MajorLee95/tinyelab/README.rst

++++++++++++++++++++++++++++++++++++++++++++++++++++++++++++++++++++++++++++++++++++++++++++++++++++
Tiny E-LAB
++++++++++++++++++++++++++++++++++++++++++++++++++++++++++++++++++++++++++++++++++++++++++++++++++++

:Auteur:               Le VoLab : MajorLee
:Site_Web:             http://www.vorobotics.com/
:Projet:               Tiny e-LAB my contrib.
:Version:              2022
:documentation:        https://majorlee95.github.io/tinyelab
:Licence:              CC0 4.0
:Liens:                https://creativecommons.org/licenses

Ce projet est ma contribution au `Projet Tiny e-lab de MarcLuer sur Thyngiverse`_

Pour plus d'informations suivre le liens documantation ci-dessus !!!!!

.. _`Projet Tiny e-lab de MarcLuer sur Thyngiverse`: https://www.thingiverse.com/thing:2999383
