MajorLee95/tinyelab/_01-docs/source/avancement.rst

++++++++++++++++++++++++++++++++++++++++++++++++++++++++++++++++++++++++++++++++++++++++++++++++++++
Avancement
++++++++++++++++++++++++++++++++++++++++++++++++++++++++++++++++++++++++++++++++++++++++++++++++++++

.. include:: volabid.rst

:Date de création: 03/2022
:Date dernière maj: voir github

====================================================================================================
Journal
====================================================================================================
09/03/24::

    Reprise module USB QC3.0 simple un USB un inter
    Déjà quelques chose dans ``mesCreations\moduleUSB5V2ASimple2voies``

.. _refAvancementGeneral:

====================================================================================================
A faire : de manière général
====================================================================================================
Ajouter des liens vers les sources
----------------------------------------------------------------------------------------------------
Dans la partie rendu Freecad mettre un lien vers les sources avec un peu d'explications comme les 
dépendances:

- modulePrimaireTensionCourant
- moduleAlimStabiliseeDPS3005
- moduleAlimentationParkSide
- moduleUSB3A2voies
- moduleOscilloDSO138
- moduleVentilo
- moduleTripleTinyVoltmetres
- moduleVoltAmperemetre

Mettre les modules sous Thinkiverse
----------------------------------------------------------------------------------------------------
- base 35mm
    - renseigner le lien dans la doc
- UI primaire
    - renseigner le lien dans la doc
- USB
    - renseigner le lien dans la doc
- DPS3005
    - renseigner le lien dans la doc
- Oscillo
    - renseigner le lien dans la doc
- VA
    - renseigner le lien dans la doc
- XT60 cover
    - renseigner le lien dans la doc

schéma de câblage des modules
----------------------------------------------------------------------------------------------------
    - Alim DPS3005

XT60 : boîtier ou capot de prise XT60
----------------------------------------------------------------------------------------------------
- dessin 3D avec vis pointeau **OK**
- rien de probant sur le net **OK**
- prévoir 2 guides fils **OK**
- imprimer femelle v006 paramétrée
    - tester

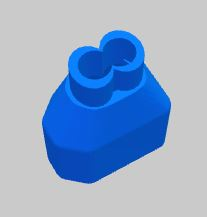
[picture p39: _01-docs/source/images/xt60caseGuides.jpg]


outillage switch
----------------------------------------------------------------------------------------------------
- documenter !

Concept du tiroir
----------------------------------------------------------------------------------------------------
- rangement sonde/fils
    -  principe du petit tiroir basculant ou pas **à conceptualiser**

====================================================================================================
A finir modules
====================================================================================================
- Ajout parkside et USB3A au chapitre modules terminés avec photos

Module oscilo
----------------------------------------------------------------------------------------------------
- photo **OK**
- schéma **OK**
- IR : images non retrouvées le 2/7/22, elles ne sont pas dans la caméra 16/7/22 **ABANDON**
- Design capo avec boutons **en cours 23/11/22**

Module voltmètre / ampèremètre 
----------------------------------------------------------------------------------------------------
- test électrique
     - à compléter en ampèremètre (peu précis dans les faibles courants)
- nomenclatures  **OK**
- photo **OK**

====================================================================================================
A faire modules
====================================================================================================
Support fer à souder
----------------------------------------------------------------------------------------------------
Tout est à faire

Des idées: `Tiny E-lab Ts100 alternate stand by erreib on Thingiverse`_

Trop volumineux, interrupteur inutile (le TS-100 à le sien)

Il faudrait une protetion complète de la panne !

.. _`Tiny E-lab Ts100 alternate stand by erreib on Thingiverse` : https://www.thingiverse.com/thing:5216290

Le module ventilation faire à souder
----------------------------------------------------------------------------------------------------
Simplifier le module (après retour d'expérience)

    - supprimer la charnière le ventilateur à la vertical suffit amplement.
    - supprimer les variateurs (éclairage à fond et ventilation à fond toujours...)
    - incliner l'éclairage vers l'avant (actuellmement, il éclaire les boutons)

USB double mais plus simple
----------------------------------------------------------------------------------------------------
- étude du concept sous Freecad **OK**
    - ``_03-cao_3D\mesCreations\moduleUSBsimpleDouble`` **OK**

- trouver un buck qui tienne la charge et les 24V ! **OK**

Peut-être trouvé chez aliExpres... oui et testé, y a plus qu'à !

Finalement, je pars sur un USB simple dans un premier temps pour mettre de chaque côté du module 
ventilo pour éclairer la soudure

Module USB-C fast charge
----------------------------------------------------------------------------------------------------
- tout est à faire

Module alim 24V/10A
----------------------------------------------------------------------------------------------------
- faire cable 220V
- faire cable XT60
- En profiter pour cable rallonge XT60 **OK**
    - avec gros fil dans le tiroir **OK**
- Ne vaut-il pas mieux un module complet à cause de l'arrivée 220V ? Si

.. WARNING:: Utilité de ce module ?
    :class: without-title

    Je me pose réellement la question de l'utilité de ce module à cause de son encombrement. 
    Le besoin d'une alimentation 24v n'est pas démontré.

module ampèremètre seul 0/3A
----------------------------------------------------------------------------------------------------
- trouver la bête **OK**
- commande AMAZON à aiguille **OK**
- Design 3D
    - trouver ou faire le modele
    - Tout

Module LCR mètre
----------------------------------------------------------------------------------------------------
- tout
- Est-ce que cel permet de tester les LED ? OUI
- LCR-T4 https://www.amazon.fr/gp/product/B0798JNLCJ/ref=sw_img_1?smid=A1NBUX8FDB1DWX&psc=1
- 

Module 3.3, 5 et +12-12, + alim variable low cost (regroupement)
----------------------------------------------------------------------------------------------------
Alim fixe avec les 3 alimentations principales
A faire avec fusible réarmables.
Discutabele pour le 5 et le 3.3v vu que les carte de breadboard l'on, ne reste plus que le +/-15V

- Module alim low cost : sur la base d'un DC/DC XL4605 avec poter multi-tours déporté

Quelle connectique ? Les connectique façon HP ne conviennent pas pour l'alim symétrique et risquent
de prendre pas mal de place.

Module Générateur de fonction
----------------------------------------------------------------------------------------------------
- appro
    - AD9833 breakout board AMAZON **OK**
    - Encodeur rotatif (au lab) cdé le 21/4 **OK**
    - NANO **OK**
    - Ecran I2C **OK**
    - Alimentation symétrique +10V/-10V cdé le 21/4 **OK**
    - Ampli op de sortie cdé le 21/4 **OK**
- Maquettage **OK**
- Design ARDUINO
    - original Instructables
        - DL code **OK**
        - Etude code **OK**
- refonte du code **DELAYED**
    - Trop de boulot peut-être pour une version ultérieure
- 3D retouche BNC emprunte v008 **OK**
- Design 3D
    - Tout

Voltmètre avec masse flottante
----------------------------------------------------------------------------------------------------
- tout
- Quoique en repartant de tiny voltmètre avec 3 DC/DC isolés

Module Horloge et musique
----------------------------------------------------------------------------------------------------
A faire.

Horloge ok mais musique ? quoi ?

Module batterie lidl ET prise PC multiples avec commute auto **UTILITE ?**
----------------------------------------------------------------------------------------------------
Tout est dans le titre

Étagère system
----------------------------------------------------------------------------------------------------
- tout

Dévidoir de fil
----------------------------------------------------------------------------------------------------
- tout
- Modéliser les bobines
    - diam 55mm, large 21mm, moyeu diam 25mm, Flan 1.5mm
    - 6 couleurs
    - AWG 24

6 couleurs

Module fer à souder
----------------------------------------------------------------------------------------------------
- tout : présente peu d'intérêt avec le fer TS100 un simple cable de bout de chaîne pourrait suffire !

Non à l'usage (cendrier) un vrai support serait mieux

Module renvoi d'angle
----------------------------------------------------------------------------------------------------
En accordéon réglable.

====================================================================================================
Fait (pour mémoire)
====================================================================================================

Mettre projet sous Volab/wiki et sous github
----------------------------------------------------------------------------------------------------
- créer git local **OK**
    - Arrêt du versionning par les noms de fichiers ou pas tout à fait **OK**
- créer projet github **OK**
- lier projet Github et git local (git ls-remote) **OK**
- pusher le projet **OK**

- créer github io **OK**
- pusher la doc sur githubio **OK**
- créer un readme.rst au niveau projet **OK**
- créer le projet dans le Wiki du lab **OK**
- Renseigner le projet dans le wiki du lab **OK**
- Créer une vignette projet dans le Wiki **OK**
- peut-être compléter la description **OK**

Appro 
----------------------------------------------------------------------------------------------------
- alim 24V/10A commandée AMAZON le 4/4/22 24€ **OK**
- approvisionner tige laiton 3mm voire 2.5mm **OK**

BASE reprise v007.3
----------------------------------------------------------------------------------------------------
- Reprendre le profile XT60 **OK**
    - vérifier les jeux -pas de jeu -ajout jeu vertical 0.5 **OK**
    - diminuer la largeur 8 vs 8.4 **OK**
    - augmenter la hauteur d'au moins 0.6 (affaissement des couches) xtJeu .6  **OK** 
- Etude solution câblage
    - longueur tige laiton à déterminer pour chaque largeur de module : Calculer **OK**
        - reprendre la longueur pour qu'elles aillent jusqu'au fond des broches des XT **OK**
        - Tester => retouche tige v007.3  **OK**
            - Tige 3mm ne rentre pas dans certaines XT60 !!!! **OK**
    - passer les fils : le pb ne se pose que pour le 35mm **ABANDONNE**
    - souder en extérieur **ABANDONNE**

BASE V008.1
----------------------------------------------------------------------------------------------------
Passage des vis FAV en M3x6 ald M3x10 v008.1 **OK**

BASE v012
----------------------------------------------------------------------------------------------------
- retirer un peu de matière de part et d'autre de la lèvre **OK**
    - A terminer v010 **OK**
- positionnement XT et insert de gauche auto en fonction de largeurmodule **OK** v12

module 2x USB 3A
----------------------------------------------------------------------------------------------------
- module 2x USB 3A **OK**
    - design FreeCAD rev 4 sur base 006.4  **OK**
    - export STL **OK**
    - préparation GCODE **OK**
        - Fav **OK**
        - Base **OK**
    - impression **OK**
        - Fav **OK**
        - Base **OK**
    - câblage Légèrement difficile **OK**
    - test attention à la polarité **OK**

module Ui
----------------------------------------------------------------------------------------------------
- module Ui
    - design FreeCAD v009 sur base 006.4 **OK**
    - export STL **OK**
    - préparation GCODE **OK**
        - Fav 4h40 **OK**
        - Base 8h12 **OK**
    - impression
        - Fav **OK**
        - Base **OK**
    - câblage très difficile  **OK**
    - test **OK**
    - reprendre alors avec la base 007.5 **OK**
    - reprendre la face avant pour le module écran élargir le trou **OK**
    - Tester ? **NON**

- ré-imprimer la nouvelle face avant v012 **ABORTED**
    - stl **OK**
    - g-code **OK**
    - imprimer **OK**
- tester mécaniquement **ECHEC et ABANDON**
- collage du module **OK**

Module alim DPS3005
----------------------------------------------------------------------------------------------------
- module Alimentation DPS3005 (30V 5A) **OK**
    - design FreeCAD **OK**
        - 3D du module DPS30005 **OK**
            - design **OK**
            - Vérifier dimensions **OK**
        - 3D embase banane **OK**
            - Récup GRABCAD **OK**
                - Vérifier dimensions **OK**
        - 3B connecteur audio **OK**
            - recup **OK**
            - vérifier dim **OK**
        - Reprendre avec la base v007.dernière **OK**
        - Finir la FAV **OK**
    - export STL **OK**
    - préparation GCODE **OK**
        - Fav **OK**
        - Base **OK**
    - impression
        - Fav **OK**
        - Base **OK**
    - câblage **OK**
    - test **OK**

- faire une jolie photo module seule en box photo **OK**
- l'intégrée dans la doc **OK**

Module oscilo
----------------------------------------------------------------------------------------------------
- module oscillo
    - design FreeCAD v003 sur base 006.4  **OK**
    - Reprendre la base v007.dernière  **OK**
    - ajouter BNC **OK**
        - code RS 680-7371 **OK**
    - ajouter module alimentation **OK**
        - modéliser module alimentation **OK**
        - Attention vis Nylon **OK**
    - test hors boîtier (caractériser l'alimentation) **OK**
    - export STL **OK**
    - préparation GCODE **OK**
        - Fav **OK**
        - Base 150mm **OK**
    - impression **OK**
        - Fav **OK**
        - Base **OK**
        - Test mécanique **KO**
            - reprendre l'emprunte de la BNC 3.85 vers 3.35 **OK**
            - aapliqué aussi à BNC_002 **OK**
    - câblage **OK**
    - régler le module DCDC **OK**
    - test électrique **OK**
    - module oscillo
        - ré-imprimer la FAV
            - re-stl **OK**
            - re-gcode **OK**
            - re-imprimer **OK**
        - tester montage mécanique BNC **OK**

Outillage pour la soudure des XT60
----------------------------------------------------------------------------------------------------
- design 3D **OK**
    - retoucher les dimension du reglet celui de 20CM large **OK**
- export STL **OK**
- préparation GCODE **OK**
- impression **OK**
- test **OK**
    - retoucher l'épaisseur du réglet dans la speadsheet v013 **OK**
    - Ajouter des pieds en haut pour basculer pendant la soudure v014 **OK**

- Ré-imprimer v2_014
    - sortir STL **OK**
    - préparer GCODE **OK**
- re-tester la nouvelle version **OK**

module triple tiny Voltmètre
----------------------------------------------------------------------------------------------------
- design 3D **OK**
    - model volmetre sur GRABCAD **KO**
        - mini-dc-voltmeter-1.snapshot.5.zip : entraxe incorecte **KO**
        - dc-0-30v-voltmeter-panel-mount-1.snapshot.3.zip **KO**
        - led-dc-digital-voltmeter-5v-display-green-1.snapshot.5 **OK**

- export STL **OK**
- préparation GCODE **OK**
   - Fav **OK**
   - Base 90mm **OK**
- impression **OK**
   - Fav **OK**
   - Base **OK**
   - teste mécanique **OK**
- câblage
    - couper barres laiton 73.62mm (vérifié le 24/4) **OK**

- test électrique+ réglage **OK**
- explications **OK**
- photo **OK**
- nomenclatures **OK**
- schéma **OK**

Module voltmère / ampéremètre 
----------------------------------------------------------------------------------------------------
- modélisation 3D **OK**
    - réutiliser connecteurs AUDIO **OK**
    - rechercher model 3D du module utilisé **OK**
        - vérifier les dimensions **OK**
            - en déduire taille trou **OK**
        - intégrer step dans un fichier Freecad avec spreadsheet **OK**
    - 4 fiches bananes **OK**
- Rechercher schéma de câblage version 3 gros fils, sérigraphié **OK**
    - rouge VI, verts I+,  Noir COM **OK**
    - finir svg de câblage **OK**

- export STL **OK**
- préparation GCODE **OK**
   - Fav **OK**
   - Base 95mm **OK**
- impression **OK**
   - Fav **OK**
   - Base **OK**
   - teste mécanique **OK**
- câblage **OK**
    - couper barres laiton 78.62mm **OK**

- test électrique
     - à compléter en ampèremètre (peu précis dans les faibles courants)
- nomenclatures 

- schéma **OK**
- photo **OK**
    - une incluse **OK**

outillage switch
----------------------------------------------------------------------------------------------------
- imprimer **OK**
    - gcode **OK**
- test méca **KO**
    - trop long, raccourcir de 1 mm, modif chanfrein 4x2 vers 5x1 v004
- ré-imprimer v0004
    - stl **OK**
    - gcode **OK**
    - imprimer **OK**
- re-tester **OK**

Module ventilation
----------------------------------------------------------------------------------------------------
- model ventilo **OK**
    - Vérifier les dimension **OK**

- design 3D **OK**
        - Essais avec les aimant en long **ABORTED**
            - nouvelle branche **aimantsEnLong**
            - dessiner **OK**		

    - Inclinateur à base de verrou élastique => version 029 **OK**
        - dessiner : nouvelle branche git : **ventiloSystemInclinaison**
            - sur le côté droit du module. **OK**
            - sur la partie fixe une languette en arc de cercle de 1 mm d'épaisseur **OK**
            - languette rapporté pour simplifier l'impression **OK**
            - sur la partie mobile : des crans (trous cylindriques) **OK**
            - impression languette, poignee **OK**
                - stl, gcode **OK**
                - impression **OK**
            - impression partie fixe tronquee **OK**
                - export step, tronquage, export stl, gcode **OK**
                - impression **OK**
            - impression partie fixe tronquee **OK**
                - export step, tronquage, export stl, gcode **OK**
                - impression **OK**
            - test **A REVOIR**
                - ménager un jeu d'épaisseur d'environ 1mm dans 
                  la partie plane de la partie fixe plutot mobile à cause de l'emprunte languette **OK**
                - finir design partie fixe potar avec inter, **OK**
                    - récupérer potar  avec inter (encombrement)  le switch n'est pas cliquable **ABANDON**
                        - sous Grabcad **OK**
                        - Vérifier dimensions **ABANDON**
                        - appro (amazon) **OK**
                - trous passage des fils ventilo et casquette **OK**
                    - fixe **OK**
                    - mobile **OK**
                - trous switch désépaissir **OK**
                - pb casquette paroi LED comment on vis ? des gros trous pour les tête de vis **OK**

    - fixation du Digispark un cube et de la colle **OK**
        - model sous Grabcad ? **OK**
        - conversion vers Freecad **OK**
        - intégration **OK**
            - design support **OK**
    - design support DCDC et testé **OK**

    - procéder alors à une impression complète **OK**
        - partie fixe **OK**
            - export stl, gcode **OK**
            - impression **OK**
        - partie mobile **OK**
            - export stl, gcode **OK**
            - impression **OK**
        - casquette **OK**
            - export stl, gcode **OK**
            - impression **OK**
    - réduire le jeu longitudinal de la charnière actuel mesuré 1.88mm **OK**
    - reprendre au propre **OK**
        - trou passage du fil LED (faire un trou carré au rectangle) **OK**
        - suppression 1mm base partie mobile. **OK**
        - reprendre le modèle potar avec inter **ABANDON**
        - faire trous pour potar et inter **OK**
            - vérifier la designation des petits inter **OK**
                - plus le sachet **OK**
                - sur le site amazon : il y a effectivement erreur sur le produit **OK** 
                - dessus : KCD1-11 (quand on cherche sur AMAZON on tombe sur les bonnes dimensions) **OK**
        - paroi casquette led : ep 1mm hauteur 18mm **OK**
        - ne pas oublier le trous des fils ventilo/led dans la partie fixe **OK**

- Électronique **OK**
    - Pilotage ventilo et LED : LM2596S limité à 12V cf :ref:`pilotage LEDs et ventilo<pilotageLedVentilo>`
        - Test réalisé **OK** 
        - implémenter les 2 voies LED et ventilo **OK**
        - vérifier le numéro du canal pwm pas de diff, analogRead **OK**
        - programmer le composant **OK**
        - Tester les 2 voies **OK**

- imprimer base **OK**
    - exports, prepa **OK**
    - impression **OK**
- imprimer fav **OK**
    - exports, prepa **OK**
    - impression **OK**

- casquette : ajouter trous cables LED **OK** v0.35

- câbler
    - faire plaque à LED **OK**
    - Programmer Digispark **OK**
    
- tester **OK**

- nomenclature **OK**
- saisir schéma de câblage **Ok**

Module primaire prises PC multiples **aborted**
----------------------------------------------------------------------------------------------------
- recherche des standard de prises **OK**
- appro des embase correspondantes **OK**
- test des embase en question avant design

- Design du module

Module batterie Lidl
----------------------------------------------------------------------------------------------------
- Modéliser le haut de la batterie pas vraiment utile **OK**
- modéliser le module **OK**
- stl, gcode FAV et base et adaptateur **OK**
- imprimer **OK**
    - adapt **OK**
    - fav **OK**
    - base **OK**
- câbler **OK**
- tester **OK**
- voir la version avec inter et porte fuse : est-elle utile ? **A voir beaucoup plus tard**
- documenter **OK**
    - photo **OK**
    - screenshot (rendu Freecad) **OK**
    - nomenclature **OK**

module USB 2x 3A Refait
----------------------------------------------------------------------------------------------------
- trouver un convertisseur qui tienne 24V **ET** 3A **OK**
    - le tester avant de l'intégrer **OK**
    - `TECNOIOT 5pcs 5A XL4015 DC-DC Step Down Adjustable Power Supply Module LED Lithium Charger`_
    - également : `TECNOIOT 5pcs 5A Max XL4015 DC to DC CC CV Step-Down`_ avec limiteur de courant
        - évaluer
        - rentre difficilement (par de trous de fixation)
  
Full doc: `DC to DC Converter with Constant Current (CC) and Constant Voltage (CV) Control - Schematics, PCB, Parts List, and Working`_
        
- attention le ventilo ne passe pas ! SI **OK**           

- alimentation ventilateur et ARDUINO **OK**
    - design et maquettage **OK**
    - saisir schéma KiCAD **OK**
    - récupérer un potentiomètre multi tours 10k ou un simple de pcb, j'en ai plein ! **OK**
- pcb support arduino, INA, OLED et alim
    - plaquette à trou découper **OK**
    - câbler **OK**
    - tester avant intégration
    - prévoir trous de fixation **OK**
    - Prévoir dissipateur 7805 **OK**

- ampèremètre **OK**
    - en trouver un petit **KO**
    - ou le faire
        - définir l'électronique INA219 **OK**
        - maquetter **OK**
        - tester **OK**
        - intégrer **OK**

- design3D
    - modèles 3D
        - Vérifier les dimensions et au passage préparer la spreadsheet **OK**
            - XL4015, modèle retouché **OK**
            - ventilo 40mm **OK**
            - connectique USB **OK**
            - INA219 **OK**
    - éprouver emprunte DC/DC **OK**
    - trous de fixation du pcb **OK**
    - faire une découpe broche oled dans la fav **OK**
    - prévoir 7805 dans le flux d'air du ventilateur **OK**
    - design cale OLED **OK**
    - Éprouver les perçages **OK**
        - Connecteurs USB **OK**
        - pcb **OK**
        - oled **OK**
    - Fav **OK**
        - trous switch **OK**
        - trous usb **OK**
        - trous écran **OK**
        - trous de ventilation dans la FAV **OK**
        - trous pcb **OK**
    - refaire les trous de ventilation dans la base dans Freecad

- préparer INA2 : changer adresse I2C **OK**
- coller et cabler les potar **OK**

- Préparer le convertiseur 2 **OK**
    - déssouder le potar **OK**
    - couper le dissipateur **OK**
    - coller les 2 moitiés de dissipateur **OK**

- imprimer **OK**
    - STL, GCODE **OK**
        - fav **OK**
        - base **OK**
    - tige laiton, couper **OK**
- câbler : cablage provisoire pour essais **OK**
- tester **OK**
- câblage définitif

- une petite face avant

.. _`TECNOIOT 5pcs 5A XL4015 DC-DC Step Down Adjustable Power Supply Module LED Lithium Charger` : https://www.amazon.fr/gp/product/B07XXFZFQJ/ref=ppx_yo_dt_b_asin_title_o04_s00?ie=UTF8&psc=1

.. _`TECNOIOT 5pcs 5A Max XL4015 DC to DC CC CV Step-Down` : https://www.amazon.fr/gp/product/B084BVKGDK/ref=ppx_yo_dt_b_asin_image_o00_s00?ie=UTF8&psc=1 

.. _`DC to DC Converter with Constant Current (CC) and Constant Voltage (CV) Control - Schematics, PCB, Parts List, and Working` : https://circuitdigest.com/electronic-circuits/diy-xl4015-dc-dc-buck-converter-module

- design3D **OK**
    - refaire les trous de ventilation dans la base dans Freecad

- une petite face avant **OK**

- nomenclature **OK**
- schéma **OK**
    - de la carte : à intégrer dans la doc **OK**
    - de câblage **OK**

- Le code ! **OK**

- la face avant **OK**

====================================================================================================
Weblinks
====================================================================================================

.. target-notes::
