MajorLee95/tinyelab/_01-docs/source/moduleAlimentationParkSide.rst

++++++++++++++++++++++++++++++++++++++++++++++++++++++++++++++++++++++++++++++++++++++++++++++++++++
Module alimentation primaire à base de batterie PARKSIDE de chez LIDL
++++++++++++++++++++++++++++++++++++++++++++++++++++++++++++++++++++++++++++++++++++++++++++++++++++

.. include:: volabid.rst

:Date de création: 10/2022
:Date dernière maj: 10/2022

.. |clearer|  raw:: html

.. index::
    pair: Modules; PARKSIDE

====================================================================================================
Les languettes
====================================================================================================
Toutes la difficulté dans cette exercice est de trouver des languettes métalliques compatibles.

Piste : Radiosspares : Feuille de métal 500mm x 300mm x 0.6mm 682-488 188€ les 10 feuilles !

====================================================================================================
Module Parkside X20
====================================================================================================
Recherche de model internet : pas grand chose d'exploitable, surtout des stl !

Mieux vaut tout re-modéliser ça n'a pas l'air très compliqué si on s'inspire du chargeur !

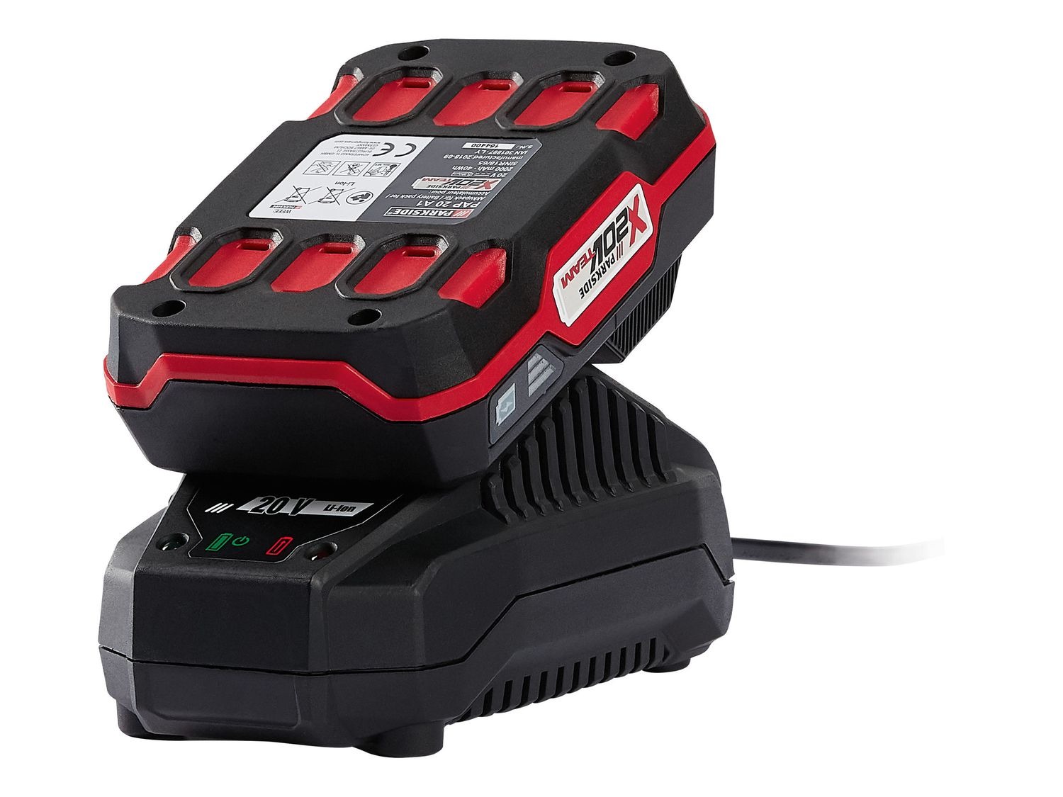
[picture p40: _01-docs/source/images/parkSideBatterieEtChargeur.jpg]


====================================================================================================
Un peu d'électronique
====================================================================================================
Le composant principal est un LGT8P30 : pas trouvé la datsheet. Et un LGT8P22 côté chargeur.

Le design a l'air très sain.







.. list-table::
   :widths: 27 27 27
   :header-rows: 1

   * - Pack vue d'ensemble
     - Un élément 2000mHA 3.6V
     - le contrôleur LGT8P30

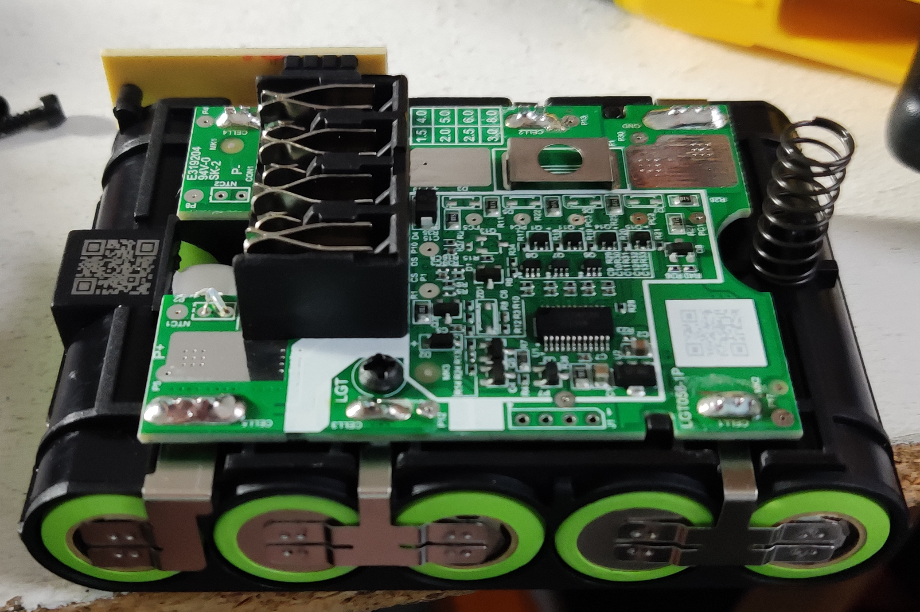
[picture p41: _01-docs/source/images/parkside/parksideInside001.jpg]
   * - 
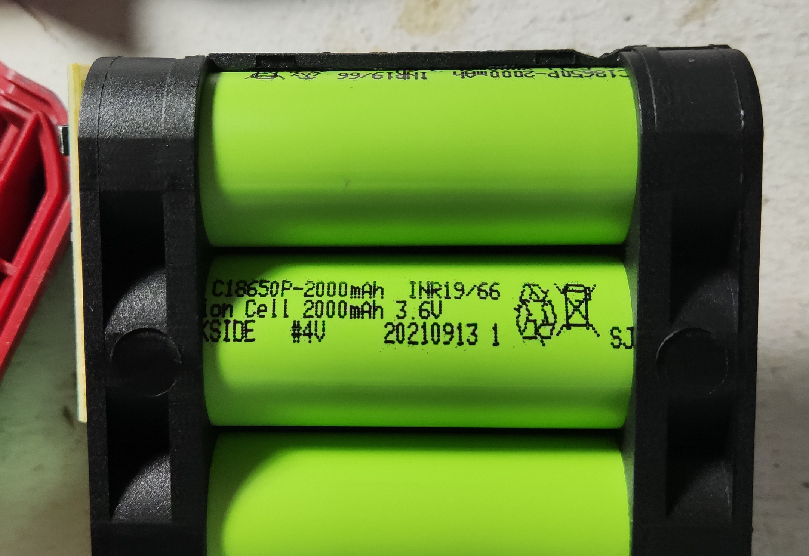
[picture p42: _01-docs/source/images/parkside/parksideInside002.jpg]
     - 
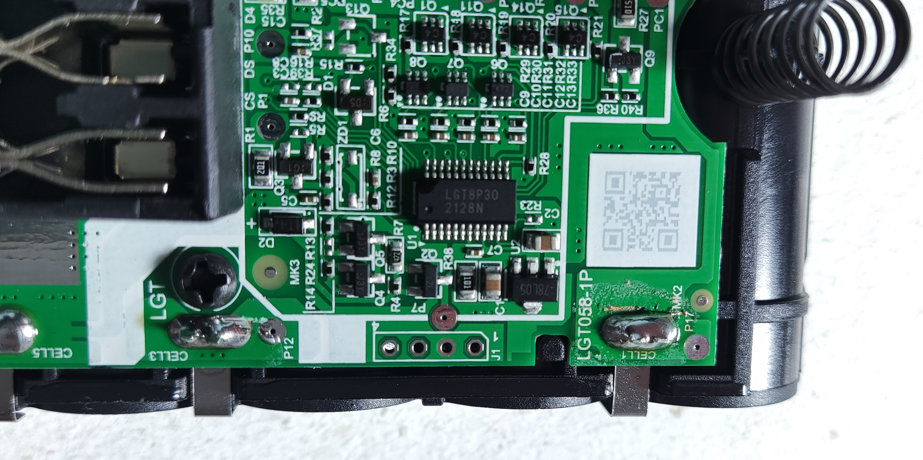
[picture p43: _01-docs/source/images/parkside/parksideInside003.jpg]
     - 

Les 5 éléments sont montés en série soir 5x3.6V = 18V de tension nominale... Pas 20V.

|clearer|





.. list-table::
   :widths: 27 27
   :header-rows: 1

   * - Chargeur côté "composant"
     - Chargeur côté "soudure" lol

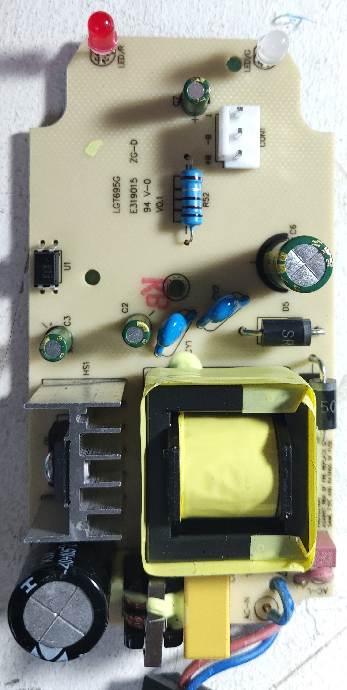
[picture p44: _01-docs/source/images/parkside/parksideInside004.jpg]
   * - 
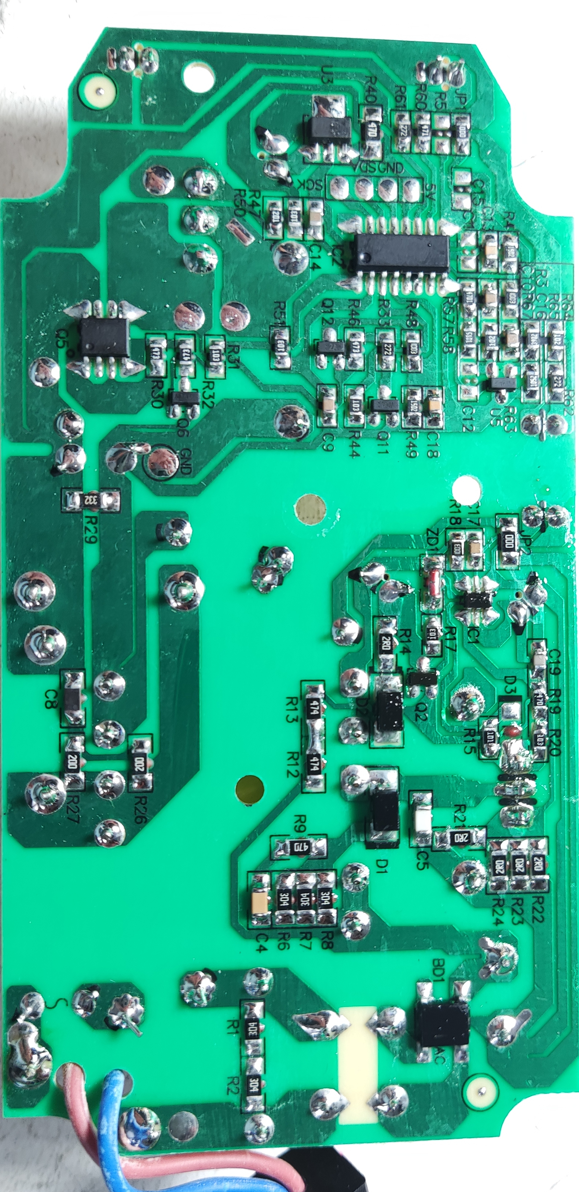
[picture p45: _01-docs/source/images/parkside/parksideInside005.jpg]
     - 

====================================================================================================
Rendu Frecad
====================================================================================================

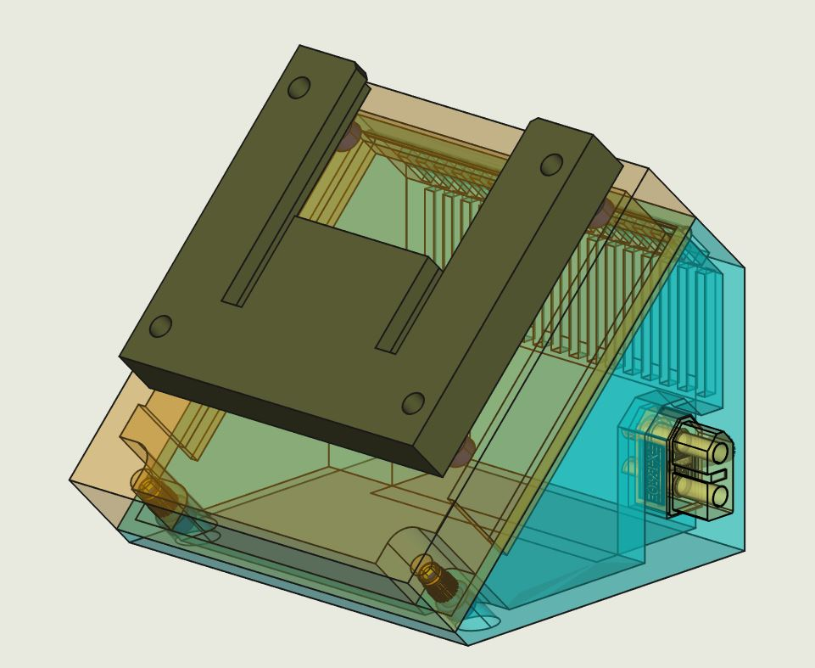
[picture p46: _01-docs/source/images/moduleParkSideFreecad.JPG]


====================================================================================================
Le câblage
====================================================================================================
Rien de très compliqué pour cette partie puisque 2 fils **souple** de forte section suffisent.

Les languettes de connecxion sont réalisées en mailleshort de 0.3mm d'épaisseur plié.









.. list-table::
   :widths: 27 27 27 27
   :header-rows: 1

   * - Essais du pack et de languettes
     - Câblage des languettes
     - Pistocolle pour solidifier le tout
     - Passage des cables

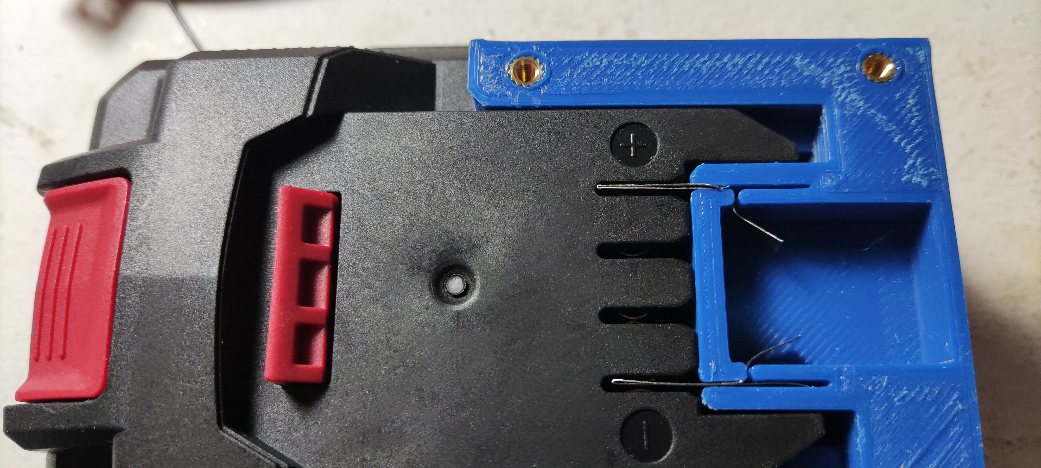
[picture p47: _01-docs/source/images/parkside/parksideInside006.jpg]
   * - 
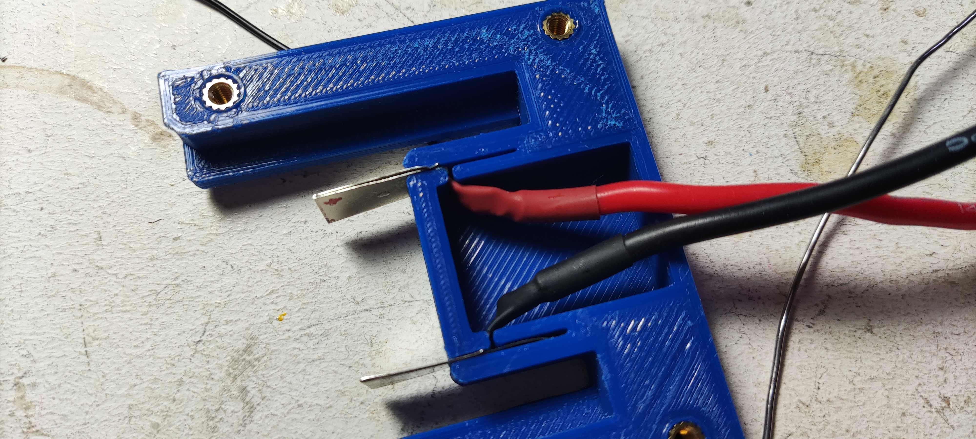
[picture p48: _01-docs/source/images/parkside/parksideInside007.jpg]
     - 
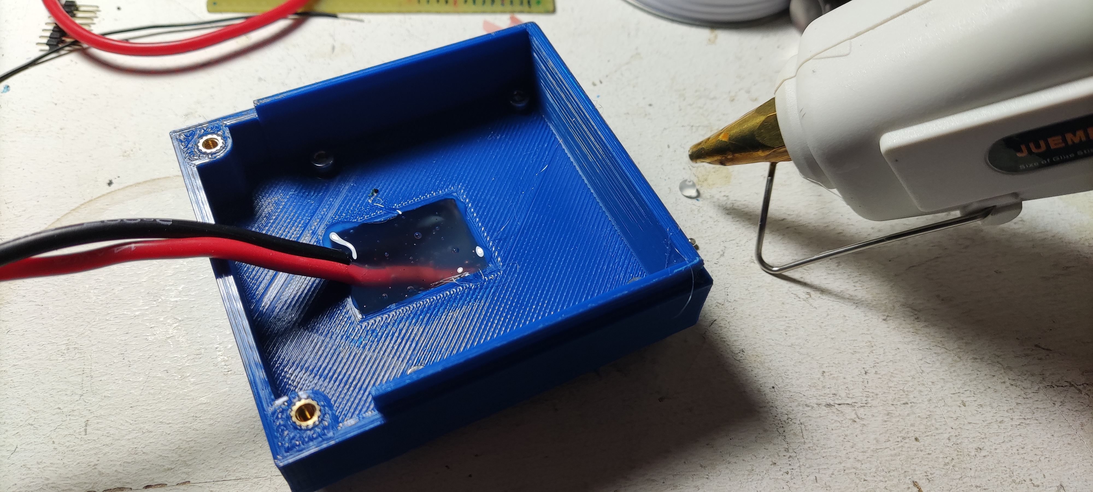
[picture p49: _01-docs/source/images/parkside/parksideInside008.jpg]
     - 
     - 

.. NOTE:: le côté gauche du boîtier n'est pas équipé du XT60 femelle.
   :class: without-title

Source mailleshort : `Plaque de maillechort format 280x200x0,40mm chez micromodel`_

56.000mm2 à 24€ soit 0.042cts le mm2 il en faut environ 8*25mm 200m2 8.4cts et biensûr x2 pour le 2 
languettes.

J'ai choisi ce matériaux pour son aspect, sa maléabilité et sa sodabilité.

Source fil de câblage : sur `AMAZON Fil de silicone de calibre 14, 5 mètres`_ pour environ 0.3€

.. _`AMAZON Fil de silicone de calibre 14, 5 mètres` : https://www.amazon.fr/gp/product/B074QR9DT9/ref=ppx_yo_dt_b_asin_title_o05_s01?ie=UTF8&psc=1

.. _`Plaque de maillechort format 280x200x0,40mm chez micromodel` : https://micro-modele.fr/fr/plaques-en-maillechort/5167-plaque-de-maillechort-format-200x100x050mm.html

====================================================================================================
En situation
====================================================================================================
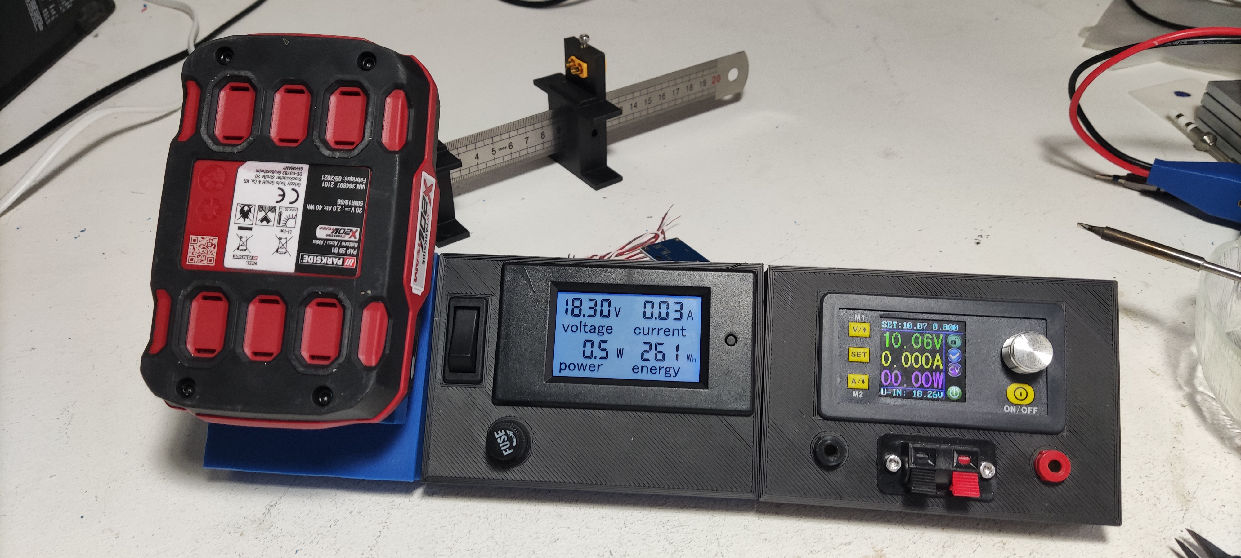
[picture p50: _01-docs/source/images/parkside/packParksideEnsituation.jpg]


====================================================================================================
Nomenclature
====================================================================================================
.. csv-table:: Nomenclature module Parkside
   :file: ../../_02-realisation/_03-cao_3D/mesCreations/lidlParckSideBat/nomParkside.csv
   :delim: ,
   :encoding: UTF-8
   :align: left

Mise à part la batterie et son chargeur 20 à 25€.

====================================================================================================
Weblinks
====================================================================================================

.. target-notes::
