MajorLee95/tinyelab/_01-docs/source/moduleOscilloDSO138.rst

++++++++++++++++++++++++++++++++++++++++++++++++++++++++++++++++++++++++++++++++++++++++++++++++++++
Module oscilloscope DSO138
++++++++++++++++++++++++++++++++++++++++++++++++++++++++++++++++++++++++++++++++++++++++++++++++++++

.. include:: volabid.rst

:Date de création: 10/2022
:Date dernière maj: 10/2022

.. _refOscilloRealisation:

.. index::
    pair: Modules; Oscilloscope

====================================================================================================
Présentation
====================================================================================================
.. WARNING:: REGLER LA TENSION DE SORTIE DU DCDC à 9V sinon ça chauffe
   :class: without-title

   ici 9V

.. _`NOUVEAU JYETech® 13805K DSO138 Mini Oscilloscope Numérique 200KHz` : https://www.banggood.com/fr/NEW-JYETech-13805K-DSO138-Mini-200KHz-Digital-Oscilloscope-SMD-Soldered-Version-DC3_5V-6V-With-Housing-p-1627586.html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

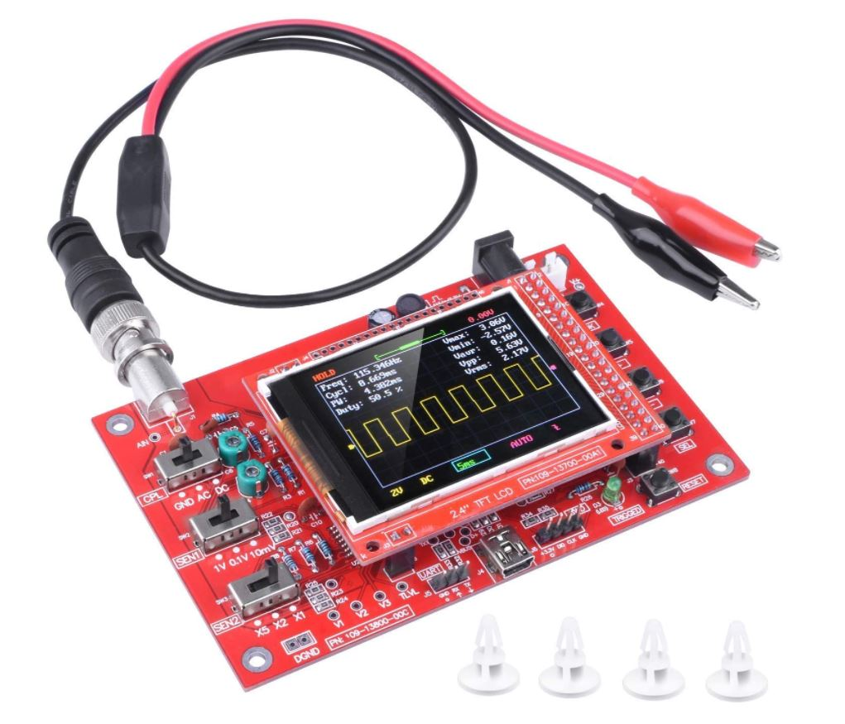
[picture p51: _01-docs/source/images/oscilloAmazon.jpg]


Sur AMAZON `ARCELI Oscilloscope numérique au Format de Poche, kit Open Source TFT 2,4 Pouces avec sonde, Version assemblée (soudé)`_ à 27€

.. _`ARCELI Oscilloscope numérique au Format de Poche, kit Open Source TFT 2,4 Pouces avec sonde, Version assemblée (soudé)` : https://www.amazon.fr/gp/product/B07V67LYXF/ref=ppx_yo_dt_b_asin_title_o01_s00?ie=UTF8&psc=1

Attention plusieurs versions différentes même sur le site JYE Tech

`NOUVEAU JYETech® 13805K DSO138 Mini Oscilloscope Numérique 200KHz`_ chez BANGGOOD (vue assemblée)

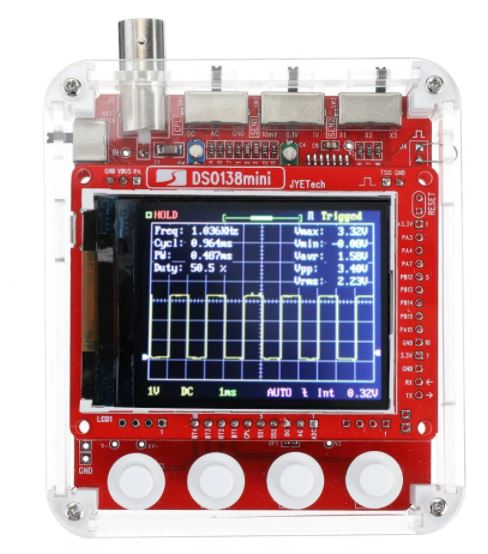
[picture p52: _01-docs/source/images/dso138mini.jpg]


Dimension: 85mm X 75mm X 15mm

La version la plus stable serait la `JYE Tech DSO138mini`_ plus compact et aussi plus cher. 
Pas trouvé assemblée sur AMAZON

.. _`JYE Tech DSO138mini` : https://jyetech.com/dso138mini-oscilloscope-diy-kit/

BNC : code RS :  680-7371, modèle directement récupérer et mis en fichier Freecad.

:download:`Drawing<fichiersJoints/bnc_drawing_0900766b80d9b202.pdf>`

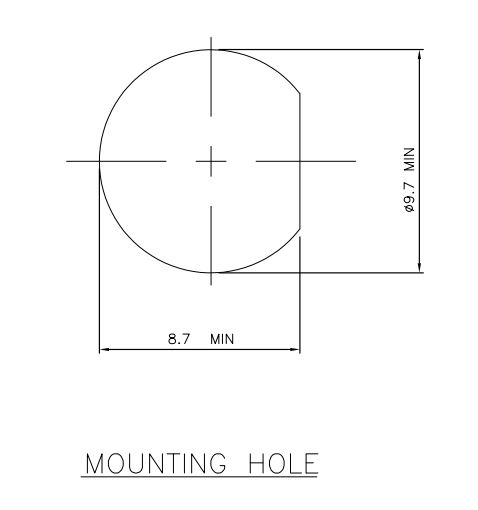
[picture p53: _01-docs/source/images/bncMountingHole.jpg]


.. WARNING:: REGLER LA TENSION DE SORTIE DU DCDC à 9V sinon ça chauffe
   :class: without-title

   Ici 9V cf. :ref:`Alimentation des modules en plus base tension<refConvertisseurDCDC>`

====================================================================================================
Oscillo schéma de câblage
====================================================================================================



====================================================================================================
Rendu FreeCad
====================================================================================================
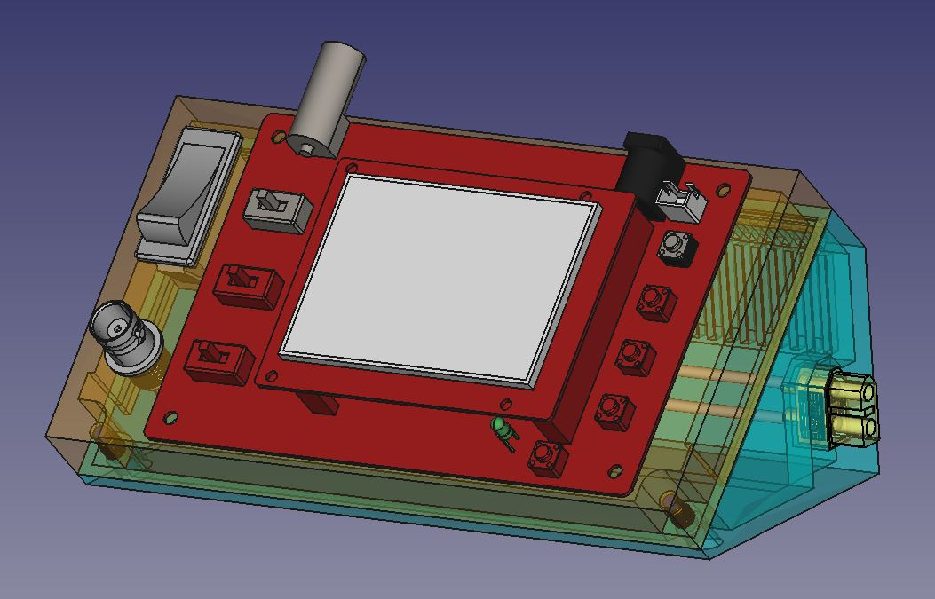
[picture p54: _01-docs/source/images/oscillo.jpg]


====================================================================================================
Oscilloscope en situation
====================================================================================================

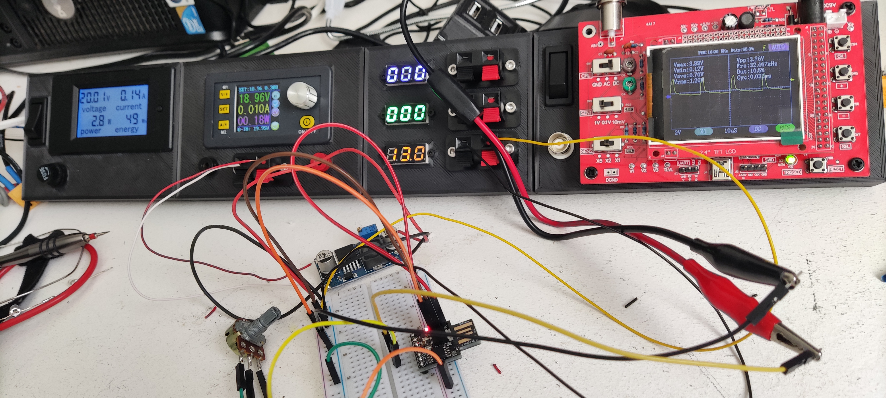
[picture p55: _01-docs/source/images/oscilloEnSituation.jpg]


Test du PWM pour le module Ventilo

====================================================================================================
Nomenclature oscillo DSO138
====================================================================================================
.. csv-table:: Nomenclature oscilloscope DSO138
   :file: ../../_02-realisation/_03-cao_3D/mesCreations/moduleOscillo/nomOscillo.csv
   :delim: ,
   :encoding: UTF-8
   :align: left
   :header-rows: 1

====================================================================================================
Weblinks
====================================================================================================

.. target-notes::
