MajorLee95/tinyelab/_01-docs/source/moduleUSB3A2voies.rst

++++++++++++++++++++++++++++++++++++++++++++++++++++++++++++++++++++++++++++++++++++++++++++++++++++
Module USB 2x 5A avec ampèremètre
++++++++++++++++++++++++++++++++++++++++++++++++++++++++++++++++++++++++++++++++++++++++++++++++++++
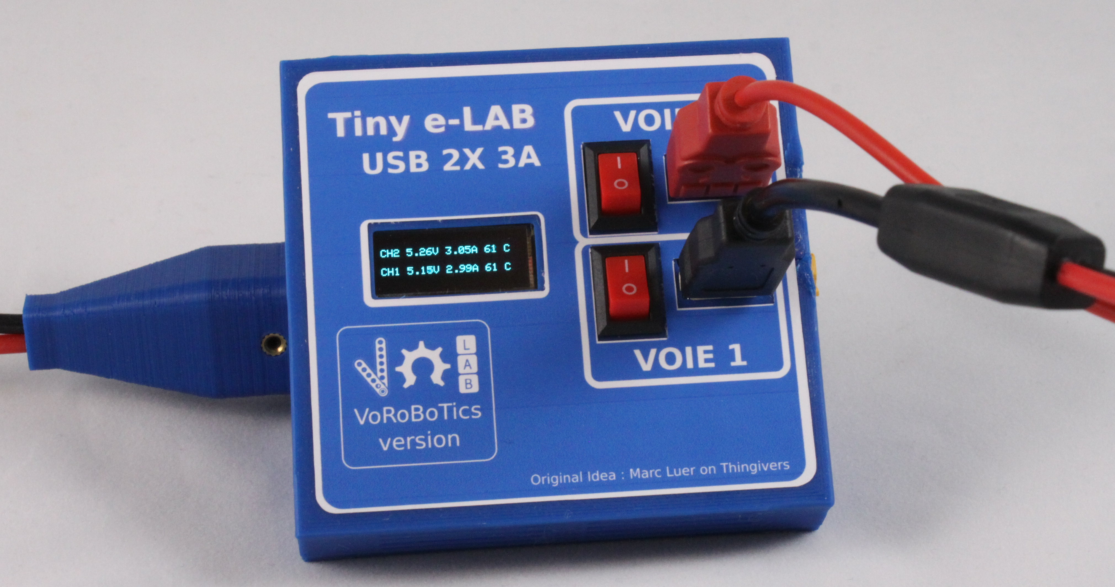
[picture p65: _01-docs/source/images/usb2x3a/moduleUSB2x3AComplet.jpg]


.. include:: volabid.rst

:Date de création: 10/2022
:Date dernière maj: 10/2022

.. |clearer|  raw:: html

====================================================================================================
Présentation/objectif
====================================================================================================
On souhaite ici un module avec 2 prise USB capable de délivrer chacune 3A pour éventuellement 
alimenter 2 Raspberry pi avec un écran qui affiche tension courant pour chaque voie.

====================================================================================================
Module XL4015 évaluation à 3A
====================================================================================================

La base est le convertisseur DCDC XL4015

`TECNOIOT 5pcs 5A XL4015 DC-DC Step Down Adjustable Power Supply Module LED Lithium Charger`_
    
.. _`TECNOIOT 5pcs 5A XL4015 DC-DC Step Down Adjustable Power Supply Module LED Lithium Charger` : https://www.amazon.fr/gp/product/B07XXFZFQJ/ref=ppx_yo_dt_b_asin_title_o04_s00?ie=UTF8&psc=1

En testant ce module en charge (avec une charge active) à 5V 3A, on s’aperçoit que ce n'est pas 
régulateur qui chauffe mais la diode et la self comme le montre les images infra-rouge.





.. list-table::
   :widths: 27 27 
   :header-rows: 1

   * - Image IR
     - Image réelle

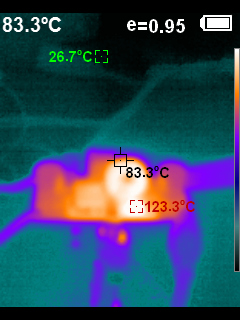
[picture p66: _01-docs/source/images/XL4015IR.jpg]
   * - 
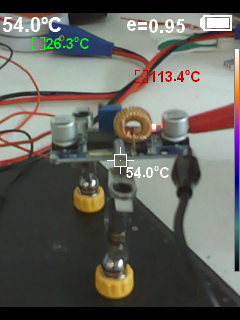
[picture p67: _01-docs/source/images/XL4015TestImageReelle.jpg]
     - 

Ces images ont été réalisées avec la `caméra infra-rouge Hti-Xintai HT18`_ sur l'image réelle la 
parallaxe des 2 objectifs fait que les température ne sont  pas aux bons endroits. C'est l'image IR
qui compte

.. _`caméra infra-rouge Hti-Xintai HT18` : https://www.amazon.fr/gp/product/B07BDJZ845/ref=ppx_yo_dt_b_asin_title_o06_s00?ie=UTF8&psc=1

Lorsque le module délivre 5V / 3A la température de la diode se situe aux environs de 120°C. C'est 
beaucoup

====================================================================================================
Design du module
====================================================================================================
Compte tenu de l'essai ci-dessus je décide d'incorporer un ventilateur de 40mm au module.

Je décide également de mettre 2 voies 5V/3A donc d'utiliser 2 convertisseurs.

De plus étant donné que cela doit pouvoir servir à alimenter un raspberry pi, il serait bien de 
disposer d'une lecture du courant. Je n'est rien trouvé de suffisamment petit.

J'envisage de réaliser le double ampèremètre grâce à:

- 2 modules INA219
- 1 ARDUINO NANO
- 1 écran `OLED I2C monocrome de 0.91" 128 x 32`_

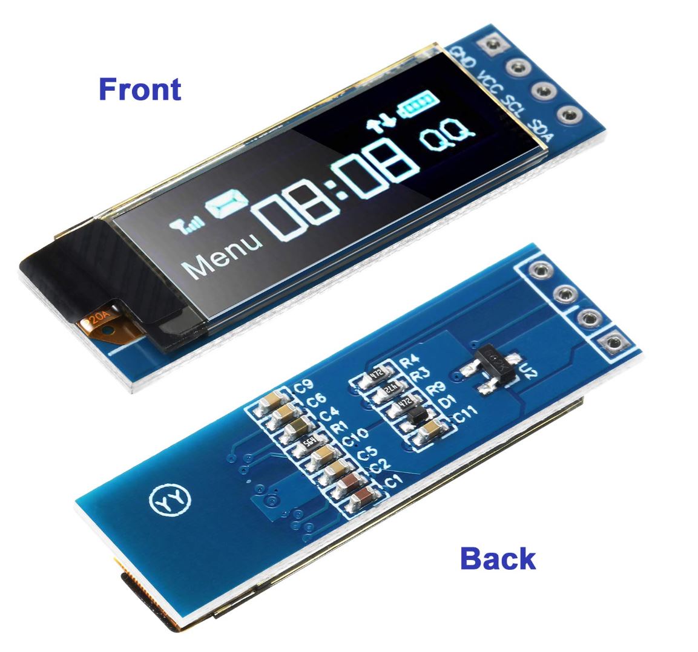
[picture p68: _01-docs/source/images/oled128x32.jpg]


.. _`OLED I2C monocrome de 0.91" 128 x 32` : https://www.amazon.fr/gp/product/B08CDN5PSJ/ref=ppx_yo_dt_b_asin_title_o01_s00?ie=UTF8&psc=1

Toutefois à 3A la chute de tension provoqué par le module INA219 et son shunt de 0.1 ohm risque 
d'être non négligeable : 0.3V. Il est possible de compenser cela en dessoudant le potar de feedback 
et en le plaçant après le shunt.

.. WARNING::

   Nouveau pb : 
   
   alimentation ventilo: en 24V, il fait énormément de bruit, je ne suis pas certain que 
   ce soit un ventilo 24V. 
   
   Il tourne bien en 5V mais le débit d'air semble un peu faible. 8, 9V
   semble un bon compromis. Sauf que je n'ai pas d'alim à cette valeur dans le module.

Conso ventilo : 24mA en 12V ventilo 1 (avec étiquette 24V), 49mA en 12V ventilo 2 origine ?

Solutions:

- un autre DC/DC XL4015 : pas la place et un peu riche pour un ventilo
- du PWM depuis l'ARDUINO : maîtrise de la vitesse et possibilité de régul en fonction de T°c
      - Echec: le ventilateur siffle (même à 32kHz en PWM) et la plage de réglage et très courte
- Mettre un simple régulateur : Lm1084 ou 7805

7805 pour alimenter l'arduino.

Conso : environ 50mA (mesuré à 25) soit à dissiper 24-5 = 19V P=UxI = 19x0.05 = 0.95W

En parcourant la datasheet du 7805, je suis tombé sur cette figure:

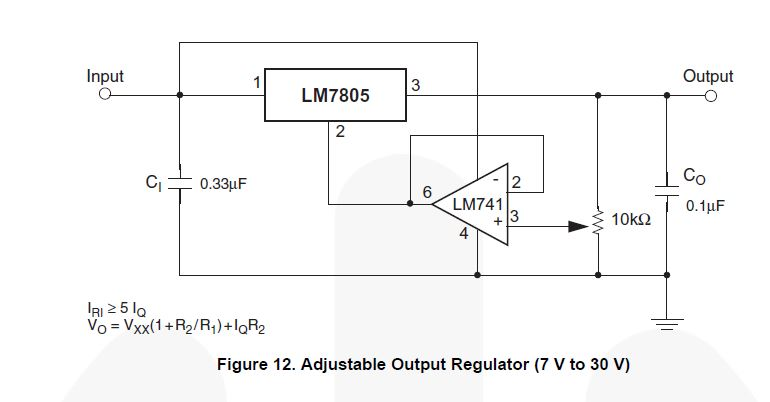
[picture p69: _01-docs/source/images/7805_high_output.JPG]


Il est donc possible à partir du 7805 de faire du 9V qui pourrait servir à alimenter le ventilo ET 
l'ARDUINO sur son  Vin.

Prise USB utilisées
----------------------------------------------------------------------------------------------------
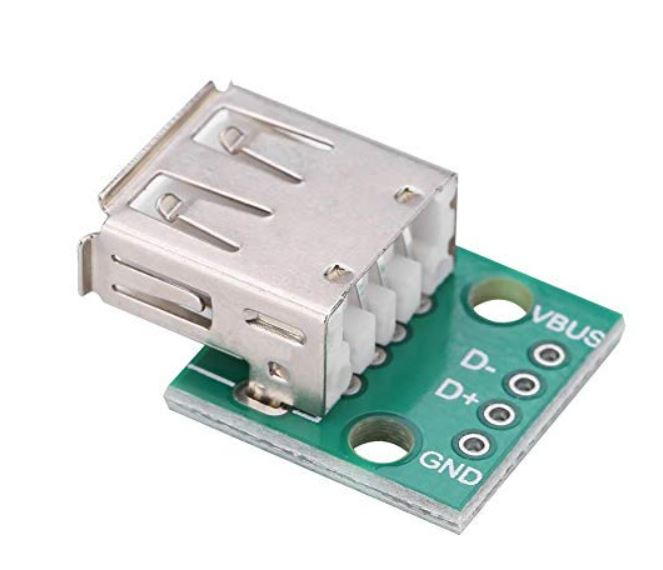
[picture p70: _01-docs/source/images/usbBreakOutBoard.jpg]


Les adresses sur le bus I2C
----------------------------------------------------------------------------------------------------
I2C scan : 0x3C, 0x40 et 0x41 (écran, INA1, INA2)

====================================================================================================
Schémas électroniques
====================================================================================================
De la carte (sans les LM35)
----------------------------------------------------------------------------------------------------

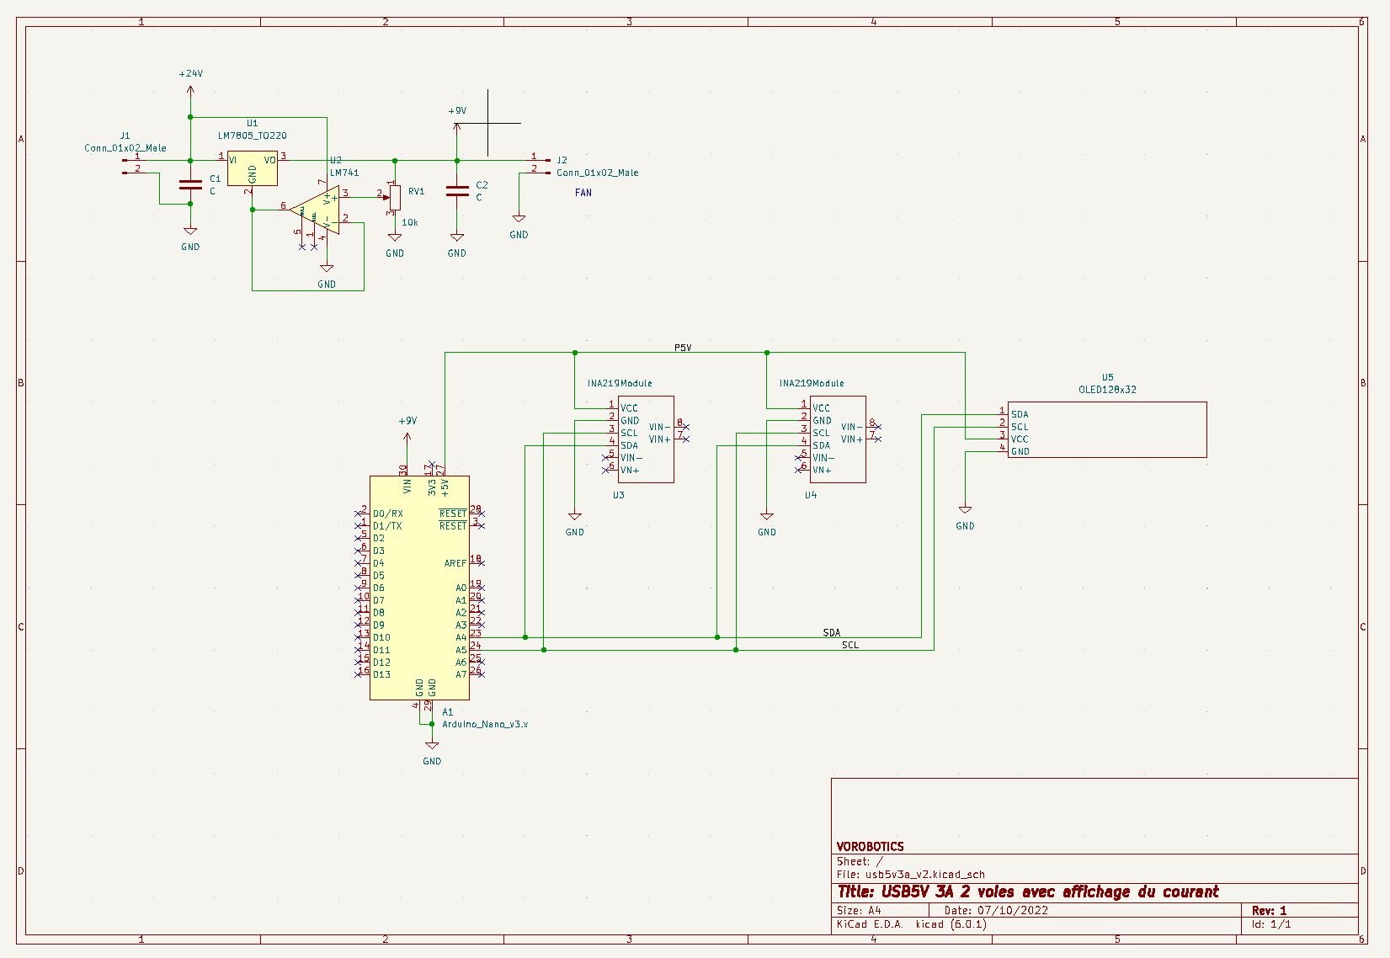
[picture p71: _01-docs/source/images/usb5V3AOledSch.jpg]


Les LM35 ont été ajoutés après coup en fil volant.

**Pseudo PCB KiCAD**

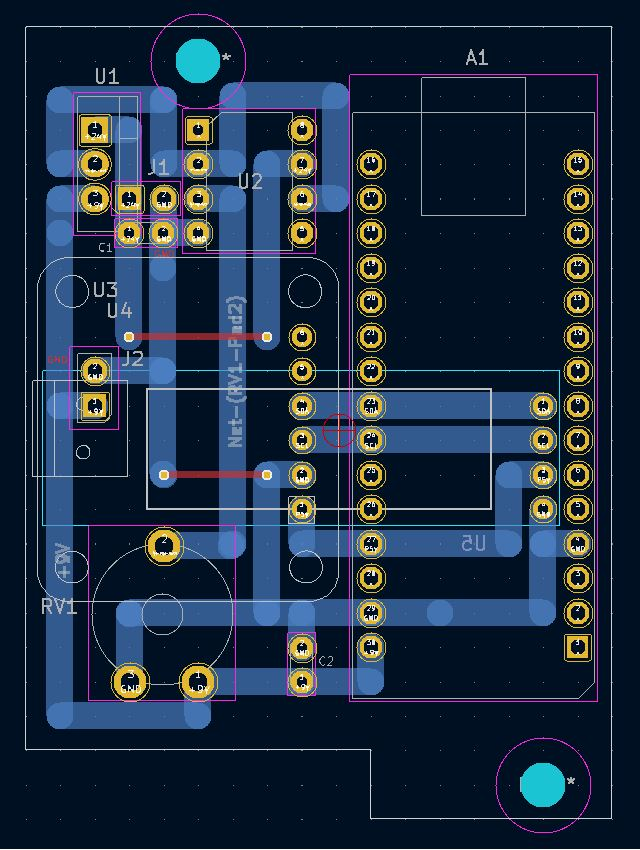
[picture p72: _01-docs/source/images/usb2x3a_pseudoPCB.jpg]


Pseudo pcb car réalisé sur de la plaque à trous à pastille carrées Veroboard.

Schéma de câblage
----------------------------------------------------------------------------------------------------


|clearer|



====================================================================================================
Mesure de température (LM35)
====================================================================================================
Ajout de dernière minute.

Comment : l'arduino à des entrée analogique dispo.

Qu'est ce que j'ai ?

- LM35 :download:`datasheet<fichiersJoints/lm35dts.pdf>`

J'ai câblé 2 de ces capteur sur les entrées analogique A0 et A1





.. list-table::
   :widths: 27 27 
   :header-rows: 1

   * - Câblage LM35 sous l'ARDUINO
     - Câblage LM35 collés au dissipateurs

   * - 
     - 

Les 2 capteurs sont collés aux dissipateurs grâce à de la colle thermique 
(pas de la pate mais bien de la colle ! ).

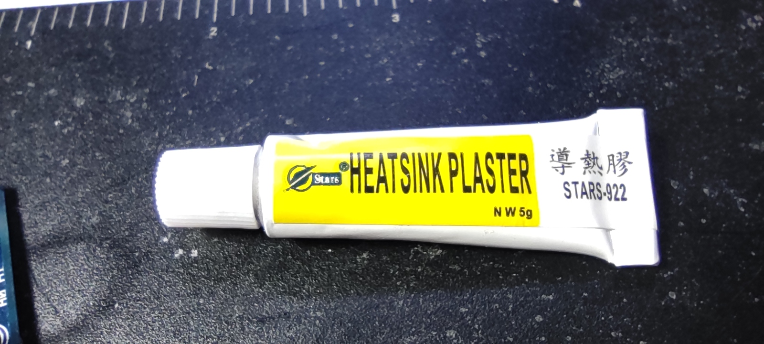
[picture p73: _01-docs/source/images/colleThermique.jpg]


====================================================================================================
Quelques photos de la réalisation
====================================================================================================











.. list-table::
   :widths: 20 20 20 20 20
   :header-rows: 1

   * - Maquette
     - XL4015 en charge
     - INA219 + trimer
     - Carte en cours
     - Carte verso

   * - 
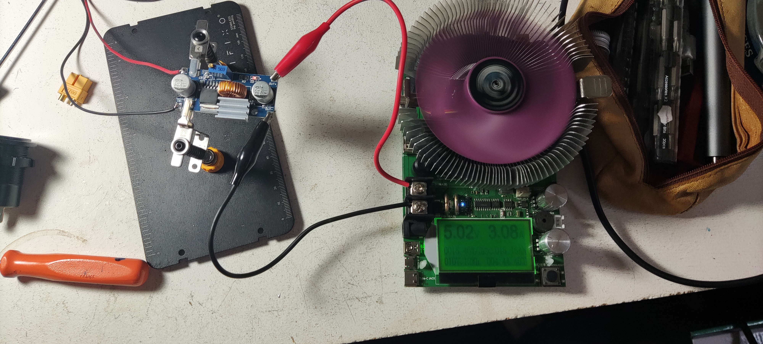
[picture p74: _01-docs/source/images/usb2x3a/xl4015EnCharge.jpg]
     - 
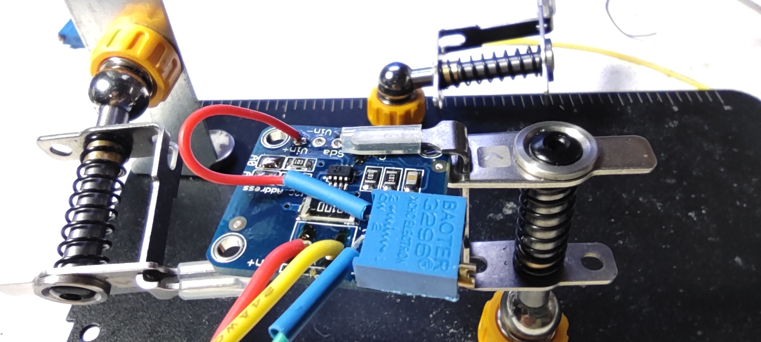
[picture p75: _01-docs/source/images/usb2x3a/ina219EtTrimerDeporte.jpg]
     - 
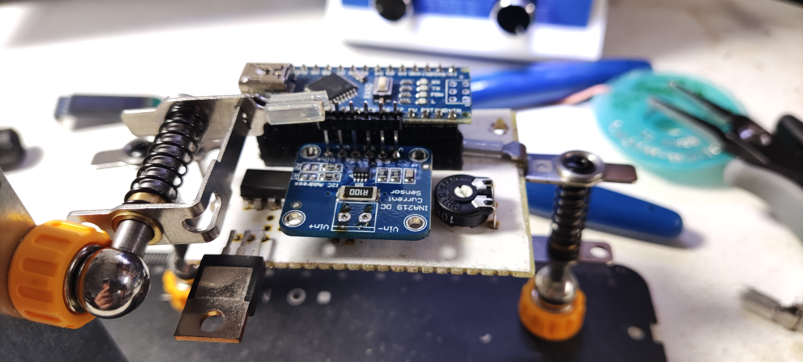
[picture p76: _01-docs/source/images/usb2x3a/carteEnCoursDeSoudure.jpg]
     - 
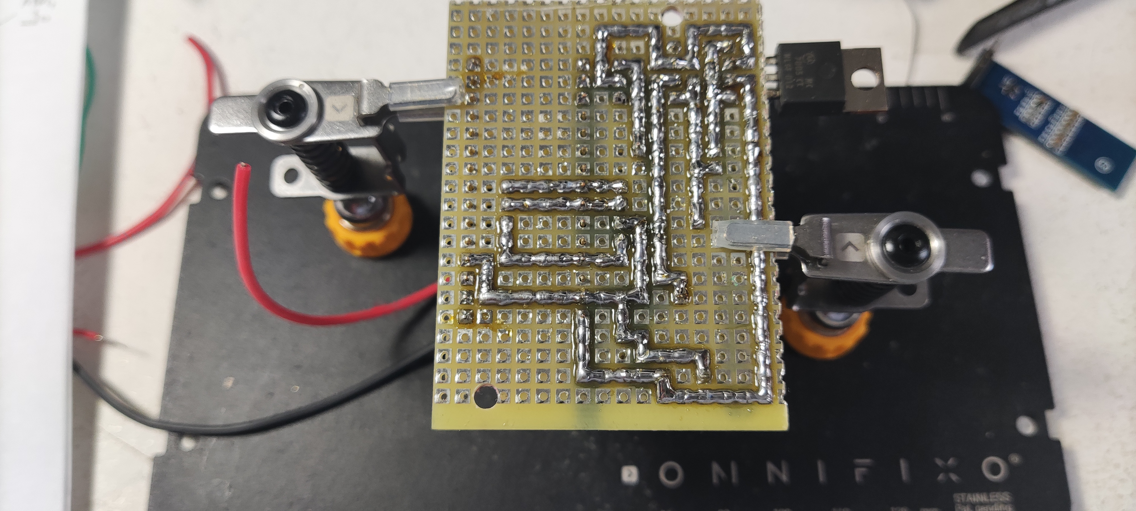
[picture p77: _01-docs/source/images/usb2x3a/carteEnCoursDeSoudureRecto.jpg]
     - 











.. list-table::
   :widths: 20 20 20 20 20
   :header-rows: 1

   * - Maquette
     - XL4015 en charge
     - INA219 + trimer
     - Carte en cours
     - Carte verso

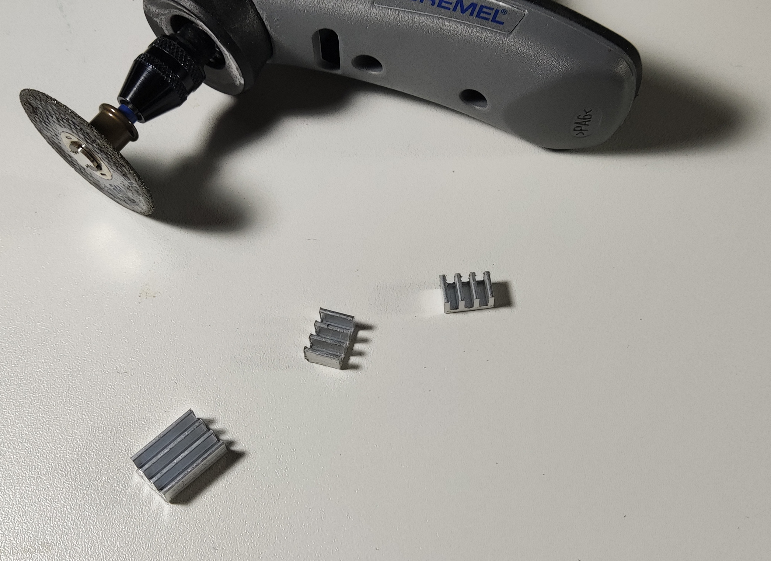
[picture p78: _01-docs/source/images/usb2x3a/decoupeDissipateurALaDremel.jpg]
   * - 
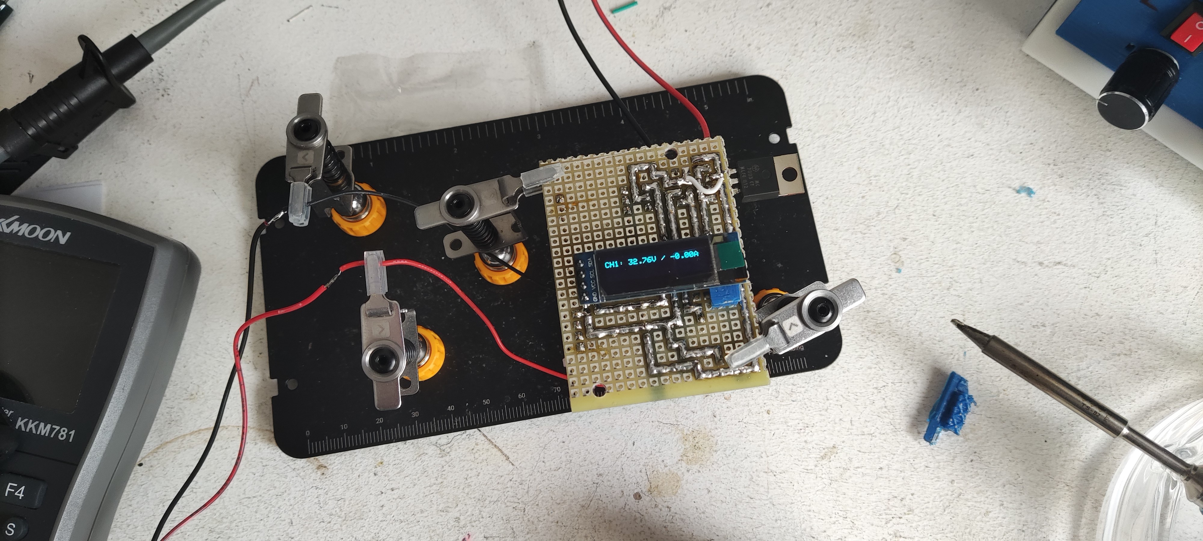
[picture p79: _01-docs/source/images/usb2x3a/carteEssaiStatique.jpg]
     - 
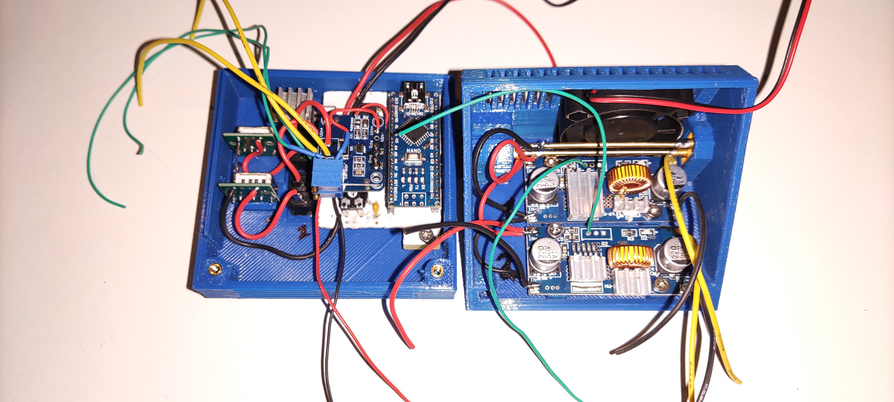
[picture p80: _01-docs/source/images/usb2x3a/cablageFaceAvantEtBase.jpg]
     - 
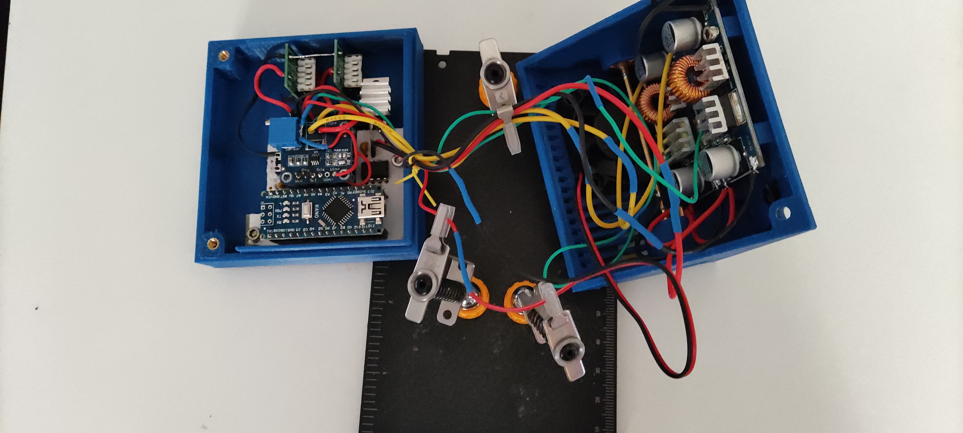
[picture p81: _01-docs/source/images/usb2x3a/connexionFavBase.jpg]
     - 
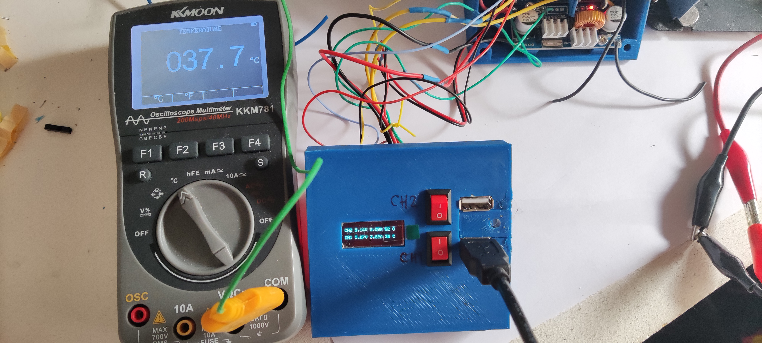
[picture p82: _01-docs/source/images/usb2x3a/essaisTemp.jpg]
     - 

====================================================================================================
Une jolie face avant (pour combler le vide)
====================================================================================================



Découpé avec notre antique craftrobot...

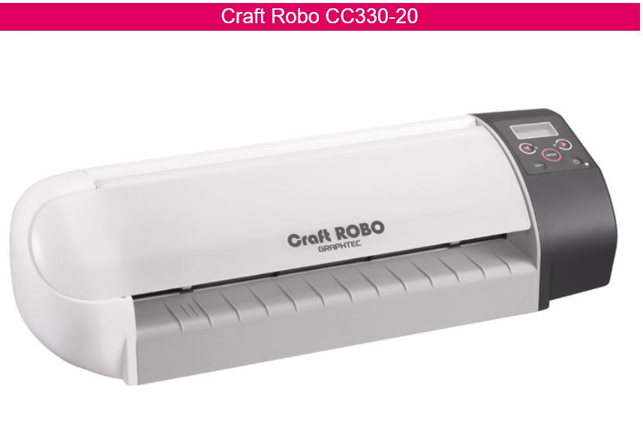
[picture p83: _01-docs/source/images/craftrobot.jpg]


Compatible du logiciel Silhouette Studio (je conseille la v3.6.057, pour les repère de coupe old
style)

====================================================================================================
Rendus FreeCad
====================================================================================================
L'intérieur du module très chargé et encore, il n'y a pas les fils de cablage...

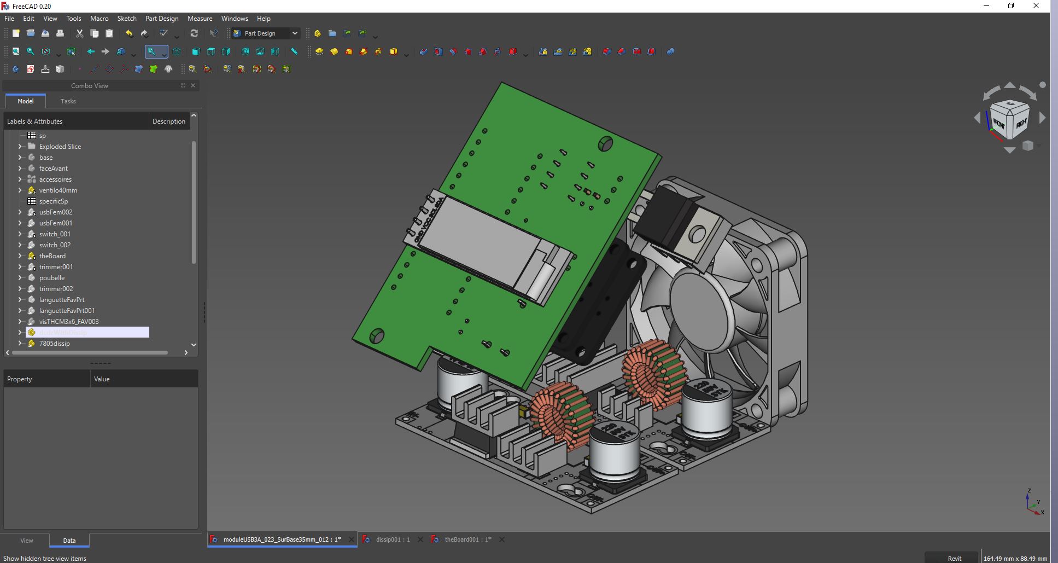
[picture p84: _01-docs/source/images/usb2x3Av2_interne.jpg]


La même avec en plus la base, les switch et les prise USB:

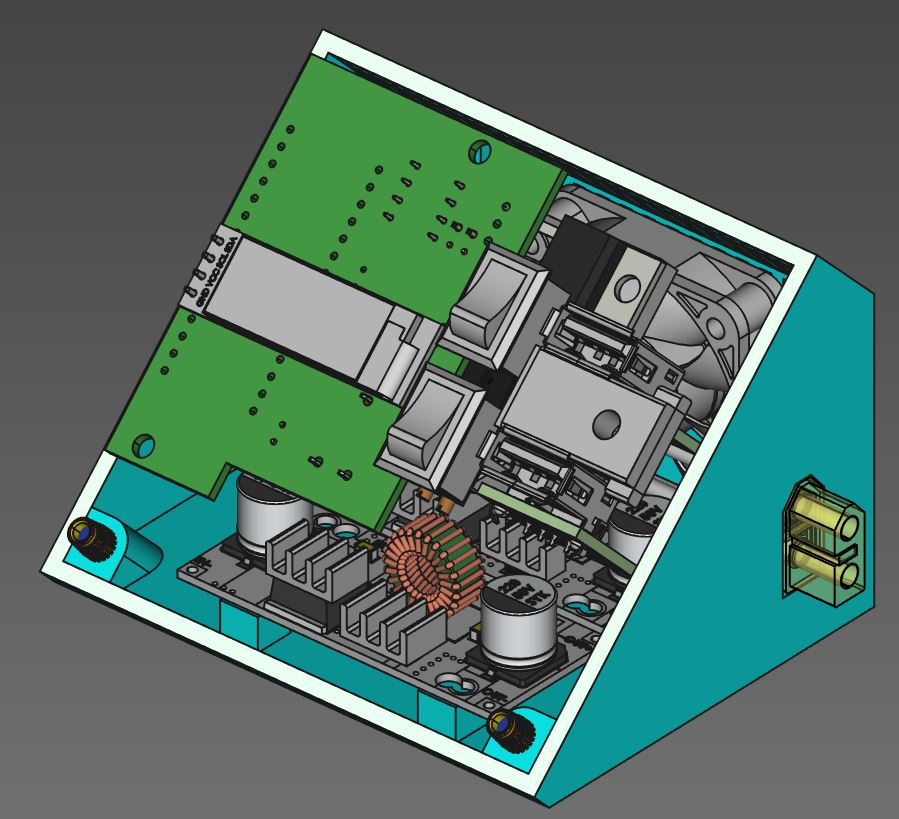
[picture p85: _01-docs/source/images/usb2x3Av2_sansFAV.jpg]


Et avec

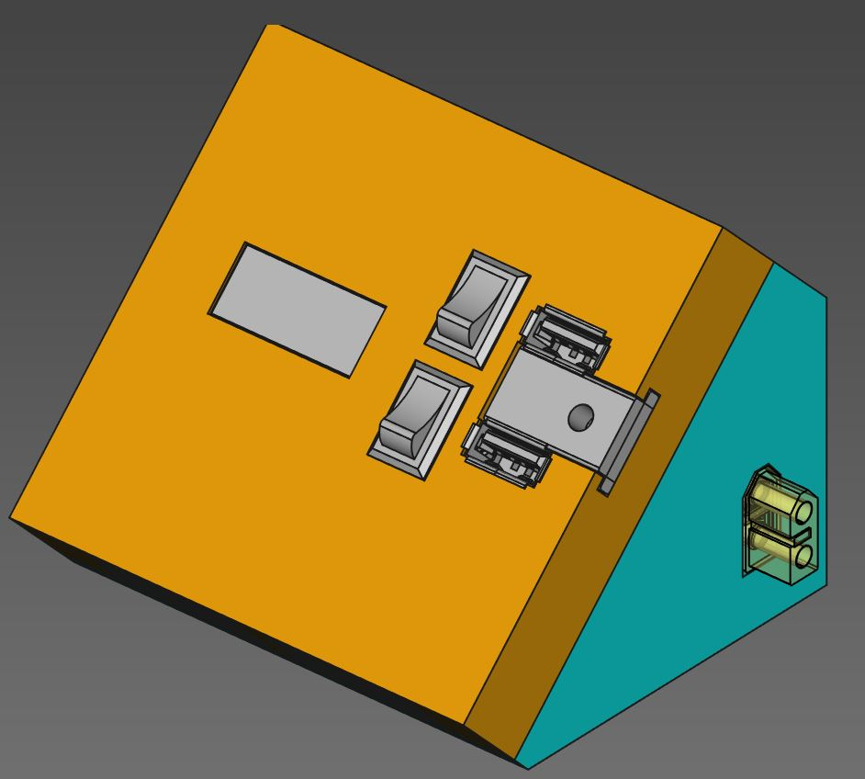
[picture p86: _01-docs/source/images/usb2x3Av2_avecFAV.jpg]


====================================================================================================
Arduino code
====================================================================================================




Vous le trouverez sur le `github du projet module usb2x3a`_

.. _`github du projet module usb2x3a` : https://github.com/MajorLee95/tinyelab/blob/main/_02-realisation/_01-software/usb3a/usb3a.ino

====================================================================================================
Nomenclature
====================================================================================================

.. csv-table:: Nomenclature USB5V 3A
   :file: ../../_02-realisation/_03-cao_3D/mesCreations/moduleUSB3A/nomUSB3A.csv
   :delim: ,
   :encoding: UTF-8
   :align: left
   :header-rows: 1

Prendre les ARDUINO NANO sur Aliexpress, il sont nettement moins cher !

.. index::
    single: Veroboard

.. _refVeroboard:

Carte de prototypage à souder à **pastilles carrées** simple face au pas de 2.54 chez
Radiospares code `457-0761`_ 200x100 : 18.84€ 20.000mm2 soit 0.000942€/mm2

.. _`457-0761` : https://fr.rs-online.com/web/p/cartes-matrices/4570761

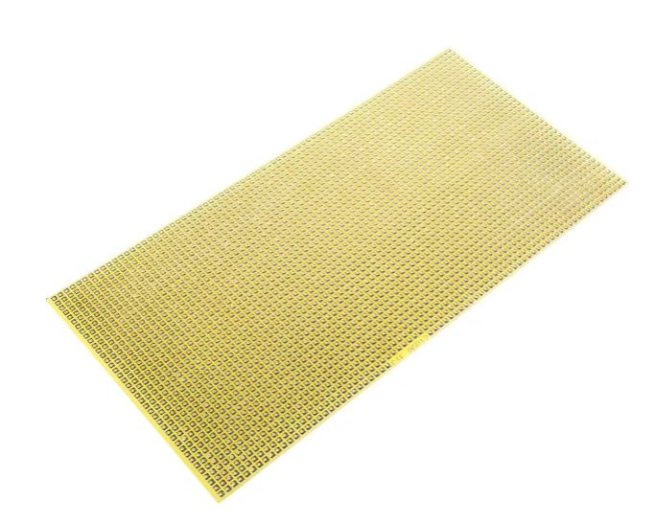
[picture p87: _01-docs/source/images/veroboardPastilleCaree.jpg]


Le pastillage carré permet de tracer des pistes en reliant par des ponts de soudure les pastilles
2 à 2 puis 4 à 4 puis 8 à 8...

====================================================================================================
Weblinks
====================================================================================================

.. target-notes::
