MajorLee95/tinyelab/_01-docs/source/moduleVoltAmperemetre.rst

++++++++++++++++++++++++++++++++++++++++++++++++++++++++++++++++++++++++++++++++++++++++++++++++++++
Module Volt/amperemetre couplés
++++++++++++++++++++++++++++++++++++++++++++++++++++++++++++++++++++++++++++++++++++++++++++++++++++

.. include:: volabid.rst

:Auteur: J.Soranzo
:Date de création: 11/2022
:Date dernière maj: 11/2022

.. |clearer|  raw:: html

.. index::
    pair: Modules; Volt/ampèremètre

====================================================================================================
Présentation
====================================================================================================
Il s'agit d'un simple Voltmètre ampèremètre digital comme on en trouve de multiple sur internet
J'en ai choisi un qui traînait dans mes affaire depuis bien longtemps...

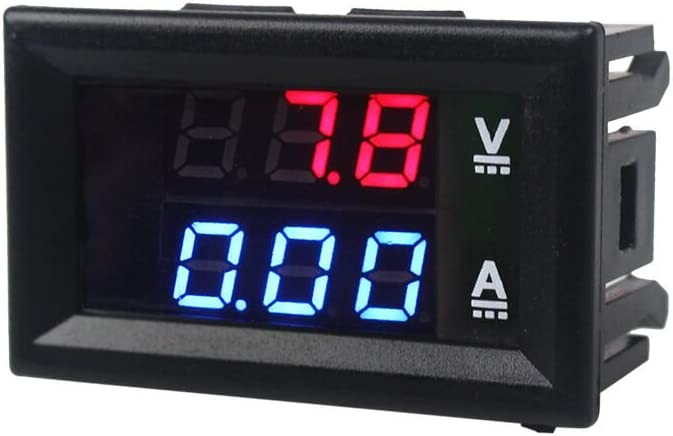
[picture p101: _01-docs/source/images/moduleVA_AC_SL1000_.jpg]


Source possible mais non garantie au niveau des dimensions notamment:

`BE-TOOL Voltmètre multimètre, voltmètre numérique et ampèremètre avec double affichage LED rouge et bleu CC 0–100 V 10 A`_

.. _`BE-TOOL Voltmètre multimètre, voltmètre numérique et ampèremètre avec double affichage LED rouge et bleu CC 0–100 V 10 A` : https://www.amazon.fr/BE-TOOL-Multim%C3%A8tre-Voltm%C3%A8tre-amp%C3%A8rem%C3%A8tre-domestique/dp/B07Q1P8BQB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

J'ai facilement trouvé le modèle 3D sur Grabcad.

J'ai réutilisé la connectique du module :ref:`alimentation stabilisée DPS3005<refAlimStabDPS3005>`

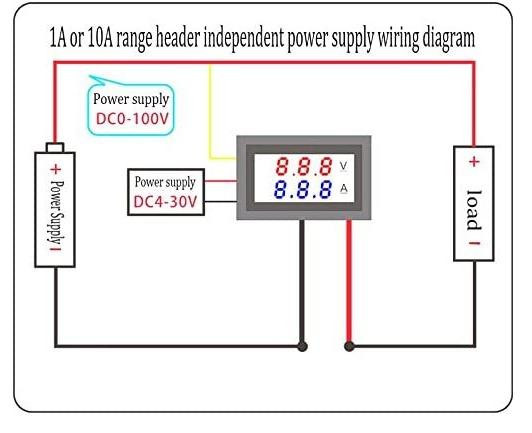
[picture p102: _01-docs/source/images/voltAmpereWiring_51KumhqfJfL.jpg]


    Volt ampère schéma de câblage initial 

|clearer|

`How to Make a Digital Voltmeter and Ampere Meter at Home - Homemade Myltimeter`_ On Youtube

.. _`How to Make a Digital Voltmeter and Ampere Meter at Home - Homemade Myltimeter` : https://www.youtube.com/watch?v=vPSaLIBBoh4



   Câblage interne et utilisation

|clearer|

.. WARNING:: ATTENTION
   :class: without-title

   Avec ce genre de module le point chaud est commun entre l'apèremètre et le voltmètre.
   De plus n'oubliez pas que le GND est commun avec les autres modules.

|clearer|

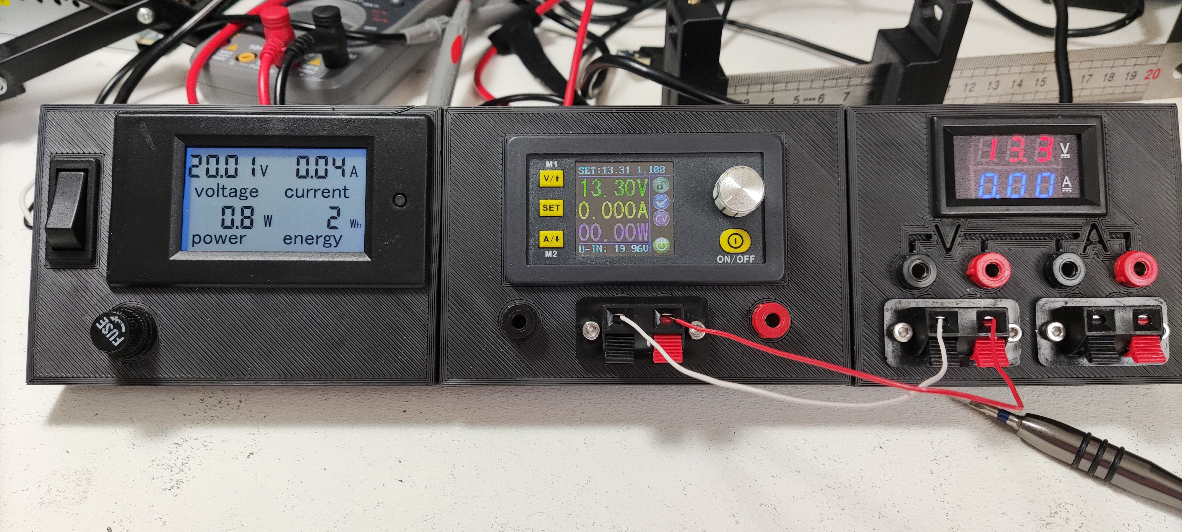
[picture p103: _01-docs/source/images/VAInWork.jpg]


    Module Volt ampère première utilisation 

====================================================================================================
Rendu Freecad
====================================================================================================

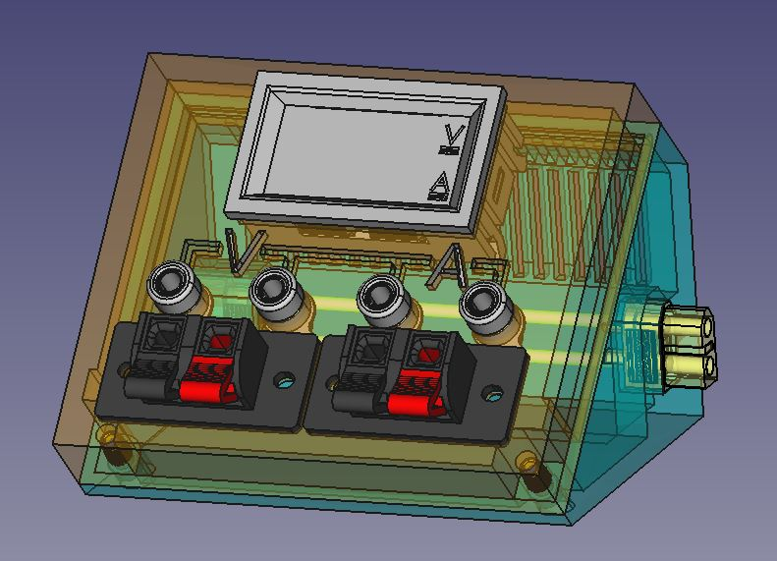
[picture p104: _01-docs/source/images/moduleVA.jpg]


====================================================================================================
Photo
====================================================================================================
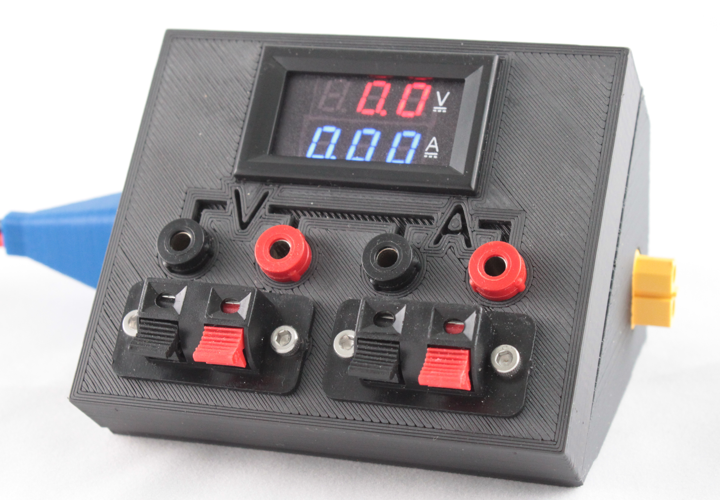
[picture p105: _01-docs/source/images/moduleVAPhoto.jpg]


====================================================================================================
Nomenclature
====================================================================================================
.. csv-table:: Nomenclature module Volt/ampère
   :file: ../../_02-realisation/_03-cao_3D/mesCreations/moduleVoltAmperemetre/nomModulVA.csv
   :delim: ,
   :encoding: UTF-8
   :align: left

====================================================================================================
Weblinks
====================================================================================================

.. target-notes::
