MajorLee95/tinyelab/_03-wiki/specVignette.md

# Conseils pour les images #
dans les vignettes projets  
Proportion 1.5  
300x200  
600x400...
1200x800
750x500
825x550

Syntaxe pour les images:
300px
600px|right|thumb|
ou
vignette

Tiny electronic Lab or Tiny e-lab ou mon petit lab
