MajorLee95/tinyelab/_01-docs/source/index.rst

++++++++++++++++++++++++++++++++++++++++++++++++++++++++++++++++++++++++++++++++++++++++++++++++++++
Tiny e-lab extension
++++++++++++++++++++++++++++++++++++++++++++++++++++++++++++++++++++++++++++++++++++++++++++++++++++

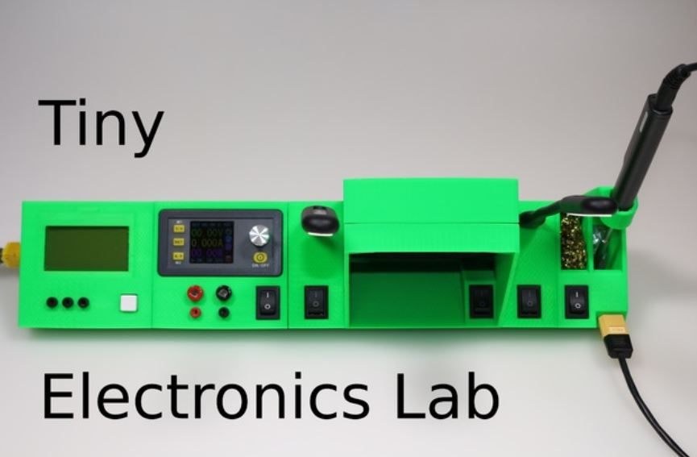
[picture p109: _01-docs/source/images/tinyelab.jpg]


.. include:: volabid.rst

:Date de création: 02/2022
:Date dernière maj: 06/07/2022

.. toctree::
   :maxdepth: 2
   :caption: Table des matières:

   presentation
   mesRealisation
   avancement
   githubPages

====================================================================================================
Indices and tables
====================================================================================================

* :ref:`genindex`
* :ref:`search`
