MajorLee95/tinyelab/_01-docs/source/moduleAlimStabiliseeDPS3005.rst

++++++++++++++++++++++++++++++++++++++++++++++++++++++++++++++++++++++++++++++++++++++++++++++++++++
Module alimentation stabilisée DPS3005
++++++++++++++++++++++++++++++++++++++++++++++++++++++++++++++++++++++++++++++++++++++++++++++++++++

.. include:: volabid.rst

:Date de création: 10/2022
:Date dernière maj: 07/10/2022

.. |clearer|  raw:: html

.. _refAlimStabDPS3005:

.. index::
    pair: Modules; Alim

====================================================================================================
Présentation
====================================================================================================
DPS3005
----------------------------------------------------------------------------------------------------
Éléments mécaniques
****************************************************************************************************

`Sur AMAZON DollaTek DPS3005`_ mais aussi sur ebay `DP20V2A 30V5A 50V5A DC32V/3A DPS3003 Programmable Step-down Power Supply Module`_

.. _`DP20V2A 30V5A 50V5A DC32V/3A DPS3003 Programmable Step-down Power Supply Module` : https://www.ebay.fr/itm/173505693618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

 et aliexpress

.. _`Sur AMAZON DollaTek DPS3005` : https://www.amazon.fr/gp/product/B07PLFZ3H2/ref=ppx_yo_dt_b_asin_title_o09_s01?ie=UTF8&psc=1

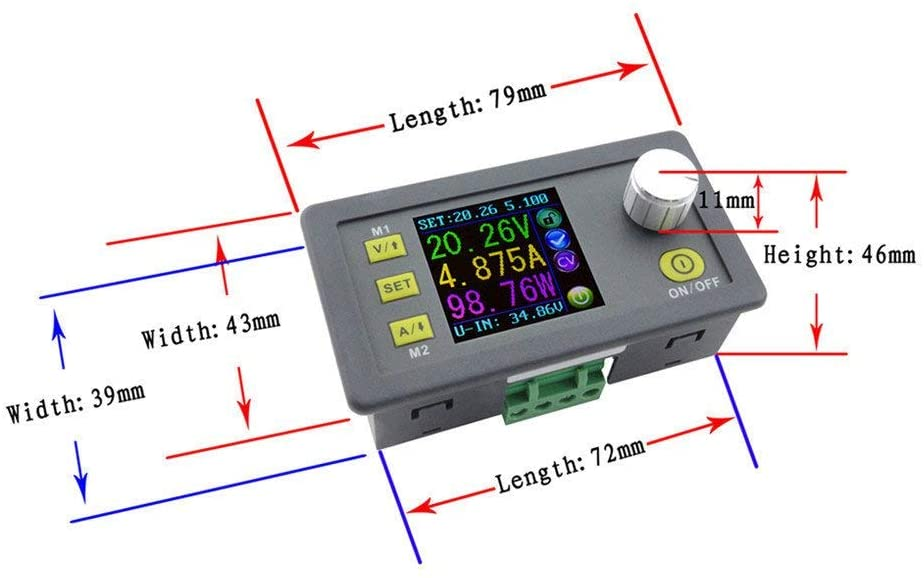
[picture p110: _01-docs/source/images/DPS3005_51c1779dvnL._AC_SL1000_.jpg]


|clearer|

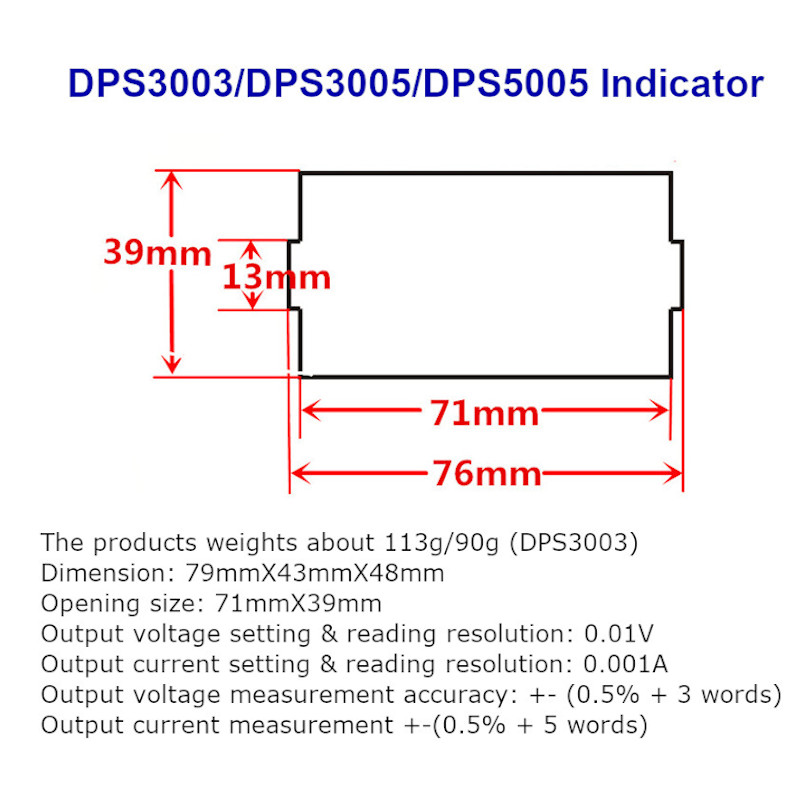
[picture p111: _01-docs/source/images/DPS3005_domensions.jpg]


Software
****************************************************************************************************
Ce module peut être piloter en USB, il est fourni avec un carte d'interface.

`TheHWcave Controlling a DPS5005 power supply module`_

.. _`TheHWcave Controlling a DPS5005 power supply module` : https://www.youtube.com/watch?v=7sy249Ikzvc

Avec exemple de code en Python sous `github DPS5005-control`_

.. _`github DPS5005-control` : https://github.com/TheHWcave/DPS5005-control

Fiches bananes
----------------------------------------------------------------------------------------------------

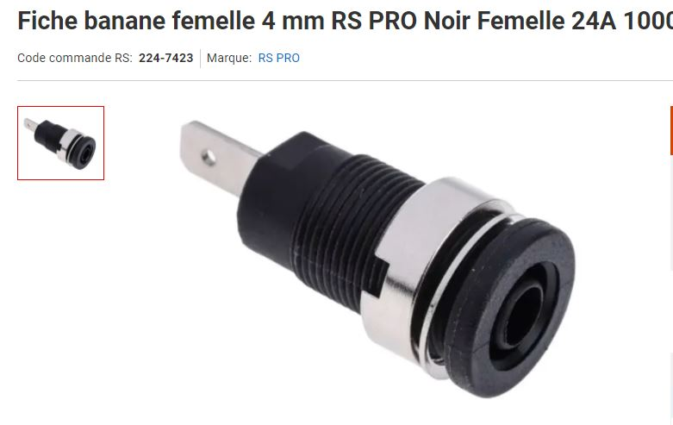
[picture p112: _01-docs/source/images/ficheBananeRSNoire.jpg]


|clearer|

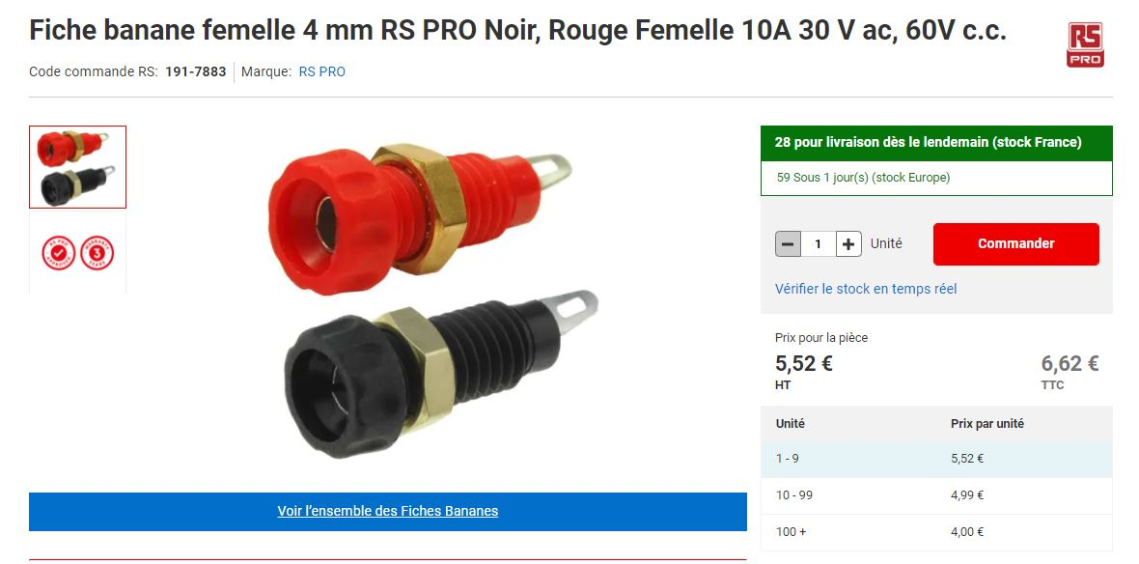
[picture p113: _01-docs/source/images/ficheBananeRSRougeNoirLowCost.jpg]


Avec :download:`la datasheet<fichiersJoints/dtsFichesBananes_A700000006792413.pdf>`

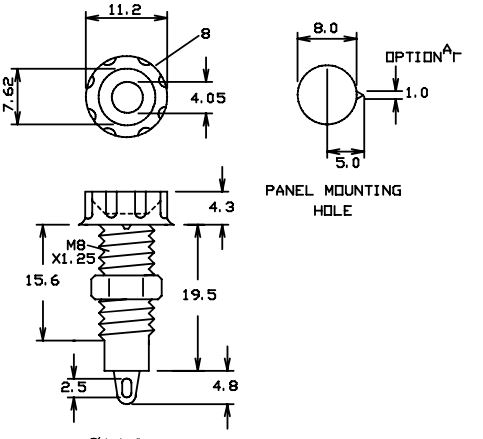
[picture p114: _01-docs/source/images/ficheBananeRSRougeNoirLowCost_mountingHole.jpg]


Connecteurs Audio
----------------------------------------------------------------------------------------------------
Utilisation de connecteurs audio pour avoir des connections rapides.

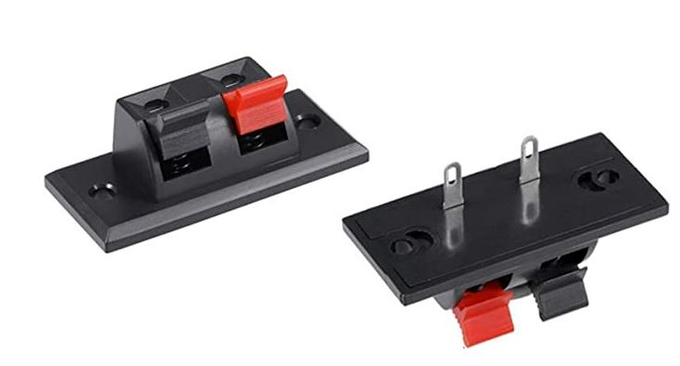
[picture p115: _01-docs/source/images/connecteursAudio.jpg]


    Connecteurs audio  

Disponibles un peu partout sur internet mais ceux que j'ai utilisés pour la modélisation proviennent 
d'`Amazon Bornier 2 Voies pour Enceinte Haut Parleur`_

.. _`Amazon Bornier 2 Voies pour Enceinte Haut Parleur` : https://www.amazon.fr/gp/product/B082TM9QXK/ref=ppx_yo_dt_b_asin_title_o04_s00?ie=UTF8&psc=1 

====================================================================================================
Rendu final sous Freecad
====================================================================================================

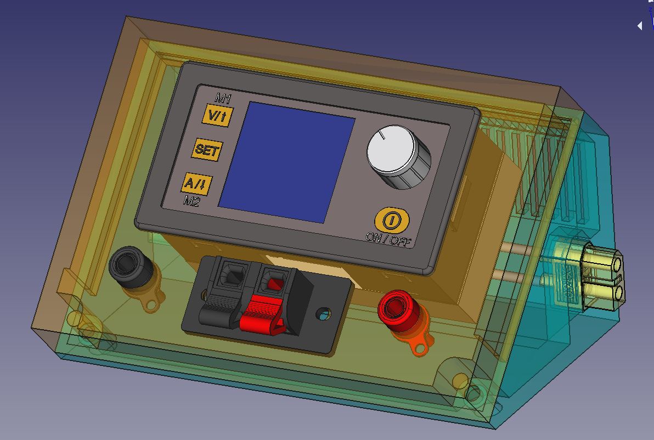
[picture p116: _01-docs/source/images/moduleDPS3005.JPG]


====================================================================================================
Photos
====================================================================================================
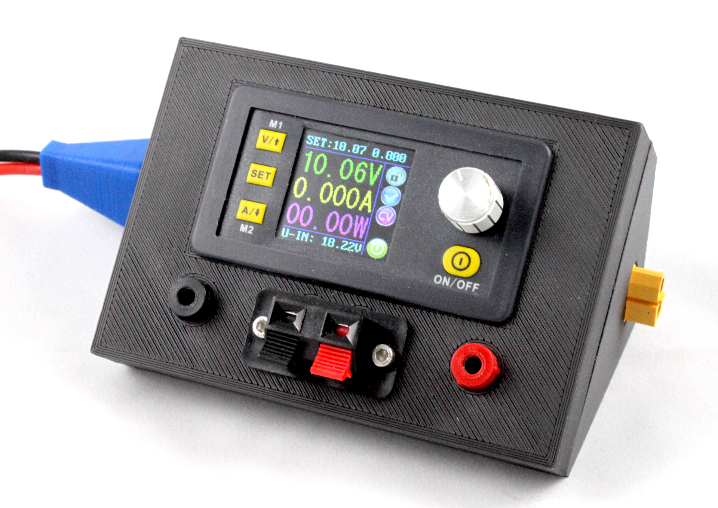
[picture p117: _01-docs/source/images/moduleDPS3005_photo.JPG]


====================================================================================================
Nomenclature module DPS3005
====================================================================================================
.. csv-table:: Nomenclature DPS3005
   :file: ../../_02-realisation/_03-cao_3D/mesCreations/moduleAlimStabDPS3005/nomDPS3005.csv
   :delim: ,
   :encoding: UTF-8
   :align: left
   :header-rows: 1

====================================================================================================
Weblinks
====================================================================================================

.. target-notes::
