MajorLee95/tinyelab/_02-realisation/_03-cao_3D/mesCreations/ressourcesExterieure/C8330-04AFHFXBR(I0252).pdf

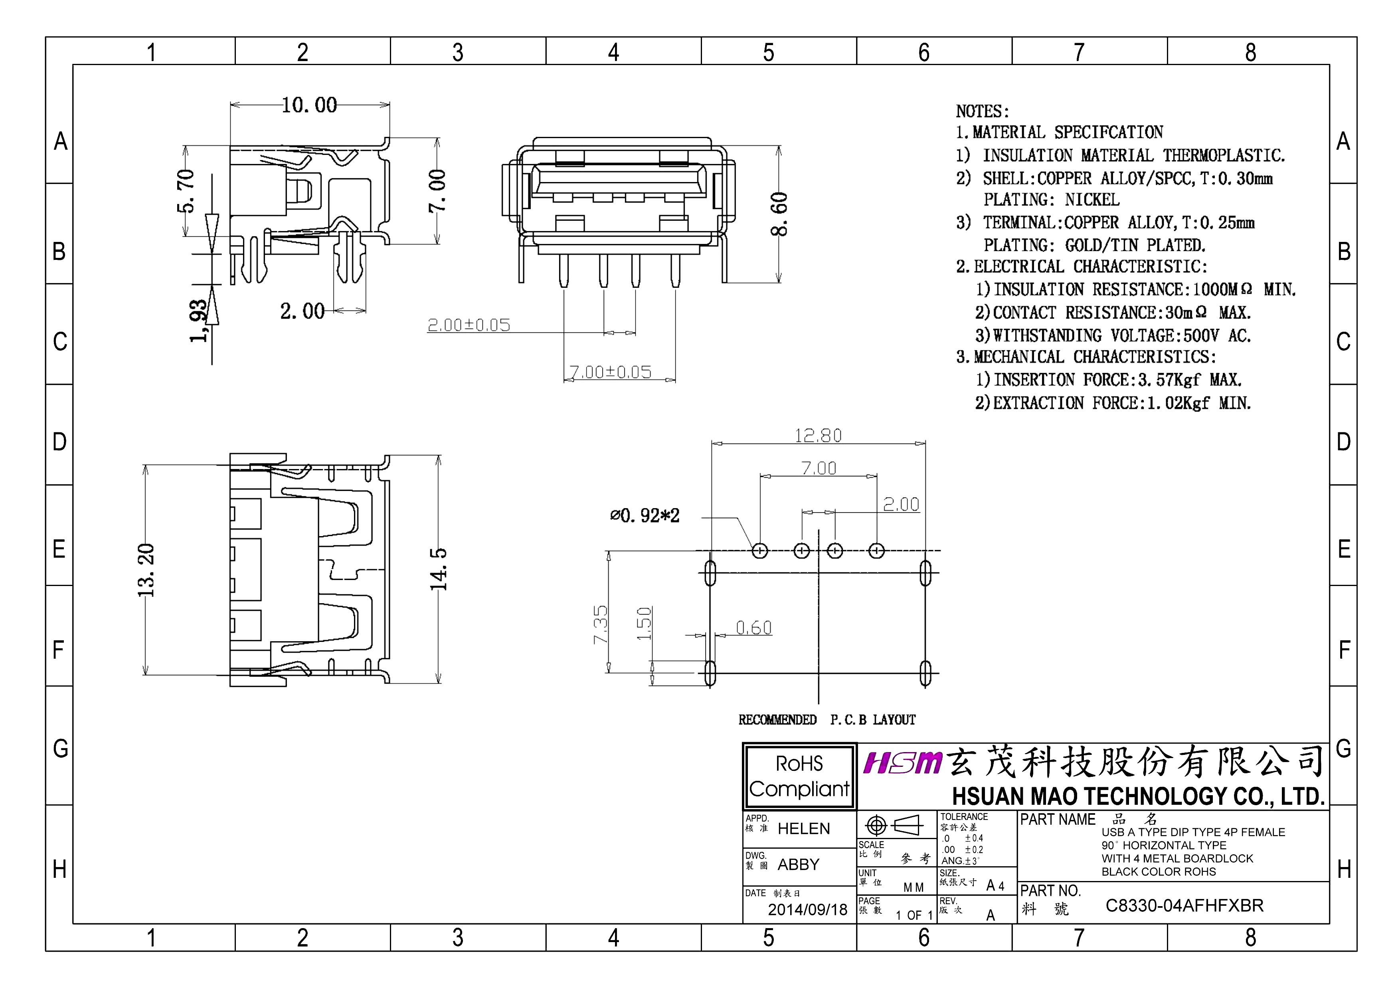
[picture p118: page 1]
