MajorLee95/tinyelab/_02-realisation/_03-cao_3D/mesCreations/ressourcesExterieure/K1161066332.pdf

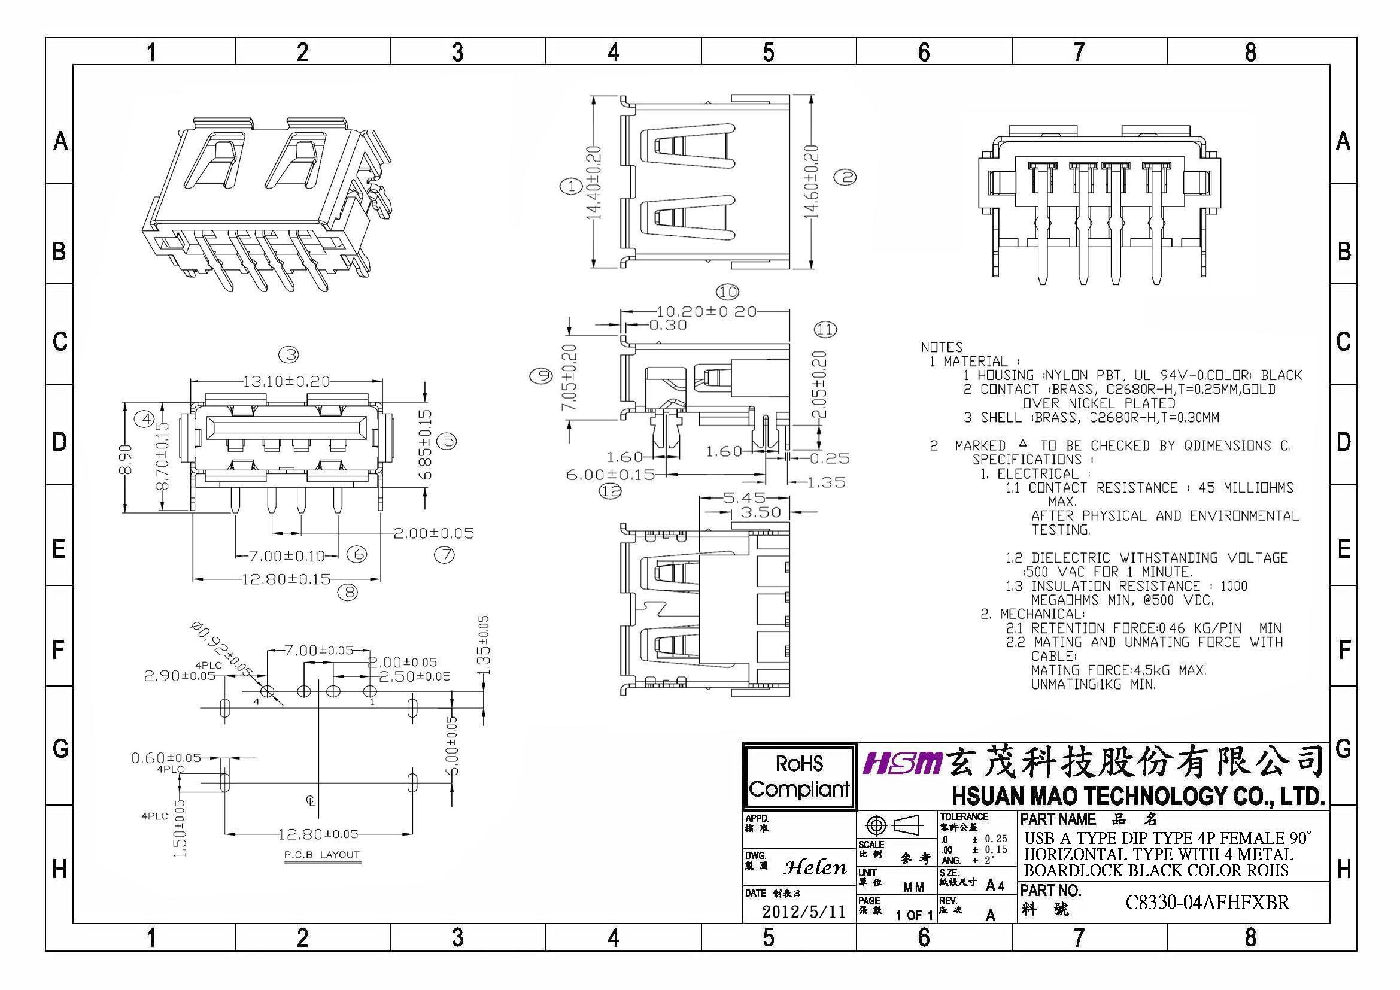
[picture p119: page 1]
