MajorLee95/tinyelab/_01-docs/source/images/parkside/IMG_20220727_175708.jpg

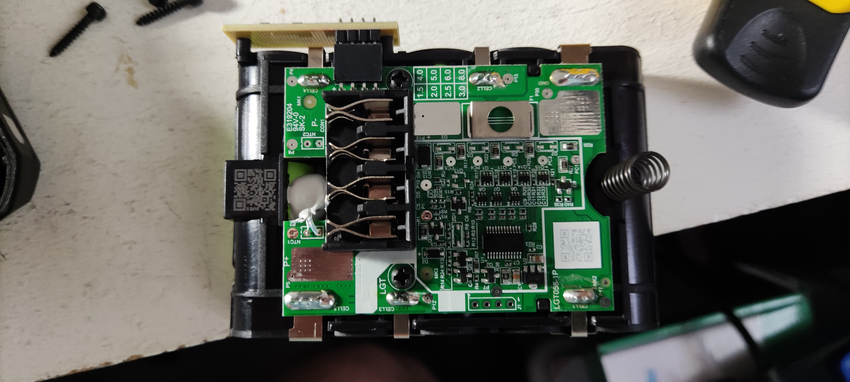
_01-docs/source/images/parkside/IMG_20220727_175708.jpg
