MajorLee95/tinyelab/_01-docs/source/images/parkside/IMG_20220727_180115.jpg

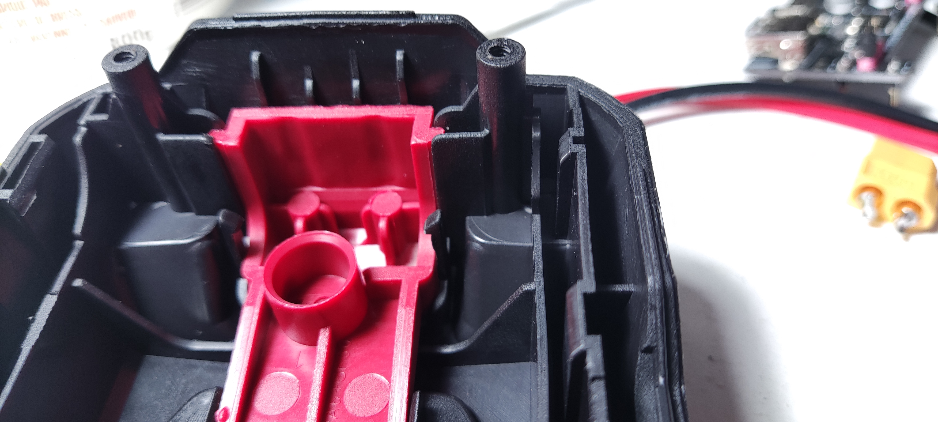
_01-docs/source/images/parkside/IMG_20220727_180115.jpg
