MajorLee95/tinyelab/_01-docs/source/images/parkside/IMG_20220727_181529.jpg

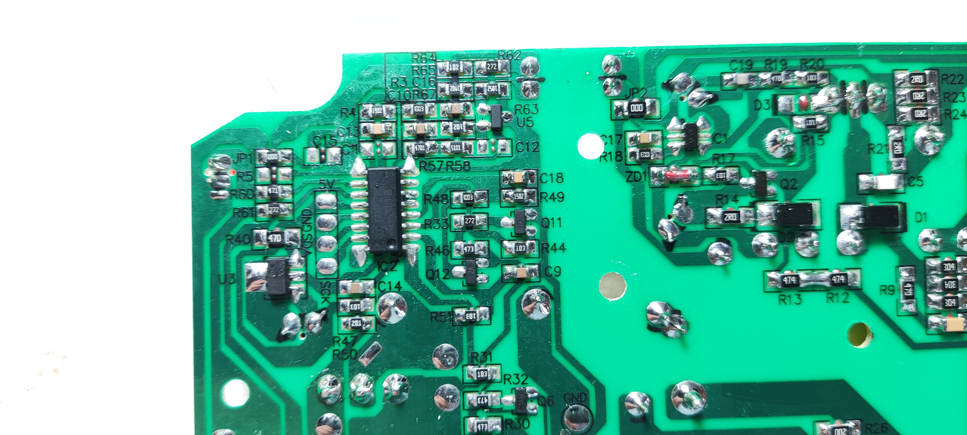
_01-docs/source/images/parkside/IMG_20220727_181529.jpg
