MajorLee95/tinyelab/_01-docs/source/images/USB2X3A_LM35Cablage02.jpg

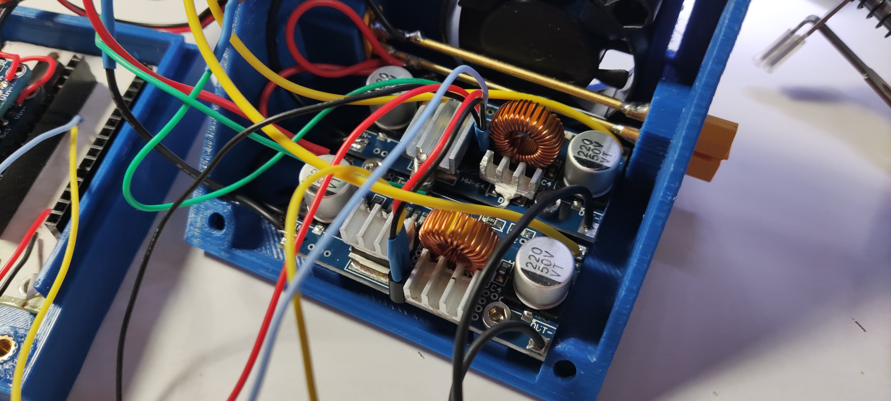
_01-docs/source/images/USB2X3A_LM35Cablage02.jpg
