MajorLee95/tinyelab/_02-realisation/_02-hardware/UILign/xt60Droite.jpg

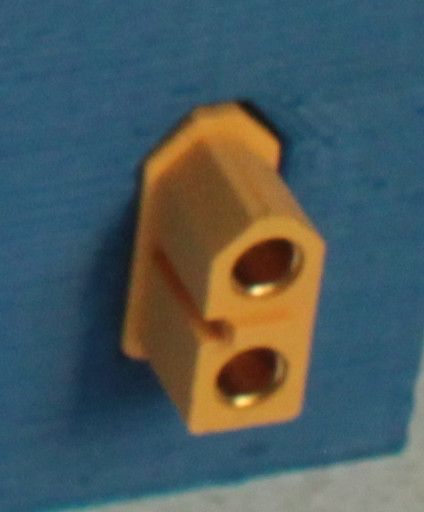
_02-realisation/_02-hardware/UILign/xt60Droite.jpg
