MajorLee95/tinyelab/_02-realisation/_02-hardware/UILign/xt60entree.jpg

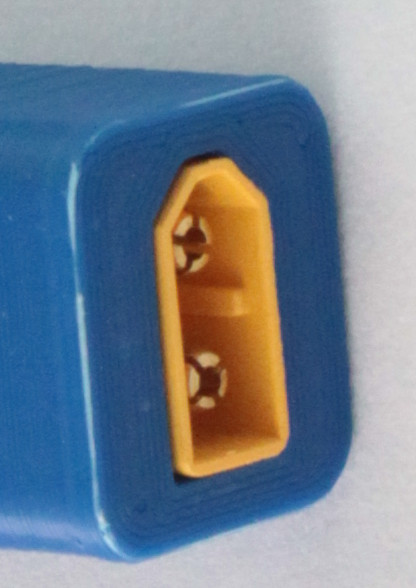
_02-realisation/_02-hardware/UILign/xt60entree.jpg
