MajorLee95/tinyelab/_02-realisation/_02-hardware/usb5v3a_v2_fav/fav221015_1206.png

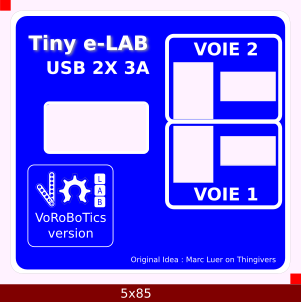
_02-realisation/_02-hardware/usb5v3a_v2_fav/fav221015_1206.png
