MajorLee95/tinyelab/_02-realisation/_02-hardware/usb5v3a_v2_pcb/adafruit_products_fab.png

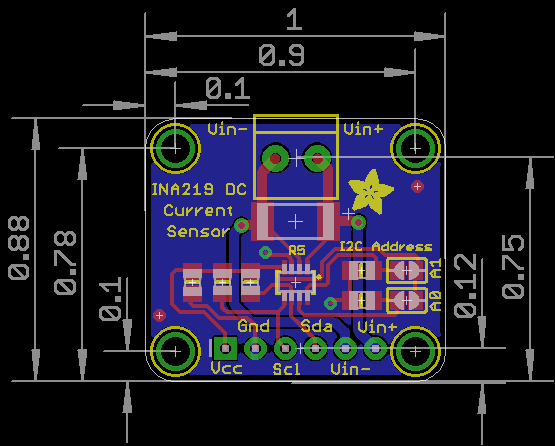
_02-realisation/_02-hardware/usb5v3a_v2_pcb/adafruit_products_fab.png
