MajorLee95/tinyelab/_02-realisation/_02-hardware/usb5v3a_v2_pcb/Blue-0.91-OLED-Module-Dimensions.jpg

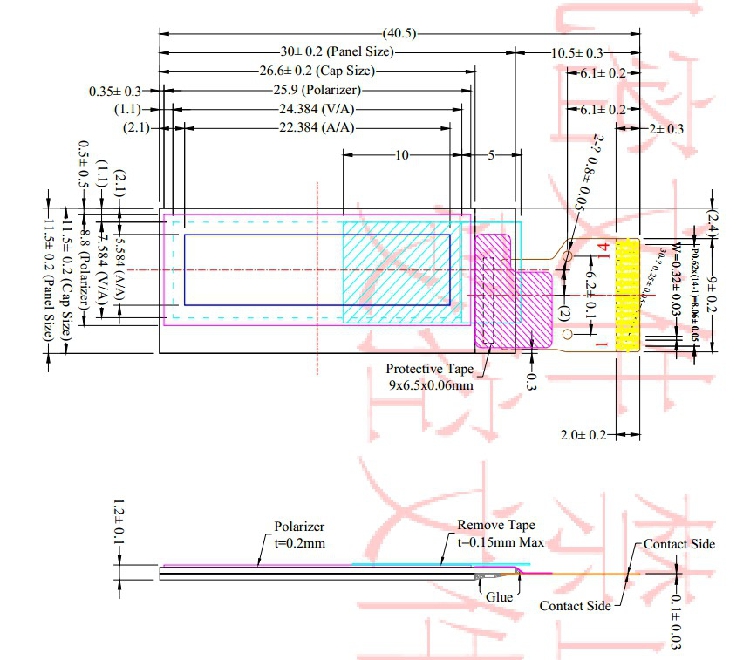
_02-realisation/_02-hardware/usb5v3a_v2_pcb/Blue-0.91-OLED-Module-Dimensions.jpg
