MajorLee95/tinyelab/_02-realisation/_03-cao_3D/mesCreations/elementsCommun/dcjack5521/panel mount 5.5 x 2.1mm barrel plug.png

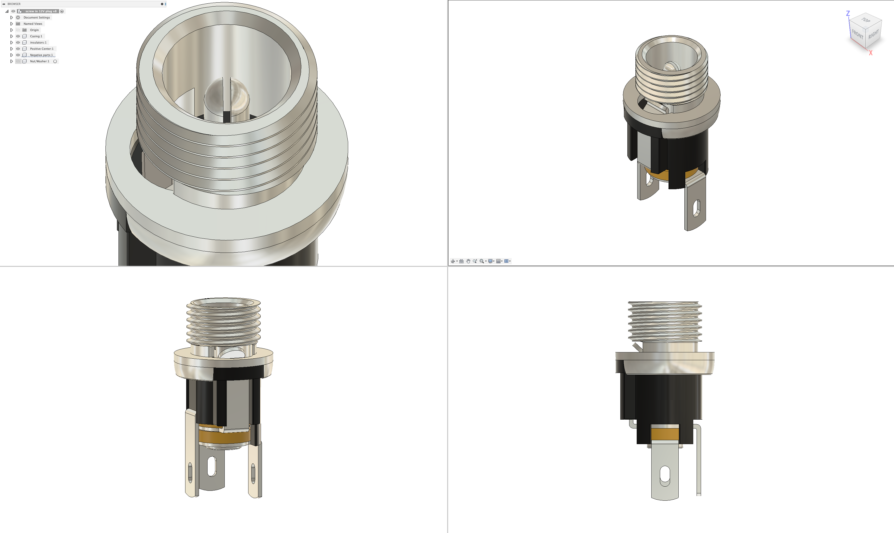
_02-realisation/_03-cao_3D/mesCreations/elementsCommun/dcjack5521/panel mount 5.5 x 2.1mm barrel plug.png
