MajorLee95/tinyelab/_02-realisation/_03-cao_3D/mesCreations/moduleAlimStabDPS3005/modelExternes/borne-de-haut-parleur-2-voies-1.snapshot.3/borne de haut parleur femelle 2 voies.png

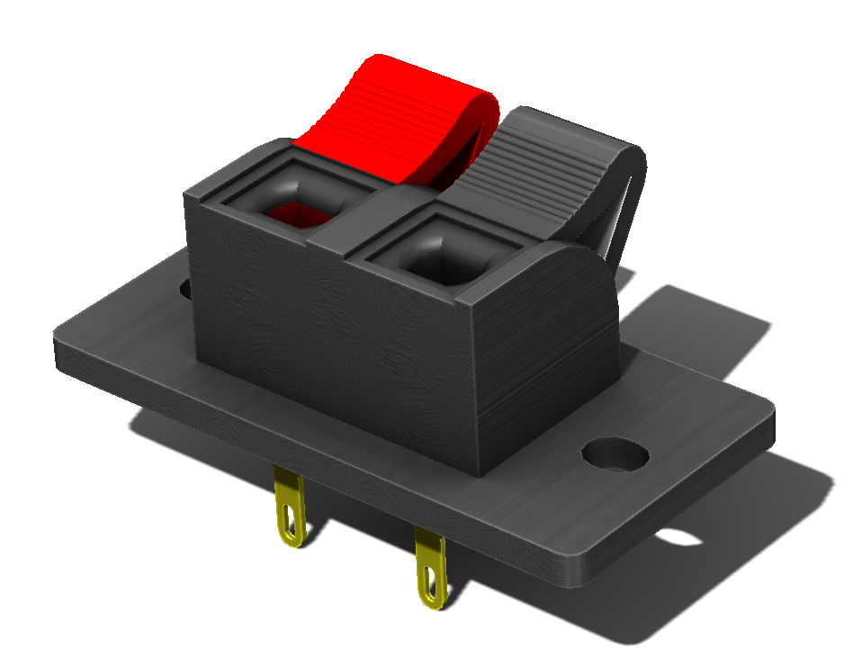
_02-realisation/_03-cao_3D/mesCreations/moduleAlimStabDPS3005/modelExternes/borne-de-haut-parleur-2-voies-1.snapshot.3/borne de haut parleur femelle 2 voies.png
