MajorLee95/tinyelab/_02-realisation/_03-cao_3D/mesCreations/moduleAlimStabDPS3005/modelExternes/dps-5015-display-1.snapshot.11/Dps5015 board.jpg

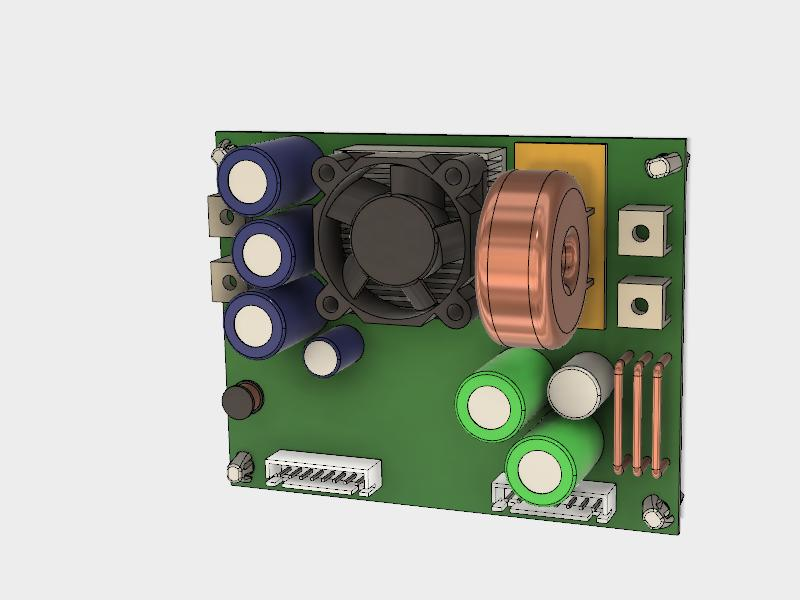
_02-realisation/_03-cao_3D/mesCreations/moduleAlimStabDPS3005/modelExternes/dps-5015-display-1.snapshot.11/Dps5015 board.jpg
