MajorLee95/tinyelab/_02-realisation/_03-cao_3D/mesCreations/moduleGenFonction/modelsExterieur/16-x-2-lcd-display-module-with-iic-i2c-module-1.snapshot.2/I2c board detail.jpg

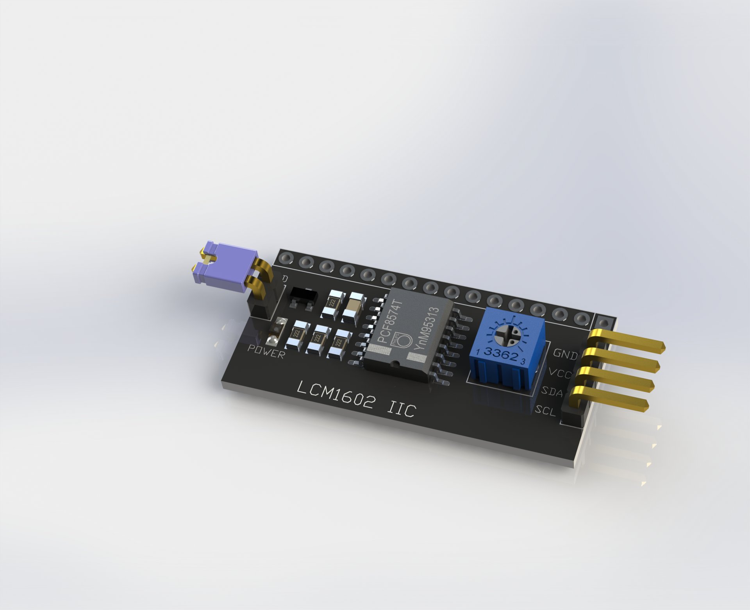
_02-realisation/_03-cao_3D/mesCreations/moduleGenFonction/modelsExterieur/16-x-2-lcd-display-module-with-iic-i2c-module-1.snapshot.2/I2c board detail.jpg
