MajorLee95/tinyelab/_02-realisation/_03-cao_3D/mesCreations/moduleGenFonction/modelsExterieur/Arduino Nano/Arduino Nano .png

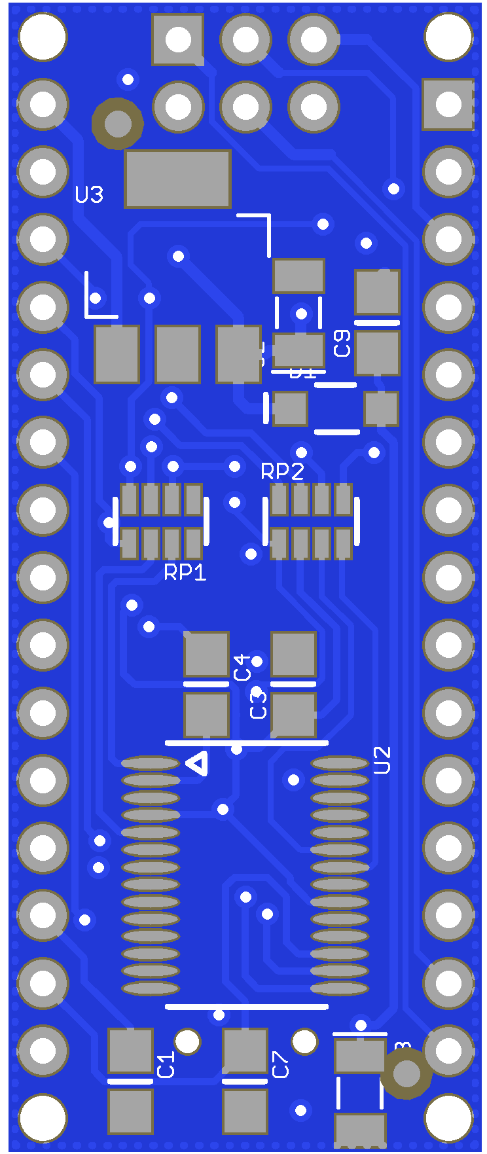
_02-realisation/_03-cao_3D/mesCreations/moduleGenFonction/modelsExterieur/Arduino Nano/Arduino Nano .png
