MajorLee95/tinyelab/_02-realisation/_03-cao_3D/mesCreations/moduleGenFonction/modelsExterieur/LCD with I2C/Untitled1.png

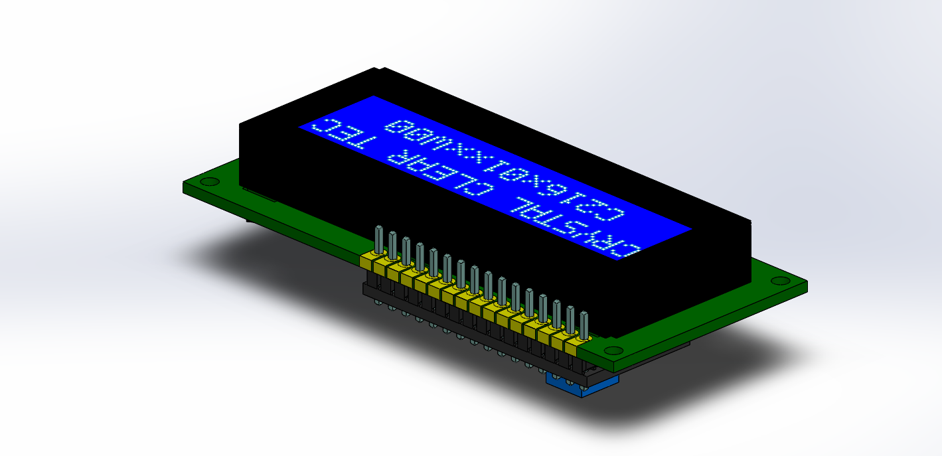
_02-realisation/_03-cao_3D/mesCreations/moduleGenFonction/modelsExterieur/LCD with I2C/Untitled1.png
