MajorLee95/tinyelab/_02-realisation/_03-cao_3D/mesCreations/moduleGenFonction/modelsExterieur/LCD with I2C/Untitled.png

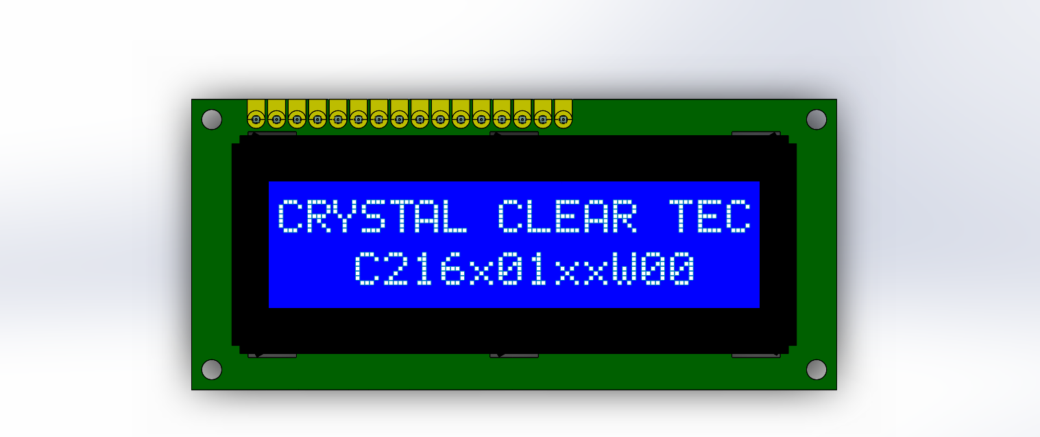
_02-realisation/_03-cao_3D/mesCreations/moduleGenFonction/modelsExterieur/LCD with I2C/Untitled.png
