MajorLee95/tinyelab/_02-realisation/_03-cao_3D/mesCreations/moduleOscillo/DSO138 Oscilloscope 2.JPG

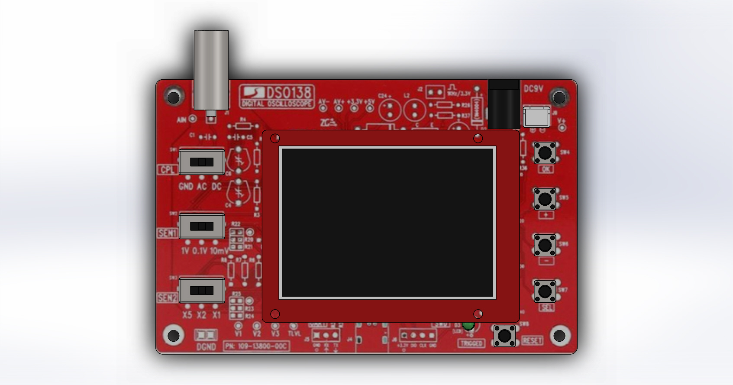
_02-realisation/_03-cao_3D/mesCreations/moduleOscillo/DSO138 Oscilloscope 2.JPG
