MajorLee95/tinyelab/_02-realisation/_03-cao_3D/mesCreations/moduleUSB3A/modelsExterns/lesZip/usb-2-0-a-female-to-dip-2-54mm-pcb-adapter-board-1.snapshot.4/USB2A_Female_DIP2,54_PCB_adapter board_00.png

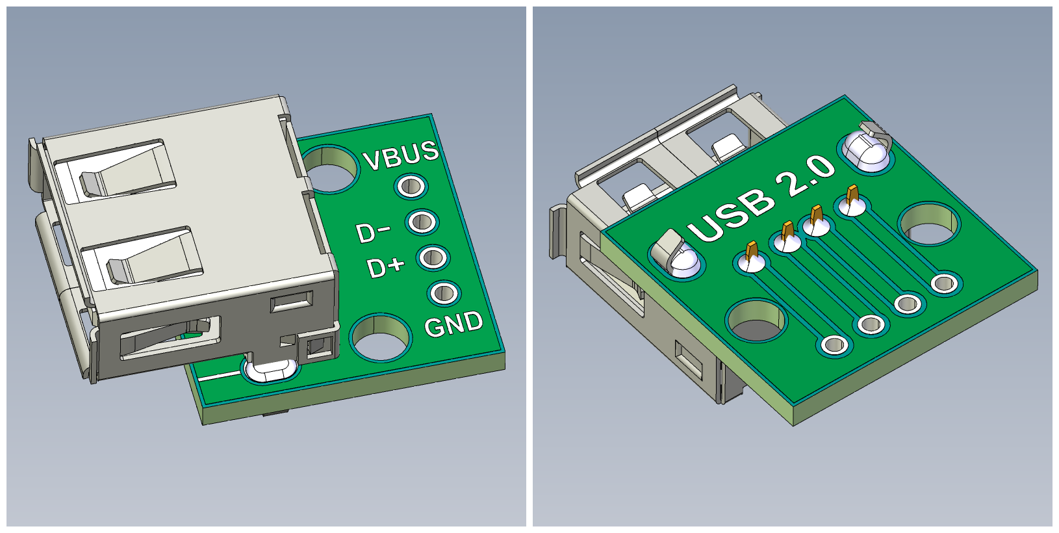
_02-realisation/_03-cao_3D/mesCreations/moduleUSB3A/modelsExterns/lesZip/usb-2-0-a-female-to-dip-2-54mm-pcb-adapter-board-1.snapshot.4/USB2A_Female_DIP2,54_PCB_adapter board_00.png
