MajorLee95/tinyelab/_02-realisation/_03-cao_3D/mesCreations/moduleUSB5V2ASimple2voies/modelsExternes/2301-h-rc-1.snapshot.2/PIC.PNG

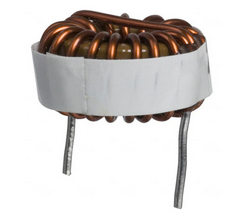
_02-realisation/_03-cao_3D/mesCreations/moduleUSB5V2ASimple2voies/modelsExternes/2301-h-rc-1.snapshot.2/PIC.PNG
