MajorLee95/tinyelab/_02-realisation/_03-cao_3D/mesCreations/moduleUSB5V2ASimple2voies/modelsExternes/soic-package-narrow-8-10-14-and-16-pins-1.snapshot.3/SOIC narrow1.jpg

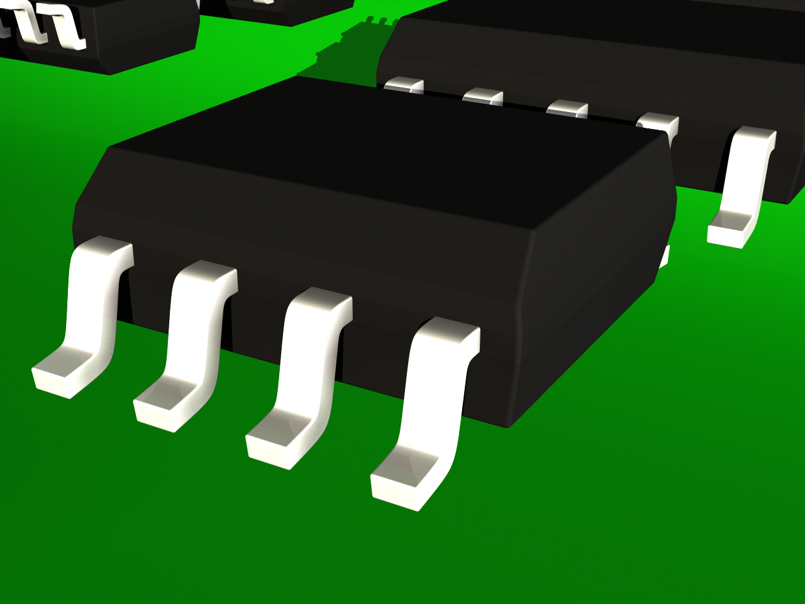
_02-realisation/_03-cao_3D/mesCreations/moduleUSB5V2ASimple2voies/modelsExternes/soic-package-narrow-8-10-14-and-16-pins-1.snapshot.3/SOIC narrow1.jpg
