MajorLee95/tinyelab/_02-realisation/_03-cao_3D/mesCreations/moduleUSB5V2ASimple2voies/refImageBride.JPG

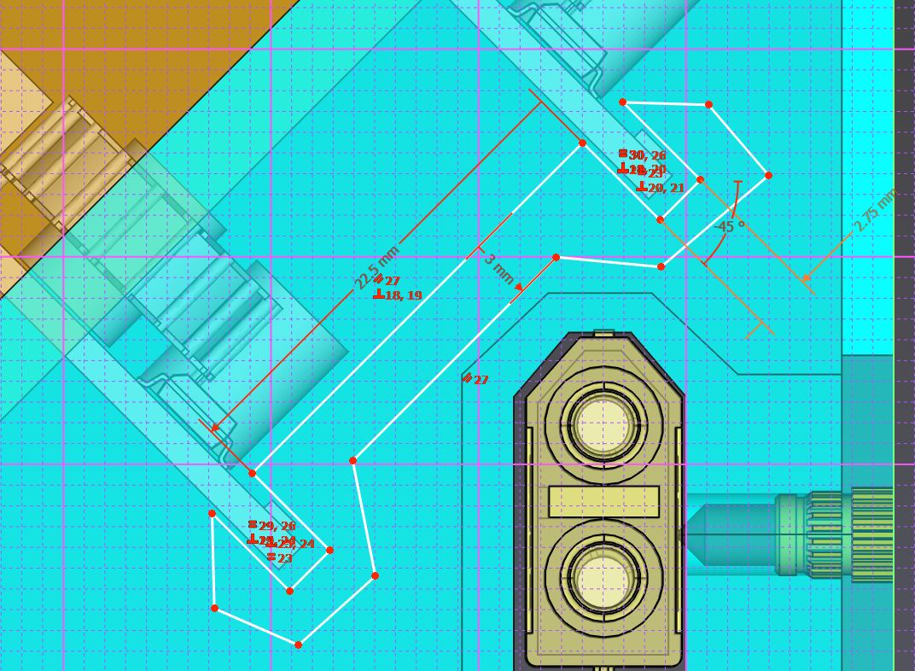
_02-realisation/_03-cao_3D/mesCreations/moduleUSB5V2ASimple2voies/refImageBride.JPG
