MajorLee95/tinyelab/_02-realisation/_03-cao_3D/mesCreations/moduleUSBsimpleDouble/modelsExterns/lesZip/usb20aFemale2dip2-54mmPcbAdapt/USB2AFemaleDIP2,54PCBAdapterBoard01.png

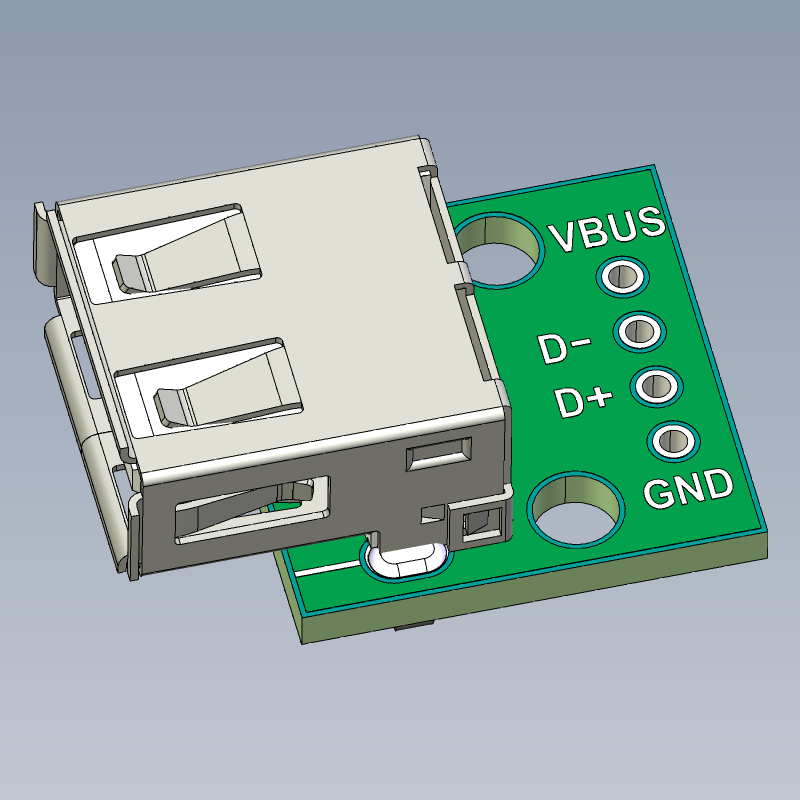
_02-realisation/_03-cao_3D/mesCreations/moduleUSBsimpleDouble/modelsExterns/lesZip/usb20aFemale2dip2-54mmPcbAdapt/USB2AFemaleDIP2,54PCBAdapterBoard01.png
