MajorLee95/tinyelab/_02-realisation/_03-cao_3D/mesCreations/moduleVentilo/modelExternes/80mm-brushless-fan-sunon-kde1208ptb2-1.snapshot.8/80mm brushless fan (SUNON KDE1208PTB2)top.JPG

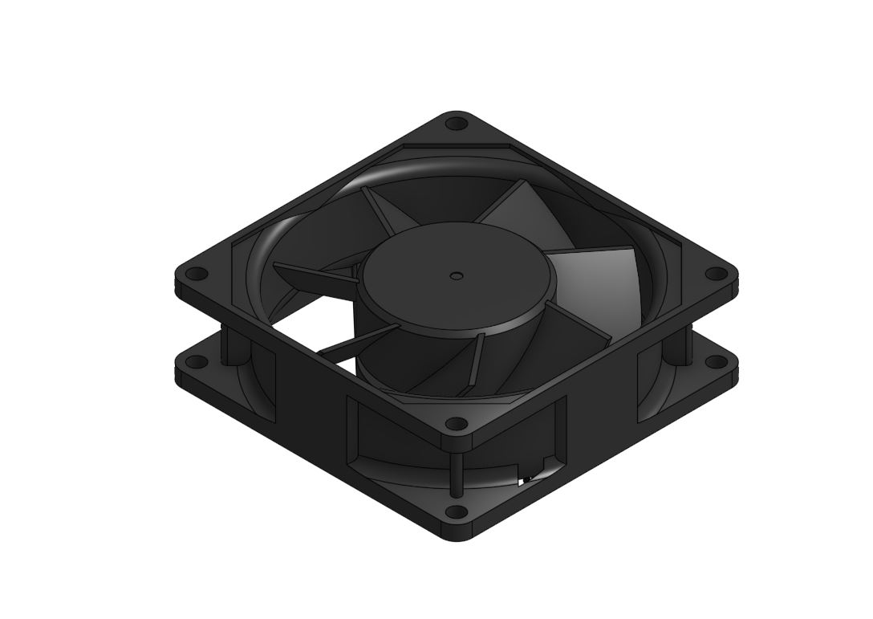
_02-realisation/_03-cao_3D/mesCreations/moduleVentilo/modelExternes/80mm-brushless-fan-sunon-kde1208ptb2-1.snapshot.8/80mm brushless fan (SUNON KDE1208PTB2)top.JPG
