MajorLee95/tinyelab/_02-realisation/_03-cao_3D/mesCreations/moduleVentilo/modelExternes/digispark-attiny85-1.snapshot.8/DigiSpark ATtiny85 - bottom.JPG

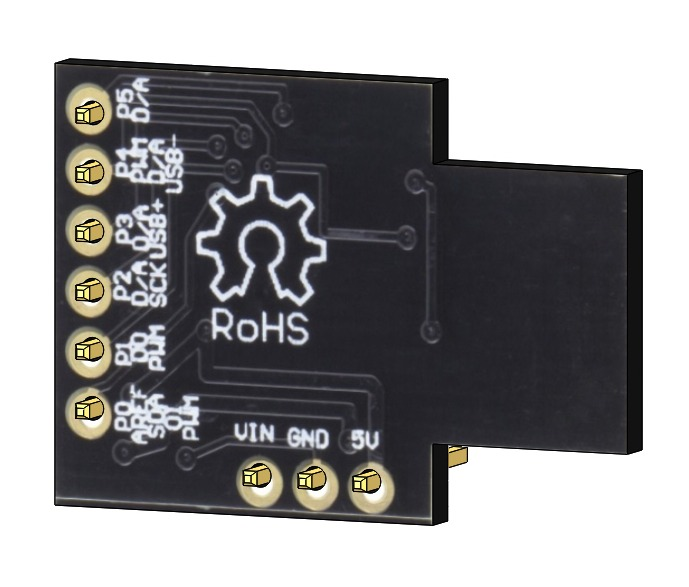
_02-realisation/_03-cao_3D/mesCreations/moduleVentilo/modelExternes/digispark-attiny85-1.snapshot.8/DigiSpark ATtiny85 - bottom.JPG
