MajorLee95/tinyelab/_02-realisation/_03-cao_3D/mesCreations/moduleVentilo/modelExternes/potar/519o8pL9ujS._AC_SX679_.jpg

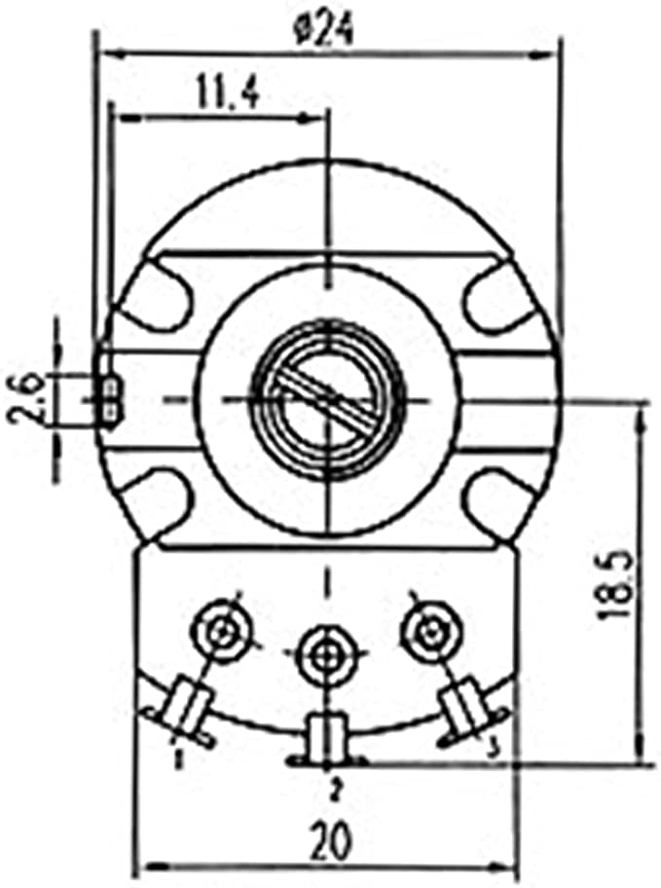
_02-realisation/_03-cao_3D/mesCreations/moduleVentilo/modelExternes/potar/519o8pL9ujS._AC_SX679_.jpg
