MajorLee95/tinyelab/_02-realisation/_03-cao_3D/mesCreations/ressourcesExterieure/4mm-banana-socket-1.snapshot.1/untitled.31.jpg

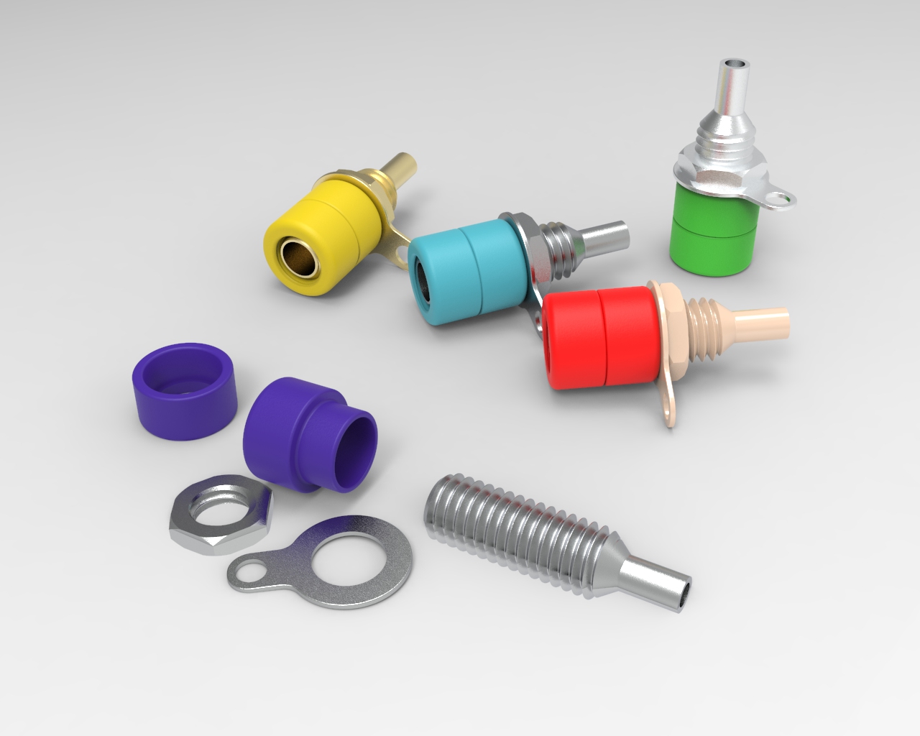
_02-realisation/_03-cao_3D/mesCreations/ressourcesExterieure/4mm-banana-socket-1.snapshot.1/untitled.31.jpg
