MajorLee95/tinyelab/_02-realisation/_03-cao_3D/mesCreations/ressourcesExterieure/lm2596-dcdc-converter-1.snapshot.1/LM2596DCDC_2022-Jan-15_03-52-45AM-000_CustomizedView16761749139.png

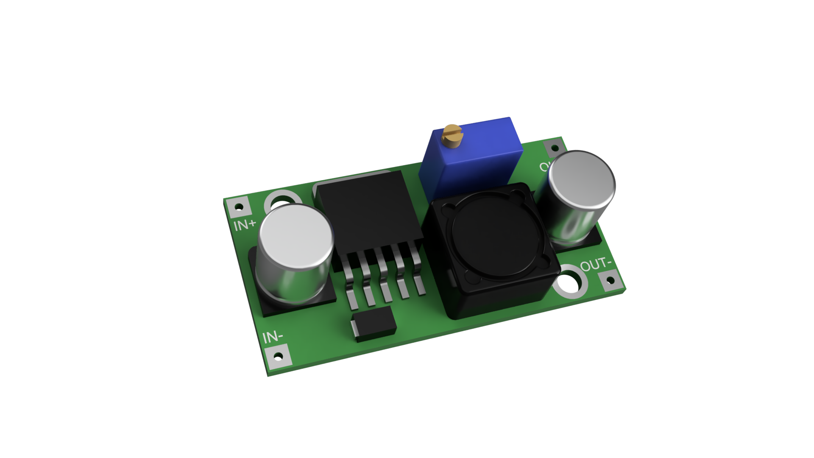
_02-realisation/_03-cao_3D/mesCreations/ressourcesExterieure/lm2596-dcdc-converter-1.snapshot.1/LM2596DCDC_2022-Jan-15_03-52-45AM-000_CustomizedView16761749139.png
