MajorLee95/tinyelab/_02-realisation/_03-cao_3D/mesCreations/ressourcesExterieure/ruthex-threaded-inserts-1.snapshot.7/Einschmelzhilfe2.jpg

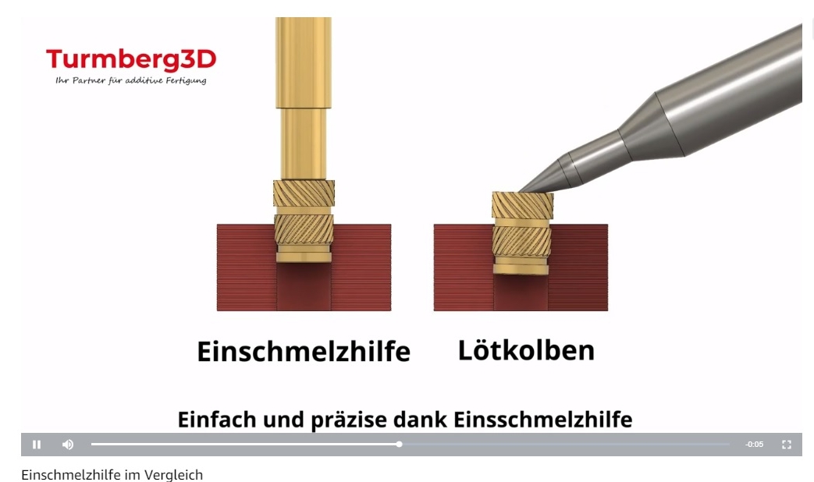
_02-realisation/_03-cao_3D/mesCreations/ressourcesExterieure/ruthex-threaded-inserts-1.snapshot.7/Einschmelzhilfe2.jpg
