MajorLee95/tinyelab/_02-realisation/_03-cao_3D/mesCreations/ressourcesExterieure/USB A Buchse THT.png

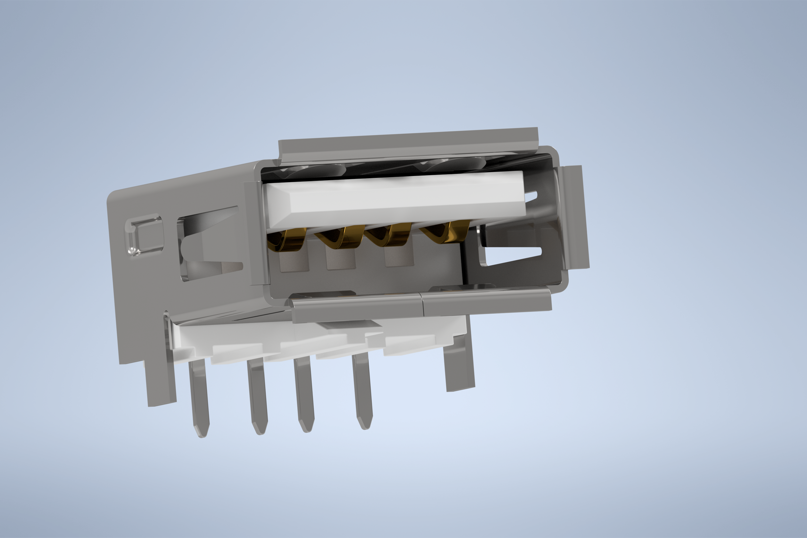
_02-realisation/_03-cao_3D/mesCreations/ressourcesExterieure/USB A Buchse THT.png
