MajorLee95/tinyelab/_02-realisation/_03-cao_3D/mesCreations/xt60Cover/dimensions01.JPG

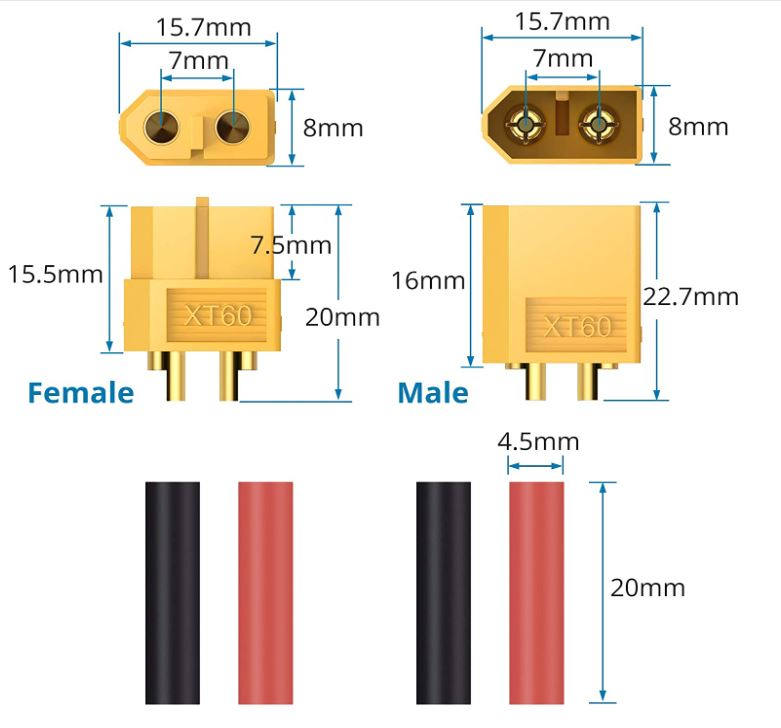
_02-realisation/_03-cao_3D/mesCreations/xt60Cover/dimensions01.JPG
