MajorLee95/tinyelab/_02-realisation/_03-cao_3D/Tiny E-lab Ts100 alternate stand - 5216290/images/0ae468b1-8282-4eaa-bc22-b20de4bd16aa.png

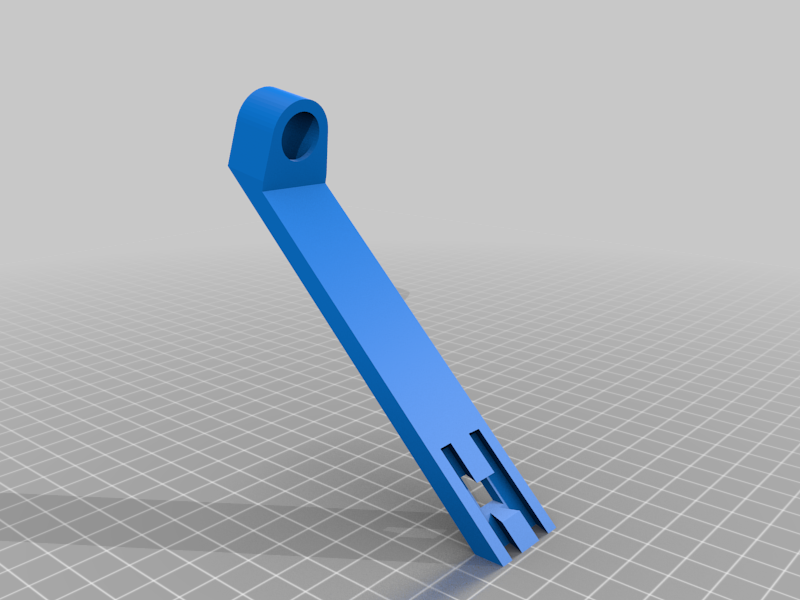
_02-realisation/_03-cao_3D/Tiny E-lab Ts100 alternate stand - 5216290/images/0ae468b1-8282-4eaa-bc22-b20de4bd16aa.png
