MajorLee95/tinyelab/_02-realisation/_03-cao_3D/Tiny E-lab Ts100 alternate stand - 5216290/images/69bdfa03-5bba-464f-b5e7-76bc203fd46e.png

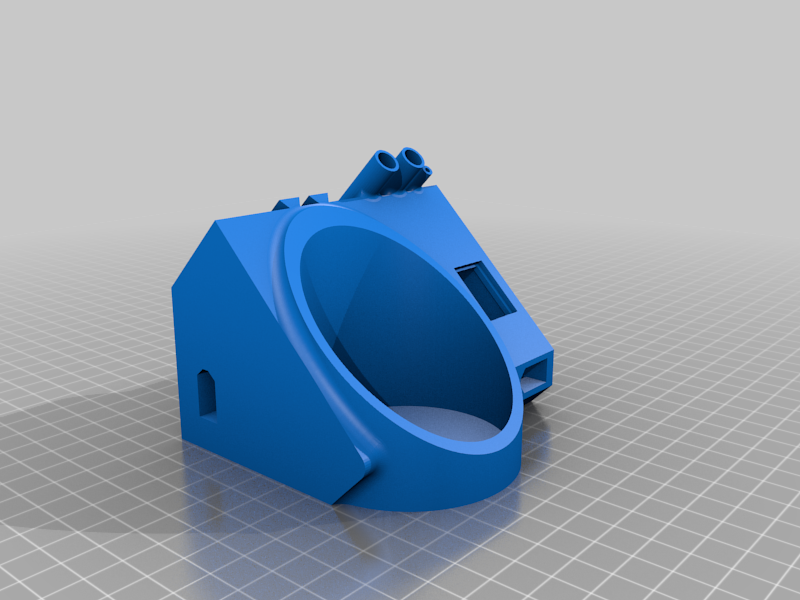
_02-realisation/_03-cao_3D/Tiny E-lab Ts100 alternate stand - 5216290/images/69bdfa03-5bba-464f-b5e7-76bc203fd46e.png
