MajorLee95/tinyelab/_03-wiki/photoDeFamille7ModPlus2.JPG

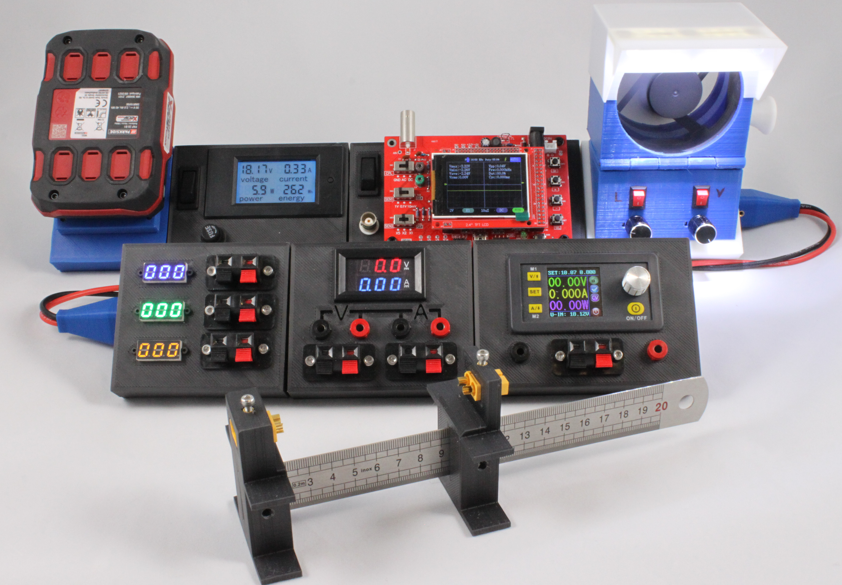
_03-wiki/photoDeFamille7ModPlus2.JPG
