MajorLee95/tinyelab/_03-wiki/TinyElab_photoDeFamille7ModPlus2_vignette.jpg

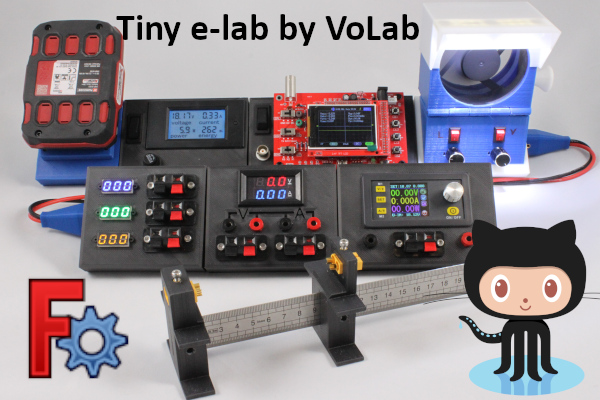
_03-wiki/TinyElab_photoDeFamille7ModPlus2_vignette.jpg
