MajorLee95/tinyelab/_03-wiki/vor_tinyelab_vignetteWiki2.jpg

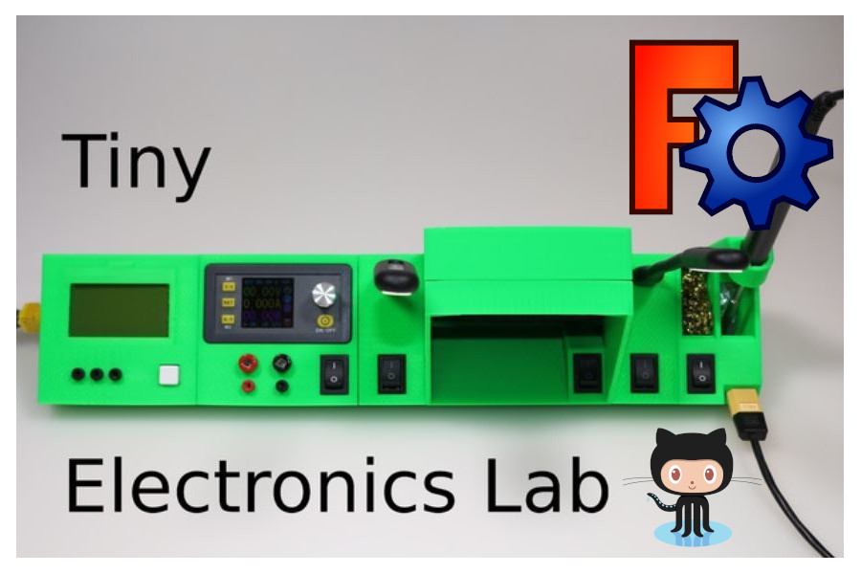
_03-wiki/vor_tinyelab_vignetteWiki2.jpg
