MajorLee95/tinyelab/_02-realisation/_03-cao_3D/mesCreations/moduleOscillo/nomOscillo.ods

Désignation | Fab | Ref fab | Qté | Pu | Pt
Insert Fileteté M3 | RUTHEX | sans | 6 | 0,10 € | 0,60 €
Switch | ARCOLECTRIC | C1500AT | 1 | 2,70 € | 2,7
VIS THC M3x6 | BRICOVIS | TC HC M3x6ANEF | 2 | 0,06 € | 0,12 €
VIS STHC M3x10 | BRICOVIS | STHC Pointeau M3X10ANEF | 2 | 0,08 € | 0,17 €
XT60 MALE | AMAZON |  | 1 | 0,60 € | 0,60 €
XT60 FEM | AMAZON |  | 1 | 0,60 € | 0,60 €
OSCILO | AMAZON | DSO138 | 1 | 27,00 € | 27,00 €
Tige Laiton diam 2mm | AMAZON | 2*133,62 | 2 | 0,70 € | 1,40 €
Entretoise NYLON M3x8 |  |  | 4
Vis Nylon M3x6 |  |  | 8
VIS THC M3x6 Nylon | AMAZON | TC HC M3x6ANYL | 2 | 0,21 € | 0,42 €
 |  |  |  | TOTAL | 33,61 €
