MajorLee95/tinyelab/_02-realisation/_03-cao_3D/mesCreations/ressourcesExterieure/ruthex-threaded-inserts-1.snapshot.7/ASM_RUTHEX.FCStd

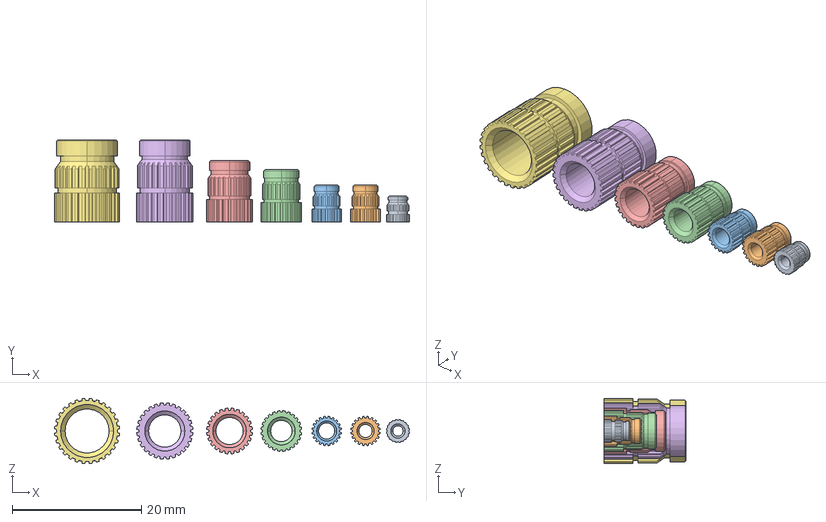
[picture p176: CAD file, 2022-04-17]
_02-realisation/_03-cao_3D/mesCreations/ressourcesExterieure/ruthex-threaded-inserts-1.snapshot.7/ASM_RUTHEX.FCStd
54.8 x 12.7 x 10.1 mm
RUTHEX_M2x4
RUTHEX_M2_5X5_7
RUTHEX_M3x5_7
RUTHEX_M4X8_1
RUTHEX_M5X9_5
RUTHEX_M6X12_7
RUTHEX_M8X12_7
