MajorLee95/tinyelab/_02-realisation/_03-cao_3D/mesCreations/moduleGenFonction/modelsExterieur/i2c-lcd-16-2-1.snapshot.6/Assembly V1.SLDASM

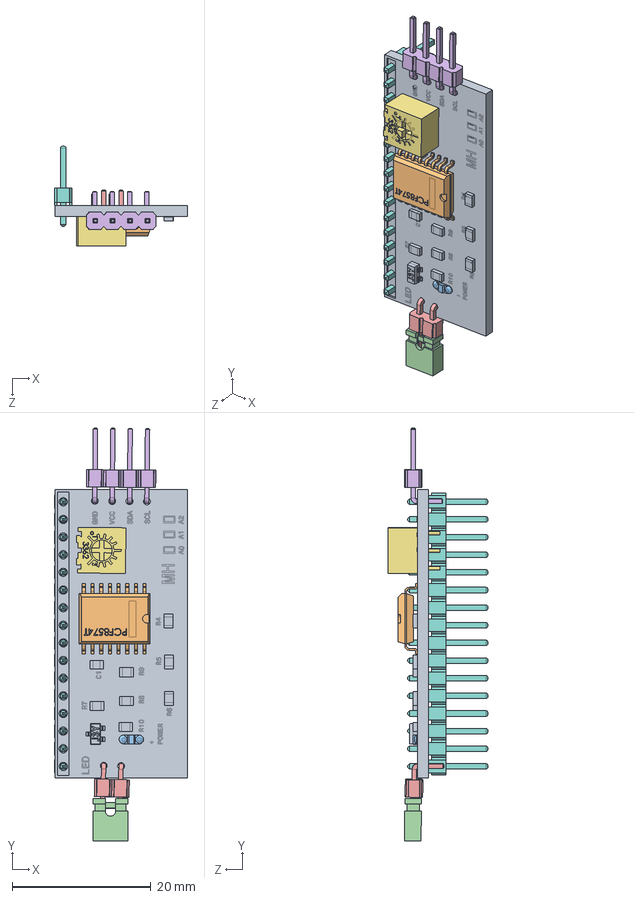
[picture p177: CAD file, 2022-04-20]
_02-realisation/_03-cao_3D/mesCreations/moduleGenFonction/modelsExterieur/i2c-lcd-16-2-1.snapshot.6/Assembly V1.SLDASM
19.2 x 59.5 x 14.3 mm
PAPAN
IC I2C
LED
ojumper 2 pin
Pin Header 2 Bengkok
Pin Header 4 Bengkok
POTENSIO
16 pin header
