MajorLee95/tinyelab/_02-realisation/_02-hardware/usb5v3a_v2_pcb/3dmodels/arduino nano.STEP

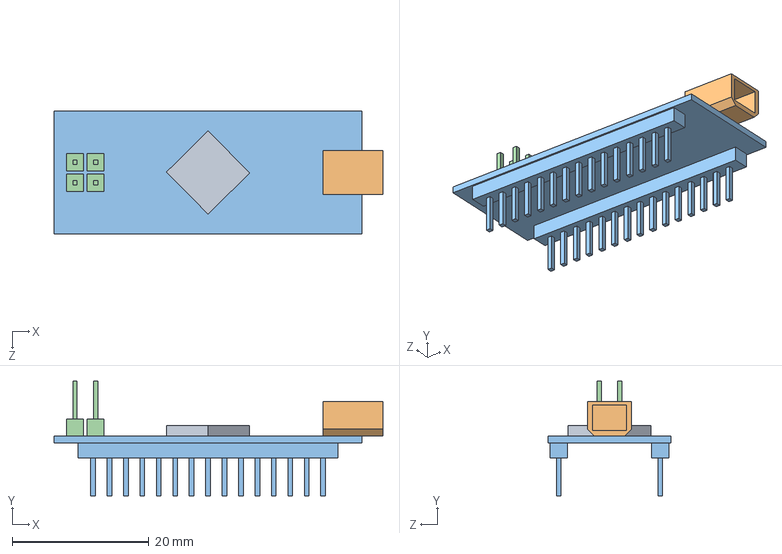
[picture p178: CAD file, 2022-09-10]
_02-realisation/_02-hardware/usb5v3a_v2_pcb/3dmodels/arduino nano.STEP
48.0 x 16.8 x 18.0 mm
