MajorLee95/tinyelab/_02-realisation/_02-hardware/ventilo/ventilo/ventilo.step

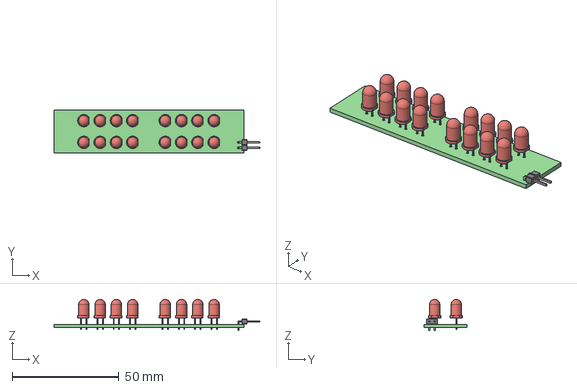
[picture p179: CAD file, 2022-06-22]
_02-realisation/_02-hardware/ventilo/ventilo/ventilo.step
96.4 x 20.3 x 14.6 mm
_autosave-ventilo PCB
