MajorLee95/tinyelab/_02-realisation/_03-cao_3D/mesCreations/amperemetreAnalog/ampAnalog_003_surBase35mm_008.1.FCStd

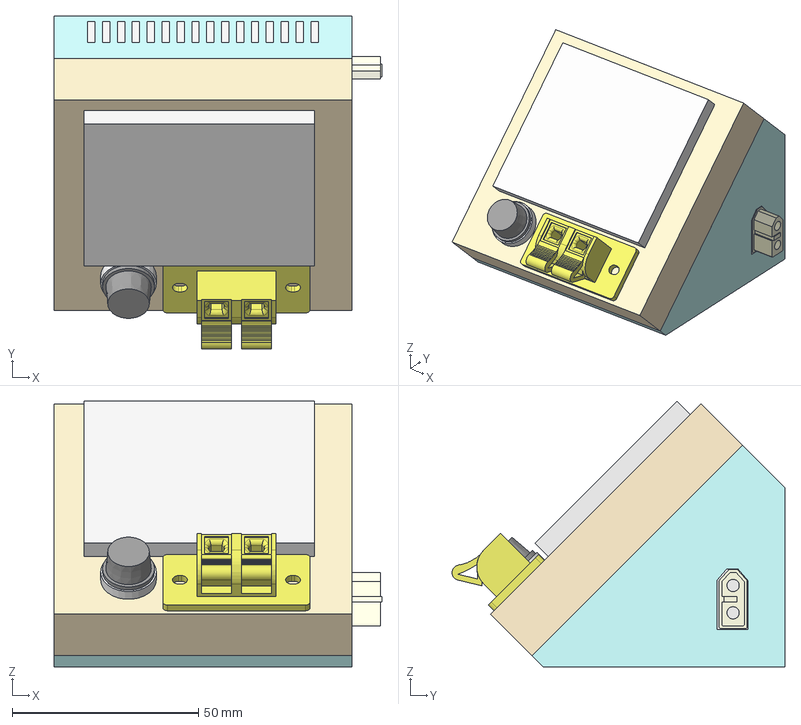
[picture p180: CAD file, 2022-04-24]
_02-realisation/_03-cao_3D/mesCreations/amperemetreAnalog/ampAnalog_003_surBase35mm_008.1.FCStd
88.1 x 89.5 x 71.4 mm
Base
base
faceAvant
XT60FemaleConnector
XT60MaleConnector
RUTHEX_M3x5_7
RUTHEX_M3x5_008
RUTHEX_M3x5_009
RUTHEX_M3x5_010
bodyVisPointeauM3x10_001
bodyVisPointeauM3x10_002
tigeLaiton
tige2
visTHCM3x6_FAV001
visTHCM3x6_FAV002
Scale
corps002
bouchon
cosse1
cosse002
