MajorLee95/tinyelab/_02-realisation/_03-cao_3D/mesCreations/elementsCommun/dcjack5521/dc5521_002.FCStd

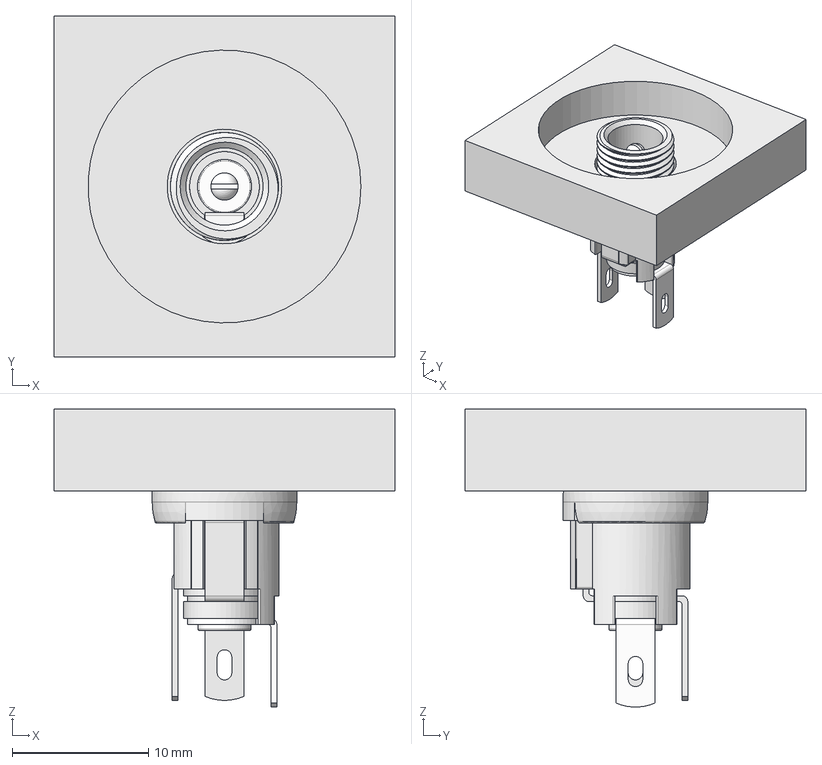
[picture p181: CAD file, 2022-08-03]
_02-realisation/_03-cao_3D/mesCreations/elementsCommun/dcjack5521/dc5521_002.FCStd
25.0 x 25.0 x 21.8 mm
Casing
insulators
Positive Center
Negative parts
epreuveBdy
