MajorLee95/tinyelab/_02-realisation/_03-cao_3D/mesCreations/elementsCommun/entretoiseM3x8.FCStd

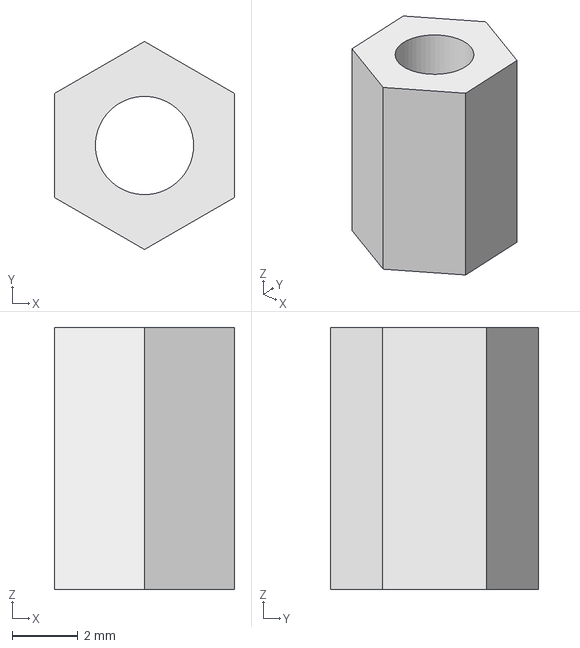
[picture p183: CAD file, 2022-11-23]
_02-realisation/_03-cao_3D/mesCreations/elementsCommun/entretoiseM3x8.FCStd
5.50 x 6.35 x 8.00 mm
