MajorLee95/tinyelab/_02-realisation/_03-cao_3D/mesCreations/lidlParckSideBat/moduleLidl_002_surBase35mm_009.1.FCStd

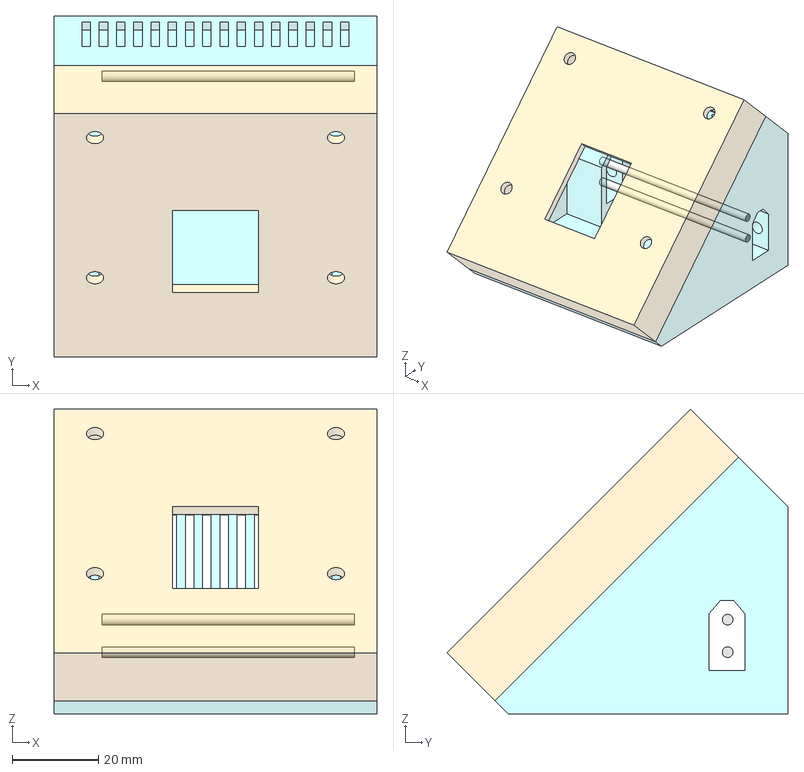
[picture p184: CAD file, 2022-08-15]
_02-realisation/_03-cao_3D/mesCreations/lidlParckSideBat/moduleLidl_002_surBase35mm_009.1.FCStd
75.0 x 79.1 x 70.7 mm
base
faceAvant
tigeLaiton
tige2
