MajorLee95/tinyelab/_02-realisation/_03-cao_3D/mesCreations/moduleAlimMultiples/alimMultiple_001_SurBase35mm_009.1.FCStd

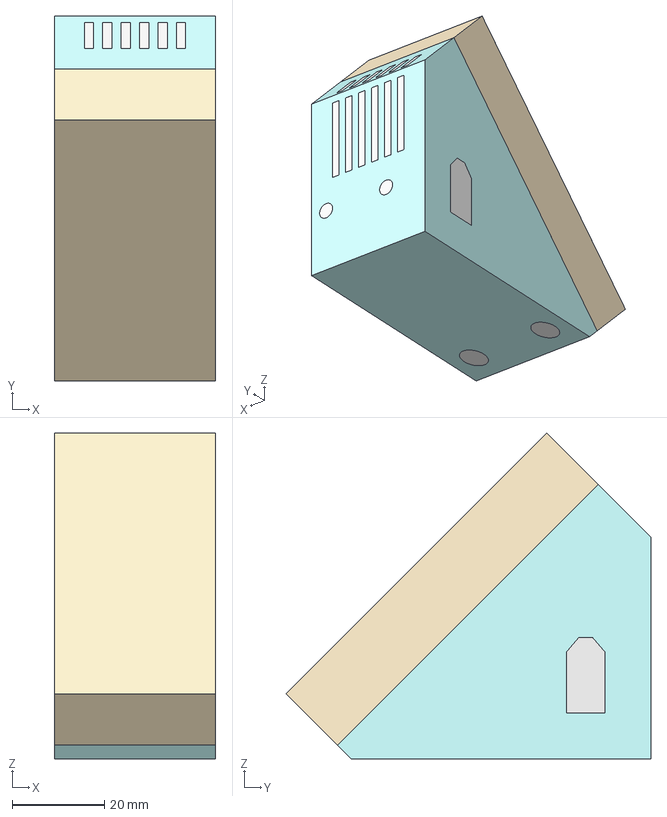
[picture p185: CAD file, 2022-08-10]
_02-realisation/_03-cao_3D/mesCreations/moduleAlimMultiples/alimMultiple_001_SurBase35mm_009.1.FCStd
35.0 x 79.1 x 70.7 mm
Base
base
faceAvant
tigeLaiton
tige2
