MajorLee95/tinyelab/_02-realisation/_03-cao_3D/mesCreations/moduleAlimStabDPS3005/alimStab_014_surBase35mm_007.3.FCStd

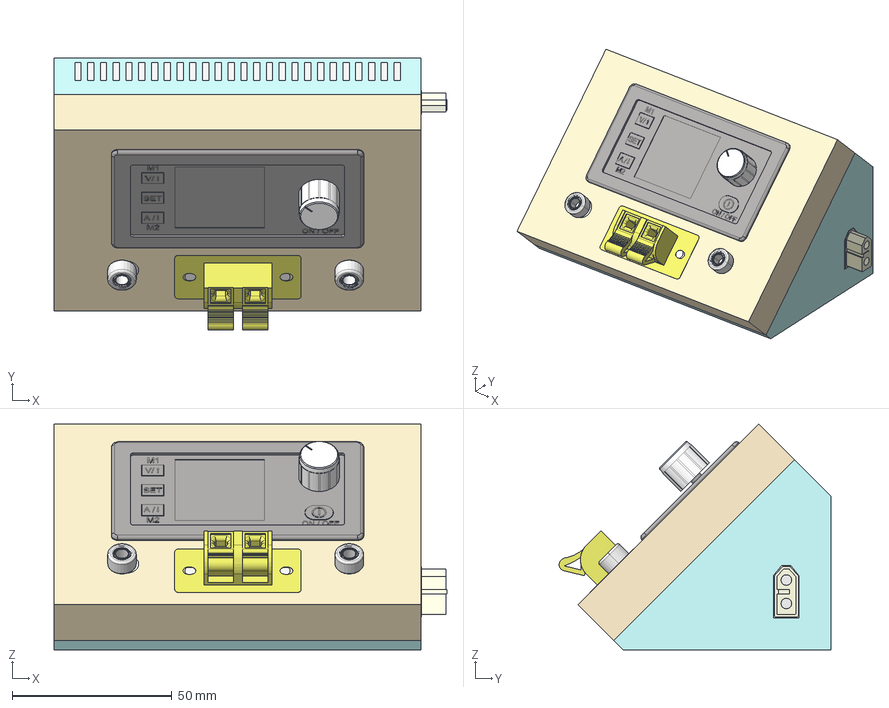
[picture p186: CAD file, 2022-04-17]
_02-realisation/_03-cao_3D/mesCreations/moduleAlimStabDPS3005/alimStab_014_surBase35mm_007.3.FCStd
123.1 x 85.1 x 70.7 mm
Base
base
faceAvant
XT60FemaleConnector
XT60MaleConnector
RUTHEX_M3x5_7
RUTHEX_M3x5_008
RUTHEX_M3x5_009
RUTHEX_M3x5_010
visTHCM3x10_001
visTHCM3x10_002
bodyVisPointeauM3x10_001
bodyVisPointeauM3x10_002
tigeLaiton
tige2
zoneInterdite
Scale
4mm Banana Socket
4mm Banana Socket001
