MajorLee95/tinyelab/_02-realisation/_03-cao_3D/mesCreations/moduleAlimStabDPS3005/export/favDPS3005.stl

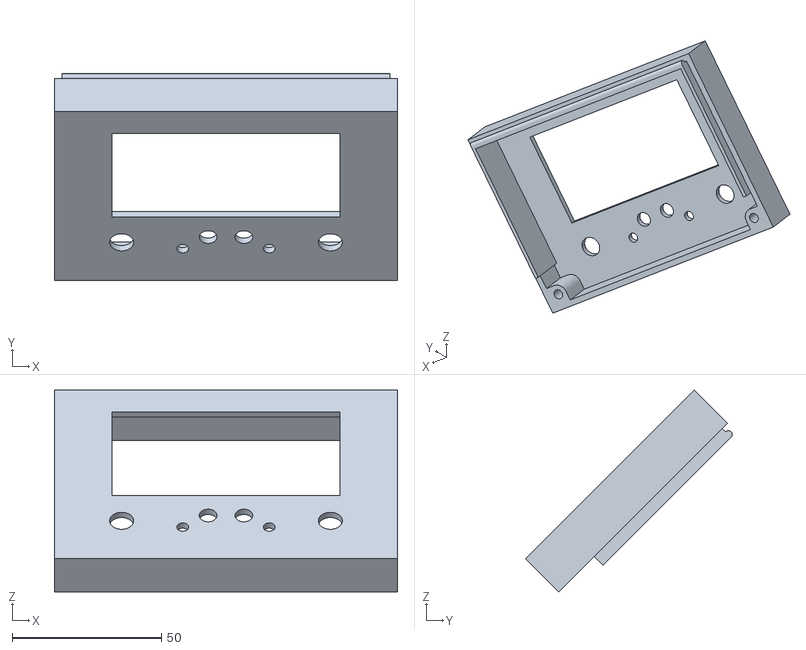
[picture p187: CAD file, 2022-04-17]
_02-realisation/_03-cao_3D/mesCreations/moduleAlimStabDPS3005/export/favDPS3005.stl
115.0 x 69.3 x 67.7
