MajorLee95/tinyelab/_02-realisation/_03-cao_3D/mesCreations/moduleAlimStabDPS3005/modelExternes/borne-de-haut-parleur-2-voies-1.snapshot.3/Borne de haut parleur femelle 2 voies.STEP

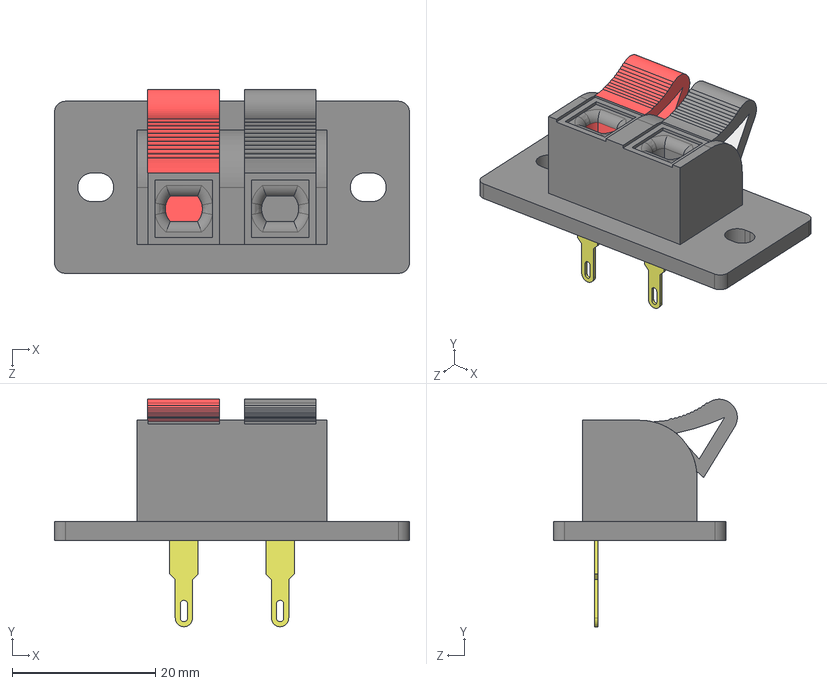
[picture p188: CAD file, 2022-04-17]
_02-realisation/_03-cao_3D/mesCreations/moduleAlimStabDPS3005/modelExternes/borne-de-haut-parleur-2-voies-1.snapshot.3/Borne de haut parleur femelle 2 voies.STEP
49.5 x 31.7 x 25.6 mm
