MajorLee95/tinyelab/_02-realisation/_03-cao_3D/mesCreations/moduleAlimStabDPS3005/modelExternes/dps-5015-display-1.snapshot.11/Dps5015 board v2.step

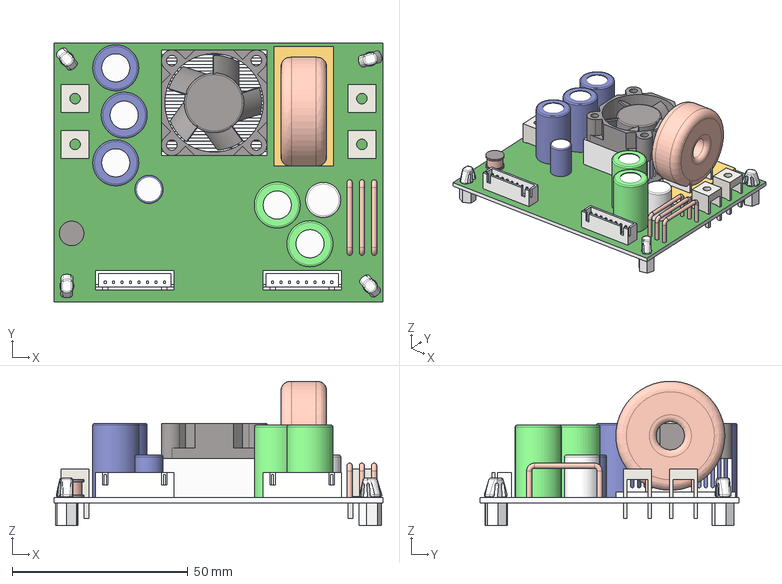
[picture p189: CAD file, 2022-04-17]
_02-realisation/_03-cao_3D/mesCreations/moduleAlimStabDPS3005/modelExternes/dps-5015-display-1.snapshot.11/Dps5015 board v2.step
93.5 x 73.6 x 41.0 mm
stik 8 ben
stik 8 ben v2(Mirror)
