MajorLee95/tinyelab/_02-realisation/_03-cao_3D/mesCreations/moduleAlimStabDPS3005/modelExternes/dps-5015_001.FCStd

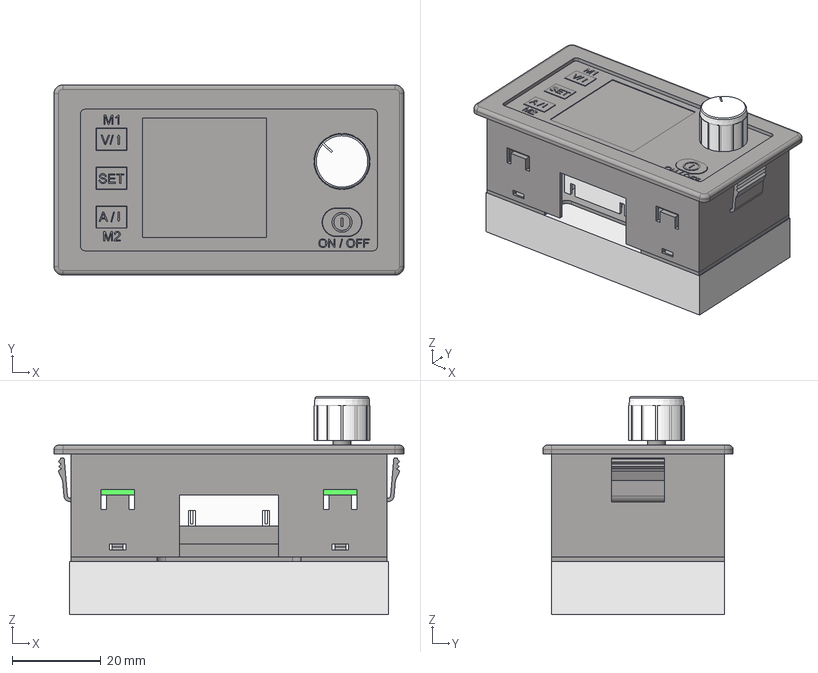
[picture p190: CAD file, 2022-04-17]
_02-realisation/_03-cao_3D/mesCreations/moduleAlimStabDPS3005/modelExternes/dps-5015_001.FCStd
79.1 x 43.0 x 49.3 mm
zoneInterdite
