MajorLee95/tinyelab/_02-realisation/_03-cao_3D/mesCreations/moduleGenFonction/ecranLCD20x4I2C.FCStd

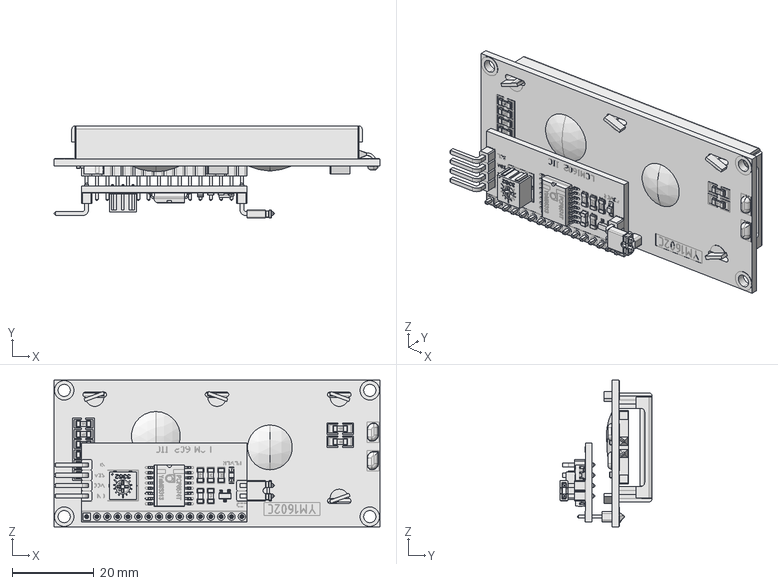
[picture p191: CAD file, 2022-04-20]
_02-realisation/_03-cao_3D/mesCreations/moduleGenFonction/ecranLCD20x4I2C.FCStd
80.0 x 22.6 x 36.0 mm
