MajorLee95/tinyelab/_02-realisation/_03-cao_3D/mesCreations/moduleGenFonction/modelsExterieur/Arduino Nano/nano board.SLDPRT

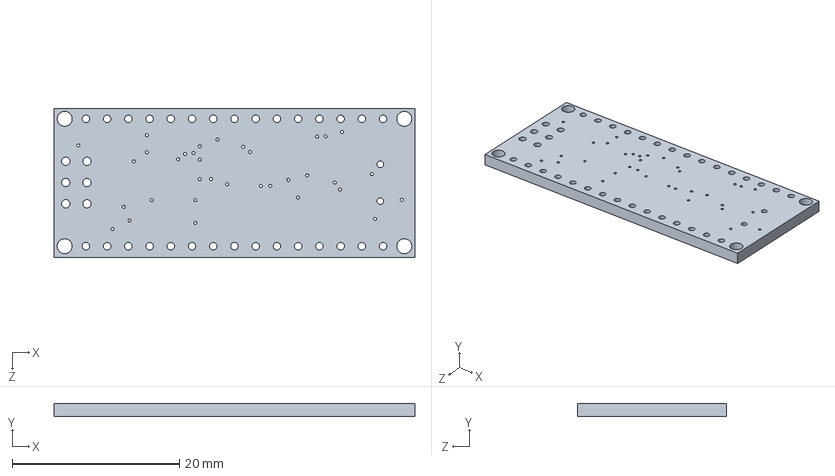
[picture p192: CAD file, 2022-04-20]
_02-realisation/_03-cao_3D/mesCreations/moduleGenFonction/modelsExterieur/Arduino Nano/nano board.SLDPRT
43.2 x 1.60 x 17.8 mm
