MajorLee95/tinyelab/_02-realisation/_03-cao_3D/mesCreations/moduleGenFonction/modelsExterieur/i2c-lcd-1.snapshot.1/ecranLCD.FCStd

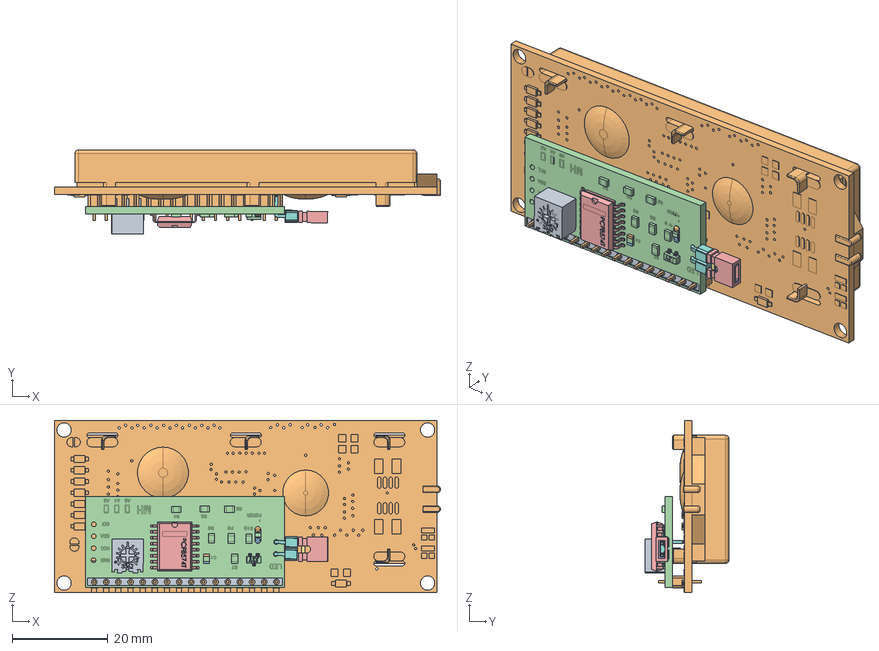
[picture p193: CAD file, 2022-04-20]
_02-realisation/_03-cao_3D/mesCreations/moduleGenFonction/modelsExterieur/i2c-lcd-1.snapshot.1/ecranLCD.FCStd
80.7 x 17.6 x 36.0 mm
