MajorLee95/tinyelab/_02-realisation/_03-cao_3D/mesCreations/moduleGenFonction/modelsExterieur/LCD with I2C/ecranLDC_001.FCStd

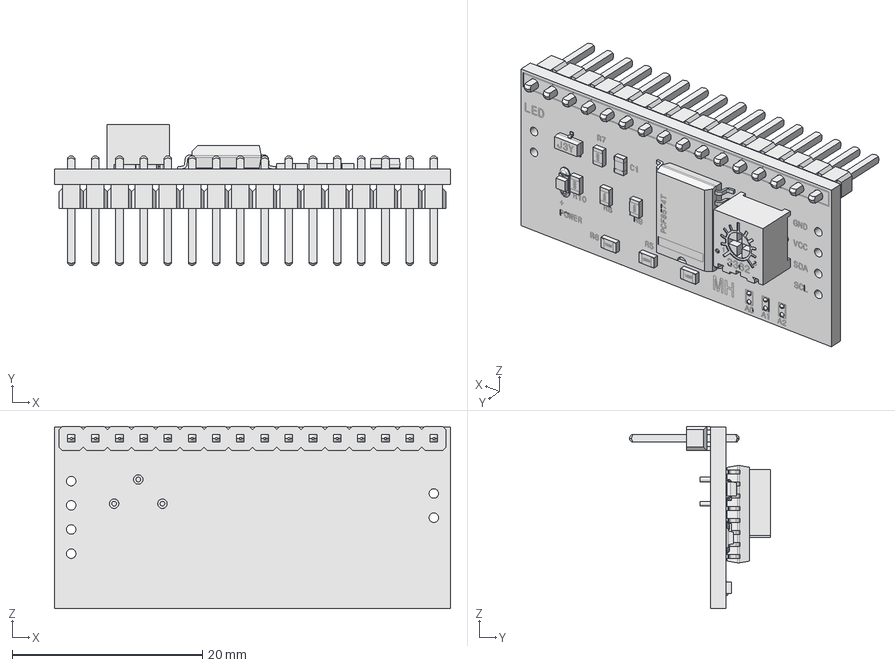
[picture p195: CAD file, 2022-04-20]
_02-realisation/_03-cao_3D/mesCreations/moduleGenFonction/modelsExterieur/LCD with I2C/ecranLDC_001.FCStd
41.6 x 14.8 x 19.2 mm
