MajorLee95/tinyelab/_02-realisation/_03-cao_3D/mesCreations/moduleOscillo/export/favOscillo_009_2.stl

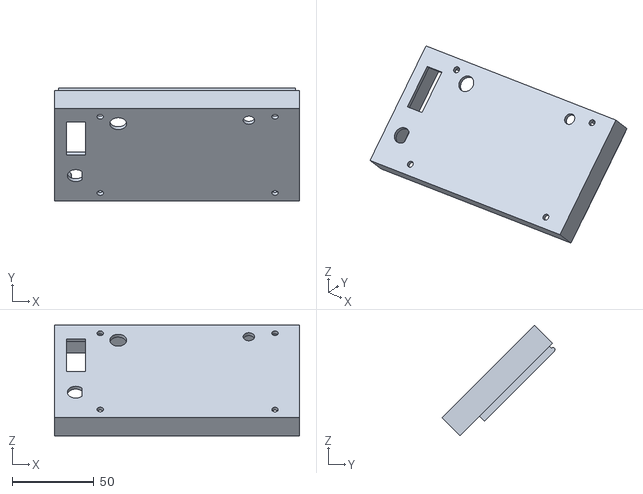
[picture p196: CAD file, 2022-04-29]
_02-realisation/_03-cao_3D/mesCreations/moduleOscillo/export/favOscillo_009_2.stl
150.0 x 69.3 x 67.7
