MajorLee95/tinyelab/_02-realisation/_03-cao_3D/mesCreations/moduleOscillo/oscillo_010_surBase35mm_007.5.FCStd

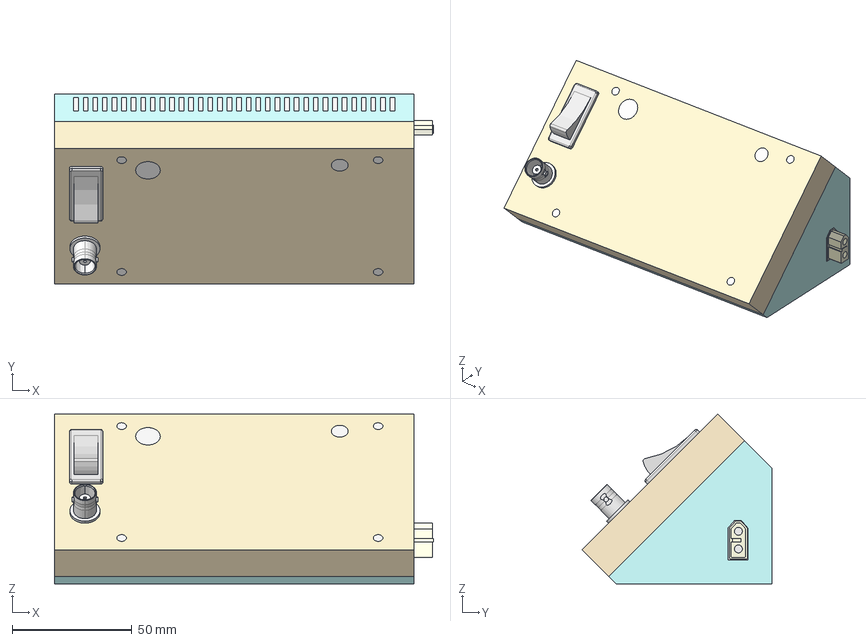
[picture p197: CAD file, 2022-11-23]
_02-realisation/_03-cao_3D/mesCreations/moduleOscillo/oscillo_010_surBase35mm_007.5.FCStd
158.1 x 79.1 x 70.7 mm
Base
base
faceAvant
XT60FemaleConnector
XT60MaleConnector
RUTHEX_M3x5_7
RUTHEX_M3x5_008
RUTHEX_M3x5_009
RUTHEX_M3x5_010
visTHCM3x10_001
visTHCM3x10_002
bodyVisPointeauM3x10_001
bodyVisPointeauM3x10_002
tigeLaiton
tige2
BNCEmbaseStep
visTHCM3x6_FAV001
visTHCM3x6_FAV002
LM2596DCDC v005
RUTHEX_M3x5_011
RUTHEX_M3x5_012
visTHCM3x6_DCDC001
visTHCM3x6_DCDC002
switch v1
