MajorLee95/tinyelab/_02-realisation/_03-cao_3D/mesCreations/moduleUI/exports/moduleUI_017base.3mf

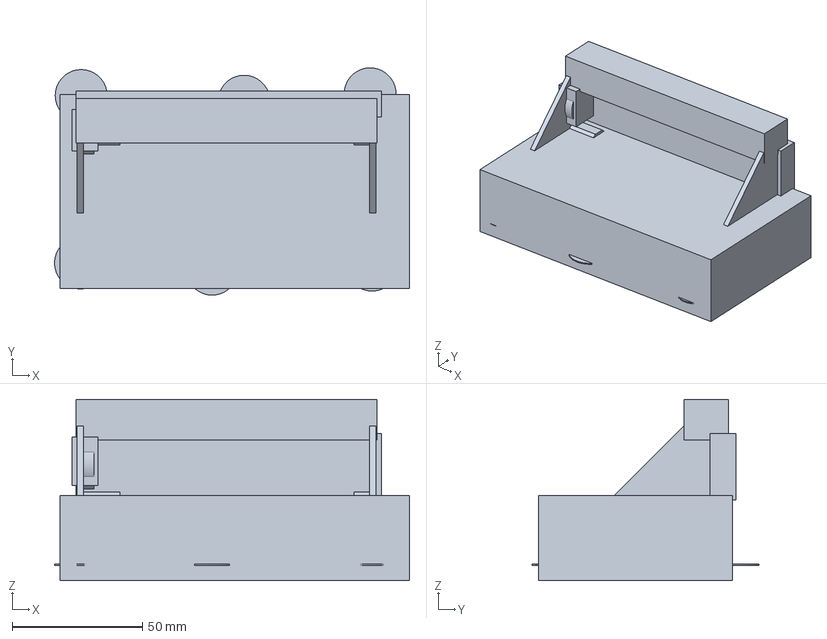
[picture p198: CAD file, 2022-08-03]
_02-realisation/_03-cao_3D/mesCreations/moduleUI/exports/moduleUI_017base.3mf
136.5 x 87.4 x 69.7 mm
