MajorLee95/tinyelab/_02-realisation/_03-cao_3D/mesCreations/moduleUI/moduleUI_017_Sur_base35mm_007.5.FCStd

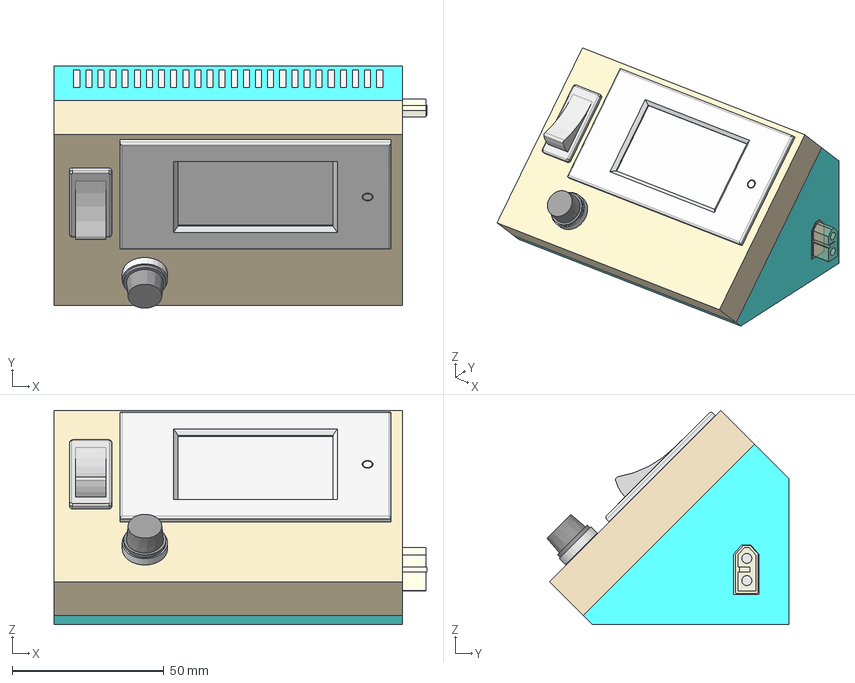
[picture p199: CAD file, 2022-08-03]
_02-realisation/_03-cao_3D/mesCreations/moduleUI/moduleUI_017_Sur_base35mm_007.5.FCStd
123.1 x 79.9 x 70.7 mm
Base
base
faceAvant
XT60FemaleConnector
XT60MaleConnector
RUTHEX_M3x5_7
RUTHEX_M3x5_008
RUTHEX_M3x5_009
RUTHEX_M3x5_010
visTHCM3x10_001
visTHCM3x10_002
bodyVisPointeauM3x10_001
bodyVisPointeauM3x10_002
tigeLaiton
tige2
switch v1
corps002
bouchon
cosse1
cosse002
