MajorLee95/tinyelab/_02-realisation/_03-cao_3D/mesCreations/moduleUSB3A/exports/v2_022/ASX1_moduleUSB3A_022_fav.3mf

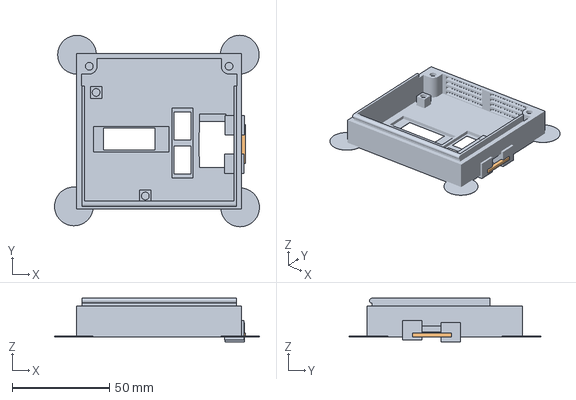
[picture p200: CAD file, 2022-09-10]
_02-realisation/_03-cao_3D/mesCreations/moduleUSB3A/exports/v2_022/ASX1_moduleUSB3A_022_fav.3mf
105.6 x 98.7 x 22.5 mm
moduleUSB3A_022_fav.stl
