MajorLee95/tinyelab/_02-realisation/_03-cao_3D/mesCreations/moduleUSB3A/modelsExterns/trimPot/trimPot001.FCStd

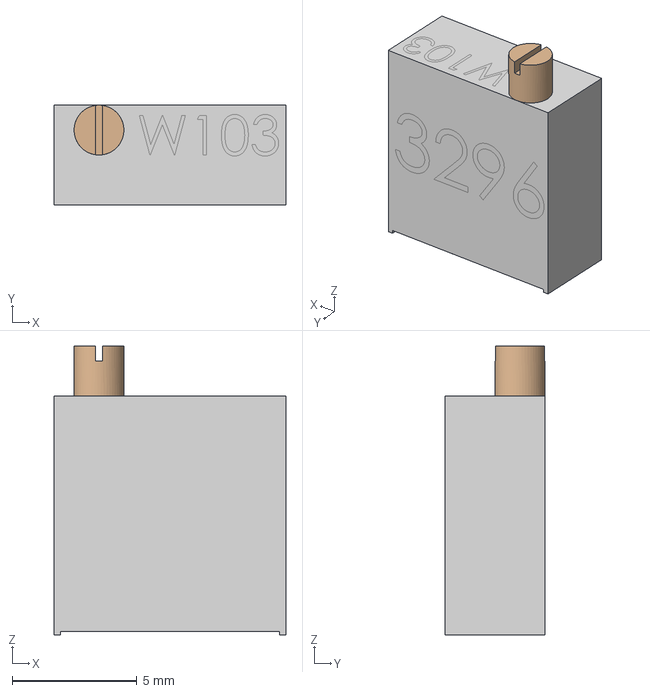
[picture p201: CAD file, 2022-09-10]
_02-realisation/_03-cao_3D/mesCreations/moduleUSB3A/modelsExterns/trimPot/trimPot001.FCStd
9.30 x 4.00 x 11.6 mm
trimPotBody
trimPot_vis
