MajorLee95/tinyelab/_02-realisation/_03-cao_3D/mesCreations/moduleUSB3A/modelsExterns/XL4015DCDC_002.FCStd

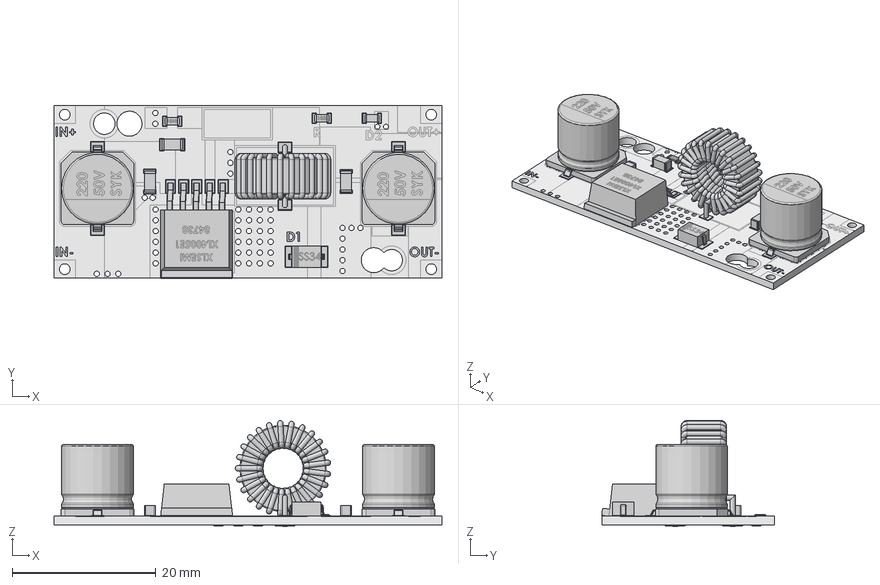
[picture p202: CAD file, 2022-10-22]
_02-realisation/_03-cao_3D/mesCreations/moduleUSB3A/modelsExterns/XL4015DCDC_002.FCStd
54.0 x 24.0 x 14.8 mm
bob
220uF_001
220uF_002
