MajorLee95/tinyelab/_02-realisation/_03-cao_3D/mesCreations/moduleUSB3A/moduleUSB3A_024_SurBase35mm_012.FCStd

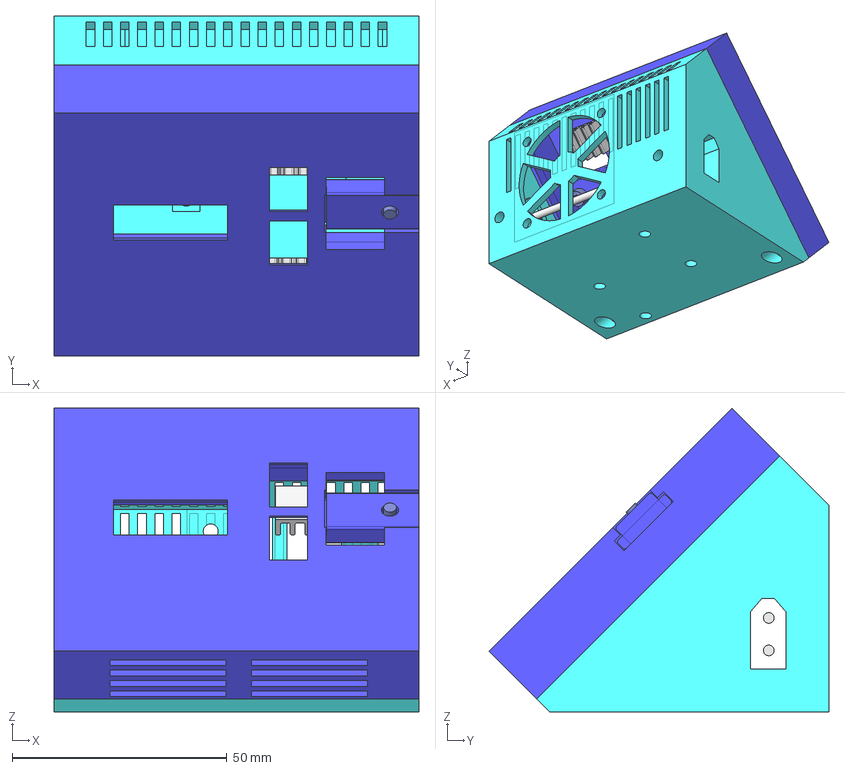
[picture p203: CAD file, 2022-10-22]
_02-realisation/_03-cao_3D/mesCreations/moduleUSB3A/moduleUSB3A_024_SurBase35mm_012.FCStd
85.0 x 79.1 x 70.7 mm
base
faceAvant
tigeLaiton
tige2
languetteFavBdy
visTHCM3x6_FAV001
dissipBdy
dissipBdy001
dissipBdy002
dissipBdy004
dissipBdy005
