MajorLee95/tinyelab/_02-realisation/_03-cao_3D/mesCreations/moduleUSB5V2ASimple2voies/99_corbeille/moduleUSB_IP6505_QC3.FCStd

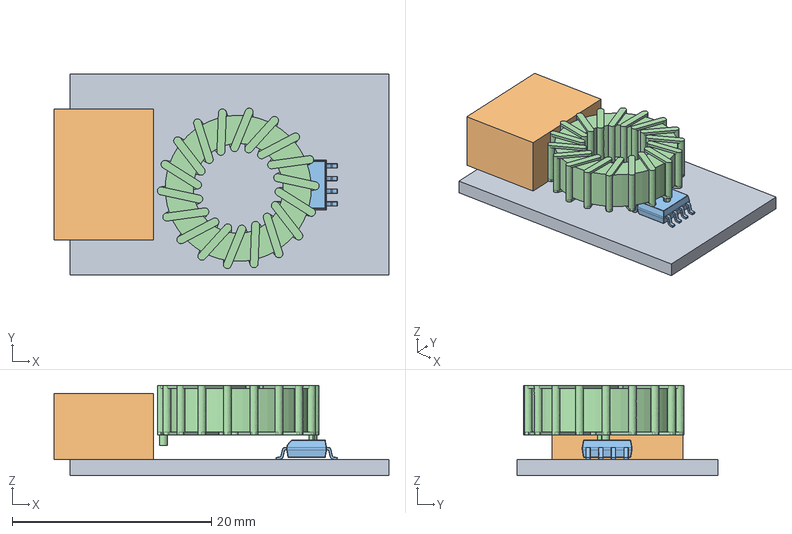
[picture p204: CAD file, 2022-10-08]
_02-realisation/_03-cao_3D/mesCreations/moduleUSB5V2ASimple2voies/99_corbeille/moduleUSB_IP6505_QC3.FCStd
33.6 x 20.2 x 9.03 mm
boardBdy
Document
2301-H-RC v002
