MajorLee95/tinyelab/_02-realisation/_03-cao_3D/mesCreations/moduleUSB5V2ASimple2voies/exports/bride-brideBody.stl

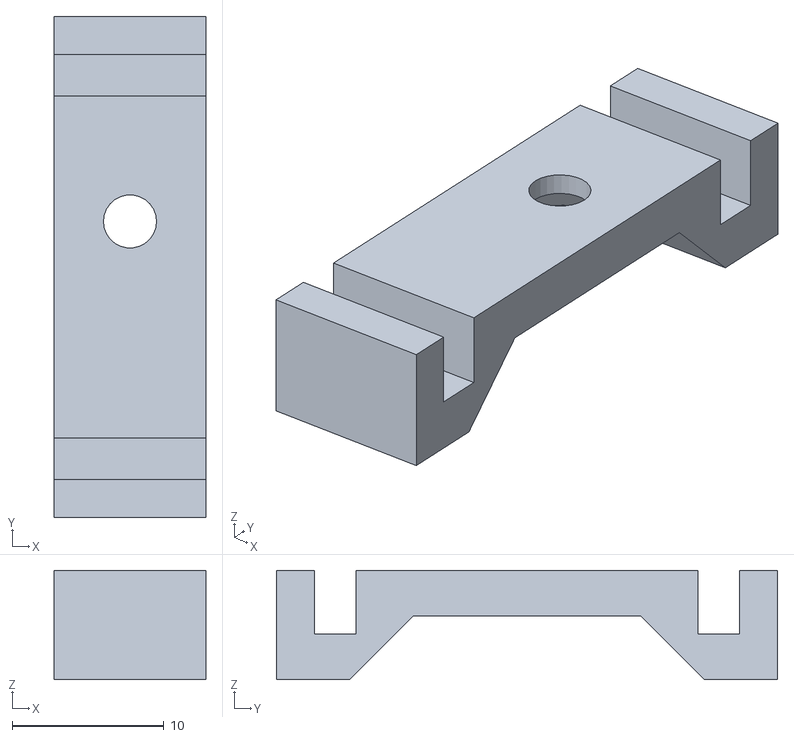
[picture p205: CAD file, 2024-03-21]
_02-realisation/_03-cao_3D/mesCreations/moduleUSB5V2ASimple2voies/exports/bride-brideBody.stl
10.0 x 33.0 x 7.20
