MajorLee95/tinyelab/_02-realisation/_03-cao_3D/mesCreations/moduleUSB5V2ASimple2voies/modelsExternes/2301-h-rc-1.snapshot.2/BOU_2301_RC.step

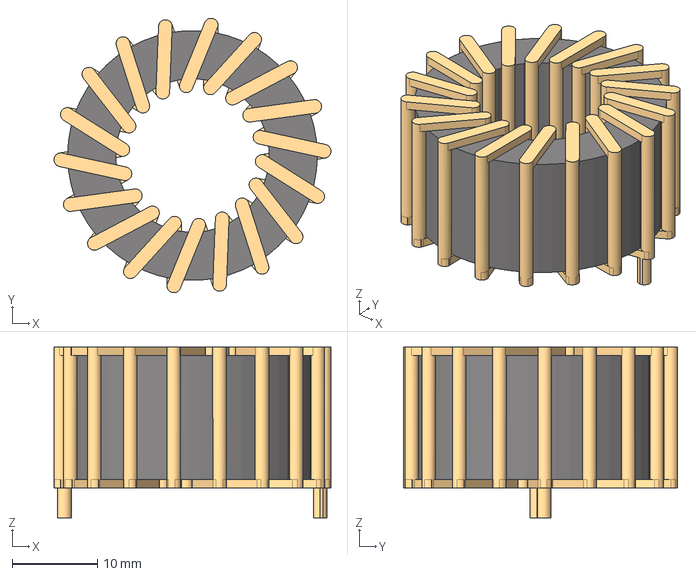
[picture p206: CAD file, 2022-10-08]
_02-realisation/_03-cao_3D/mesCreations/moduleUSB5V2ASimple2voies/modelsExternes/2301-h-rc-1.snapshot.2/BOU_2301_RC.step
32.5 x 32.2 x 20.0 mm
