MajorLee95/tinyelab/_02-realisation/_03-cao_3D/mesCreations/moduleUSB5V2ASimple2voies/switch15x10_003_0.FCStd

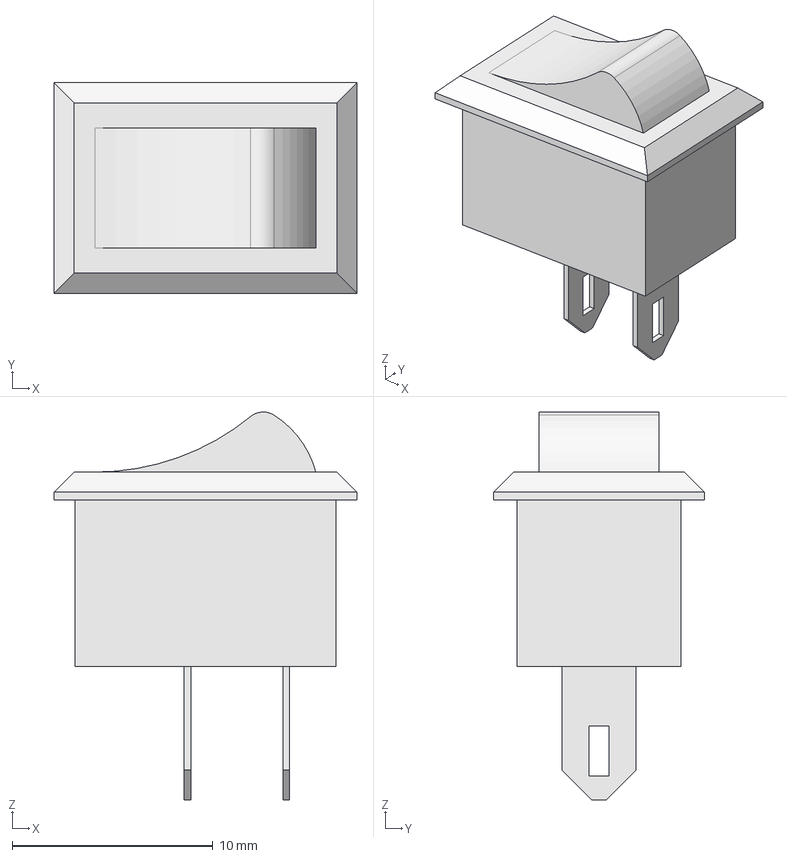
[picture p208: CAD file, 2024-03-21]
_02-realisation/_03-cao_3D/mesCreations/moduleUSB5V2ASimple2voies/switch15x10_003_0.FCStd
15.1 x 10.5 x 19.3 mm
