MajorLee95/tinyelab/_02-realisation/_03-cao_3D/mesCreations/moduleUSBC_QC3/moduleUSBCharge.FCStd

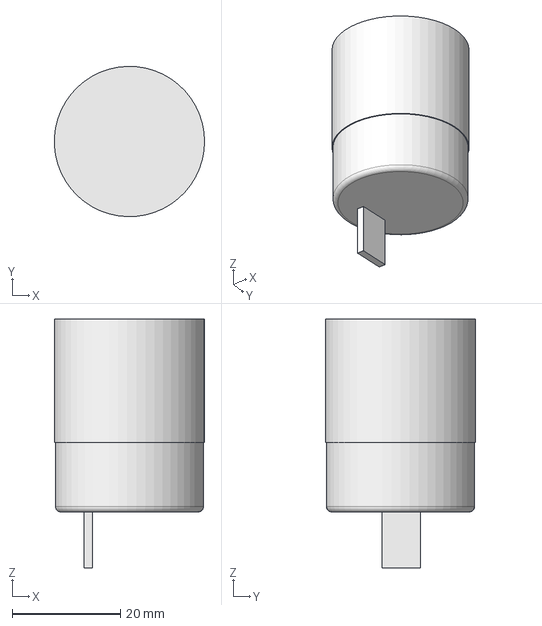
[picture p209: CAD file, 2022-07-13]
_02-realisation/_03-cao_3D/mesCreations/moduleUSBC_QC3/moduleUSBCharge.FCStd
27.8 x 27.8 x 46.1 mm
