MajorLee95/tinyelab/_02-realisation/_03-cao_3D/mesCreations/moduleUSBsimpleDouble/exports/fav006.4.004.3mf

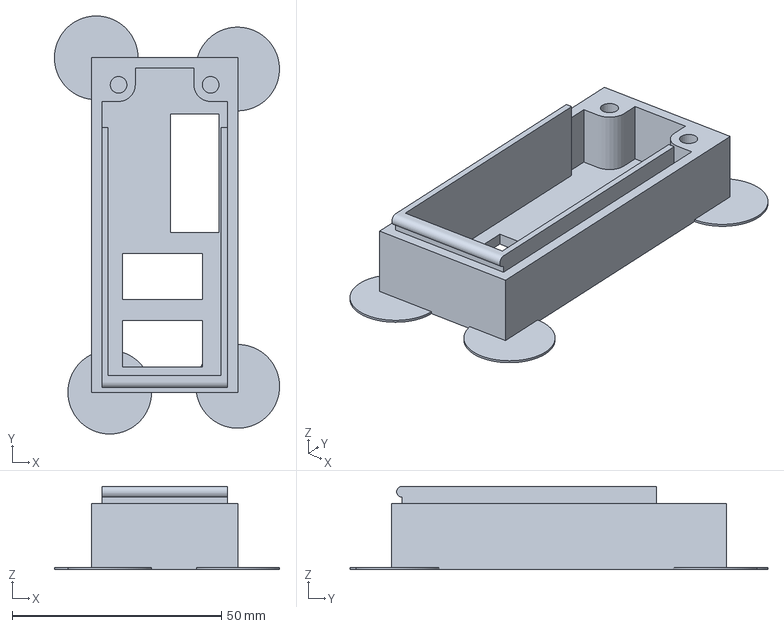
[picture p210: CAD file, 2022-04-17]
_02-realisation/_03-cao_3D/mesCreations/moduleUSBsimpleDouble/exports/fav006.4.004.3mf
53.8 x 99.9 x 19.9 mm
