MajorLee95/tinyelab/_02-realisation/_03-cao_3D/mesCreations/moduleUSBsimpleDouble/exports/v2_009/ASX1_epreuvedcdc_009.3mf

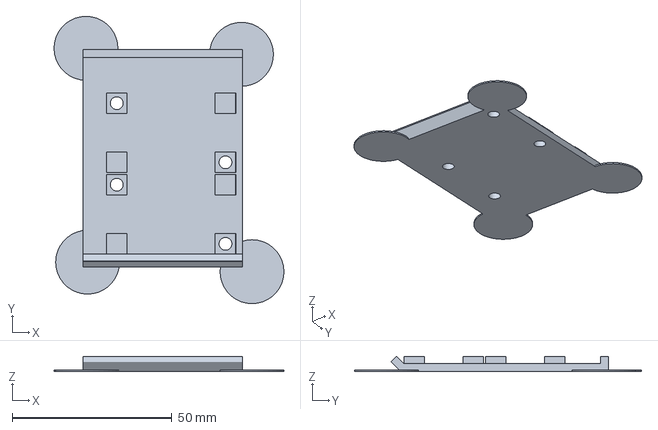
[picture p211: CAD file, 2022-09-10]
_02-realisation/_03-cao_3D/mesCreations/moduleUSBsimpleDouble/exports/v2_009/ASX1_epreuvedcdc_009.3mf
72.0 x 89.9 x 4.70 mm
