MajorLee95/tinyelab/_02-realisation/_03-cao_3D/mesCreations/moduleUSBsimpleDouble/modelsExterns/arduinoNano_001.FCStd

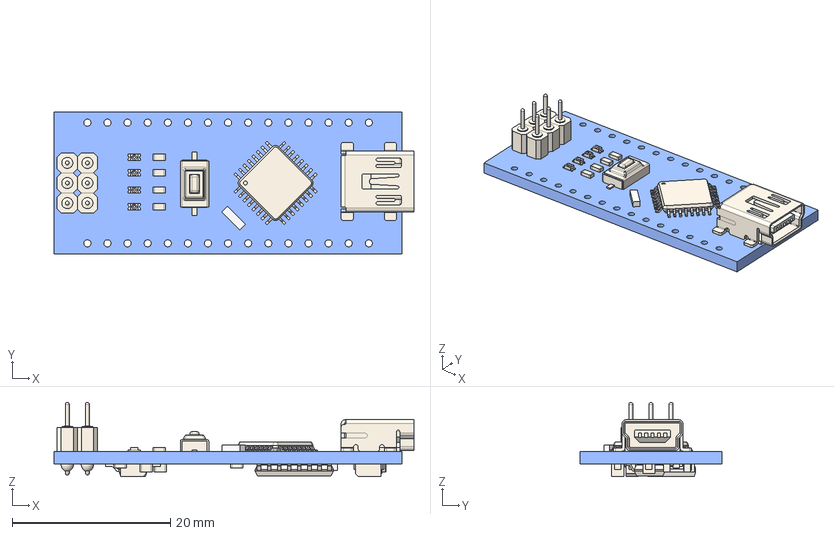
[picture p212: CAD file, 2022-09-10]
_02-realisation/_03-cao_3D/mesCreations/moduleUSBsimpleDouble/modelsExterns/arduinoNano_001.FCStd
45.5 x 18.0 x 9.40 mm
USB Mini Connector_001
TQFP 32 Lead_001
0603 Resistor_001
0603 Resistor_002
0603 Resistor_003
0603 Resistor_004
SM LED_001
SM LED_002
SM LED_003
SM LED_004
Crystal_001
SM Tac Switch_001
0603 Capacitor_001
0603 Resistor_005
Crystal_002
SOP-16L_001
0603 Capacitor_002
0603 Capacitor_003
0603 Capacitor_004
0603 Capacitor_005
0603 Resistor_006
0603 Resistor_007
Diode 2_001
1206 Tantalum Capacitor_001
1206 Tantalum Capacitor_002
ASM1117_001
1x3 Male Header_001
1x3 Male Header_002
