MajorLee95/tinyelab/_02-realisation/_03-cao_3D/mesCreations/moduleVentilo/modelExternes/80mm-brushless-fan-sunon-kde1208ptb2-1.snapshot.8/80mm brushless fan (SUNON KDE1208PTB2).step

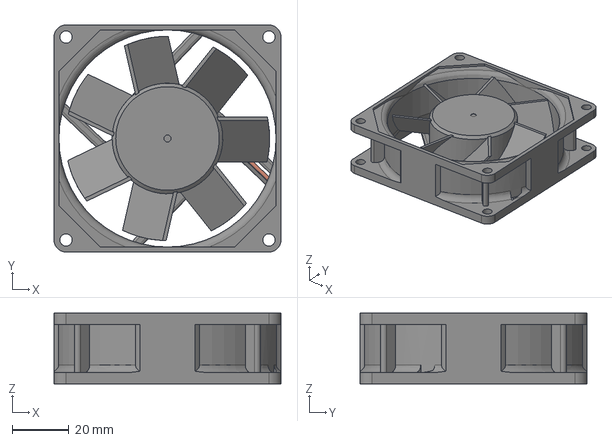
[picture p213: CAD file, 2022-04-29]
_02-realisation/_03-cao_3D/mesCreations/moduleVentilo/modelExternes/80mm-brushless-fan-sunon-kde1208ptb2-1.snapshot.8/80mm brushless fan (SUNON KDE1208PTB2).step
80.0 x 80.0 x 25.0 mm
