MajorLee95/tinyelab/_02-realisation/_03-cao_3D/mesCreations/moduleVentilo/modelExternes/digispark-attiny85-1.snapshot.8/digispark.FCStd

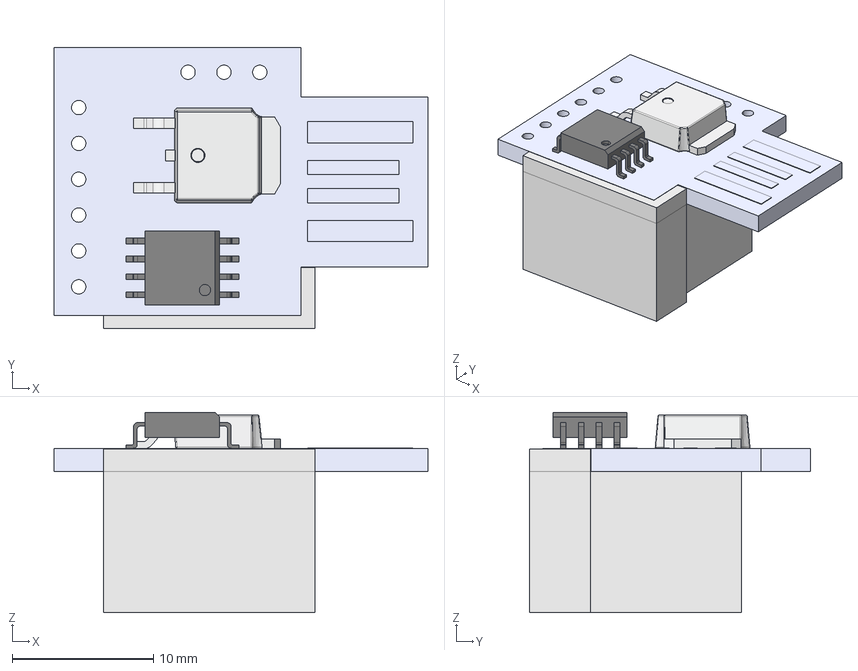
[picture p214: CAD file, 2022-06-22]
_02-realisation/_03-cao_3D/mesCreations/moduleVentilo/modelExternes/digispark-attiny85-1.snapshot.8/digispark.FCStd
26.5 x 19.9 x 14.2 mm
Digispark - Board simple
TO-252AA-IRF
8S2 EIAJ SOIC - ATtiny85 20SU_Valor predeterminado
digisparkSupportBdy
