MajorLee95/tinyelab/_02-realisation/_03-cao_3D/mesCreations/moduleVentilo/modelExternes/digispark-attiny85-1.snapshot.8/STEP/DigiSpark ATtiny85.STEP

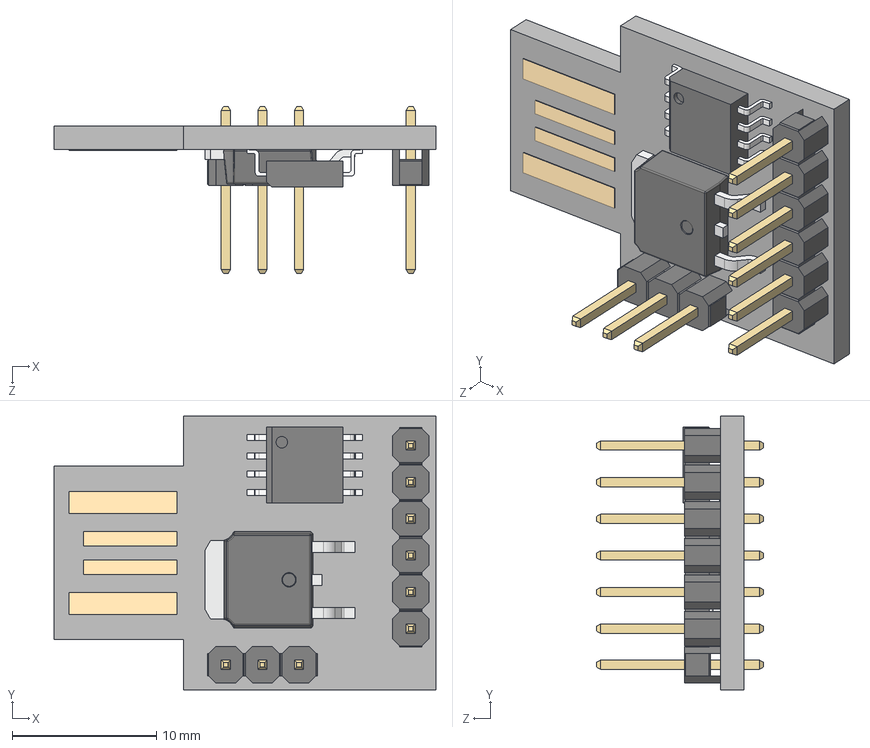
[picture p215: CAD file, 2022-06-22]
_02-realisation/_03-cao_3D/mesCreations/moduleVentilo/modelExternes/digispark-attiny85-1.snapshot.8/STEP/DigiSpark ATtiny85.STEP
26.5 x 19.0 x 11.6 mm
Digispark - Board simple
TO-252AA-IRF
8S2 EIAJ SOIC - ATtiny85 20SU_Valor predeterminado
DS1021-1x3SF11
DS1021-1x6SF11
