MajorLee95/tinyelab/_02-realisation/_03-cao_3D/mesCreations/moduleVentilo/modelExternes/potar/potarAvecInter_001.FCStd

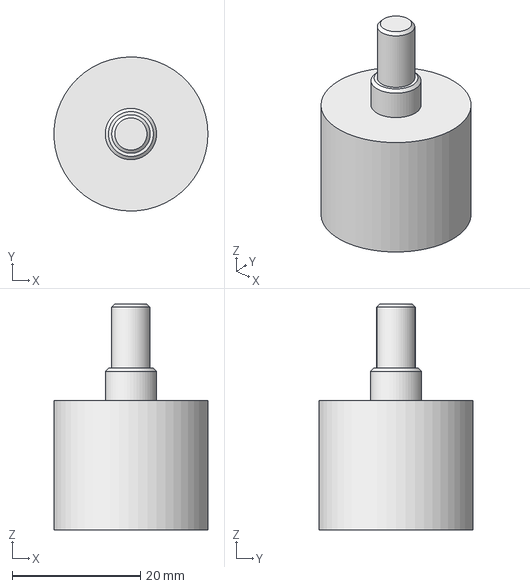
[picture p216: CAD file, 2022-06-22]
_02-realisation/_03-cao_3D/mesCreations/moduleVentilo/modelExternes/potar/potarAvecInter_001.FCStd
24.0 x 24.0 x 35.2 mm
