MajorLee95/tinyelab/_02-realisation/_03-cao_3D/mesCreations/moduleVentilo/ventilo_014surBase35mm_008.1.FCStd

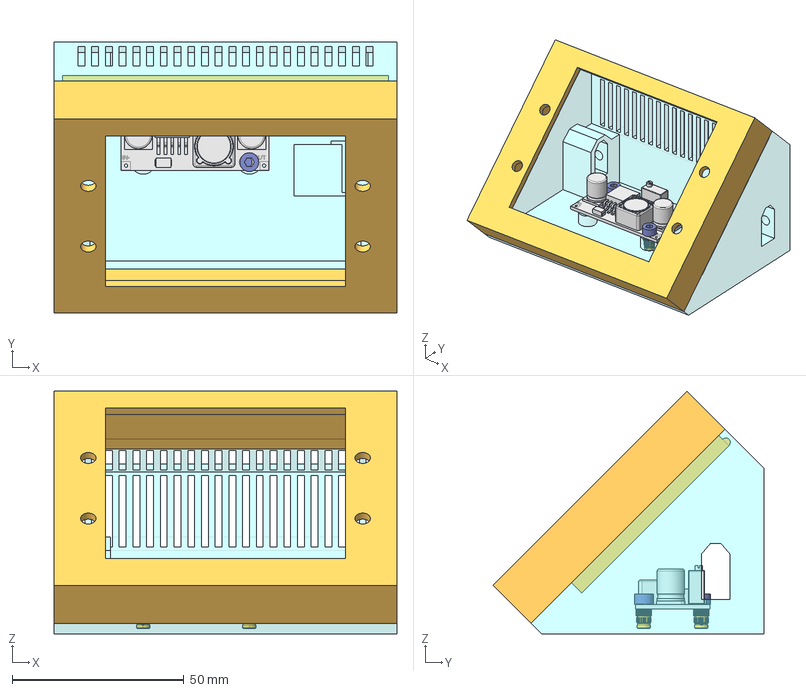
[picture p217: CAD file, 2022-07-13]
_02-realisation/_03-cao_3D/mesCreations/moduleVentilo/ventilo_014surBase35mm_008.1.FCStd
100.0 x 79.1 x 70.7 mm
base
faceAvant
LM2596DCDC v005
visTHCM3x6_001
visTHCM3x6_002
RUTHEX_M3x5_011
RUTHEX_M3x5_012
