MajorLee95/tinyelab/_02-realisation/_03-cao_3D/mesCreations/moduleVoltAmperemetre/export/voltAmperemetre_006_surBase35mm_008.1-fav.stl

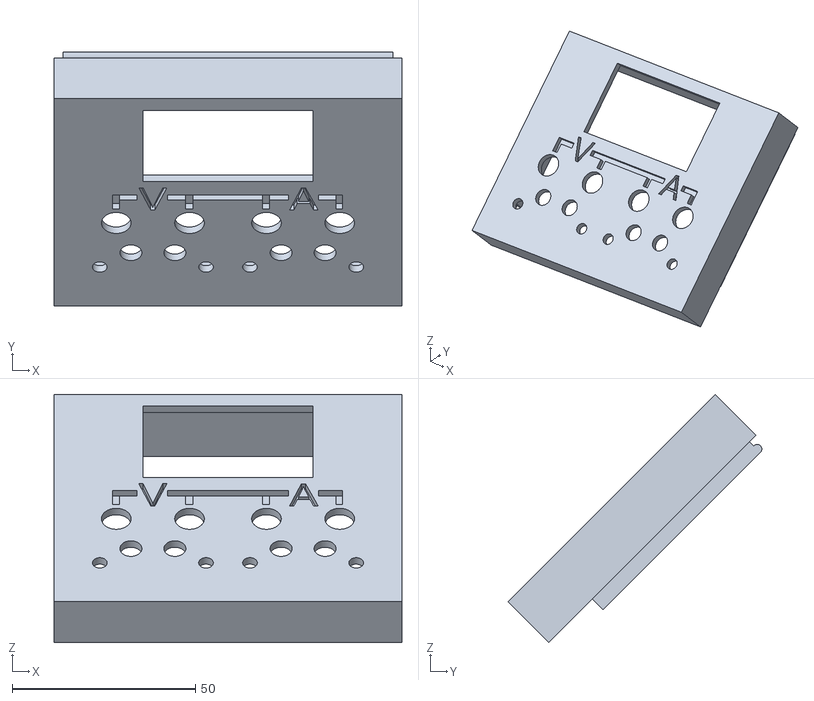
[picture p218: CAD file, 2022-04-20]
_02-realisation/_03-cao_3D/mesCreations/moduleVoltAmperemetre/export/voltAmperemetre_006_surBase35mm_008.1-fav.stl
95.0 x 69.3 x 67.7
