MajorLee95/tinyelab/_02-realisation/_03-cao_3D/mesCreations/moduleVoltAmperemetre/moduleVA_000.4.FCStd

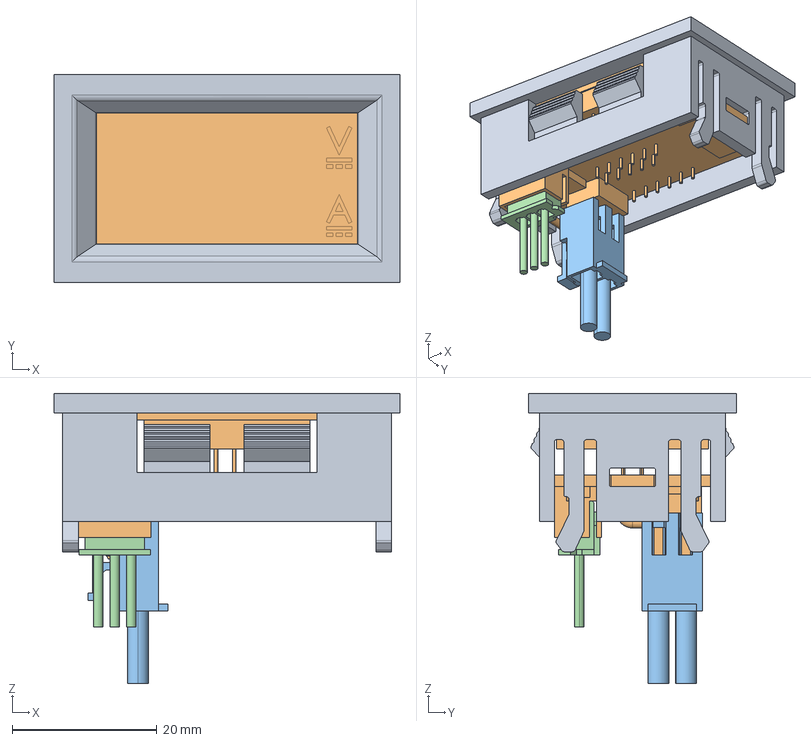
[picture p219: CAD file, 2022-04-17]
_02-realisation/_03-cao_3D/mesCreations/moduleVoltAmperemetre/moduleVA_000.4.FCStd
47.8 x 28.8 x 40.1 mm
volt-amp_boitier
volt-amp_pcb
volt-amp_f2p
volt-amp_f3p
