MajorLee95/tinyelab/_02-realisation/_03-cao_3D/mesCreations/moduleVoltmètres/export/ASX1_triplesVoltm_005_surBase35mm_008.1-fav.3mf

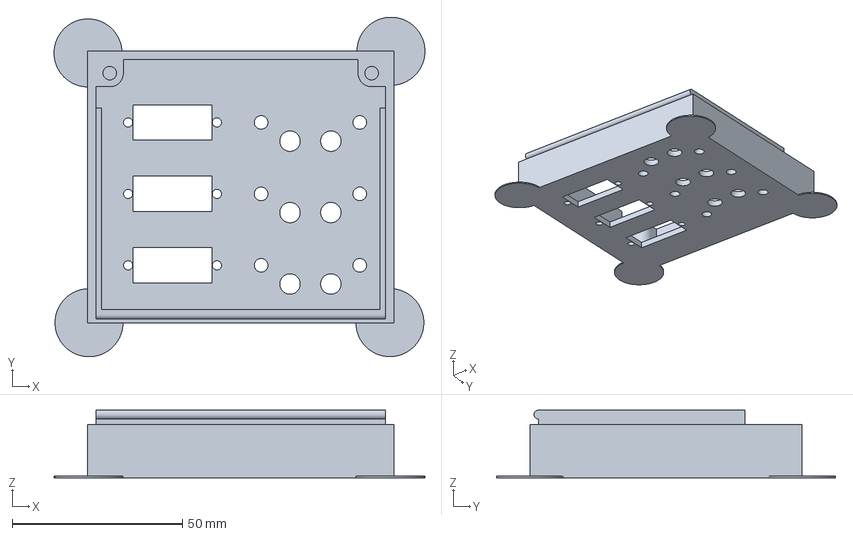
[picture p220: CAD file, 2022-04-24]
_02-realisation/_03-cao_3D/mesCreations/moduleVoltmètres/export/ASX1_triplesVoltm_005_surBase35mm_008.1-fav.3mf
109.1 x 99.8 x 19.9 mm
