MajorLee95/tinyelab/_02-realisation/_03-cao_3D/mesCreations/moduleVoltmètres/triplesVoltm_005_surBase35mm_008.1.FCStd

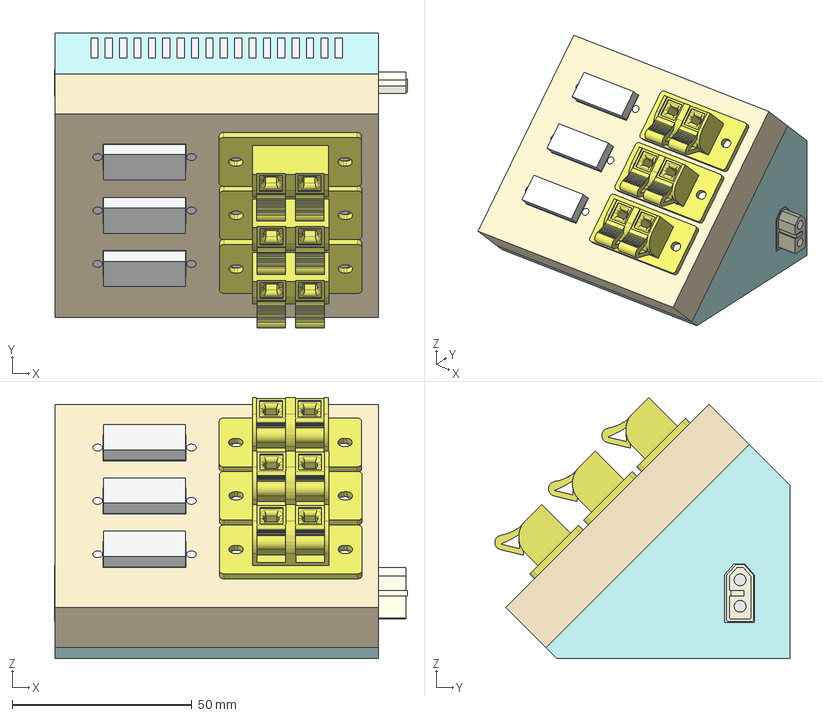
[picture p221: CAD file, 2022-04-23]
_02-realisation/_03-cao_3D/mesCreations/moduleVoltmètres/triplesVoltm_005_surBase35mm_008.1.FCStd
98.2 x 82.2 x 72.6 mm
Base
base
faceAvant
XT60FemaleConnector
XT60MaleConnector
RUTHEX_M3x5_7
RUTHEX_M3x5_008
RUTHEX_M3x5_009
RUTHEX_M3x5_010
bodyVisPointeauM3x10_001
bodyVisPointeauM3x10_002
tigeLaiton
tige2
visTHCM3x6_FAV001
visTHCM3x6_FAV002
Scale
Scale001
Scale002
LED DC Digital Voltmeter 5V Display grün
LED DC Digital Voltmeter 5V Display grün001
LED DC Digital Voltmeter 5V Display grün002
