MajorLee95/tinyelab/_02-realisation/_03-cao_3D/mesCreations/outillageSwitch/export/outSW_v004.stl

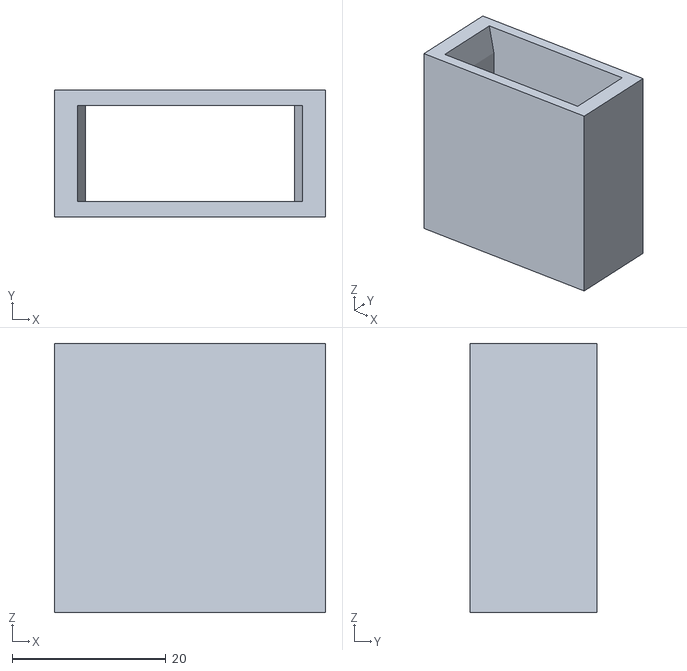
[picture p222: CAD file, 2022-05-04]
_02-realisation/_03-cao_3D/mesCreations/outillageSwitch/export/outSW_v004.stl
35.2 x 16.5 x 35.0
