MajorLee95/tinyelab/_02-realisation/_03-cao_3D/mesCreations/outillageXT60/export/outillageXT_v2_014_les2.3mf

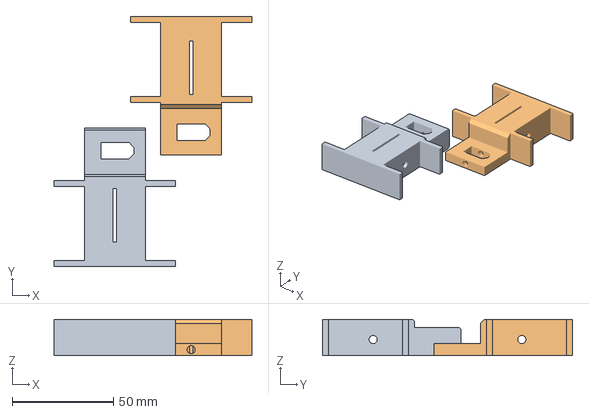
[picture p223: CAD file, 2022-05-04]
_02-realisation/_03-cao_3D/mesCreations/outillageXT60/export/outillageXT_v2_014_les2.3mf
97.6 x 123.4 x 18.0 mm
outillageXT_v2_014-outillageFem.stl
outillageXT_v2_014-outillageMale.stl
