MajorLee95/tinyelab/_02-realisation/_03-cao_3D/mesCreations/ressourcesExterieure/4mm-banana-socket-1.snapshot.1/4mm Banana Socket.STEP

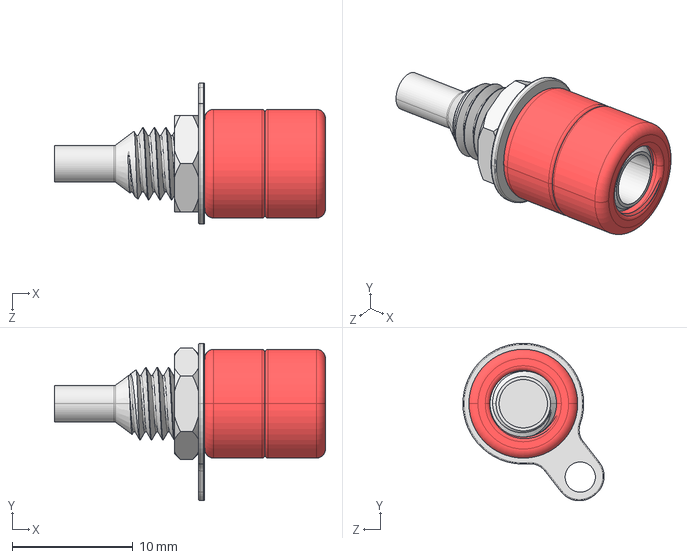
[picture p224: CAD file, 2022-04-17]
_02-realisation/_03-cao_3D/mesCreations/ressourcesExterieure/4mm-banana-socket-1.snapshot.1/4mm Banana Socket.STEP
22.4 x 13.0 x 11.7 mm
