MajorLee95/tinyelab/_02-realisation/_03-cao_3D/mesCreations/ressourcesExterieure/boitierOscillo/DSO138-PushButton.stl

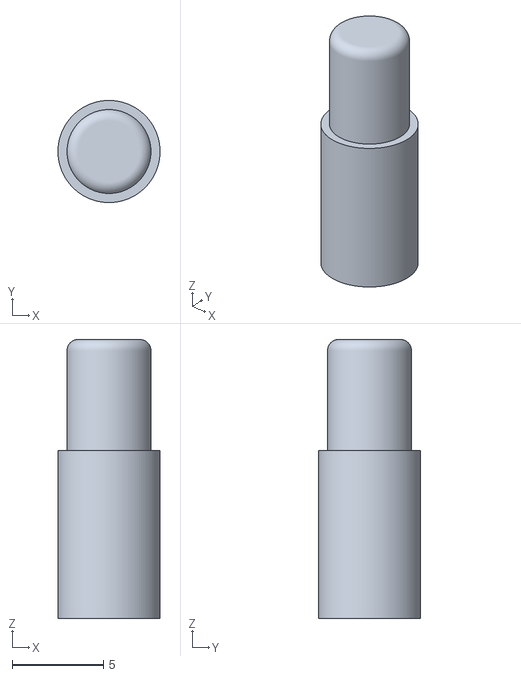
[picture p225: CAD file, 2022-04-17]
_02-realisation/_03-cao_3D/mesCreations/ressourcesExterieure/boitierOscillo/DSO138-PushButton.stl
5.60 x 5.60 x 15.3
