MajorLee95/tinyelab/_02-realisation/_03-cao_3D/mesCreations/ressourcesExterieure/lm2596-dcdc-converter-1.snapshot.1/LM2596DCDC v4.step

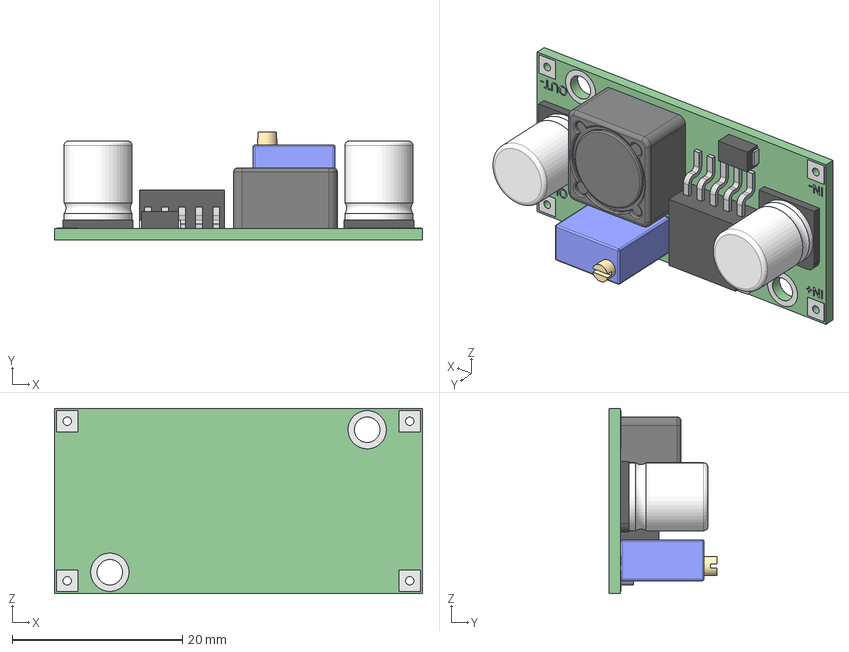
[picture p226: CAD file, 2022-04-17]
_02-realisation/_03-cao_3D/mesCreations/ressourcesExterieure/lm2596-dcdc-converter-1.snapshot.1/LM2596DCDC v4.step
43.2 x 12.7 x 21.8 mm
RawPCB
PADZ
PADZ(Mirror)
ScreenPrint
Base x 2
Can x 2
Inductor
Screw
ThermTab
Pin x 5
Diode
