MajorLee95/tinyelab/_02-realisation/_03-cao_3D/mesCreations/ressourcesExterieure/Voltmeter Ammeter DC.STEP

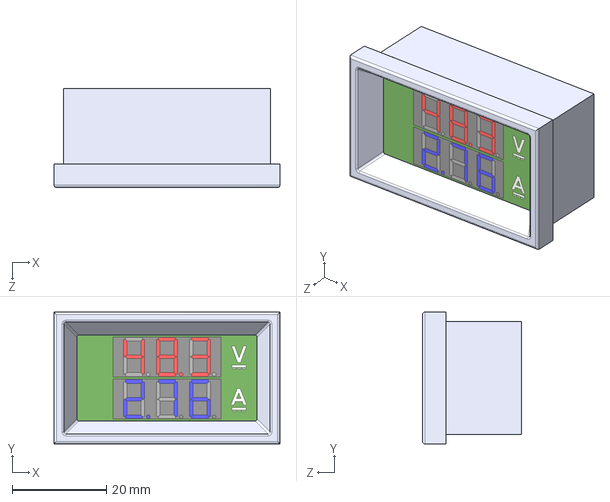
[picture p227: CAD file, 2022-04-17]
_02-realisation/_03-cao_3D/mesCreations/ressourcesExterieure/Voltmeter Ammeter DC.STEP
48.0 x 28.0 x 21.0 mm
