MajorLee95/tinyelab/_02-realisation/_03-cao_3D/mesCreations/tiroirConcept/tiroirSurBase35mm_008.1.FCStd

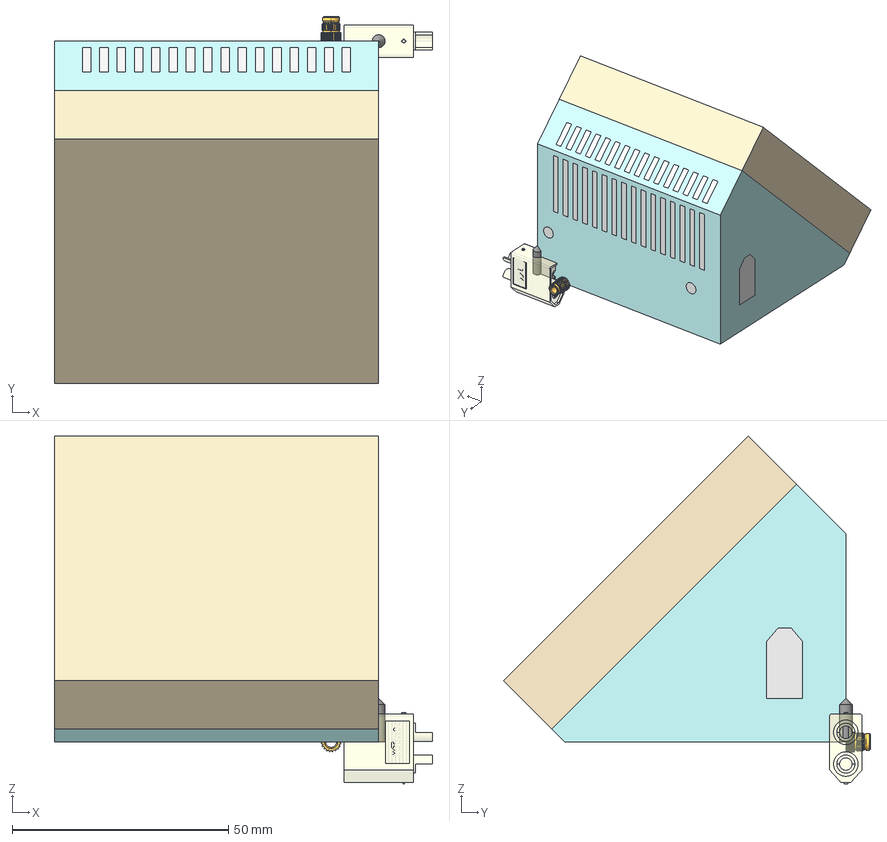
[picture p228: CAD file, 2022-04-17]
_02-realisation/_03-cao_3D/mesCreations/tiroirConcept/tiroirSurBase35mm_008.1.FCStd
87.5 x 84.8 x 80.4 mm
Base
base
faceAvant
bodyVisPointeauM3x10_001
bodyVisPointeauM3x10_002
tigeLaiton
tige2
visTHCM3x6_FAV001
visTHCM3x6_FAV002
XT60FemaleConnector
XT60MaleConnector
RUTHEX_M3x5_7
RUTHEX_M3x5_008
RUTHEX_M3x5_009
RUTHEX_M3x5_010
