MajorLee95/tinyelab/_02-realisation/_03-cao_3D/mesCreations/xt60Cover/xt60covert008.FCStd

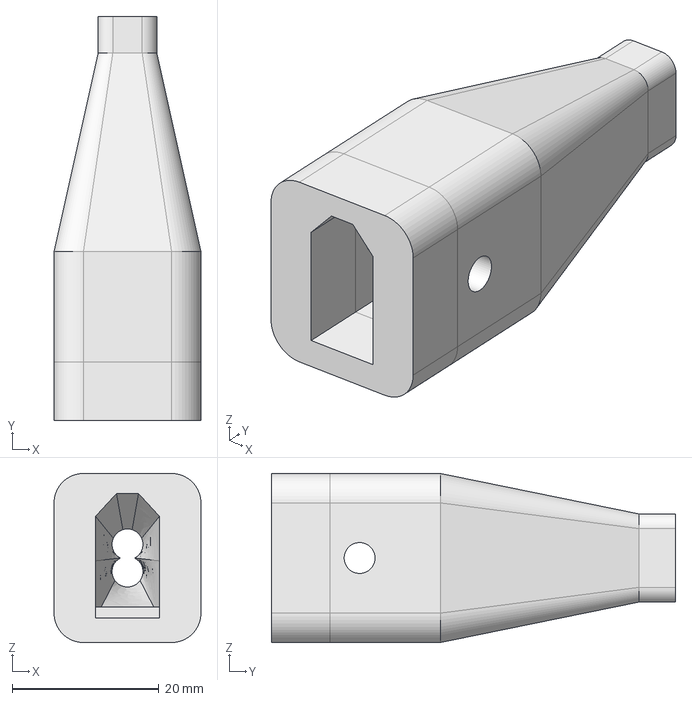
[picture p229: CAD file, 2022-07-16]
_02-realisation/_03-cao_3D/mesCreations/xt60Cover/xt60covert008.FCStd
20.0 x 55.0 x 23.0 mm
