MajorLee95/tinyelab/_02-realisation/_03-cao_3D/modelAFAVSeparee/stepSources/Template_separeFAVv1.step

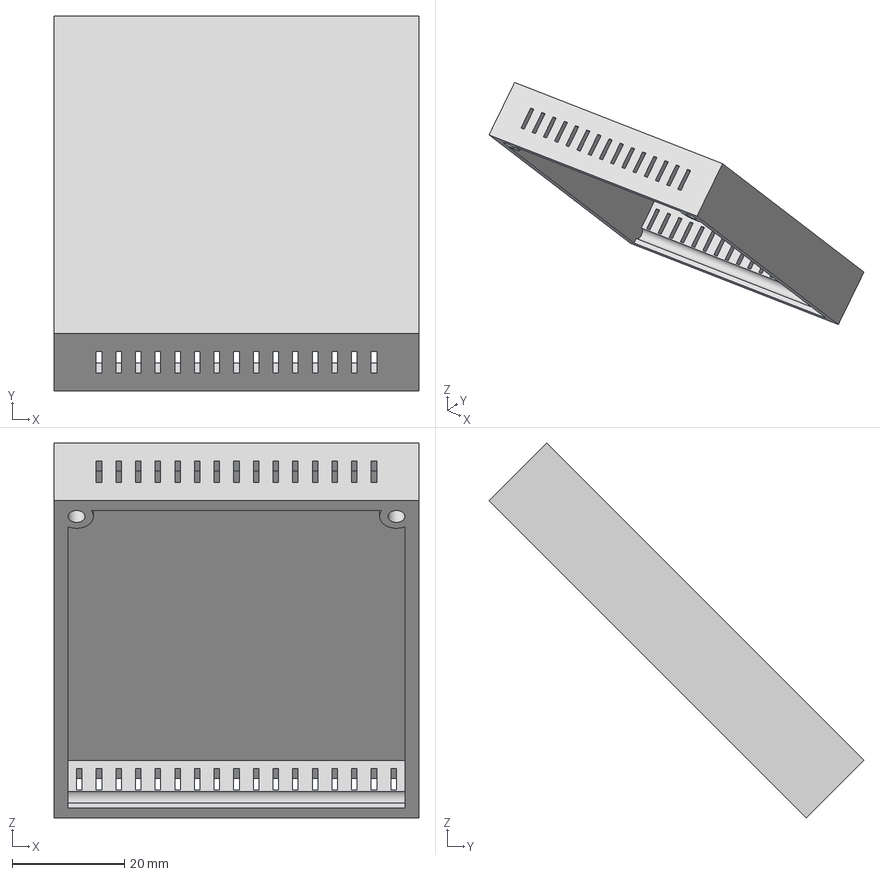
[picture p230: CAD file, 2022-04-17]
_02-realisation/_03-cao_3D/modelAFAVSeparee/stepSources/Template_separeFAVv1.step
65.0 x 66.8 x 66.8 mm
