MajorLee95/tinyelab/_02-realisation/_03-cao_3D/modelAFAVSeparee/templateFavSeparee.FCStd

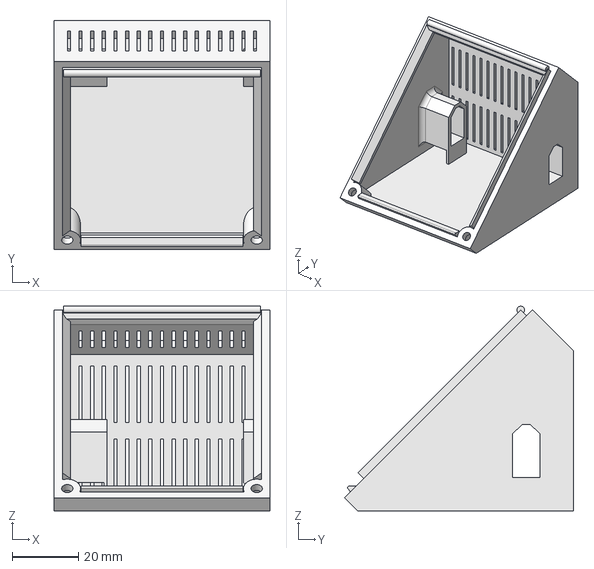
[picture p231: CAD file, 2022-04-17]
_02-realisation/_03-cao_3D/modelAFAVSeparee/templateFavSeparee.FCStd
65.0 x 68.9 x 61.6 mm
