MajorLee95/tinyelab/_02-realisation/_03-cao_3D/retouces/06_USB-single_v1.1.FCStd

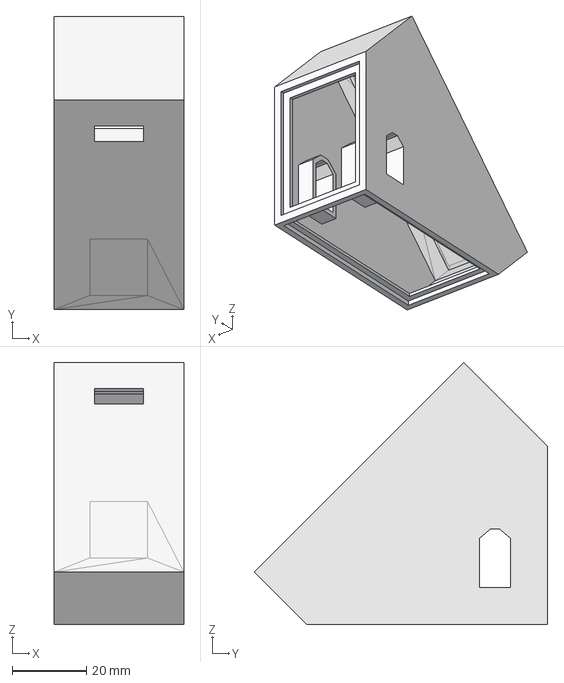
[picture p232: CAD file, 2022-04-17]
_02-realisation/_03-cao_3D/retouces/06_USB-single_v1.1.FCStd
35.0 x 79.1 x 70.7 mm
