MajorLee95/tinyelab/_02-realisation/_03-cao_3D/sourceOriginaux/05_Fume_Extractor_90mm_v2.stl

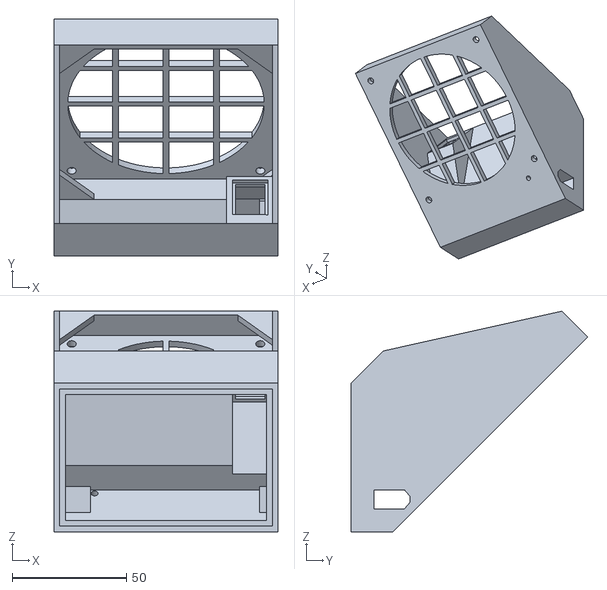
[picture p233: CAD file, 2022-04-17]
_02-realisation/_03-cao_3D/sourceOriginaux/05_Fume_Extractor_90mm_v2.stl
98.0 x 103.5 x 96.5
