MajorLee95/tinyelab/_02-realisation/_03-cao_3D/Tiny E-lab Ts100 alternate stand - 5216290/files/importTS100.FCStd

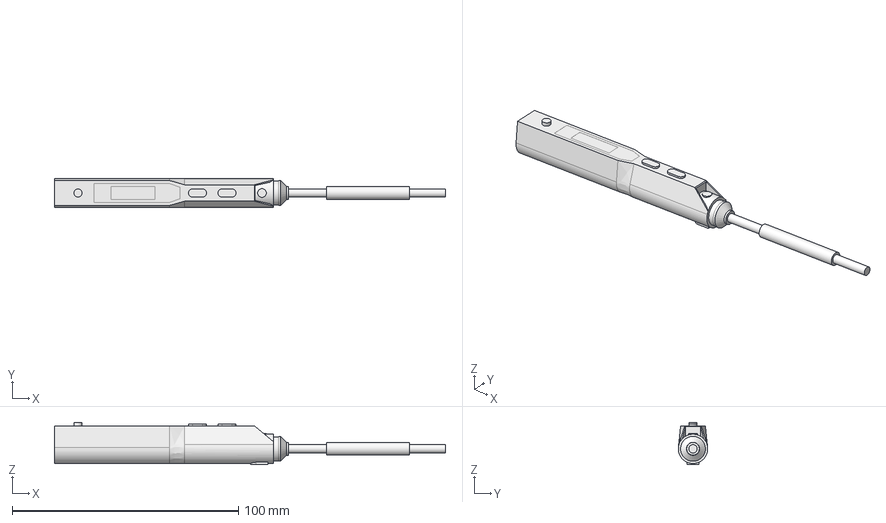
[picture p234: CAD file, 2024-03-21]
_02-realisation/_03-cao_3D/Tiny E-lab Ts100 alternate stand - 5216290/files/importTS100.FCStd
173.0 x 13.0 x 18.7 mm
