MajorLee95/tinyelab/_02-realisation/_03-cao_3D/xt60-connector-male-and-female-1/XT60FemaleConnector.STEP

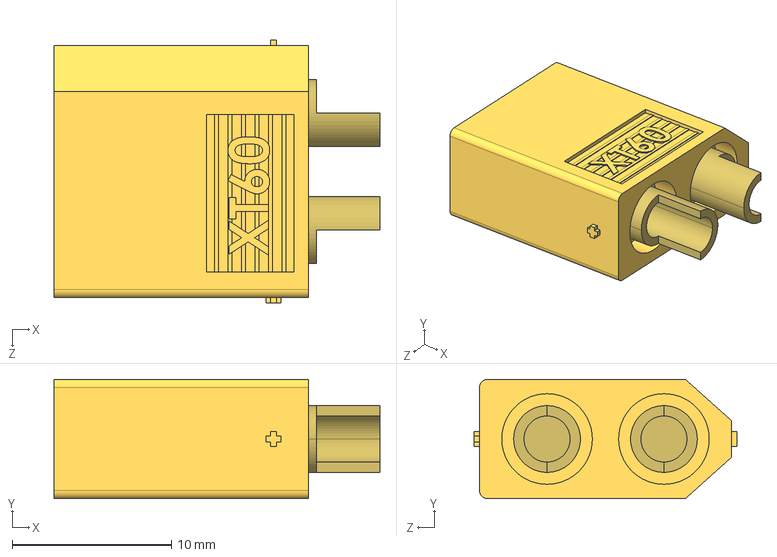
[picture p235: CAD file, 2022-04-17]
_02-realisation/_03-cao_3D/xt60-connector-male-and-female-1/XT60FemaleConnector.STEP
20.5 x 7.50 x 16.5 mm
