MajorLee95/tinyelab/_02-realisation/_02-hardware/usb5v3a_v2_pcb/3dmodels/PT-10.stp

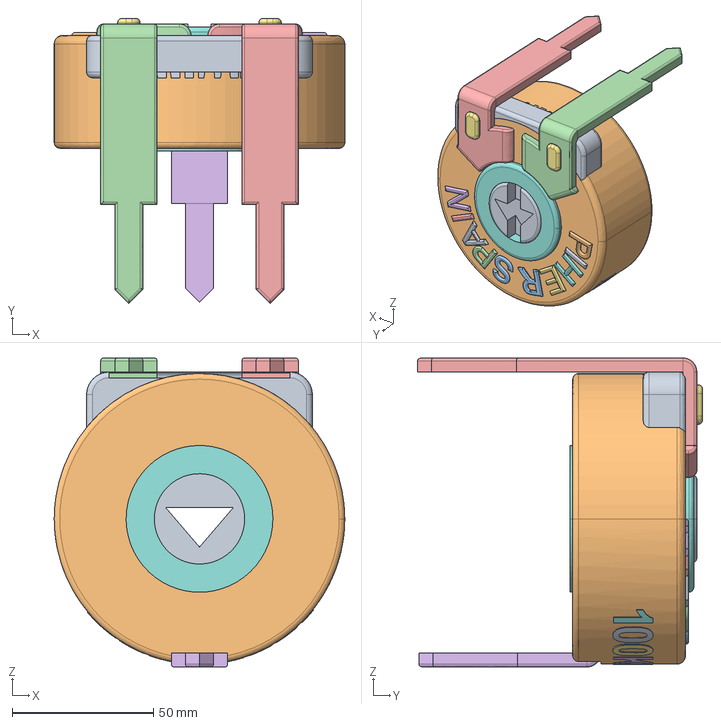
[picture p236: CAD file, 2022-09-10]
_02-realisation/_02-hardware/usb5v3a_v2_pcb/3dmodels/PT-10.stp
103.0 x 101.0 x 109.5 mm
