MajorLee95/tinyelab/_02-realisation/_03-cao_3D/mesCreations/elementsCommun/dcjack5521/panel mount 5.5 x 2.1mm barrel plug.step

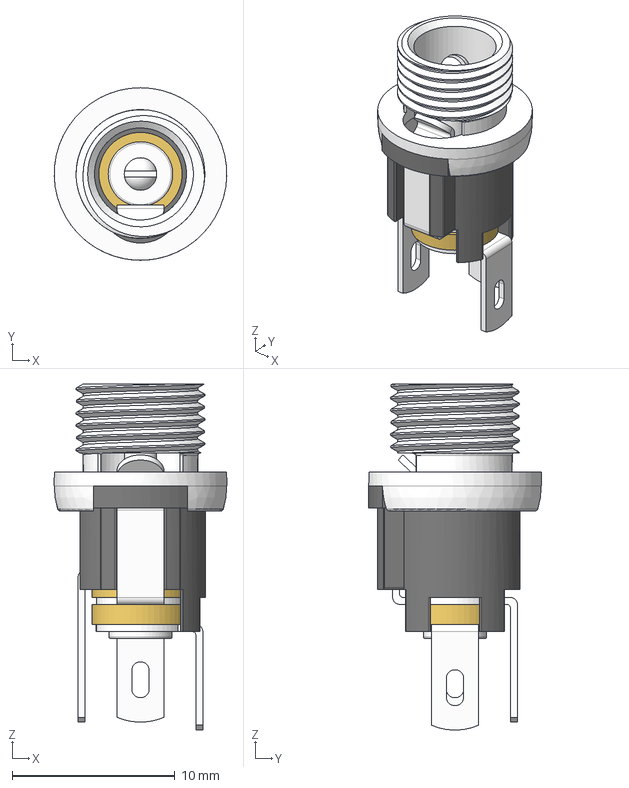
[picture p238: CAD file, 2022-08-03]
_02-realisation/_03-cao_3D/mesCreations/elementsCommun/dcjack5521/panel mount 5.5 x 2.1mm barrel plug.step
10.6 x 10.6 x 21.3 mm
Casing
insulators
Positive Center
Negative parts
