MajorLee95/tinyelab/_02-realisation/_03-cao_3D/mesCreations/elementsCommun/dcjack5525/DC5525.FCStd

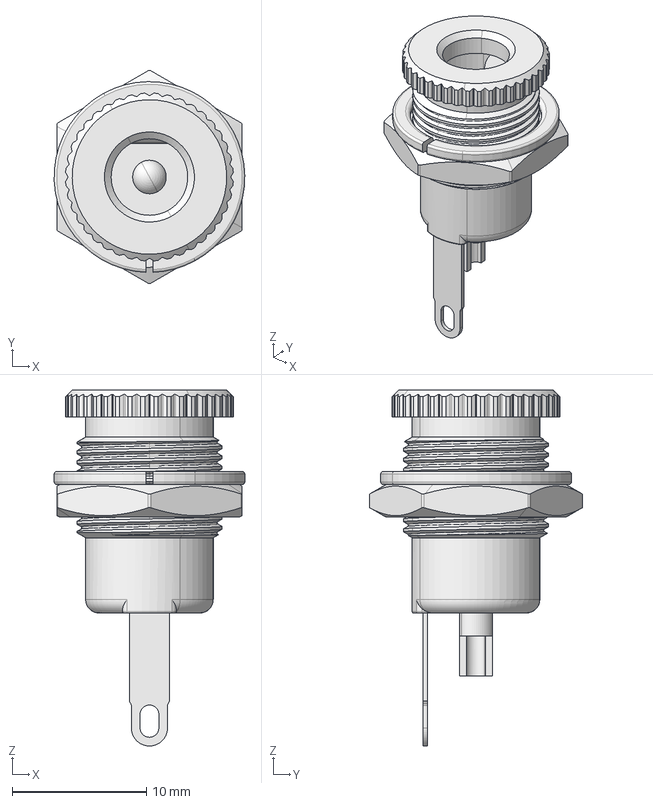
[picture p239: CAD file, 2022-08-03]
_02-realisation/_03-cao_3D/mesCreations/elementsCommun/dcjack5525/DC5525.FCStd
14.2 x 15.9 x 26.5 mm
