MajorLee95/tinyelab/_02-realisation/_03-cao_3D/mesCreations/elementsCommun/ecrouM3.FCStd

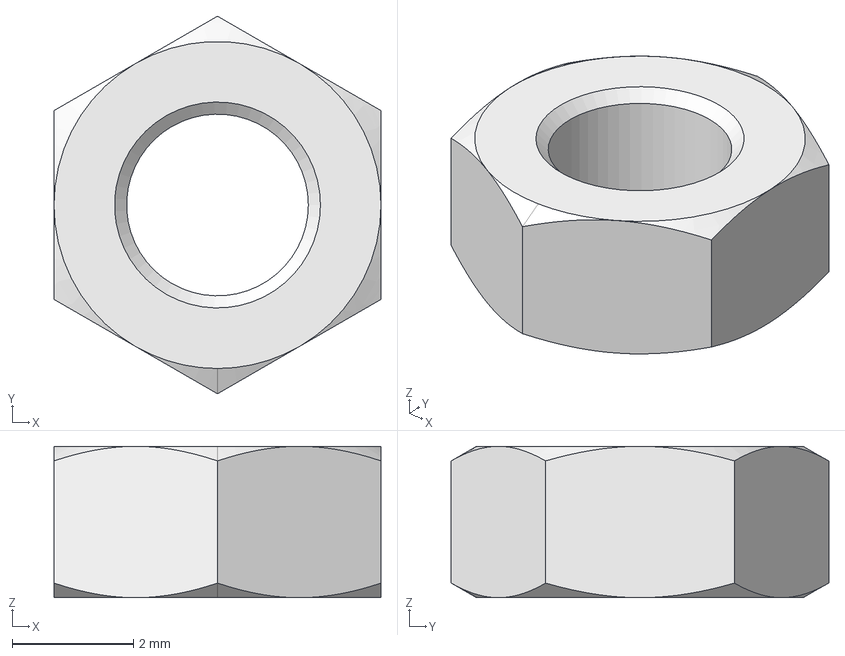
[picture p240: CAD file, 2022-11-23]
_02-realisation/_03-cao_3D/mesCreations/elementsCommun/ecrouM3.FCStd
5.40 x 6.24 x 2.50 mm
