MajorLee95/tinyelab/_02-realisation/_03-cao_3D/mesCreations/lidlParckSideBat/porteFuse_008.1.FCStd

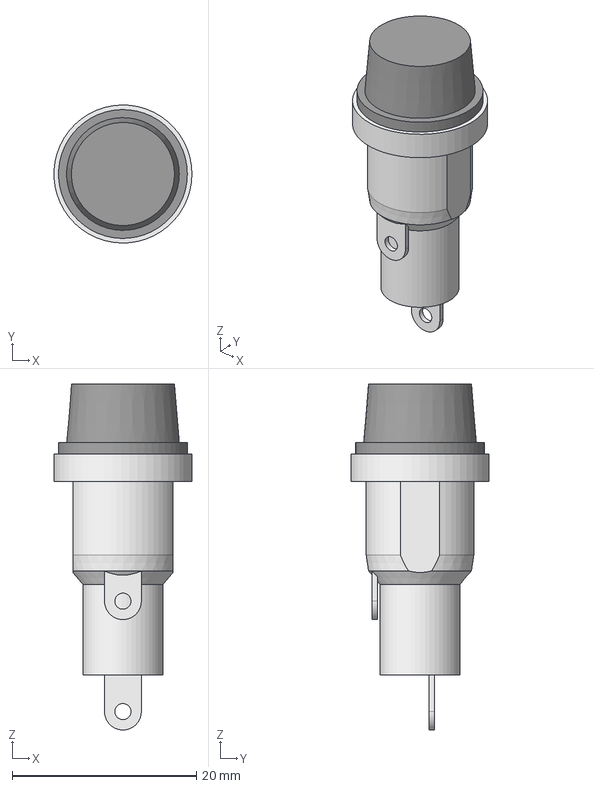
[picture p241: CAD file, 2022-08-15]
_02-realisation/_03-cao_3D/mesCreations/lidlParckSideBat/porteFuse_008.1.FCStd
15.0 x 15.0 x 37.6 mm
corps002
bouchon
cosse1
cosse002
