MajorLee95/tinyelab/_02-realisation/_03-cao_3D/mesCreations/moduleAlimMultiples/potar.FCStd

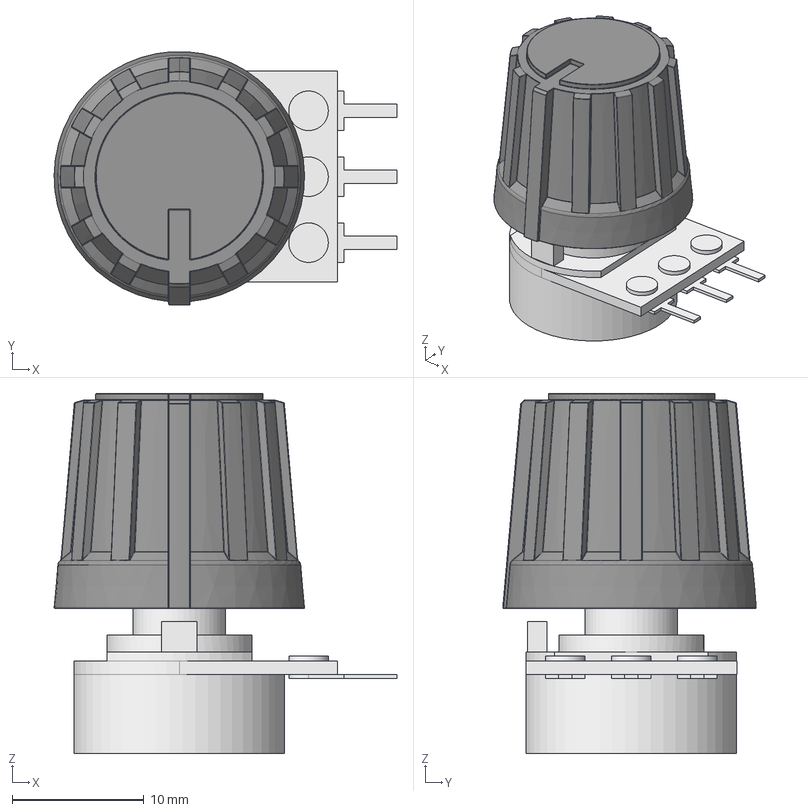
[picture p242: CAD file, 2022-06-22]
_02-realisation/_03-cao_3D/mesCreations/moduleAlimMultiples/potar.FCStd
26.0 x 19.2 x 27.3 mm
Rotary top
Nut and washer
Turn knob
