MajorLee95/tinyelab/_02-realisation/_03-cao_3D/mesCreations/moduleAlimStabDPS3005/export/ASX1_fav_DPS3005.3mf

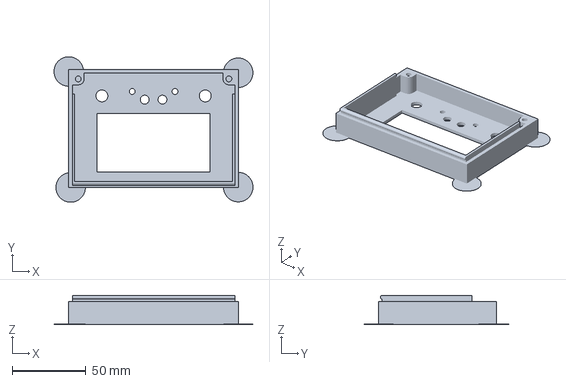
[picture p243: CAD file, 2022-04-17]
_02-realisation/_03-cao_3D/mesCreations/moduleAlimStabDPS3005/export/ASX1_fav_DPS3005.3mf
134.8 x 98.5 x 19.9 mm
