MajorLee95/tinyelab/_02-realisation/_03-cao_3D/mesCreations/moduleGenFonction/modelsExterieur/Arduino Nano/FTDI FT232RL.SLDPRT

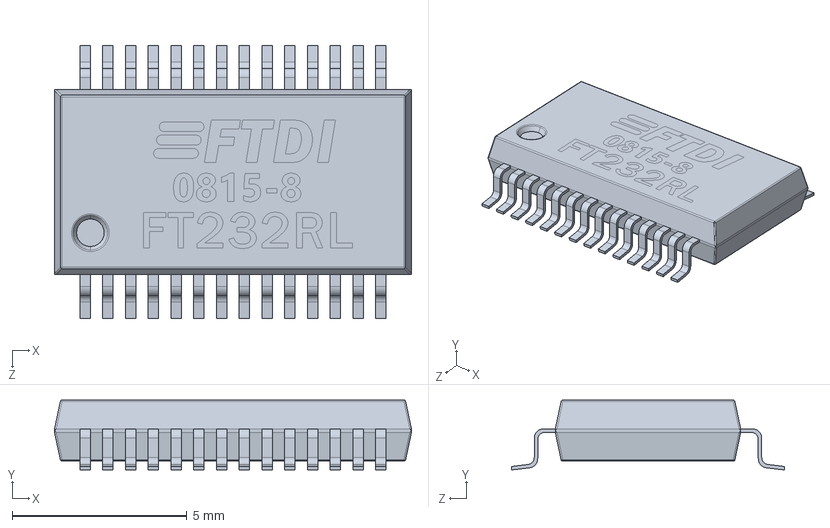
[picture p245: CAD file, 2022-04-20]
_02-realisation/_03-cao_3D/mesCreations/moduleGenFonction/modelsExterieur/Arduino Nano/FTDI FT232RL.SLDPRT
10.2 x 2.00 x 7.81 mm
