MajorLee95/tinyelab/_02-realisation/_03-cao_3D/mesCreations/moduleGenFonction/modelsExterieur/i2c-lcd-16-2-1.snapshot.6/16 pin header.SLDPRT

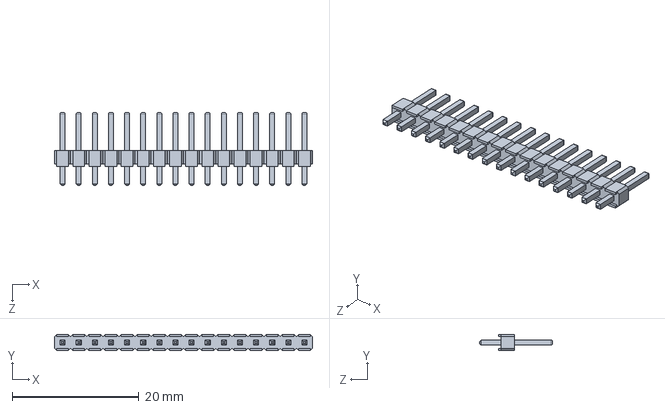
[picture p246: CAD file, 2022-04-20]
_02-realisation/_03-cao_3D/mesCreations/moduleGenFonction/modelsExterieur/i2c-lcd-16-2-1.snapshot.6/16 pin header.SLDPRT
40.6 x 2.54 x 11.5 mm
