MajorLee95/tinyelab/_02-realisation/_03-cao_3D/mesCreations/moduleGenFonction/modelsExterieur/LCD with I2C/Display_C216x01.STEP

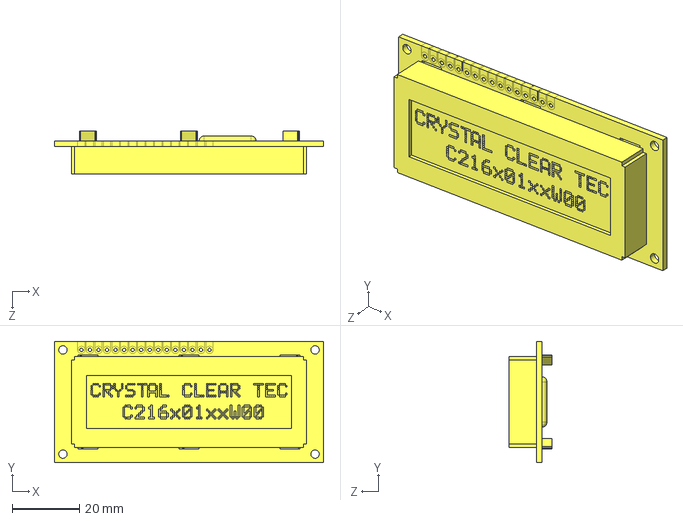
[picture p247: CAD file, 2022-04-20]
_02-realisation/_03-cao_3D/mesCreations/moduleGenFonction/modelsExterieur/LCD with I2C/Display_C216x01.STEP
80.0 x 36.0 x 12.8 mm
