MajorLee95/tinyelab/_02-realisation/_03-cao_3D/mesCreations/moduleOscillo/capotDSO138.FCStd

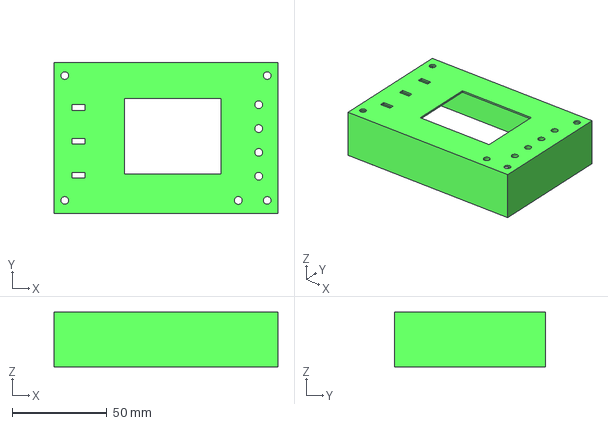
[picture p248: CAD file, 2022-11-23]
_02-realisation/_03-cao_3D/mesCreations/moduleOscillo/capotDSO138.FCStd
118.4 x 80.0 x 29.0 mm
