MajorLee95/tinyelab/_02-realisation/_03-cao_3D/mesCreations/moduleOscillo/export/ASX1_favOscillo_009.3mf

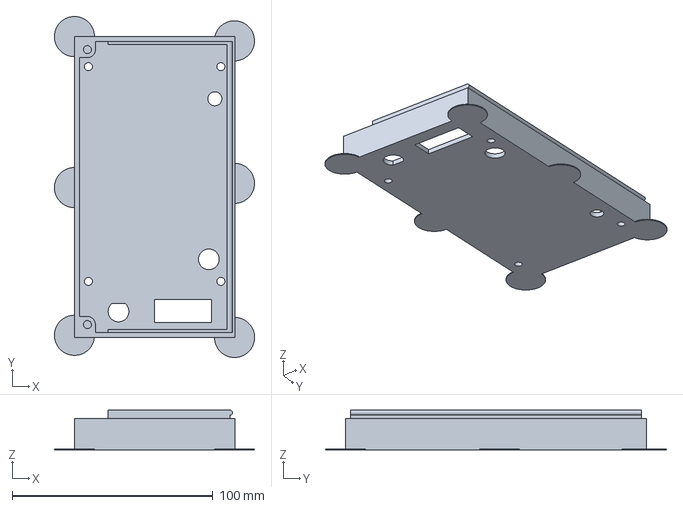
[picture p249: CAD file, 2022-04-29]
_02-realisation/_03-cao_3D/mesCreations/moduleOscillo/export/ASX1_favOscillo_009.3mf
99.8 x 169.9 x 19.9 mm
