MajorLee95/tinyelab/_02-realisation/_03-cao_3D/mesCreations/moduleUI/exports/fav_moduleUI_012_Sur_base35mm_007.5.3mf

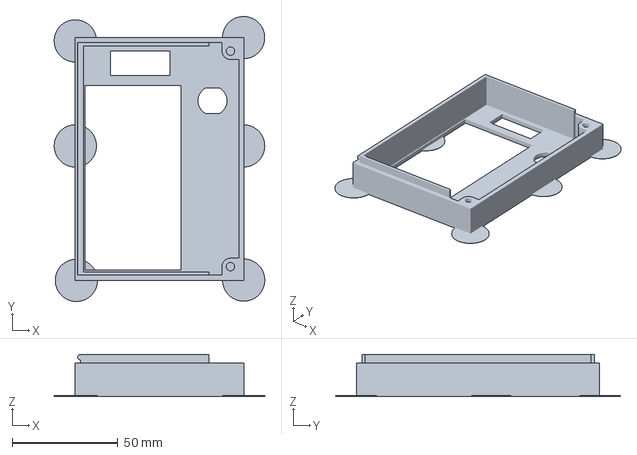
[picture p250: CAD file, 2022-05-04]
_02-realisation/_03-cao_3D/mesCreations/moduleUI/exports/fav_moduleUI_012_Sur_base35mm_007.5.3mf
99.7 x 134.9 x 19.9 mm
