MajorLee95/tinyelab/_02-realisation/_03-cao_3D/mesCreations/moduleUI/KTD132_003.FCStd

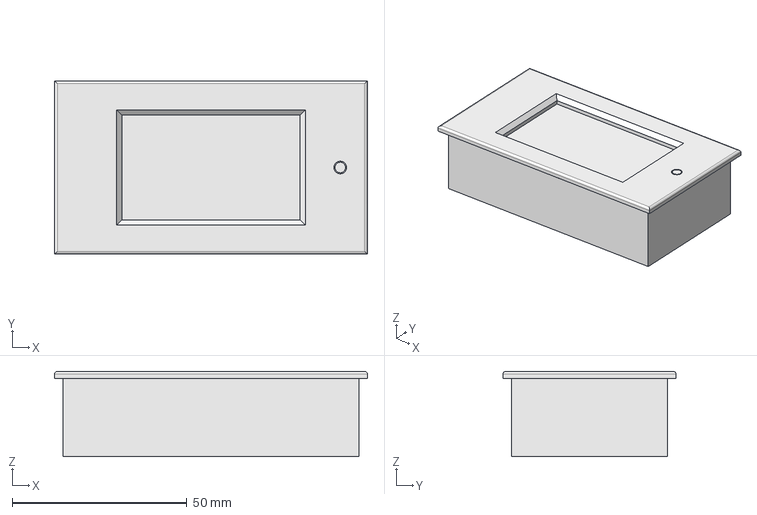
[picture p251: CAD file, 2022-04-17]
_02-realisation/_03-cao_3D/mesCreations/moduleUI/KTD132_003.FCStd
89.6 x 49.6 x 24.4 mm
