MajorLee95/tinyelab/_02-realisation/_03-cao_3D/mesCreations/moduleUSB3A/dissip001.FCStd

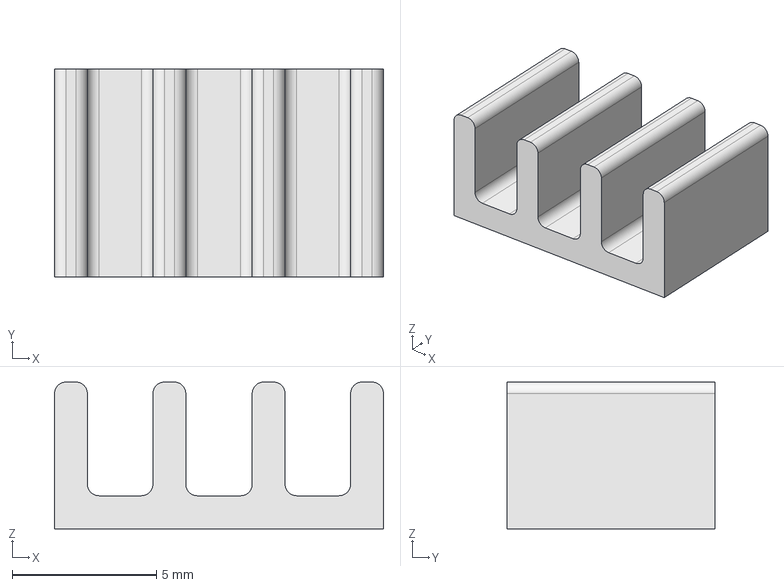
[picture p252: CAD file, 2022-10-22]
_02-realisation/_03-cao_3D/mesCreations/moduleUSB3A/dissip001.FCStd
11.4 x 7.20 x 5.09 mm
