MajorLee95/tinyelab/_02-realisation/_03-cao_3D/mesCreations/moduleUSB3A/exports/v2_022/cale001.stl

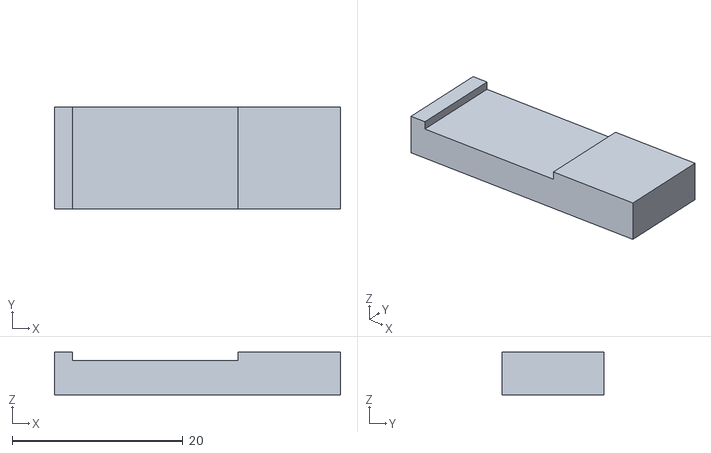
[picture p253: CAD file, 2022-09-10]
_02-realisation/_03-cao_3D/mesCreations/moduleUSB3A/exports/v2_022/cale001.stl
33.5 x 12.0 x 5.00
