MajorLee95/tinyelab/_02-realisation/_03-cao_3D/mesCreations/moduleUSB3A/modelsExterns/switch15x10_003_0.FCStd

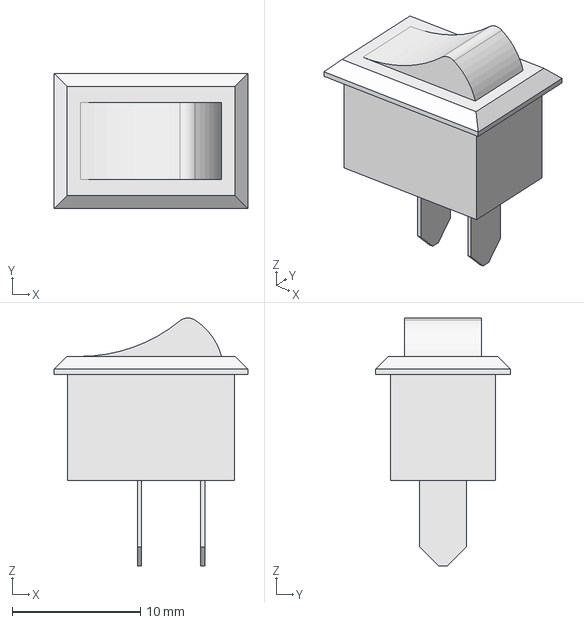
[picture p254: CAD file, 2022-10-22]
_02-realisation/_03-cao_3D/mesCreations/moduleUSB3A/modelsExterns/switch15x10_003_0.FCStd
15.1 x 10.5 x 19.3 mm
