MajorLee95/tinyelab/_02-realisation/_03-cao_3D/mesCreations/moduleUSB3A/modelsExterns/trimPot/trimPotBdy.step

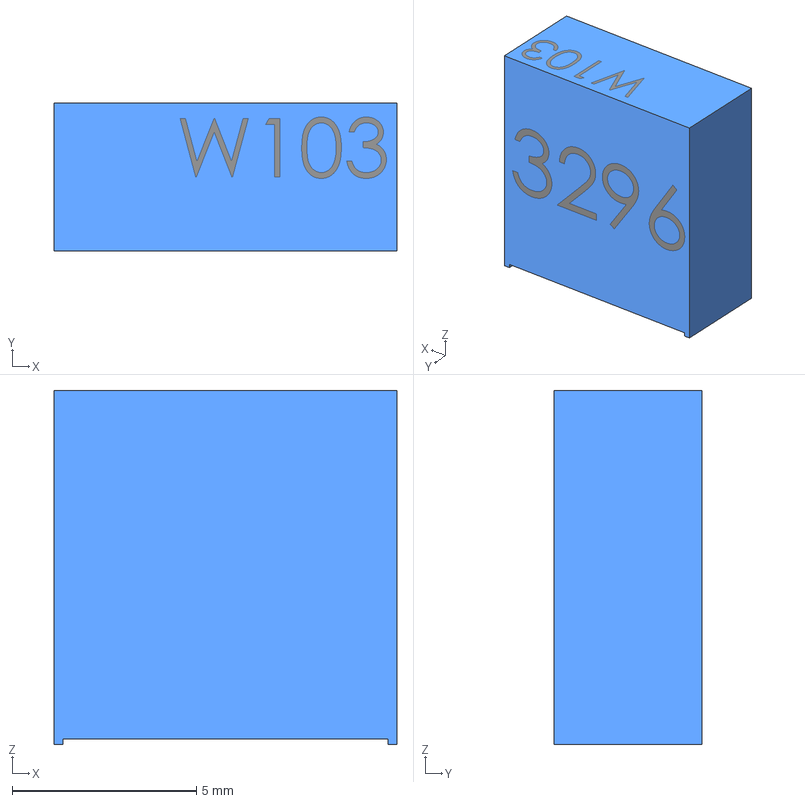
[picture p255: CAD file, 2022-09-10]
_02-realisation/_03-cao_3D/mesCreations/moduleUSB3A/modelsExterns/trimPot/trimPotBdy.step
9.30 x 4.00 x 9.60 mm
