MajorLee95/tinyelab/_02-realisation/_03-cao_3D/mesCreations/moduleUSB5V2ASimple2voies/exports/ASX1_moduleUSB_IP6505_QC2Sur_base35mm_012-faceAvant.3mf

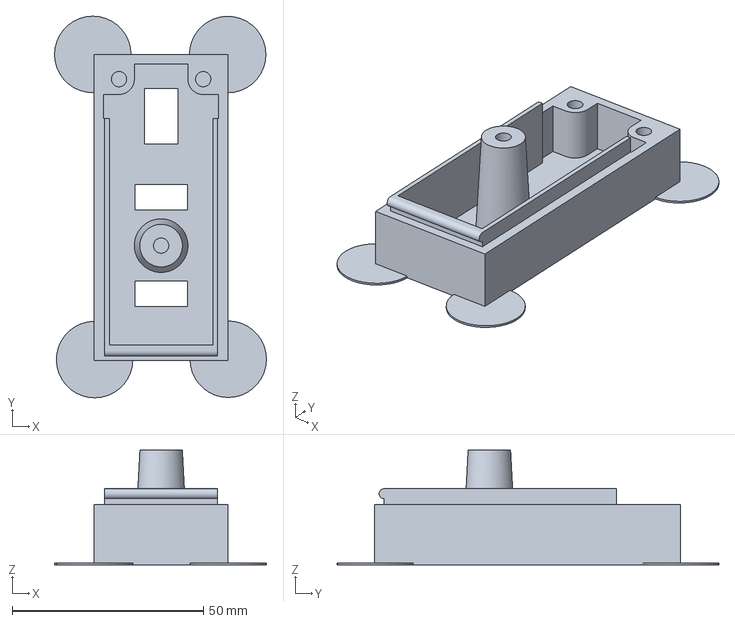
[picture p256: CAD file, 2024-03-21]
_02-realisation/_03-cao_3D/mesCreations/moduleUSB5V2ASimple2voies/exports/ASX1_moduleUSB_IP6505_QC2Sur_base35mm_012-faceAvant.3mf
55.4 x 99.7 x 30.0 mm
