MajorLee95/tinyelab/_02-realisation/_03-cao_3D/mesCreations/moduleUSB5V2ASimple2voies/IP6505_QC2.FCStd

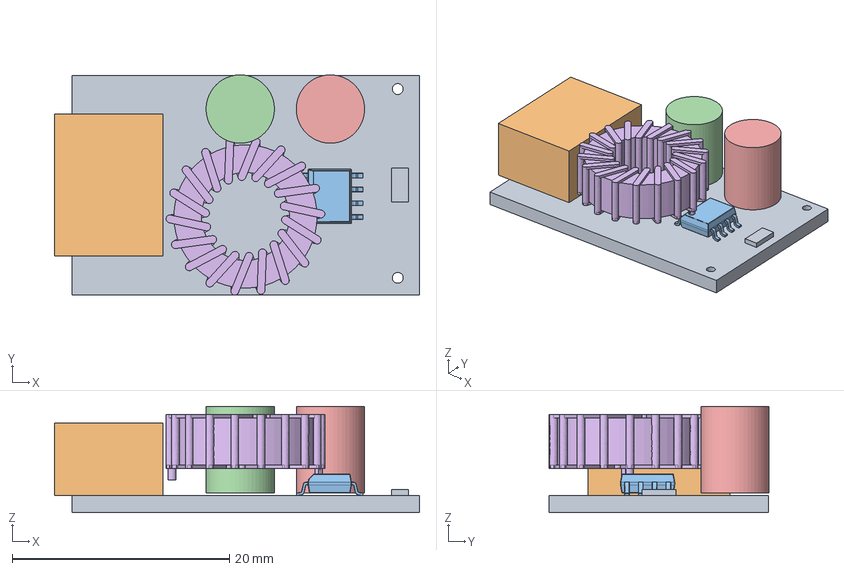
[picture p257: CAD file, 2024-03-21]
_02-realisation/_03-cao_3D/mesCreations/moduleUSB5V2ASimple2voies/IP6505_QC2.FCStd
33.6 x 20.3 x 9.80 mm
boardBdy
Document
capaBdy
capa001
2301-H-RC v002
