MajorLee95/tinyelab/_02-realisation/_03-cao_3D/mesCreations/moduleUSBC_QC3/base35mm_009.1.FCStd

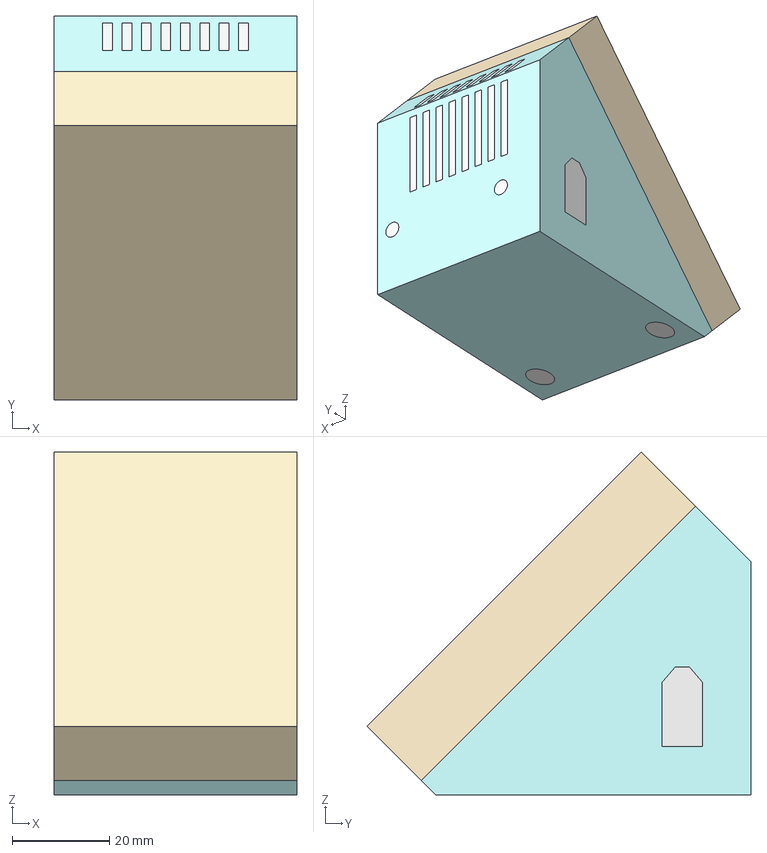
[picture p259: CAD file, 2022-07-13]
_02-realisation/_03-cao_3D/mesCreations/moduleUSBC_QC3/base35mm_009.1.FCStd
50.0 x 79.1 x 70.7 mm
Base
base
faceAvant
tigeLaiton
tige2
