MajorLee95/tinyelab/_02-realisation/_03-cao_3D/mesCreations/moduleUSBsimpleDouble/exports/base006.4.3mf

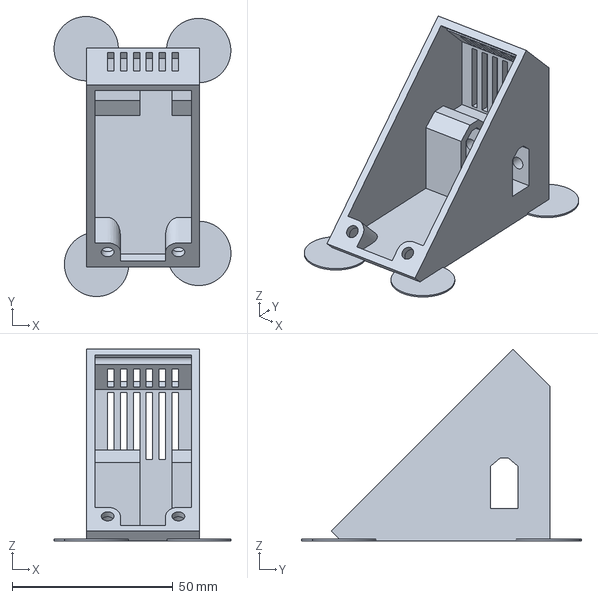
[picture p260: CAD file, 2022-04-17]
_02-realisation/_03-cao_3D/mesCreations/moduleUSBsimpleDouble/exports/base006.4.3mf
55.0 x 87.0 x 59.6 mm
