MajorLee95/tinyelab/_02-realisation/_03-cao_3D/mesCreations/moduleUSBsimpleDouble/exports/v2_009/009_base.step

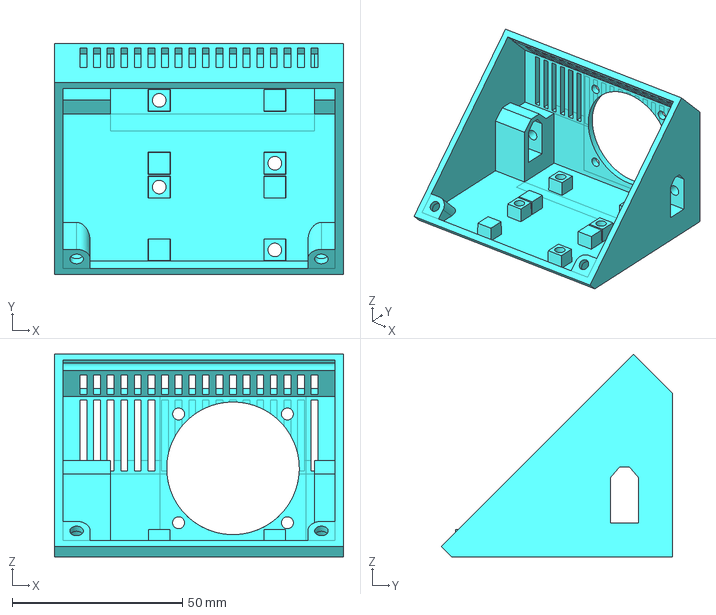
[picture p261: CAD file, 2022-09-10]
_02-realisation/_03-cao_3D/mesCreations/moduleUSBsimpleDouble/exports/v2_009/009_base.step
85.0 x 68.0 x 59.6 mm
