MajorLee95/tinyelab/_02-realisation/_03-cao_3D/mesCreations/moduleUSBsimpleDouble/moduleUSB_SimpleDual_001_SurBase35mm_012.FCStd

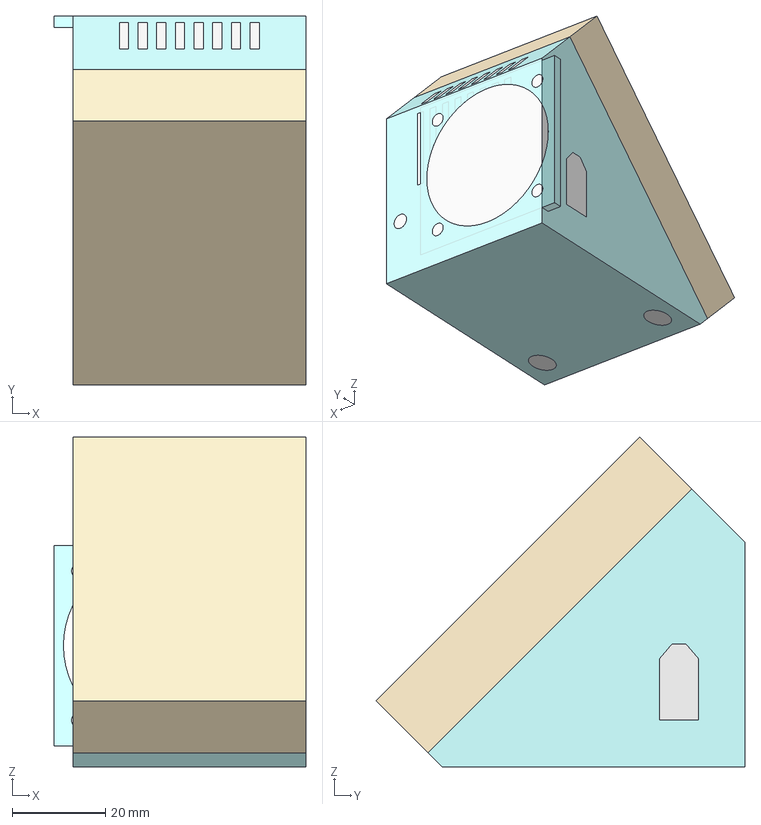
[picture p262: CAD file, 2022-09-10]
_02-realisation/_03-cao_3D/mesCreations/moduleUSBsimpleDouble/moduleUSB_SimpleDual_001_SurBase35mm_012.FCStd
54.0 x 79.1 x 70.7 mm
Base
base
faceAvant
tigeLaiton
tige2
