MajorLee95/tinyelab/_02-realisation/_03-cao_3D/mesCreations/moduleVentilo/fanSupport035.FCStd

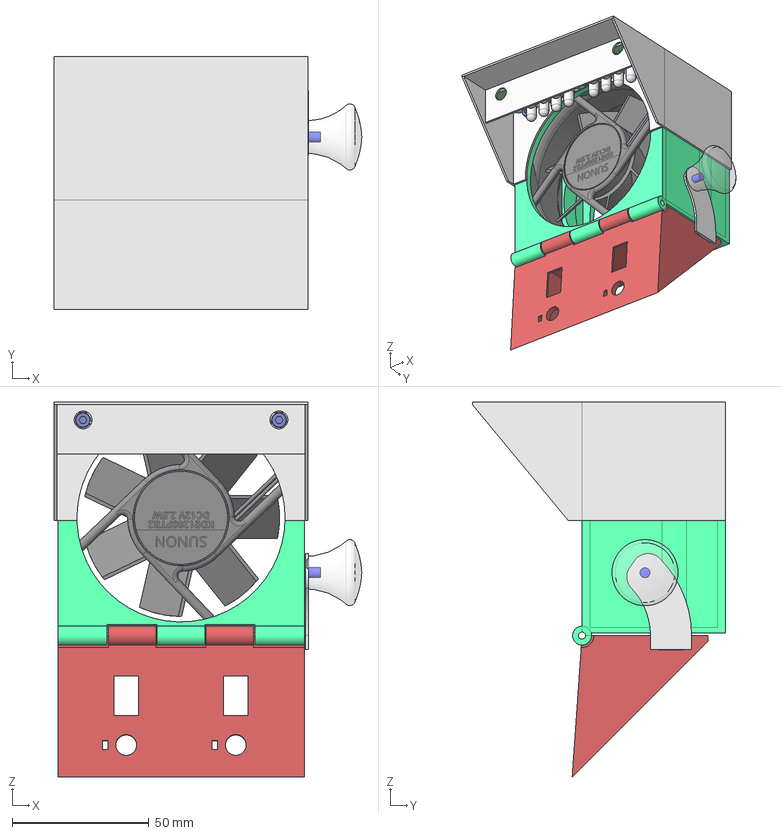
[picture p263: CAD file, 2022-07-13]
_02-realisation/_03-cao_3D/mesCreations/moduleVentilo/fanSupport035.FCStd
112.3 x 92.4 x 136.9 mm
fanSupMobileBdy
ecrouM3bdy
visTHCM3x40_001
visTHCM3x40_002
ecrouM3bdy001
80mm brushless fan (SUNON KDE1208PTB2)
_autosave-ventilo PCB
casquetteBdy
fanSupFixBdy
languetteBdy
