MajorLee95/tinyelab/_02-realisation/_03-cao_3D/mesCreations/moduleVentilo/modelExternes/potar/RV24AF-22-15R.step

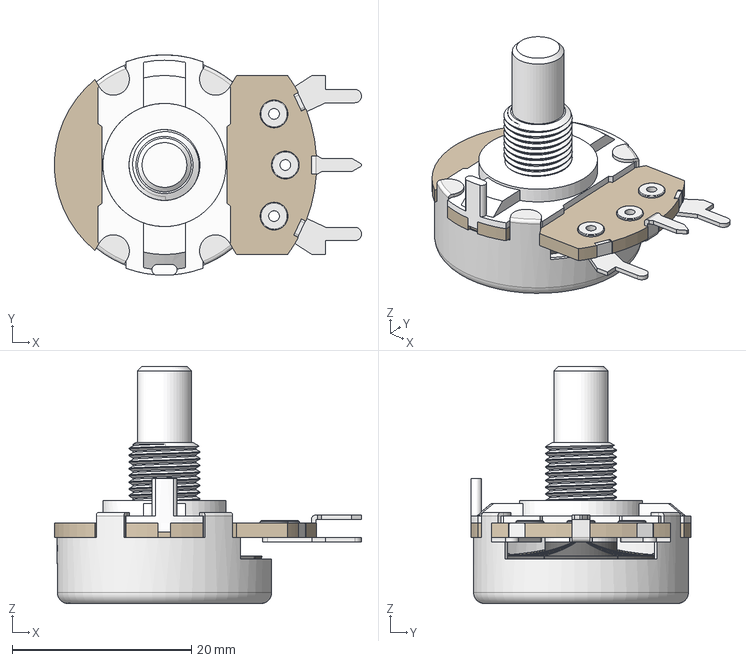
[picture p264: CAD file, 2022-06-22]
_02-realisation/_03-cao_3D/mesCreations/moduleVentilo/modelExternes/potar/RV24AF-22-15R.step
34.3 x 24.6 x 26.5 mm
