MajorLee95/tinyelab/_02-realisation/_03-cao_3D/mesCreations/moduleVoltAmperemetre/export/ASX1_voltAmperemetre_006_surBase35mm_008.1-fav.3mf

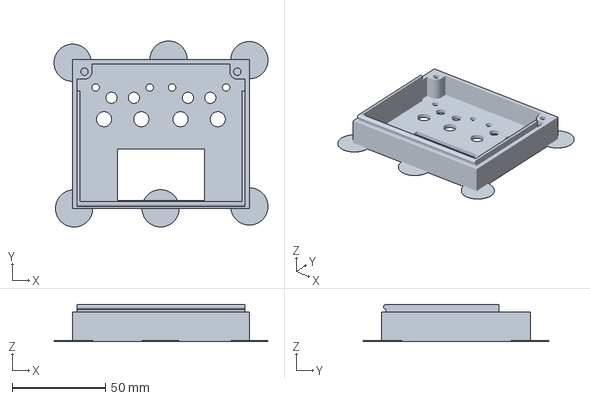
[picture p265: CAD file, 2022-04-20]
_02-realisation/_03-cao_3D/mesCreations/moduleVoltAmperemetre/export/ASX1_voltAmperemetre_006_surBase35mm_008.1-fav.3mf
114.8 x 99.8 x 19.9 mm
