MajorLee95/tinyelab/_02-realisation/_03-cao_3D/mesCreations/moduleVoltmètres/export/ASX1_triplesVoltm_005_surBase35mm_008.1-base.3mf

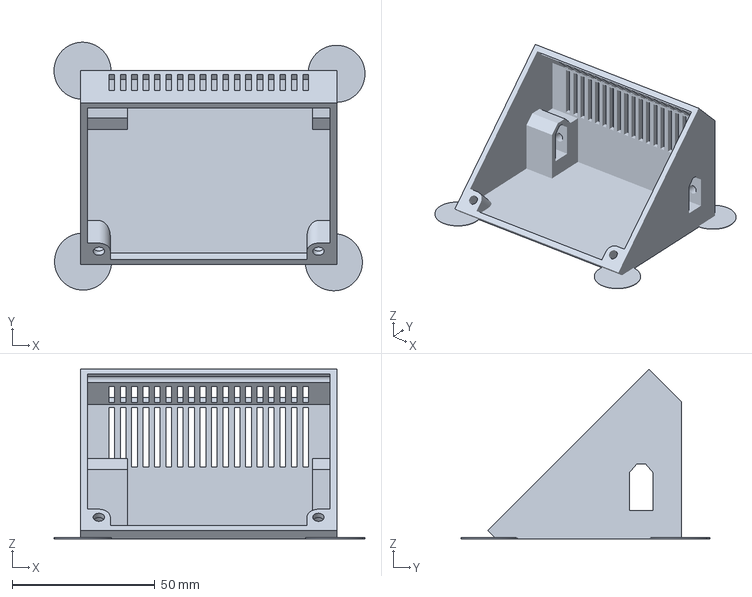
[picture p266: CAD file, 2022-04-24]
_02-realisation/_03-cao_3D/mesCreations/moduleVoltmètres/export/ASX1_triplesVoltm_005_surBase35mm_008.1-base.3mf
109.1 x 87.2 x 59.6 mm
