MajorLee95/tinyelab/_02-realisation/_03-cao_3D/mesCreations/outillageXT60/export/outillageXT_v2_014-outillageMale.stl

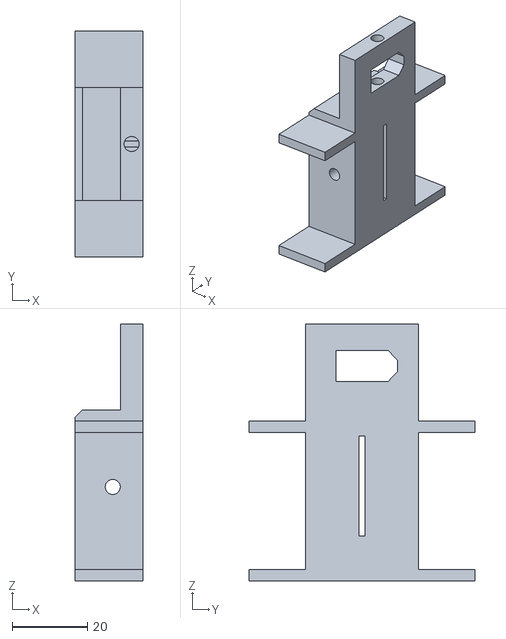
[picture p267: CAD file, 2022-04-23]
_02-realisation/_03-cao_3D/mesCreations/outillageXT60/export/outillageXT_v2_014-outillageMale.stl
18.0 x 60.0 x 68.3
