MajorLee95/tinyelab/_02-realisation/_03-cao_3D/mesCreations/outillageXT60/outillageXT_v2_014.FCStd

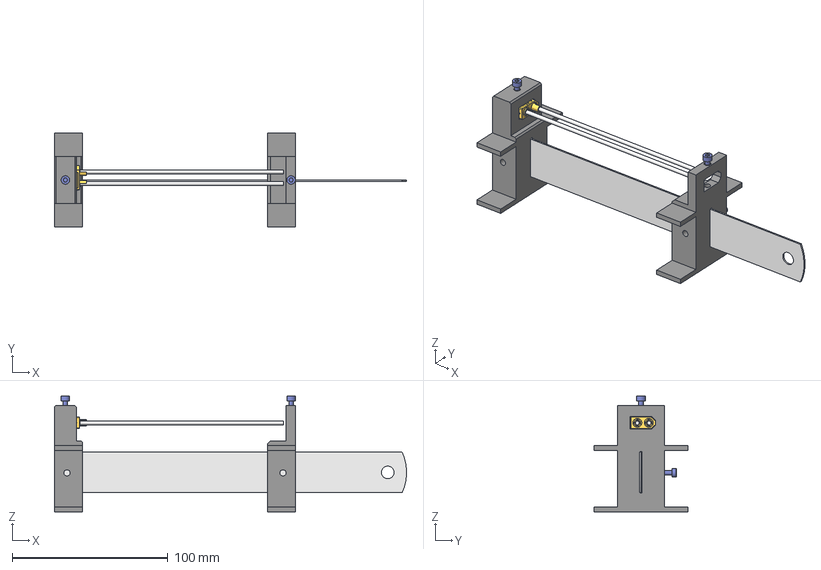
[picture p268: CAD file, 2022-04-23]
_02-realisation/_03-cao_3D/mesCreations/outillageXT60/outillageXT_v2_014.FCStd
225.8 x 60.0 x 74.2 mm
regletBdy
outillageFem
outillageMale
XT60FemaleConnector
RUTHEX_M3x5_008 x 2
visTHCM3x10 x 2
visTHCM3x20_001 x 2
RUTHEX_M3x5_009 x 2
tigeLaiton
tige2
