MajorLee95/tinyelab/_02-realisation/_03-cao_3D/mesCreations/ressourcesExterieure/boitierOscillo/DSO138-ResetButton.stl

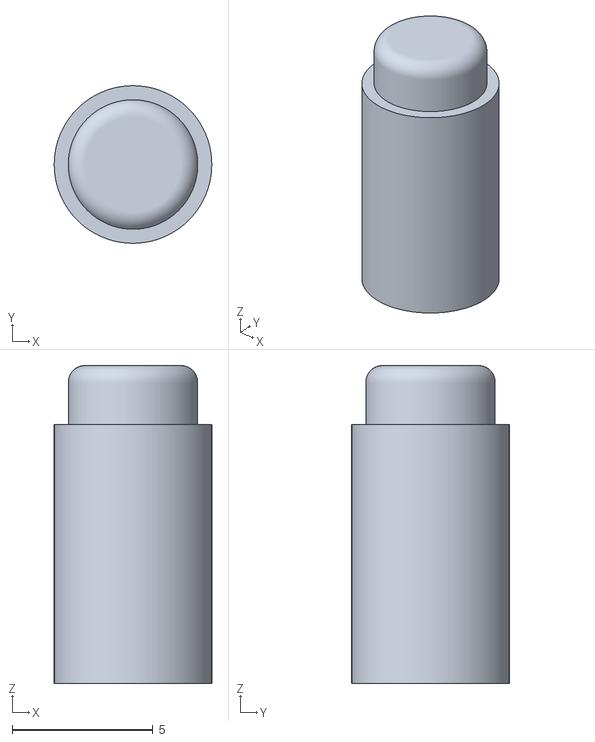
[picture p269: CAD file, 2022-04-17]
_02-realisation/_03-cao_3D/mesCreations/ressourcesExterieure/boitierOscillo/DSO138-ResetButton.stl
5.60 x 5.60 x 11.3
