MajorLee95/tinyelab/_02-realisation/_03-cao_3D/mesCreations/xt60Cover/xt60_insert_vis.FCStd

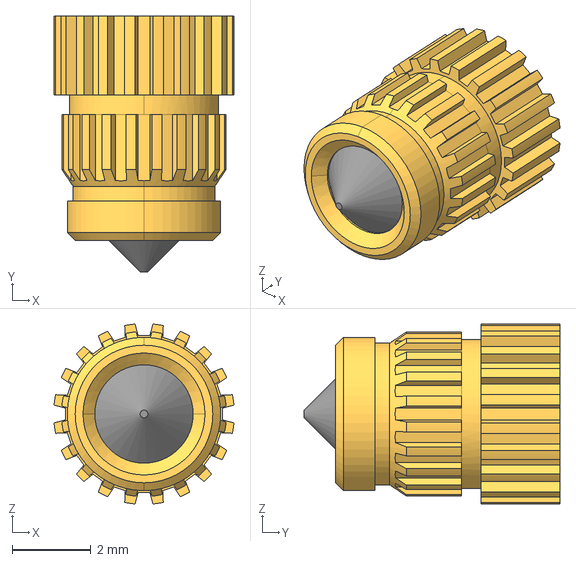
[picture p270: CAD file, 2022-07-13]
_02-realisation/_03-cao_3D/mesCreations/xt60Cover/xt60_insert_vis.FCStd
4.58 x 6.50 x 4.58 mm
RUTHEX_M3x5_7
bodyVisPointeauM3x10_001
