MajorLee95/tinyelab/_02-realisation/_03-cao_3D/modelAFAVSeparee/stepSources/usb1_faceDetachv1.step

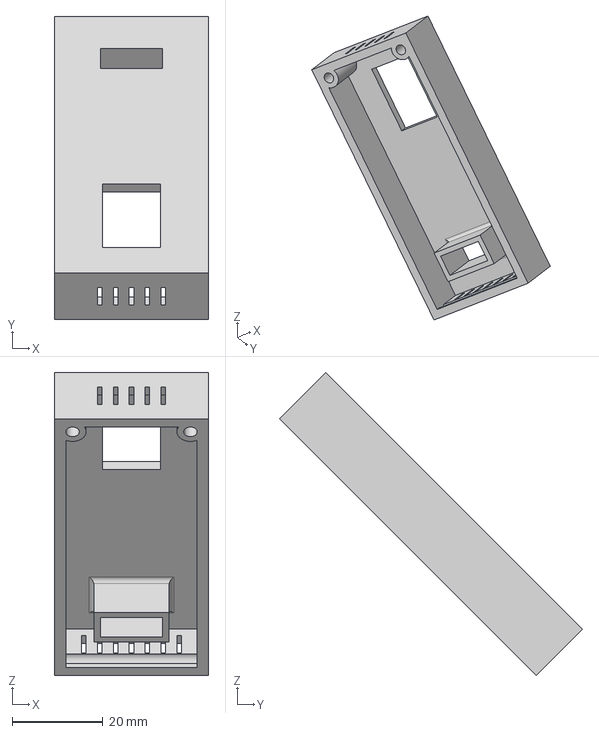
[picture p271: CAD file, 2022-04-17]
_02-realisation/_03-cao_3D/modelAFAVSeparee/stepSources/usb1_faceDetachv1.step
34.0 x 66.8 x 66.8 mm
