MajorLee95/tinyelab/_02-realisation/_03-cao_3D/modelAFAVSeparee/usbSingleFavSep.FCStd

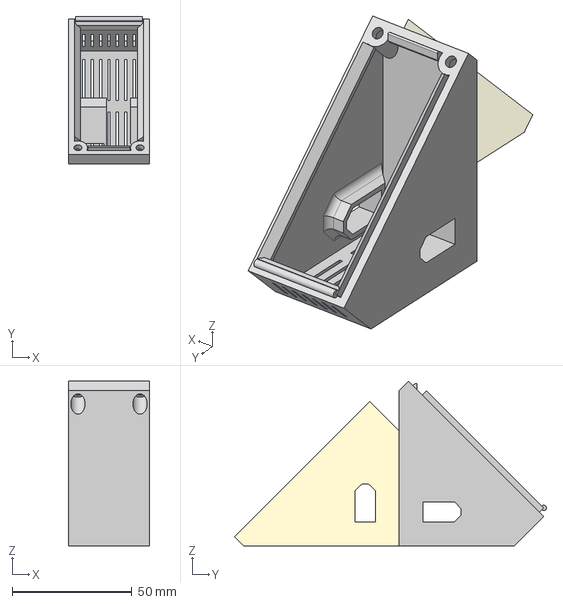
[picture p272: CAD file, 2022-04-17]
_02-realisation/_03-cao_3D/modelAFAVSeparee/usbSingleFavSep.FCStd
34.0 x 130.5 x 68.9 mm
USB PSU001
CopyPart__Feature001
