MajorLee95/tinyelab/_02-realisation/_03-cao_3D/sourceOriginaux/03_lcr-t4_v04.stl

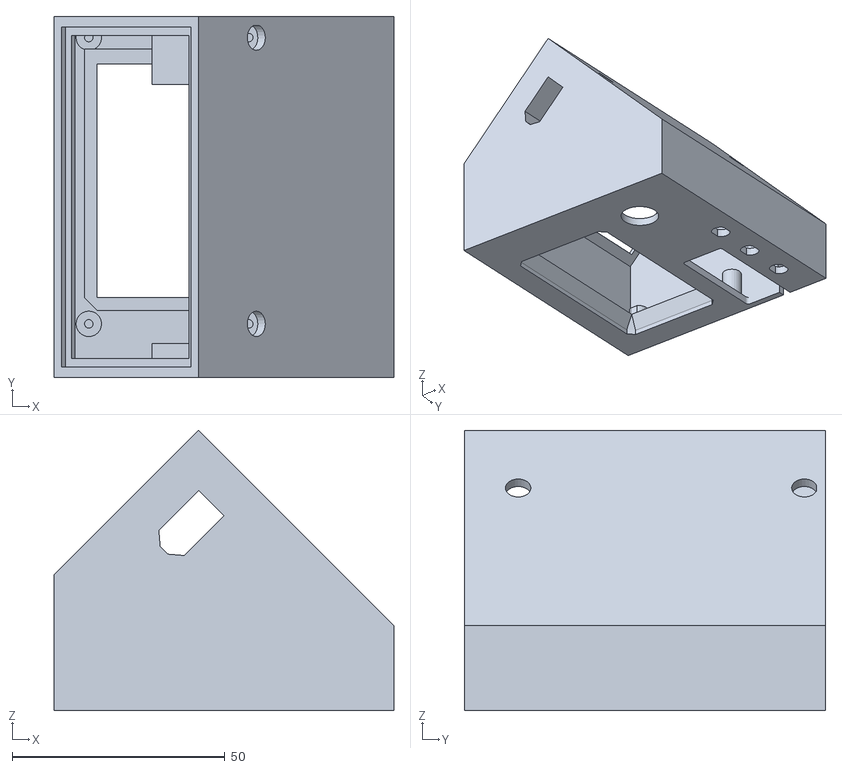
[picture p273: CAD file, 2022-04-17]
_02-realisation/_03-cao_3D/sourceOriginaux/03_lcr-t4_v04.stl
80.0 x 85.0 x 66.0
