MajorLee95/tinyelab/_02-realisation/_03-cao_3D/xt60-connector-male-and-female-1/XT60MaleConnector.STEP

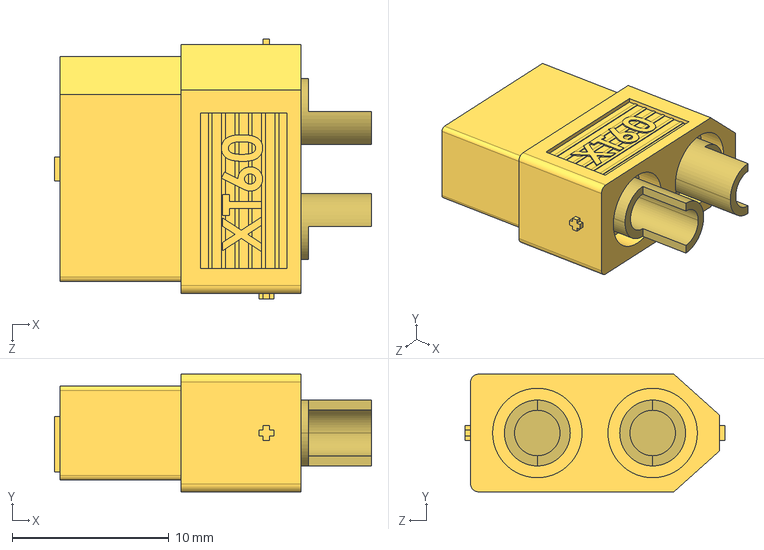
[picture p274: CAD file, 2022-04-17]
_02-realisation/_03-cao_3D/xt60-connector-male-and-female-1/XT60MaleConnector.STEP
20.2 x 7.50 x 16.5 mm
