MajorLee95/tinyelab/_02-realisation/_02-hardware/usb5v3a_v2_pcb/3dmodels/Trimmer_Piher_PT-15.step

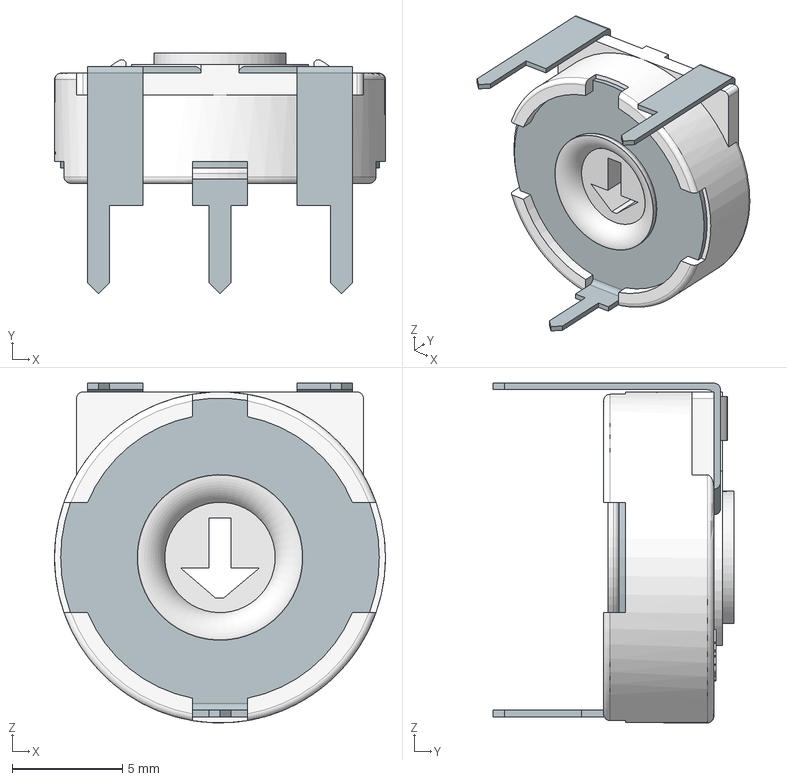
[picture p275: CAD file, 2022-09-10]
_02-realisation/_02-hardware/usb5v3a_v2_pcb/3dmodels/Trimmer_Piher_PT-15.step
15.0 x 10.9 x 15.4 mm
Corps_PT-15
Axe
Broche 1
