MajorLee95/tinyelab/_02-realisation/_03-cao_3D/mesCreations/elementsCommun/dcjack5525/DC5525_01.FCStd

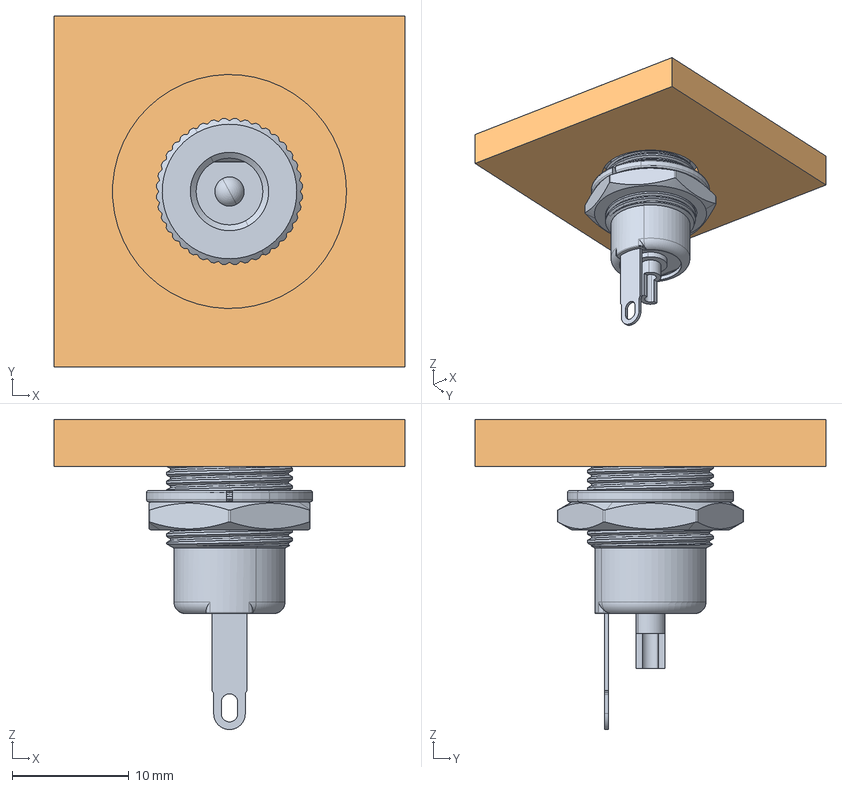
[picture p278: CAD file, 2022-08-03]
_02-realisation/_03-cao_3D/mesCreations/elementsCommun/dcjack5525/DC5525_01.FCStd
30.0 x 30.0 x 26.5 mm
Konektor napajeci_5,5-2,5_DC00990-B
