MajorLee95/tinyelab/_02-realisation/_03-cao_3D/mesCreations/elementsCommun/visTHCM.FCStd

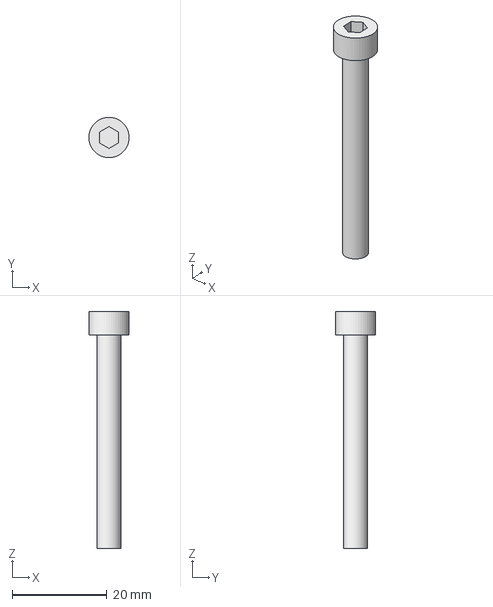
[picture p279: CAD file, 2022-11-23]
_02-realisation/_03-cao_3D/mesCreations/elementsCommun/visTHCM.FCStd
8.49 x 8.50 x 50.0 mm
