MajorLee95/tinyelab/_02-realisation/_03-cao_3D/mesCreations/moduleAlimMultiples/bornier001.FCStd

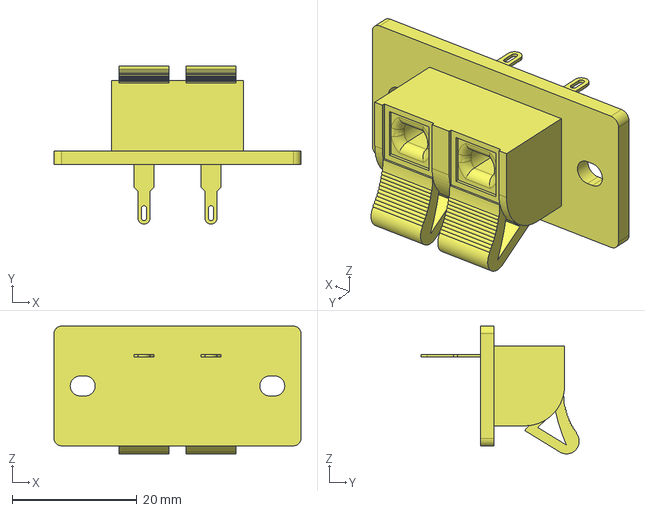
[picture p280: CAD file, 2022-04-17]
_02-realisation/_03-cao_3D/mesCreations/moduleAlimMultiples/bornier001.FCStd
39.6 x 25.4 x 20.5 mm
