MajorLee95/tinyelab/_02-realisation/_03-cao_3D/mesCreations/moduleAlimStabDPS3005/export/ASX1_base_115_DPS3005.3mf

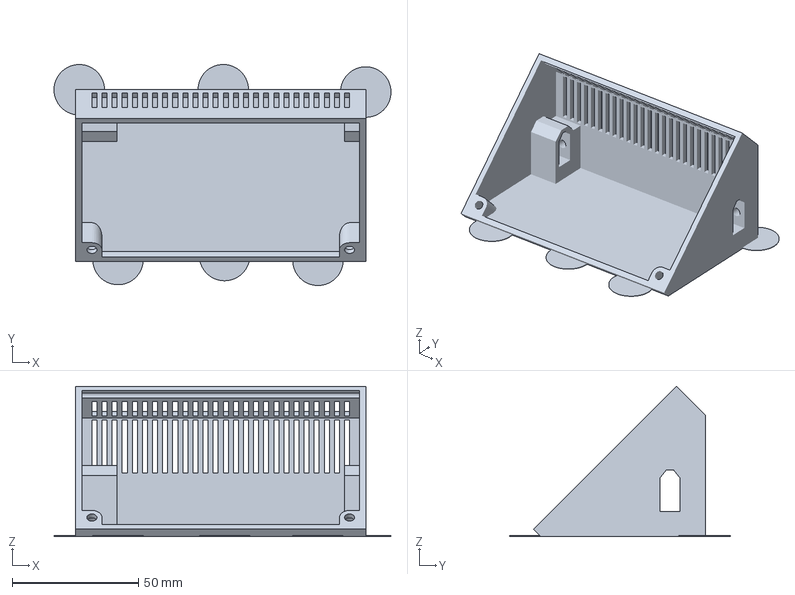
[picture p281: CAD file, 2022-04-17]
_02-realisation/_03-cao_3D/mesCreations/moduleAlimStabDPS3005/export/ASX1_base_115_DPS3005.3mf
133.4 x 87.5 x 59.6 mm
