MajorLee95/tinyelab/_02-realisation/_03-cao_3D/mesCreations/moduleGenFonction/modelsExterieur/Arduino Nano/User Library-C0805-2.step.SLDPRT

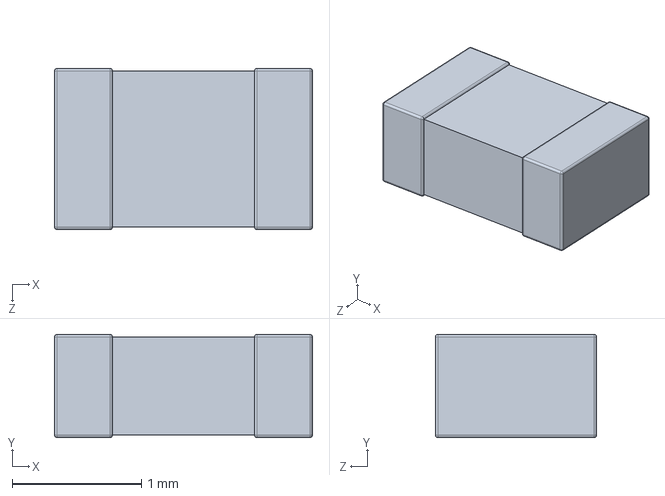
[picture p282: CAD file, 2022-04-20]
_02-realisation/_03-cao_3D/mesCreations/moduleGenFonction/modelsExterieur/Arduino Nano/User Library-C0805-2.step.SLDPRT
2.00 x 0.8 x 1.25 mm
