MajorLee95/tinyelab/_02-realisation/_03-cao_3D/mesCreations/moduleGenFonction/modelsExterieur/i2c-lcd-16-2-1.snapshot.6/Pin Header 4 Bengkok.SLDPRT

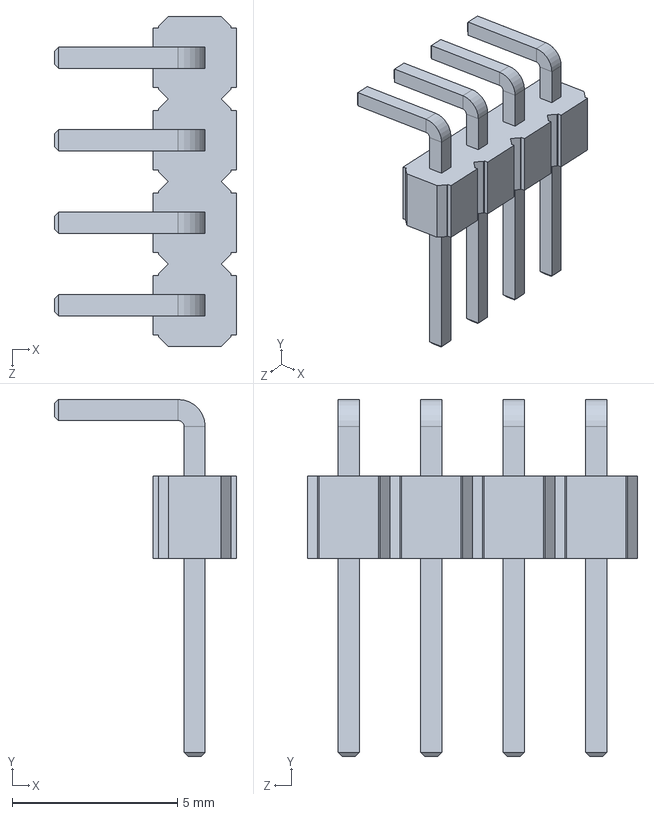
[picture p283: CAD file, 2022-04-20]
_02-realisation/_03-cao_3D/mesCreations/moduleGenFonction/modelsExterieur/i2c-lcd-16-2-1.snapshot.6/Pin Header 4 Bengkok.SLDPRT
5.52 x 10.8 x 10.0 mm
