MajorLee95/tinyelab/_02-realisation/_03-cao_3D/mesCreations/moduleUI/exports/base_115_ModuleUI_009.3mf

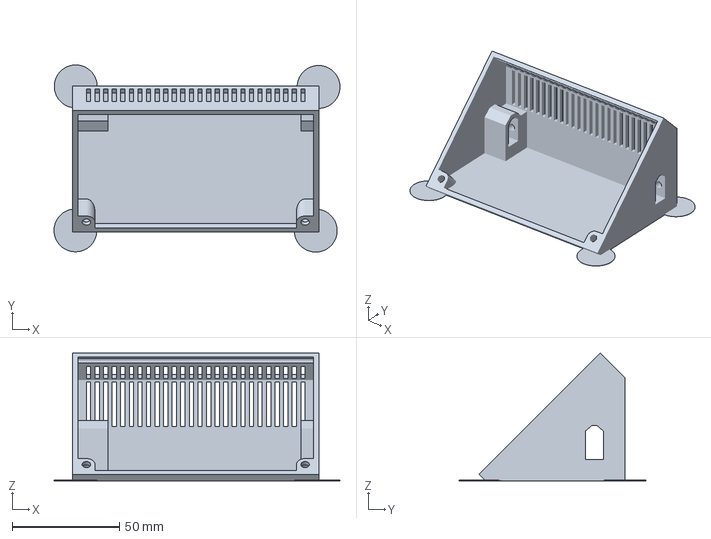
[picture p284: CAD file, 2022-04-17]
_02-realisation/_03-cao_3D/mesCreations/moduleUI/exports/base_115_ModuleUI_009.3mf
133.4 x 87.2 x 59.6 mm
