MajorLee95/tinyelab/_02-realisation/_03-cao_3D/mesCreations/moduleUSB3A/exports/v2_022/epreuvePcbFav.FCStd

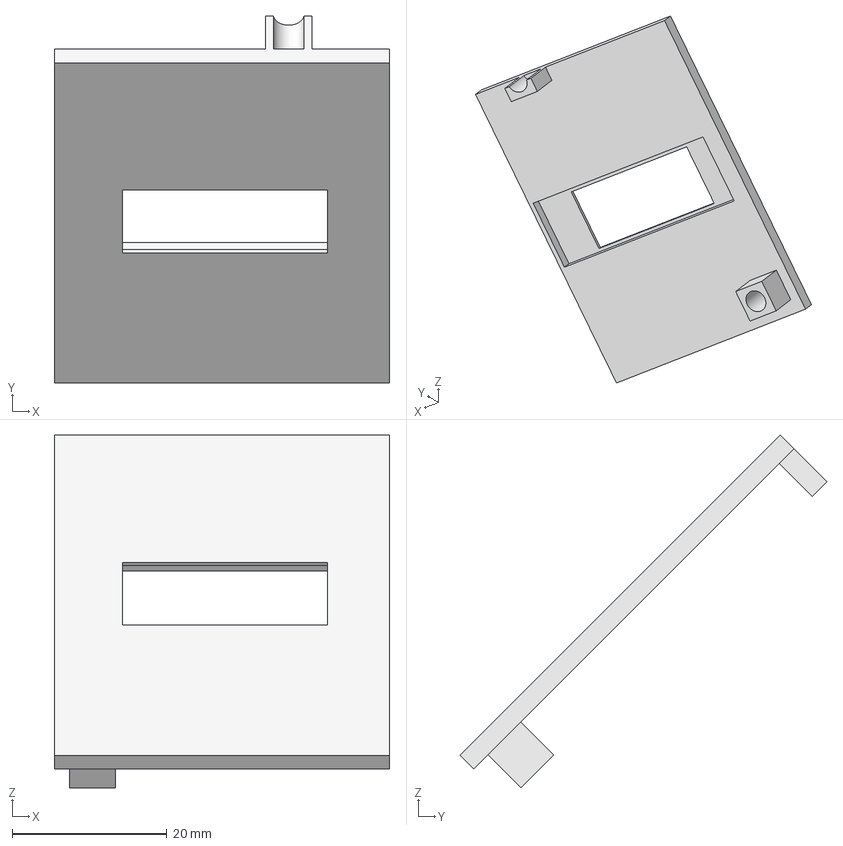
[picture p285: CAD file, 2022-09-10]
_02-realisation/_03-cao_3D/mesCreations/moduleUSB3A/exports/v2_022/epreuvePcbFav.FCStd
43.4 x 47.5 x 45.7 mm
