MajorLee95/tinyelab/_02-realisation/_03-cao_3D/mesCreations/moduleUSB3A/modelsExterns/trimPot/trimPotVis.step

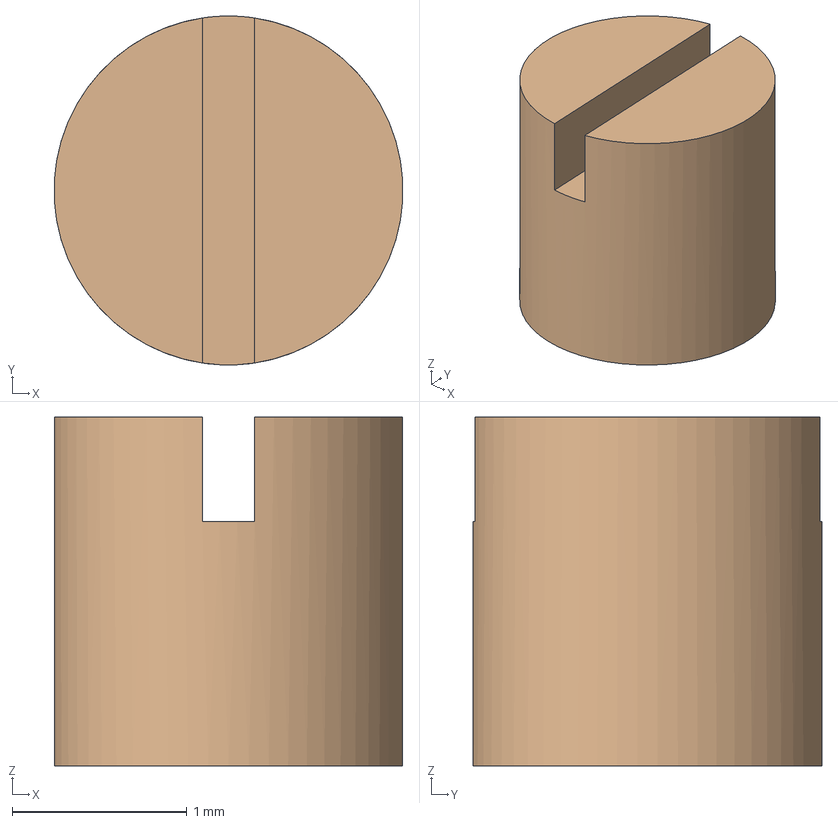
[picture p286: CAD file, 2022-09-10]
_02-realisation/_03-cao_3D/mesCreations/moduleUSB3A/modelsExterns/trimPot/trimPotVis.step
2.00 x 2.00 x 2.00 mm
