MajorLee95/tinyelab/_02-realisation/_03-cao_3D/mesCreations/moduleUSB3A/modelsExterns/usbFem_001.FCStd

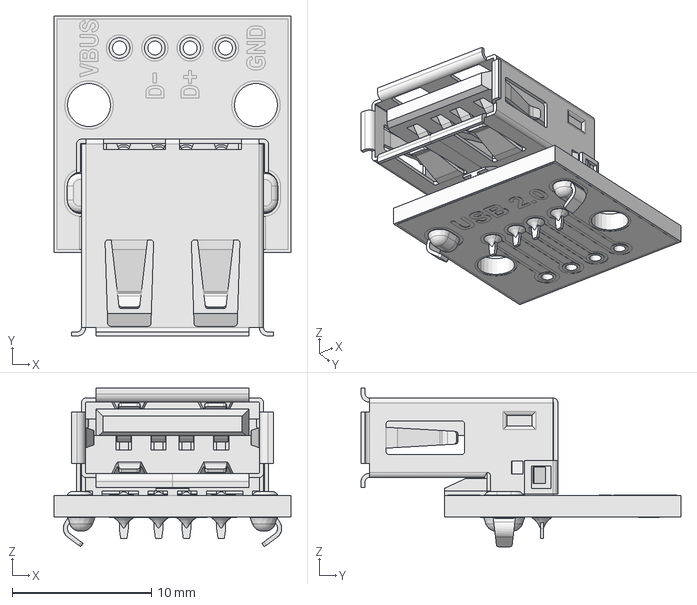
[picture p287: CAD file, 2022-10-22]
_02-realisation/_03-cao_3D/mesCreations/moduleUSB3A/modelsExterns/usbFem_001.FCStd
17.0 x 23.0 x 11.4 mm
