MajorLee95/tinyelab/_02-realisation/_03-cao_3D/mesCreations/moduleUSB5V2ASimple2voies/exports/moduleUSB_IP6505_QC2Sur_base35mm_012-faceAvant.stl

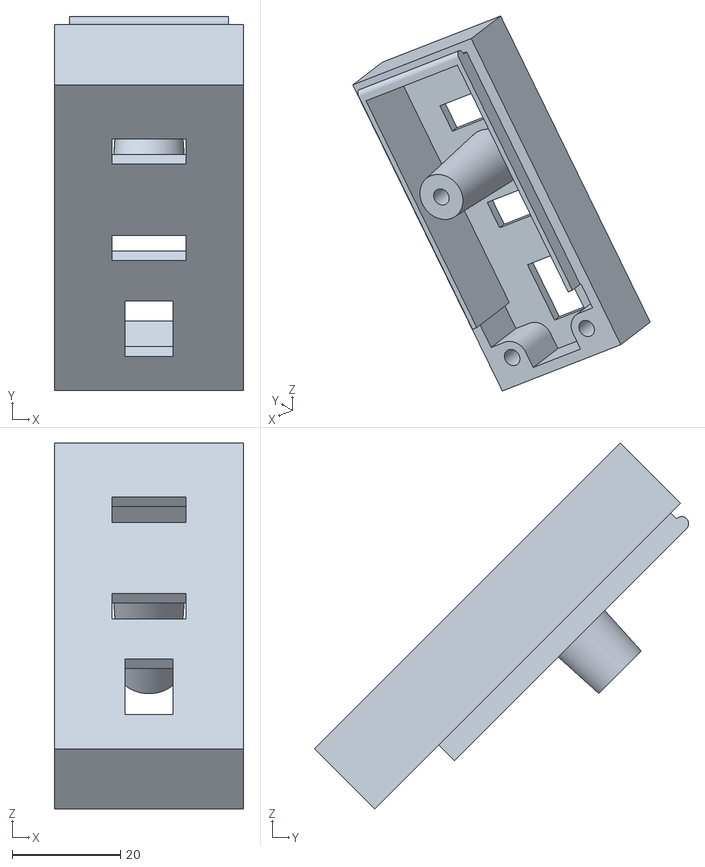
[picture p288: CAD file, 2024-03-21]
_02-realisation/_03-cao_3D/mesCreations/moduleUSB5V2ASimple2voies/exports/moduleUSB_IP6505_QC2Sur_base35mm_012-faceAvant.stl
35.0 x 69.3 x 67.7
