MajorLee95/tinyelab/_02-realisation/_03-cao_3D/mesCreations/moduleUSB5V2ASimple2voies/modelsExternes/soic-package-narrow-8-10-14-and-16-pins-1.snapshot.3/SOIC10 narrow.stp

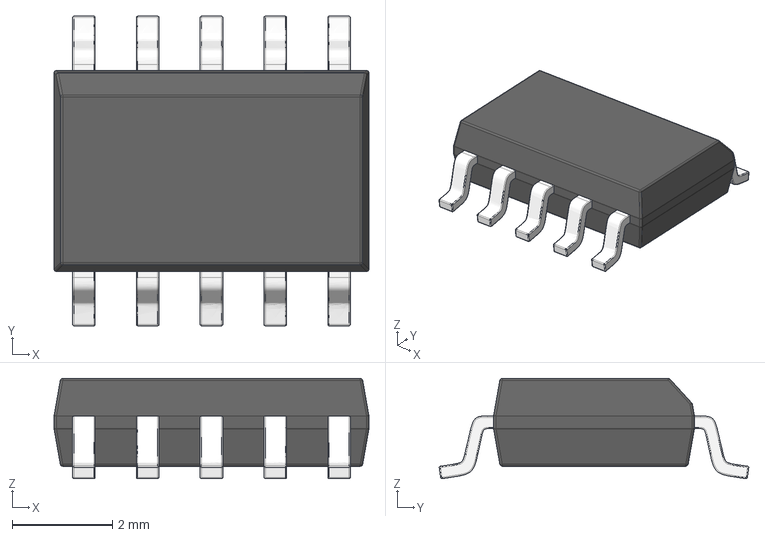
[picture p289: CAD file, 2022-10-08]
_02-realisation/_03-cao_3D/mesCreations/moduleUSB5V2ASimple2voies/modelsExternes/soic-package-narrow-8-10-14-and-16-pins-1.snapshot.3/SOIC10 narrow.stp
6.27 x 6.16 x 2.00 mm
