MajorLee95/tinyelab/_02-realisation/_03-cao_3D/mesCreations/moduleUSB5V2ASimple2voies/moduleUSB_IP6505_QC2Sur_base35mm_012.FCStd

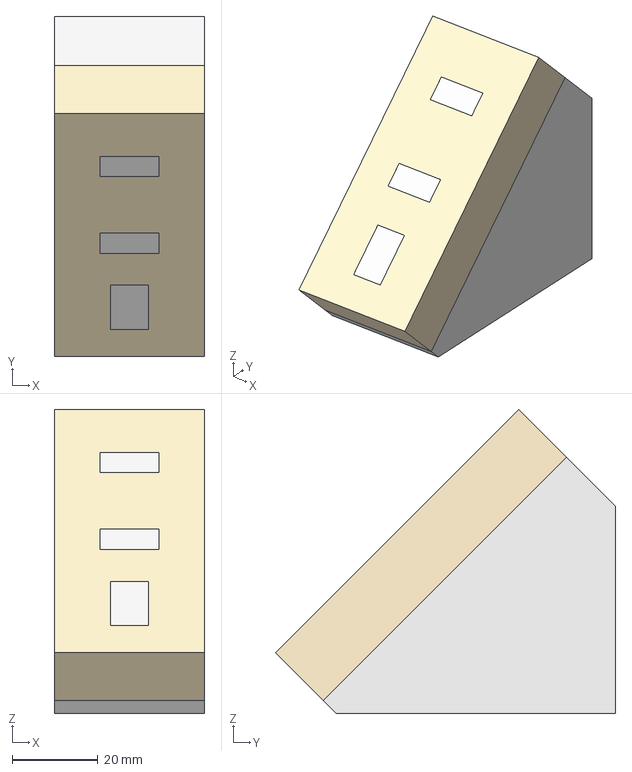
[picture p290: CAD file, 2024-03-21]
_02-realisation/_03-cao_3D/mesCreations/moduleUSB5V2ASimple2voies/moduleUSB_IP6505_QC2Sur_base35mm_012.FCStd
35.0 x 79.1 x 70.7 mm
Base
faceAvant
