MajorLee95/tinyelab/_02-realisation/_03-cao_3D/mesCreations/moduleUSBsimpleDouble/exports/supportUSB.3mf

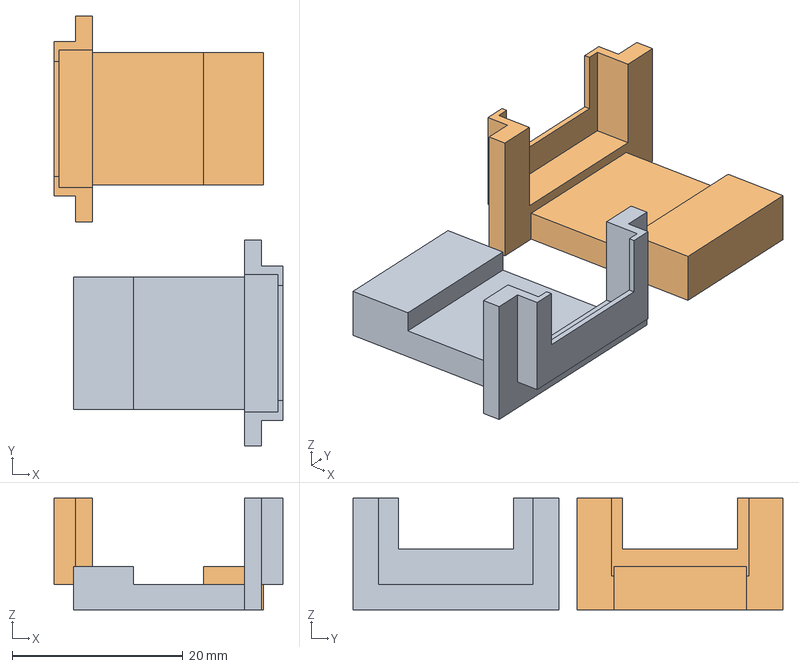
[picture p291: CAD file, 2022-04-17]
_02-realisation/_03-cao_3D/mesCreations/moduleUSBsimpleDouble/exports/supportUSB.3mf
26.8 x 50.4 x 13.1 mm
supportUSB.amf
supportUSB.amf(1)
