MajorLee95/tinyelab/_02-realisation/_03-cao_3D/mesCreations/moduleUSBsimpleDouble/exports/v2_009/ASX1_009_base.3mf

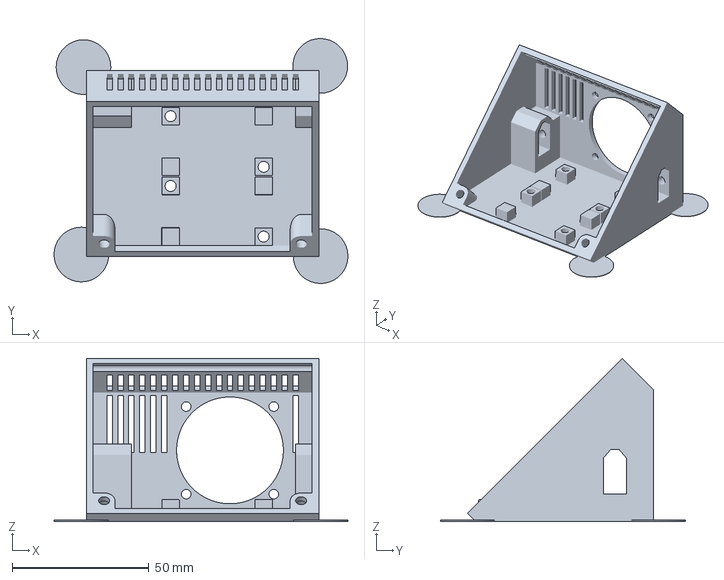
[picture p292: CAD file, 2022-09-10]
_02-realisation/_03-cao_3D/mesCreations/moduleUSBsimpleDouble/exports/v2_009/ASX1_009_base.3mf
107.4 x 89.5 x 59.6 mm
