MajorLee95/tinyelab/_02-realisation/_03-cao_3D/mesCreations/moduleUSBsimpleDouble/modelsExterns/40mm_Fan.step

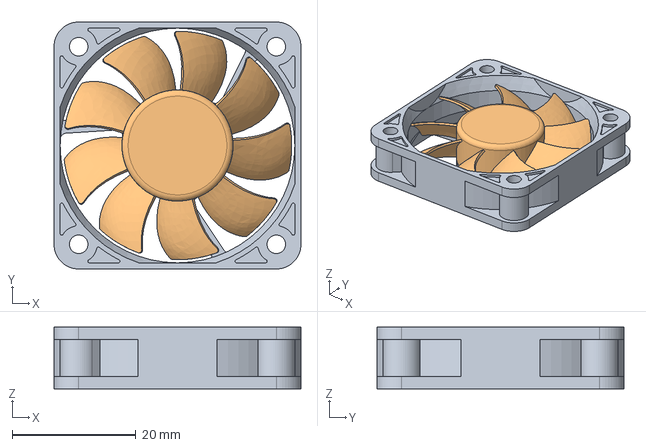
[picture p293: CAD file, 2022-09-10]
_02-realisation/_03-cao_3D/mesCreations/moduleUSBsimpleDouble/modelsExterns/40mm_Fan.step
40.0 x 40.0 x 10.0 mm
