MajorLee95/tinyelab/_02-realisation/_03-cao_3D/mesCreations/moduleVentilo/modelExternes/potar/Potentiometer.step

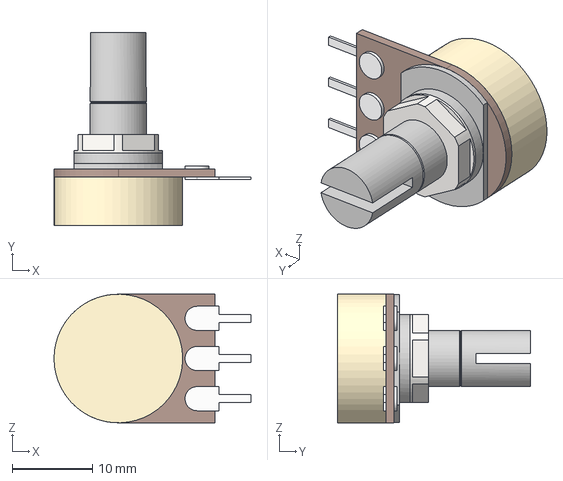
[picture p294: CAD file, 2022-06-22]
_02-realisation/_03-cao_3D/mesCreations/moduleVentilo/modelExternes/potar/Potentiometer.step
24.5 x 24.0 x 16.0 mm
Rotary top
Nut and washer
