MajorLee95/tinyelab/_02-realisation/_03-cao_3D/mesCreations/moduleVoltAmperemetre/export/voltAmperemetre_006_surBase35mm_008.1-base.stl

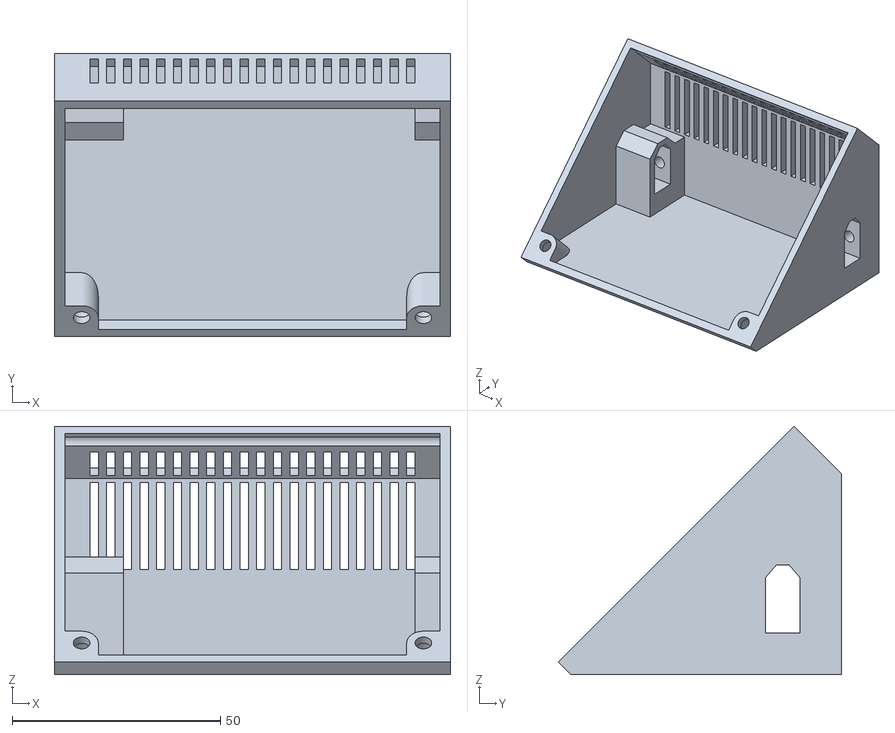
[picture p295: CAD file, 2022-04-20]
_02-realisation/_03-cao_3D/mesCreations/moduleVoltAmperemetre/export/voltAmperemetre_006_surBase35mm_008.1-base.stl
95.0 x 68.0 x 59.6
