MajorLee95/tinyelab/_02-realisation/_03-cao_3D/mesCreations/moduleVoltmètres/export/triplesVoltm_005_surBase35mm_008.1-faceAvant.stl

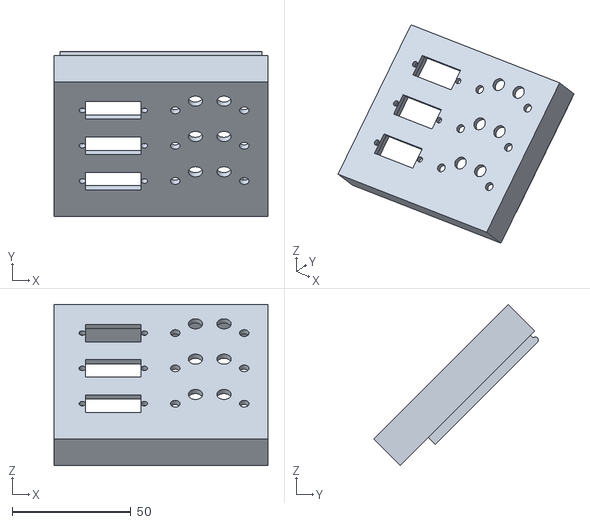
[picture p296: CAD file, 2022-04-23]
_02-realisation/_03-cao_3D/mesCreations/moduleVoltmètres/export/triplesVoltm_005_surBase35mm_008.1-faceAvant.stl
90.0 x 69.3 x 67.7
