MajorLee95/tinyelab/_02-realisation/_03-cao_3D/mesCreations/outillageXT60/barreLaitonOscillo.FCStd

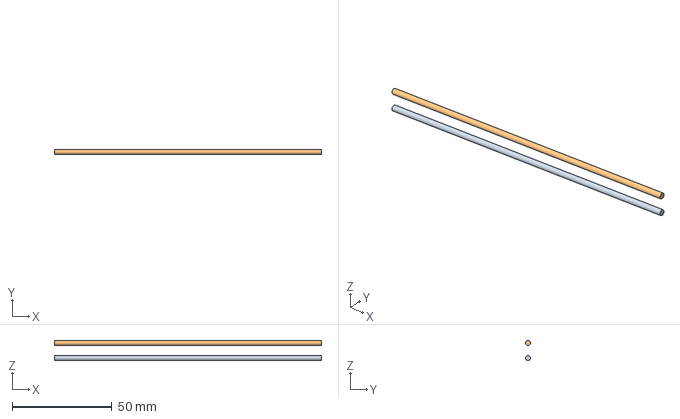
[picture p297: CAD file, 2022-04-17]
_02-realisation/_03-cao_3D/mesCreations/outillageXT60/barreLaitonOscillo.FCStd
133.6 x 2.50 x 10.1 mm
tigeLaiton
tige2
