MajorLee95/tinyelab/_02-realisation/_03-cao_3D/mesCreations/outillageXT60/export/outillageXT_v2_014-outillageFem.stl

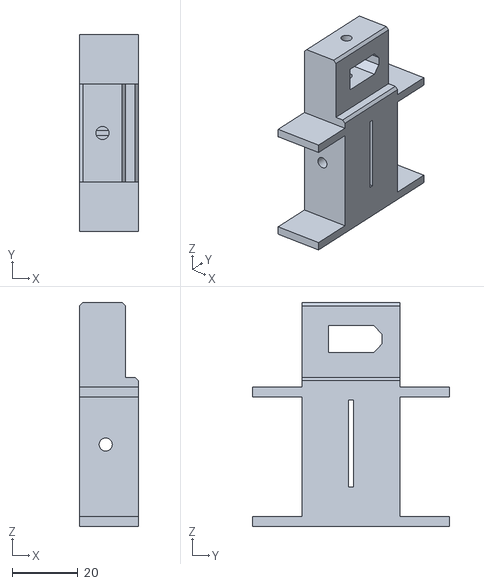
[picture p298: CAD file, 2022-04-23]
_02-realisation/_03-cao_3D/mesCreations/outillageXT60/export/outillageXT_v2_014-outillageFem.stl
18.0 x 60.0 x 68.3
