MajorLee95/tinyelab/_02-realisation/_03-cao_3D/mesCreations/ressourcesExterieure/boitierOscillo/DSO138-SlideSW.stl

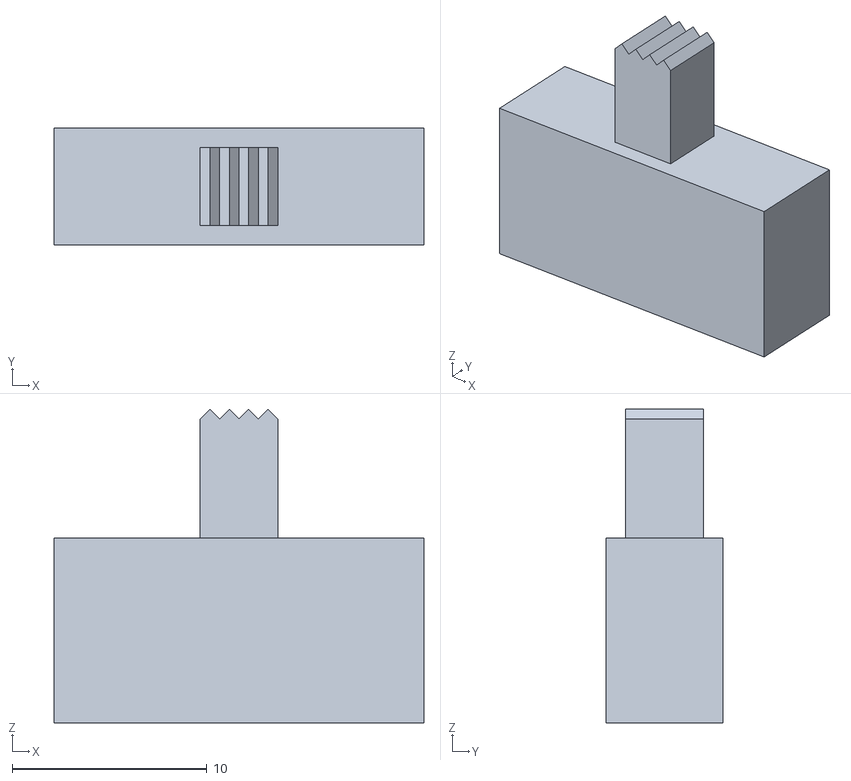
[picture p299: CAD file, 2022-04-17]
_02-realisation/_03-cao_3D/mesCreations/ressourcesExterieure/boitierOscillo/DSO138-SlideSW.stl
19.0 x 6.00 x 16.1
