MajorLee95/tinyelab/_02-realisation/_03-cao_3D/modelAFAVSeparee/stepSources/usb1 v2.step

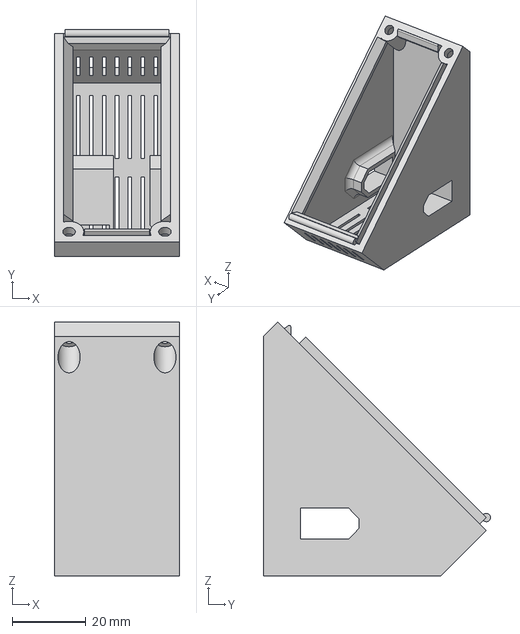
[picture p300: CAD file, 2022-04-17]
_02-realisation/_03-cao_3D/modelAFAVSeparee/stepSources/usb1 v2.step
34.0 x 61.6 x 68.9 mm
