MajorLee95/tinyelab/_02-realisation/_03-cao_3D/sourceOriginaux/05_Fume_Extractor_90mm_fan_cover_v1.stl

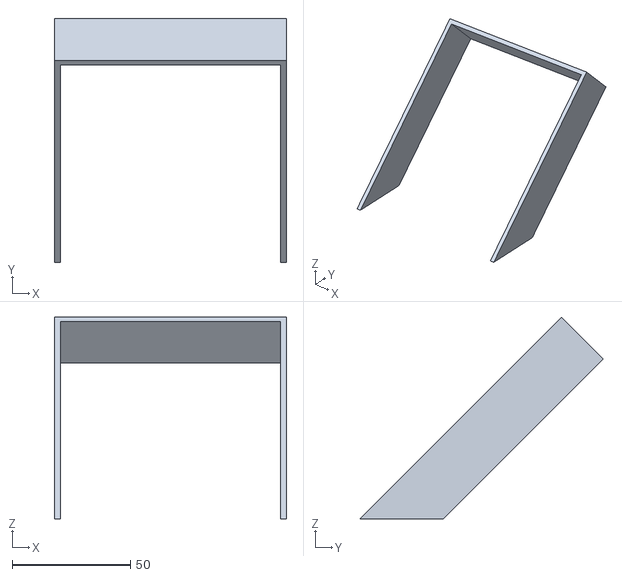
[picture p301: CAD file, 2022-04-17]
_02-realisation/_03-cao_3D/sourceOriginaux/05_Fume_Extractor_90mm_fan_cover_v1.stl
98.0 x 102.9 x 85.2
