MajorLee95/tinyelab/_02-realisation/_03-cao_3D/Tiny E-lab Ts100 alternate stand - 5216290/files/importDansFreeCad.FCStd

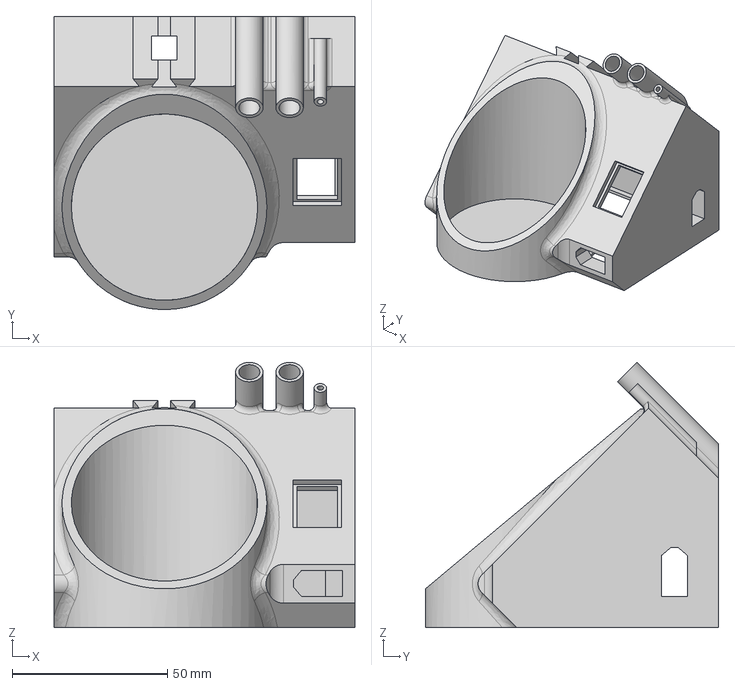
[picture p302: CAD file, 2024-03-21]
_02-realisation/_03-cao_3D/Tiny E-lab Ts100 alternate stand - 5216290/files/importDansFreeCad.FCStd
97.0 x 94.4 x 85.5 mm
