MajorLee95/tinyelab/_02-realisation/_02-hardware/usb5v3a_v2_pcb/3dmodels/128x32-OLED.STEP

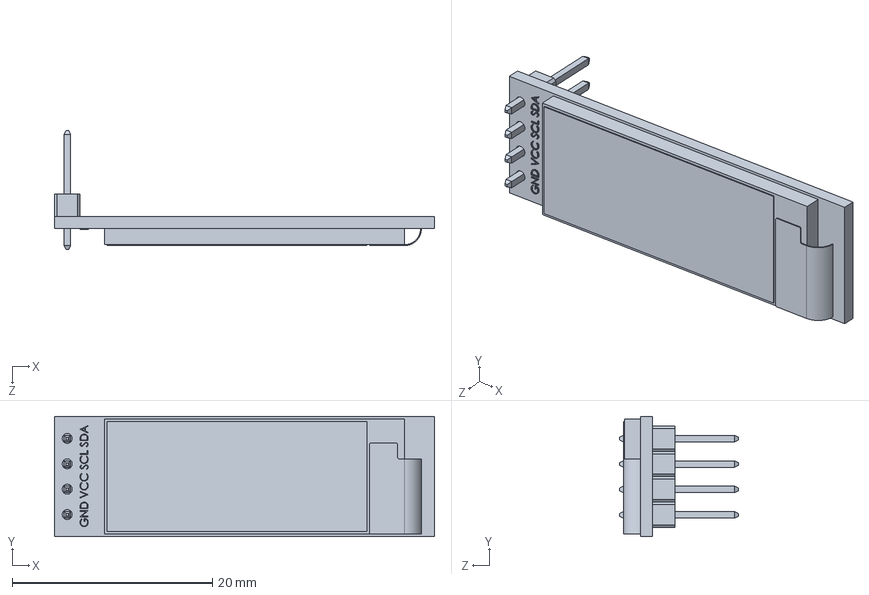
[picture p303: CAD file, 2022-09-10]
_02-realisation/_02-hardware/usb5v3a_v2_pcb/3dmodels/128x32-OLED.STEP
38.0 x 12.0 x 11.9 mm
