MajorLee95/tinyelab/_02-realisation/_03-cao_3D/mesCreations/elementsCommun/ecrouM.FCStd

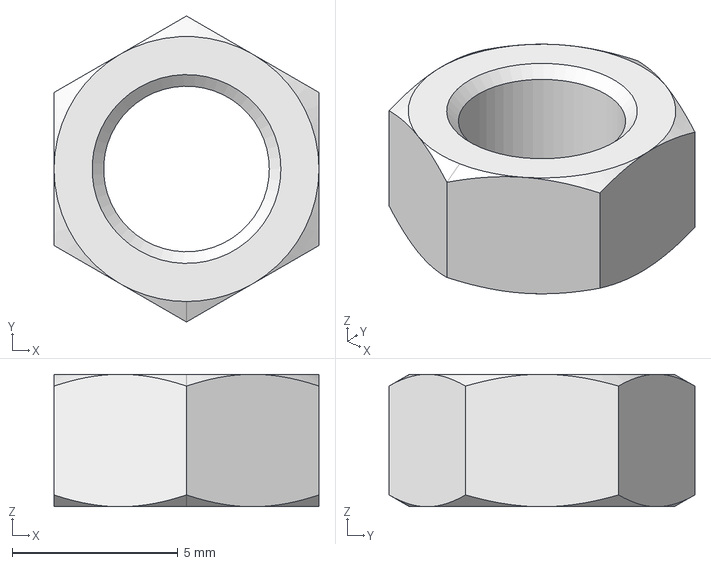
[picture p304: CAD file, 2022-11-23]
_02-realisation/_03-cao_3D/mesCreations/elementsCommun/ecrouM.FCStd
8.00 x 9.24 x 4.00 mm
