MajorLee95/tinyelab/_02-realisation/_03-cao_3D/mesCreations/lidlParckSideBat/visTHCM3x6.FCStd

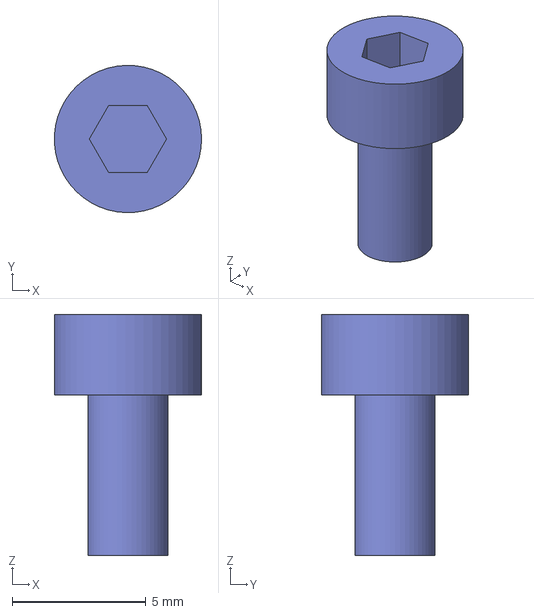
[picture p305: CAD file, 2022-08-03]
_02-realisation/_03-cao_3D/mesCreations/lidlParckSideBat/visTHCM3x6.FCStd
5.49 x 5.50 x 9.00 mm
