MajorLee95/tinyelab/_02-realisation/_03-cao_3D/mesCreations/moduleAlimStabDPS3005/export/base_115_DPS3005.stl

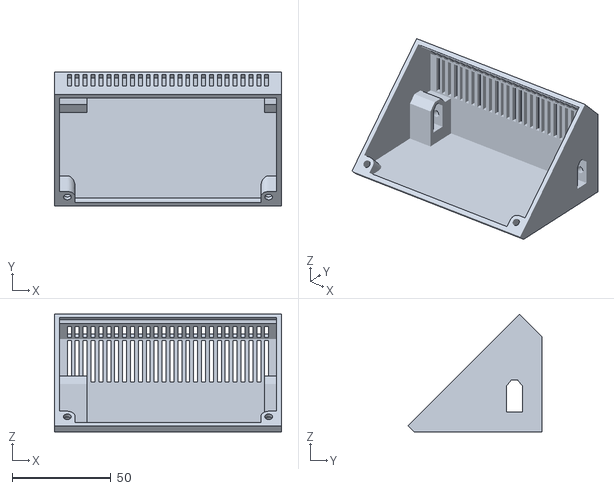
[picture p306: CAD file, 2022-04-17]
_02-realisation/_03-cao_3D/mesCreations/moduleAlimStabDPS3005/export/base_115_DPS3005.stl
115.0 x 68.0 x 59.6
