MajorLee95/tinyelab/(list of files, cad)

Other CAD files:
_02-realisation/_03-cao_3D/mesCreations/moduleUSBsimpleDouble/moduleUSB_SimpleDual_002_SurBase35mm_012.FCStd
_02-realisation/_03-cao_3D/mesCreations/moduleVentilo/modelExternes/switch15x10_003_0.FCStd
_02-realisation/_03-cao_3D/mesCreations/outillageSwitch/outillageSW1500CA_004.FCStd
_02-realisation/_03-cao_3D/mesCreations/moduleGenFonction/modelsExterieur/i2c-lcd-1.snapshot.1/display with i2c.SLDPRT
_02-realisation/_03-cao_3D/mesCreations/moduleUSBsimpleDouble/modelsExterns/XL4015DCDC_002.FCStd
_02-realisation/_03-cao_3D/mesCreations/outillageSwitch/export/outSW1500.stl
_02-realisation/_03-cao_3D/mesCreations/ressourcesExterieure/volt-amp.STEP
_02-realisation/_03-cao_3D/Tiny E-lab Ts100 alternate stand - 5216290/files/ts100 model v1.step
_02-realisation/_03-cao_3D/mesCreations/lidlParckSideBat/moduleLidl_001_surBase35mm_009.1.FCStd
_02-realisation/_03-cao_3D/mesCreations/moduleOscillo/export/favOscillo_009.stl
_02-realisation/_03-cao_3D/mesCreations/moduleOscillo/oscillo_009_surBase35mm_007.5.FCStd
_02-realisation/_03-cao_3D/mesCreations/moduleUSB3A/caleOled001.FCStd
_02-realisation/_03-cao_3D/mesCreations/elementsCommun/dcjack5521/dc5521.FCStd
_02-realisation/_03-cao_3D/mesCreations/elementsCommun/dcjack5525/Connector_5,5-2,5_DC00990-B.stp
_02-realisation/_02-hardware/usb5v3a_v2_fav/fav221015_1206.dxf
_02-realisation/_02-hardware/usb5v3a_v2_fav/fav221015_1206_decoupe.dxf
_02-realisation/_02-hardware/usb5v3a_v2_pcb/3dmodels/CJMCU-219 INA219.step
_02-realisation/_03-cao_3D/Tiny E-lab Ts100 alternate stand - 5216290/files/ts100_holder_v14_arm-old-noinsert.stl
_02-realisation/_03-cao_3D/Tiny E-lab Ts100 alternate stand - 5216290/files/ts100_holder_v20.f3z
_02-realisation/_03-cao_3D/Tiny E-lab Ts100 alternate stand - 5216290/files/ts100_holder_v21.stl
_02-realisation/_03-cao_3D/Tiny E-lab Ts100 alternate stand - 5216290/files/ts100_holder_v22_arm_for_insert.stl
_02-realisation/_03-cao_3D/Tiny E-lab Ts100 alternate stand - 5216290/files/ts100holder_v1_exportJSO_Fusion.step
_02-realisation/_03-cao_3D/mesCreations/elementsCommun/028voltm_003.FCStd
_02-realisation/_03-cao_3D/mesCreations/elementsCommun/DCDCLM2596_001.FCStd
_02-realisation/_03-cao_3D/mesCreations/elementsCommun/DCDCLM2596_avecVisInsert_002.FCStd
_02-realisation/_03-cao_3D/mesCreations/elementsCommun/bnc_002.FCStd
_02-realisation/_03-cao_3D/mesCreations/elementsCommun/embaseBanane.FCStd
_02-realisation/_03-cao_3D/mesCreations/elementsCommun/porteFuse_008.1.FCStd
_02-realisation/_03-cao_3D/mesCreations/elementsCommun/visPointeauM3x10.FCStd
_02-realisation/_03-cao_3D/mesCreations/elementsCommun/visTHCM3x10.FCStd
_02-realisation/_03-cao_3D/mesCreations/elementsCommun/visTHCM3x20.FCStd
_02-realisation/_03-cao_3D/mesCreations/elementsCommun/visTHCM3x35.FCStd
_02-realisation/_03-cao_3D/mesCreations/elementsCommun/visTHCM3x6.FCStd
_02-realisation/_03-cao_3D/mesCreations/elementsCommun/visTHCM3xconfig.FCStd
_02-realisation/_03-cao_3D/mesCreations/elementsCommun/voltm_003.FCStd
_02-realisation/_03-cao_3D/mesCreations/elementsCommun/xt60Fem.FCStd
_02-realisation/_03-cao_3D/mesCreations/elementsCommun/xt_001.FCStd
_02-realisation/_03-cao_3D/mesCreations/lidlParckSideBat/LIDLBatPlug_006.FCStd
_02-realisation/_03-cao_3D/mesCreations/lidlParckSideBat/porteFuse_008.FCStd
_02-realisation/_03-cao_3D/mesCreations/lidlParckSideBat/ruthex.FCStd
_02-realisation/_03-cao_3D/mesCreations/lidlParckSideBat/switch.FCStd
_02-realisation/_03-cao_3D/mesCreations/moduleGenFonction/modelsExterieur/Arduino Nano/0805 Chip SMD LED (2x1.2mm).step.SLDPRT
_02-realisation/_03-cao_3D/mesCreations/moduleGenFonction/modelsExterieur/Arduino Nano/102 RESISTOR PACK.SLDPRT
_02-realisation/_03-cao_3D/mesCreations/moduleGenFonction/modelsExterieur/Arduino Nano/189 RESISTOR PACK.SLDPRT
_02-realisation/_03-cao_3D/mesCreations/moduleGenFonction/modelsExterieur/Arduino Nano/1x15 Male Pin Header.SLDPRT
_02-realisation/_03-cao_3D/mesCreations/moduleGenFonction/modelsExterieur/Arduino Nano/C5 FD10 Reg.SLDPRT
_02-realisation/_03-cao_3D/mesCreations/moduleGenFonction/modelsExterieur/Arduino Nano/Diode MBR0520.SLDPRT
_02-realisation/_03-cao_3D/mesCreations/moduleGenFonction/modelsExterieur/Arduino Nano/Mini B USB.SLDPRT
_02-realisation/_03-cao_3D/mesCreations/moduleGenFonction/modelsExterieur/Arduino Nano/PLD-2.step.SLDPRT
_02-realisation/_03-cao_3D/mesCreations/moduleGenFonction/modelsExterieur/Arduino Nano/Pushbutton3x4x2.SLDPRT
_02-realisation/_03-cao_3D/mesCreations/moduleGenFonction/modelsExterieur/Arduino Nano/SMD Crystal 16MHz.SLDPRT
_02-realisation/_03-cao_3D/mesCreations/moduleGenFonction/modelsExterieur/Arduino Nano/Tantalum Capacitor 475C A3216.SLDPRT
_02-realisation/_03-cao_3D/mesCreations/moduleGenFonction/modelsExterieur/Arduino Nano/atmega328.SLDPRT
_02-realisation/_03-cao_3D/mesCreations/moduleGenFonction/modelsExterieur/display lcd 1602/MODULO_DISPLAY_LCD1602.CATProduct
_02-realisation/_03-cao_3D/mesCreations/moduleGenFonction/modelsExterieur/display lcd 1602/SMD RESISTOR_0603.CATPart
_02-realisation/_03-cao_3D/mesCreations/moduleGenFonction/modelsExterieur/display lcd 1602/SMD RESISTOR_1206.CATPart
_02-realisation/_03-cao_3D/mesCreations/moduleGenFonction/modelsExterieur/i2c-lcd-16-2-1.snapshot.6/Draw Part & Assembly.SLDDRW
_02-realisation/_03-cao_3D/mesCreations/moduleGenFonction/modelsExterieur/i2c-lcd-16-2-1.snapshot.6/IC I2C.SLDPRT
_02-realisation/_03-cao_3D/mesCreations/moduleGenFonction/modelsExterieur/i2c-lcd-16-2-1.snapshot.6/LED.SLDPRT
_02-realisation/_03-cao_3D/mesCreations/moduleGenFonction/modelsExterieur/i2c-lcd-16-2-1.snapshot.6/PAPAN.SLDPRT
_02-realisation/_03-cao_3D/mesCreations/moduleGenFonction/modelsExterieur/i2c-lcd-16-2-1.snapshot.6/POTENSIO.SLDPRT
_02-realisation/_03-cao_3D/mesCreations/moduleGenFonction/modelsExterieur/i2c-lcd-16-2-1.snapshot.6/ojumper 2 pin.SLDPRT
_02-realisation/_03-cao_3D/mesCreations/moduleGenFonction/modelsExterieur/i2c-lcd-16-2-1.snapshot.6/potentio.SLDPRT
_02-realisation/_03-cao_3D/mesCreations/moduleOscillo/DSO138 Oscilloscope.STEP
_02-realisation/_03-cao_3D/mesCreations/moduleOscillo/DSO138_etudeBoitier.FCStd
_02-realisation/_03-cao_3D/mesCreations/moduleOscillo/export/ASX1_base_150_Oscillo_007.3mf
_02-realisation/_03-cao_3D/mesCreations/moduleOscillo/export/ASX1_favOscillo_007.3mf
_02-realisation/_03-cao_3D/mesCreations/moduleOscillo/export/base_150_Oscillo_007.stl
_02-realisation/_03-cao_3D/mesCreations/moduleOscillo/export/favOscillo_007.stl
_02-realisation/_03-cao_3D/mesCreations/moduleUI/exports/base_115_ModuleUI_009.stl
_02-realisation/_03-cao_3D/mesCreations/moduleUI/exports/base_115_ModuleUI_009_10h6.3mf
_02-realisation/_03-cao_3D/mesCreations/moduleUI/exports/base_ModuleUI_009.3mf
_02-realisation/_03-cao_3D/mesCreations/moduleUI/exports/fav_moduleUI_012_Sur_base35mm_007.5.stl
_02-realisation/_03-cao_3D/mesCreations/moduleUI/exports/moduleUI_017base.stl
_02-realisation/_03-cao_3D/mesCreations/moduleUSB3A/exports/v2_022/ASX1_cale001.3mf
_02-realisation/_03-cao_3D/mesCreations/moduleUSB3A/exports/v2_022/faceAvant_epreuveoled.step
_02-realisation/_03-cao_3D/mesCreations/moduleUSB3A/exports/v2_022/faceAvant_epreuveoled.stl
_02-realisation/_03-cao_3D/mesCreations/moduleUSB3A/exports/v2_022/moduleUSB3A_022_fav.stl
_02-realisation/_03-cao_3D/mesCreations/moduleUSB3A/modelsExterns/Fan 30mm.step
_02-realisation/_03-cao_3D/mesCreations/moduleUSB3A/modelsExterns/XL4015DCDC.FCStd
_02-realisation/_03-cao_3D/mesCreations/moduleUSB3A/modelsExterns/XL4015DCDC_CCCV_001.FCStd
_02-realisation/_03-cao_3D/mesCreations/moduleUSB3A/modelsExterns/bendedTO220.FCStd
_02-realisation/_03-cao_3D/mesCreations/moduleUSB3A/modelsExterns/fan30mm.FCStd
_02-realisation/_03-cao_3D/mesCreations/moduleUSB3A/modelsExterns/fan40mm_001.FCStd
_02-realisation/_03-cao_3D/mesCreations/moduleUSB3A/modelsExterns/ina219_001.FCStd
_02-realisation/_03-cao_3D/mesCreations/moduleUSB3A/modelsExterns/oled128x32_001.FCStd
_02-realisation/_03-cao_3D/mesCreations/moduleUSB3A/modelsExterns/theBoard001.FCStd
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
