MajorLee95/tinyelab/_02-realisation/_02-hardware/oscillo/Schematic_138mini_analog.pdf

V1
V2

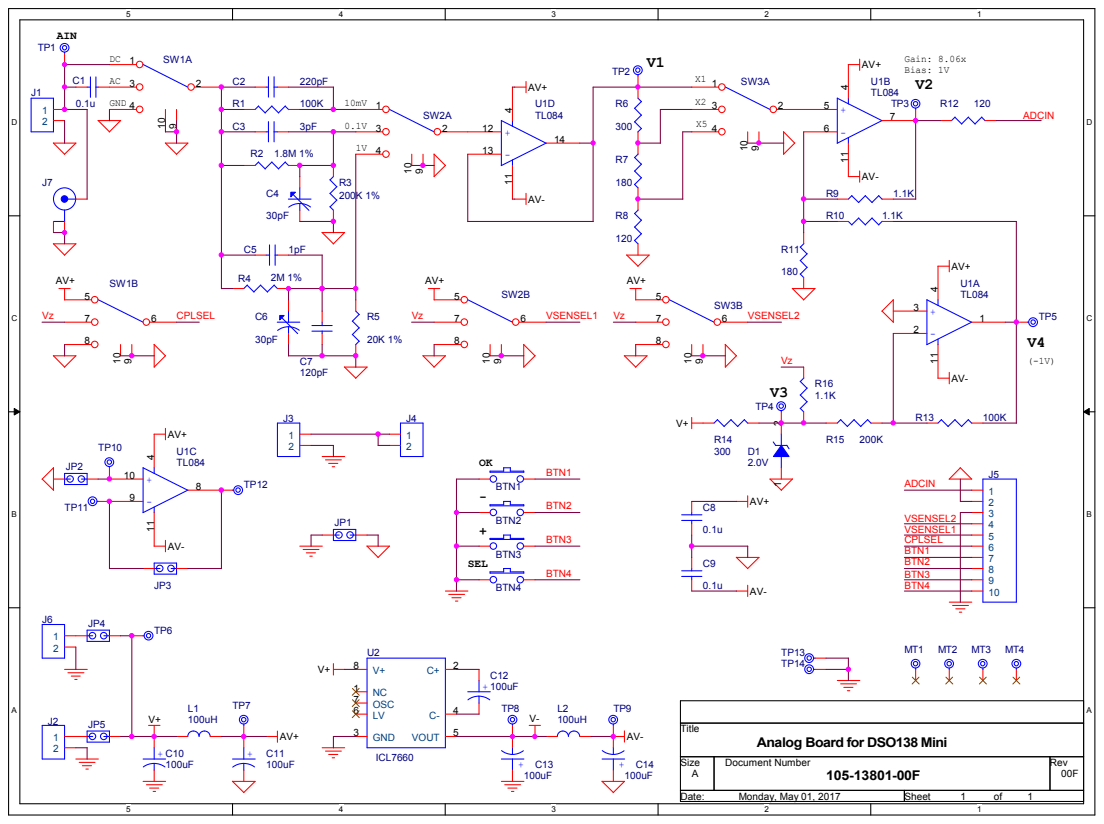
[picture p318: page 1]

AIN TP1

Analog Board for DSO138 Mini

Size A | Document Number 105-13801-00F | Rev 00F

Date: Monday, May 01, 2017 | Sheet 1 of 1
