MajorLee95/tinyelab/_01-docs/source/fichiersJoints/C1500AT_2711451.pdf

# 1500 Standard & 1300 High Inrush Switches

### 150A to EN61058-1 and 16A 250Vac

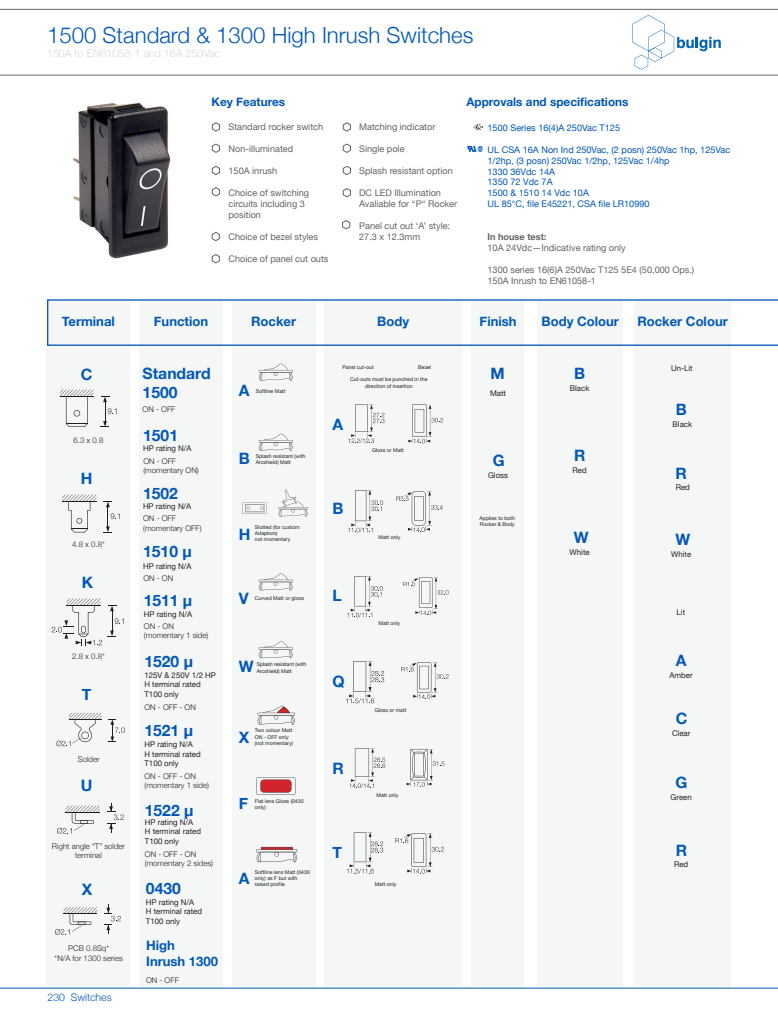
[picture p319: page 1]
230 Switches; Key Features; Terminal; Function; Rocker; Body; Finish Body Colour Rocker Colour; Solder U; PCB 0.8Sq* *N/A for 1300 series; ON - OFF; Standard 1500; ON - OFF (momentary ON); HP rating N/A; ON - OFF (momentary OFF); ON - ON (momentary 1 side); 125V & 250V 1/2 HP H terminal rated; ON - OFF - ON (momentary 1 side); HP rating N/A H terminal rated T100 only; ON - OFF - ON (momentary 2 sides); 1522 μ HP rating N/A H terminal rated T100 only; High Inrush 1300; A Softline Matt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

Approvals and specifications

Standard rocker switch
Non-illuminated
150A inrush
Choice of switching
circuits including 3
position
Choice of bezel styles
Choice of panel cut outs

Matching indicator
Single pole
Splash resistant option
DC LED Illumination
Avaliable for “P“ Rocker
Panel cut out ‘A’ style:

1500 Series 16(4)A 250Vac T125
UL CSA 16A Non Ind 250Vac, (2 posn) 250Vac 1hp, 125Vac
1/2hp, (3 posn) 250Vac 1/2hp, 125Vac 1/4hp
1330 36Vdc 14A
1350 72 Vdc 7A
1500 & 1510 14 Vdc 10A
UL 85°C, file E45221, CSA file LR10990

In house test:
10A 24Vdc—Indicative rating only
1300 series 16(6)A 250Vac T125 5E4 (50,000 Ops.)
150A Inrush to EN61058-1

Cut-outs must be punched in the
direction of insertion

Splash resistant (with B Arcshield) Matt

Gloss or Matt

Applies to both
Rocker & Body

Adaptors) H not momentary
Slotted (for custom

V Curved Matt or gloss

Splash resistant (with W Arcshield) Matt

T100 only
ON - OFF - ON

Gloss or matt

ON - OFF only X (not momentary)
Two colour Matt

Flat lens Gloss (0430 F only)

Right angle “T” solder
terminal

only) as F but with A raised profile
Softline lens Matt (0430

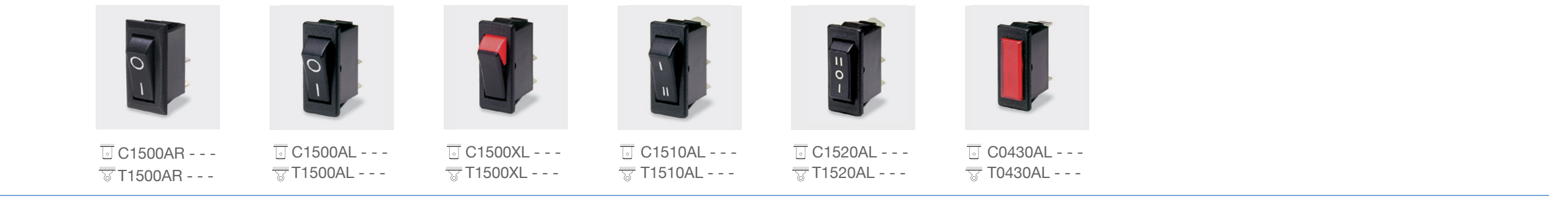
[picture p320: figure]

### Switches 231

## Examples

## Dimensions

Panel thickness
A,Q 0.75 to 3.3mm
L,B,T 0.75 to 2.5mm
R 0.75 to 3.0mm

* For cut-out details
on momentary switches
call sales

## Splash Resistance

1500 W and B splash resistant options
Feather edge seals and a close fitting collar protect current carrying parts from moisture.
B option has Hytrel collar/seals for enhanced protection.

1300 High inrush, positive break switching
The 1300 series mechanism ensures contact welds formed at switch-on are positively separated by the plunger tube acting directly on the step in the moving contact.
Lamp Voltage Insert Colour | Legend | Legend Colour | Options

Finish
Matt is standard.
Colour
Call sales for custom colours. A full range is available for large orders.
Legend printing
Select from the examples or call sales for custom legends. Lamp voltage
Call sales for details.
Blanking plates A0434 - -
Dummy units to fill unused panel holes.
Protective cover
Snaps on to A, L, Q or T bodies (add G after body code in
cat no.), this reduces panel thickness by 1mm.

Panel sealing washer W46 is available for the same body sizes, this reduces panel thickness by a further 0.8mm.
Covers are not suitable for momentary types.

For all options call sales.

UL CSA 20A 250Vac 1hp, 125Vac 1/2hp UL 85°C, file E45221, CSA file LR10990

### In house test:

20A 24Vdc—Indicative rating only
BioCote antimicrobial additive. Independently verified to ISO22196:2007.
3mm contact gap except if marked μ.

Blank

_

12V Filament

7

24Vdc Filament

8

250V Neon

3

125V Neon

2

Blank

_

White

W

Red

R

Blank

_ | Blank

_

602A

White

W

Black

B

# 5500 Lit Rocker Series

### 10A 250Vac

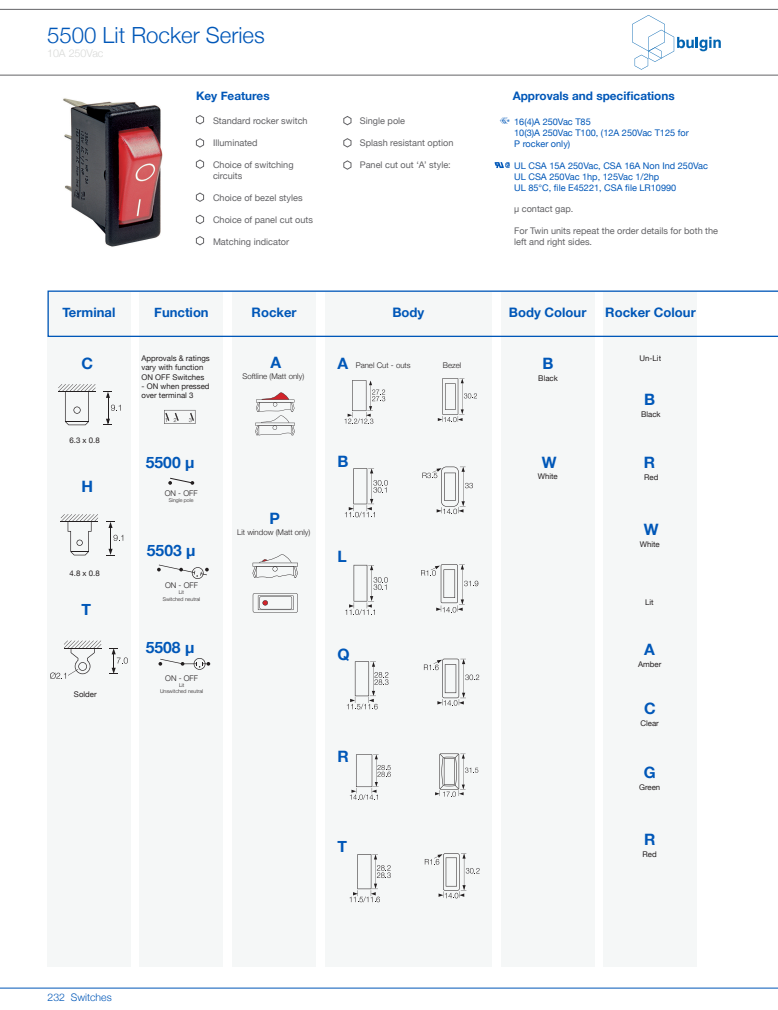
[picture p321: page 3]
Key Features; Terminal; Function; Rocker; Body; Body Colour Rocker Colour; Solder; ON - OFF Single pole; Switched neutral; Unswitched neutral; A Panel Cut - outs; Bezel; Black; White; Amber; Red; Green; Clear; Un-Lit; Lit

Approvals and specifications

Standard rocker switch
Illuminated
Choice of switching
circuits
Choice of bezel styles
Choice of panel cut outs
Matching indicator

Single pole
Splash resistant option
Panel cut out ‘A’ style:

16(4)A 250Vac T85
10(3)A 250Vac T100, (12A 250Vac T125 for
P rocker only)
UL CSA 15A 250Vac, CSA 16A Non Ind 250Vac
UL CSA 250Vac 1hp, 125Vac 1/2hp
UL 85°C, file E45221, CSA file LR10990
μ contact gap.
For Twin units repeat the order details for both the
left and right sides.

Approvals & ratings
vary with function
ON OFF Switches
- ON when pressed
over terminal 3

Softline (Matt only)

Lit window (Matt only)

ON - OFF Lit

Twin units
Two single switches or a switch and an indicator light can be assembled side by side in one double pole body.
For 5500 range panel cut-out details (L, B and
T) call sales.

For twin units the first set of order format details refer to the left hand unit, when looking at the front of the assembly. (This has terminal numbers 1, 2 & 3)

C5503AL - - - | C5500AL - - - | C5503PL - - - | C5503A/C5430AL | C5503A/C5503AL | C5503P/C5503PL

## Examples

Finish
Matt is standard.
Colour
Call factory for custom colours.
A full range is available for large orders. Legend printing
Select from the examples or
call factory for custom legends.
Lamp voltage
Call factory for details.
Blanking plate A0434 - - (SP) A0494 - - (DP) Dummy units to fill unused panel holes. Protective cover
Snaps on to A, L, Q or T bodies (add G after body in cat no.), this reduces panel thickness by 1.00mm.

Panel sealing washers W46 (Single Pole) and W42 (Double Pole) are available for these body types, this reduces panel thickness by 2mm.

For all options call the factory.

Lamp Voltage | Legend | Legend Colour | Options

## Dimensions

Panel thickness
A,Q
L,B,T
R

0.75 to 3.3mm
0.75 to 2.5mm
0.75 to 3.0mm

Terminal spacing -
Poles 10.8 between centres (twin units)

Blank

_

5

6

12V Filament

7

24Vdc Filament

8

250V Neon

3

125V Neon

2

Blank

_

602A

Blank

_

White

W

Black

B

12Vdc LED (P Rocker)
IF = 20-30mA

24Vdc LED (P Rocker)
IF = 20-30mA

# 1500 Twin Units Switches and Indicators

### 16A 250Vac

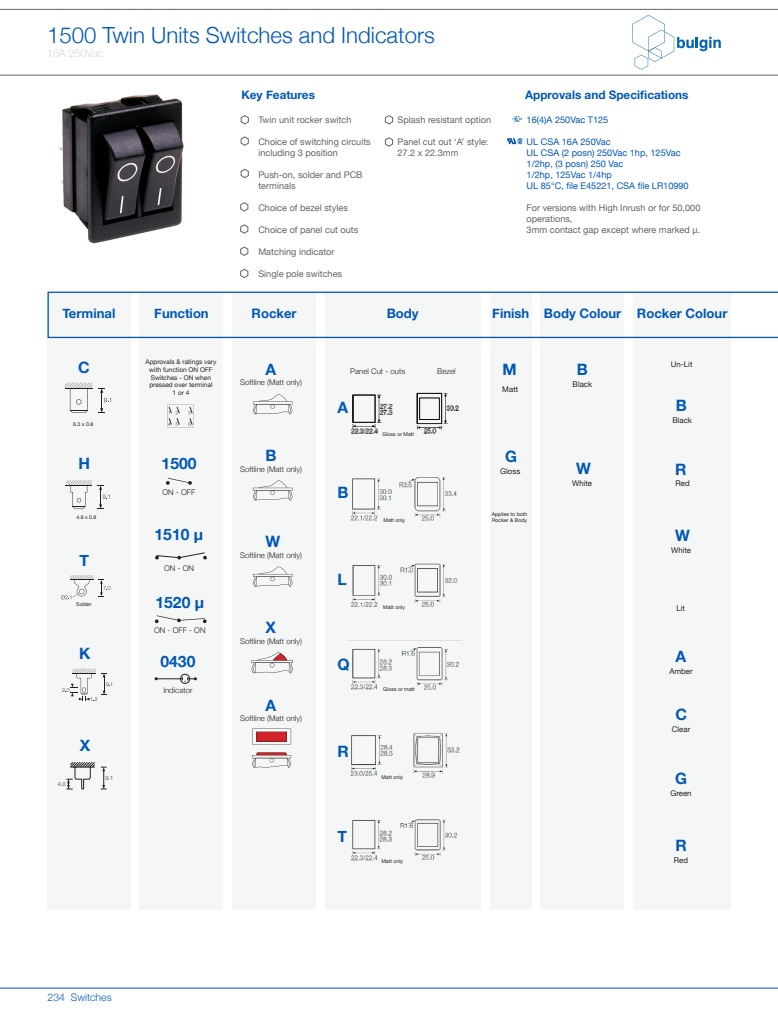
[picture p322: page 5]
Solder; Key Features; Panel Cut - outs; Bezel; Softline (Matt only); ON - OFF 1510 μ; Indicator; Terminal; Function; Rocker; Body; Finish Body Colour Rocker Colour; Matt; Gloss; Black; White; Amber; Red; Green; Clear; Un-Lit; Lit; Matt only

Approvals and Specifications

Twin unit rocker switch
Choice of switching circuits
including 3 position
Push-on, solder and PCB
terminals
Choice of bezel styles
Choice of panel cut outs
Matching indicator
Single pole switches

Splash resistant option
Panel cut out ‘A’ style:

16(4)A 250Vac T125
UL CSA 16A 250Vac
UL CSA (2 posn) 250Vac 1hp, 125Vac
1/2hp, (3 posn) 250 Vac
1/2hp, 125Vac 1/4hp
UL 85°C, file E45221, CSA file LR10990
For versions with High Inrush or for 50,000
operations,
3mm contact gap except where marked μ.

Approvals & ratings vary
with function ON OFF
Switches - ON when
pressed over terminal

Softline (Matt only)

Gloss or Matt

Applies to both
Rocker & Body

ON - OFF - ON

Gloss or matt

C1500A/C1500AL | C1500A/C0430AL | C1500X/C1500XL | C1520A/C1510AL | C1500A/C1520AL | C0430A/C0430AL

## Examples

## Dimensions

Panel thickness
A,Q
L,B,T
R

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

0.75 to 3.3mm
0.75 to 2.5mm
0.75 to 3.0mm

For twin units the first set of order format details refer to the left hand unit, when looking at the front of the assembly.
Call sales for terminal spacing details | (This has terminal numbers 1, 2 & 3)

## Splash Resistant

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

Finish
Matt is standard.
Colour
Call factory for custom colours. A full range is available for large orders.
Legend printing
Select from the examples or call factory for custom legends. Lamp voltage
Call factory for details.
Insert Colour Lamp Voltage | Legend | Legend Colour | Options

Red

R

White

W

Blank

_ | Blank

_

12Vdc LED (P Rocker)

5

24Vdc LED (P Rocker)

6

12V Filament

7

24Vdc Filament

8

250V Neon

3

125V Neon

2

Blank

_

602A

Blank

_

White

W

Black

B
