MajorLee95/tinyelab/_01-docs/source/fichiersJoints/dtsFichesBananes_A700000006792413.pdf

# Datasheet Stock No. 191-7883 191-7884 191-7885 191-7887

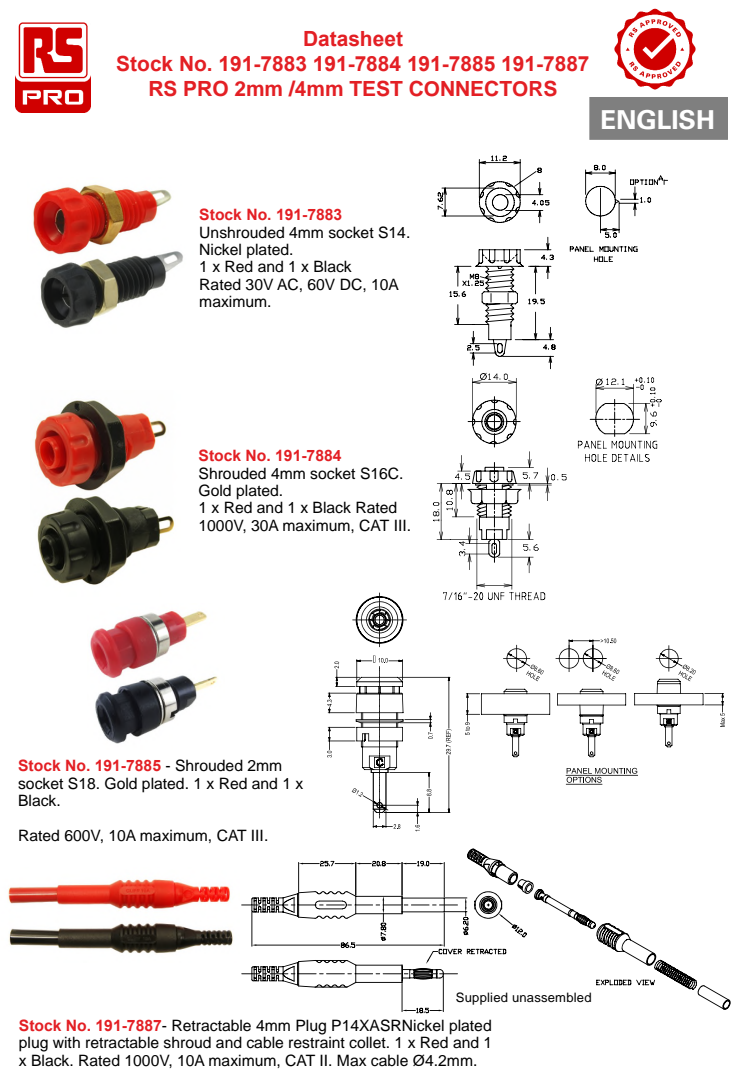
[picture p323: page 1]
Supplied unassembled; ENGLISH

RS PRO 2mm /4mm TEST CONNECTORS

Stock No. 191-7883
Unshrouded 4mm socket S14.
Nickel plated.
1 x Red and 1 x Black
Rated 30V AC, 60V DC, 10A
maximum.

Stock No. 191-7884
Shrouded 4mm socket S16C.
Gold plated.
1 x Red and 1 x Black Rated
1000V, 30A maximum, CAT III.

Stock No. 191-7885 - Shrouded 2mm
socket S18. Gold plated. 1 x Red and 1 x
Black.

Rated 600V, 10A maximum, CAT III.

Stock No. 191-7887- Retractable 4mm Plug P14XASRNickel plated
plug with retractable shroud and cable restraint collet. 1 x Red and 1
x Black. Rated 1000V, 10A maximum, CAT II. Max cable Ø4.2mm.
