MajorLee95/tinyelab/_02-realisation/_02-hardware/usb5v3a_v2_pcb/schematic220910_1340.pdf

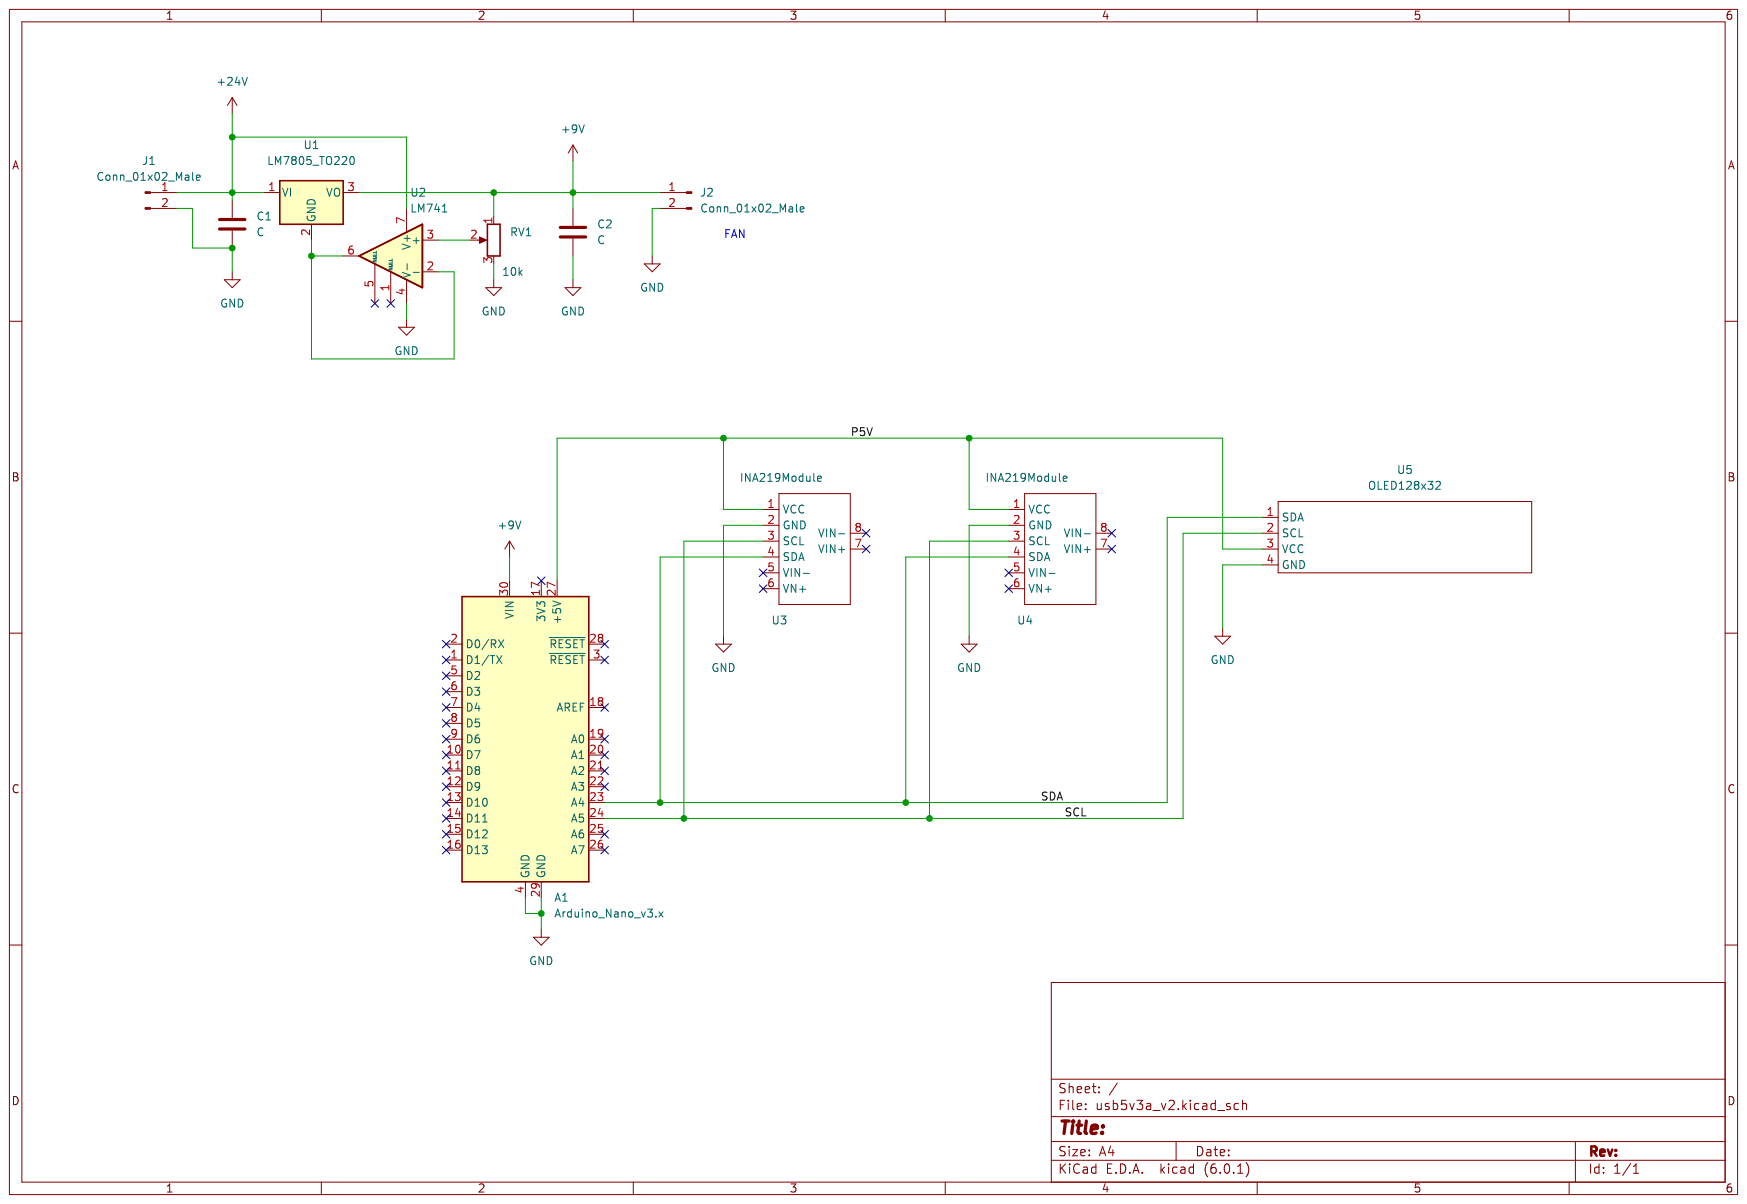
[picture p324: page 1]
