MajorLee95/tinyelab/_02-realisation/_02-hardware/oscillo/Schematic_138mini_analog_H.pdf

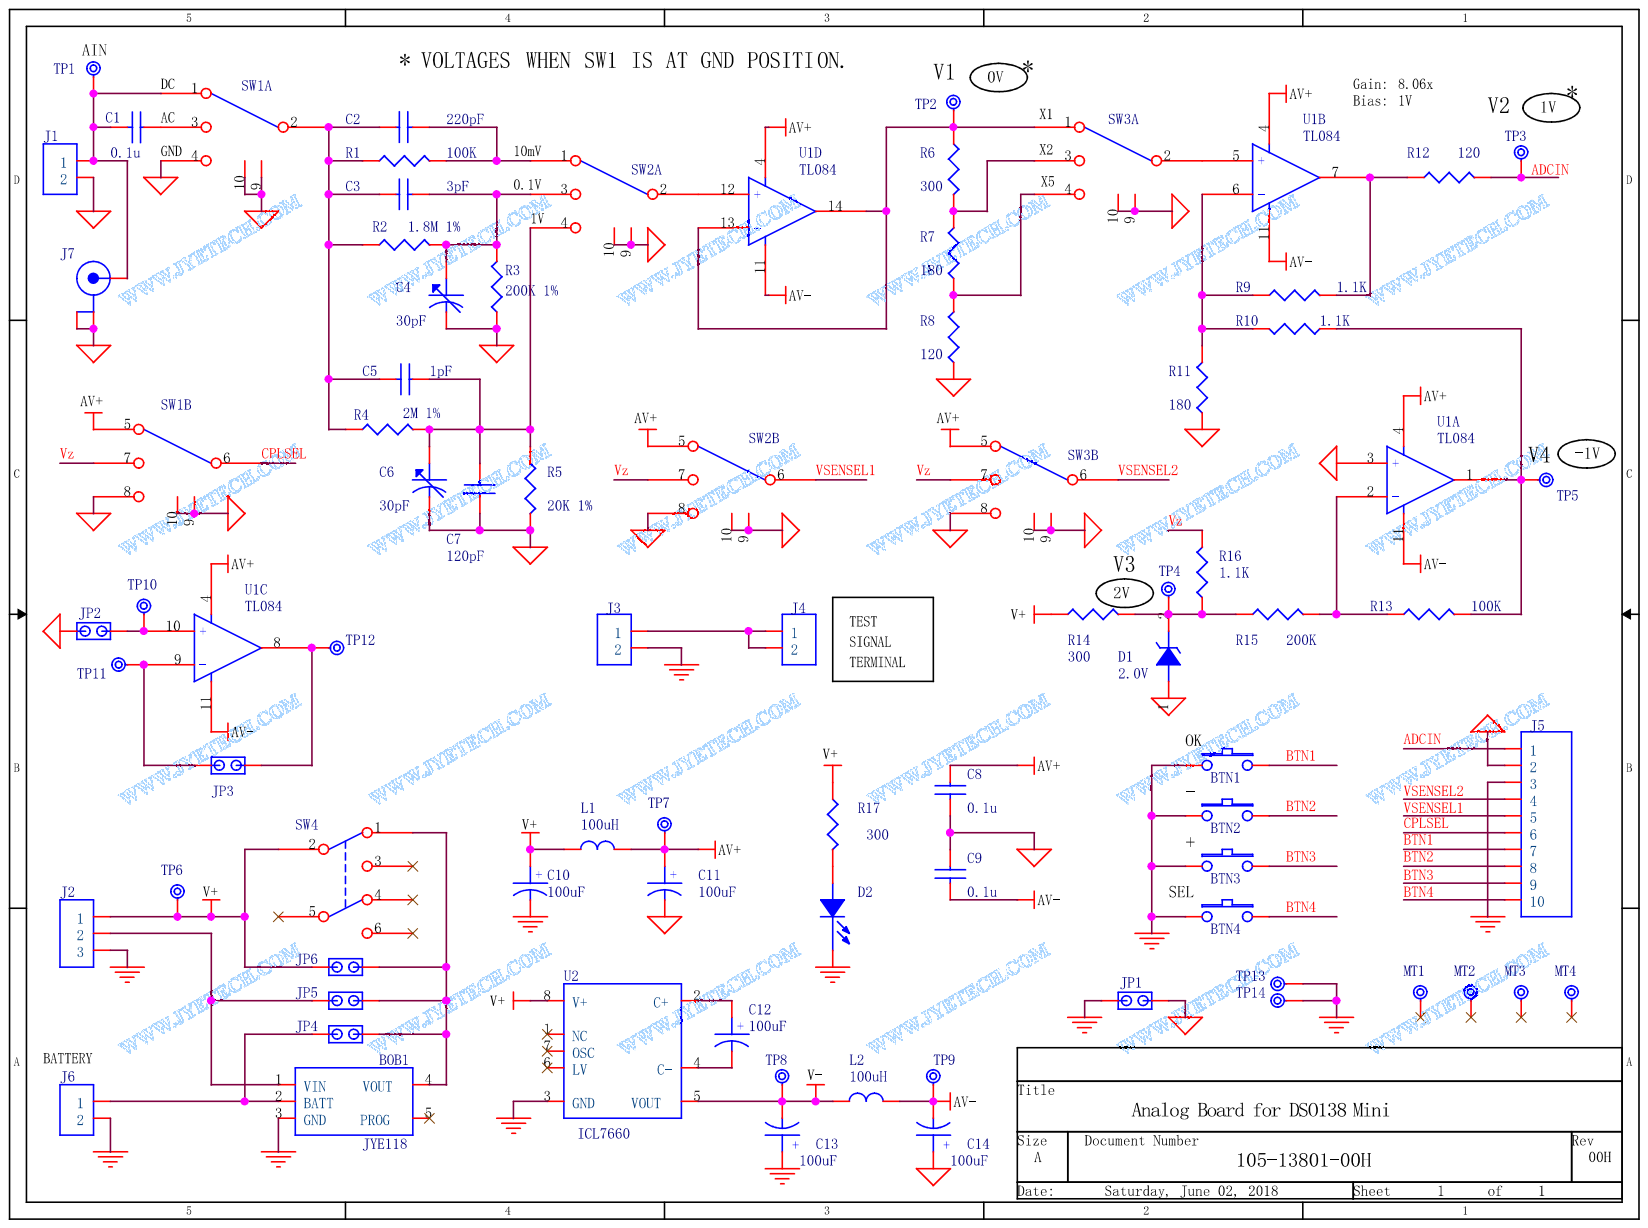
[picture p325: page 1]
