MajorLee95/tinyelab/_02-realisation/_02-hardware/oscillo/Schematic_138mini_main.pdf

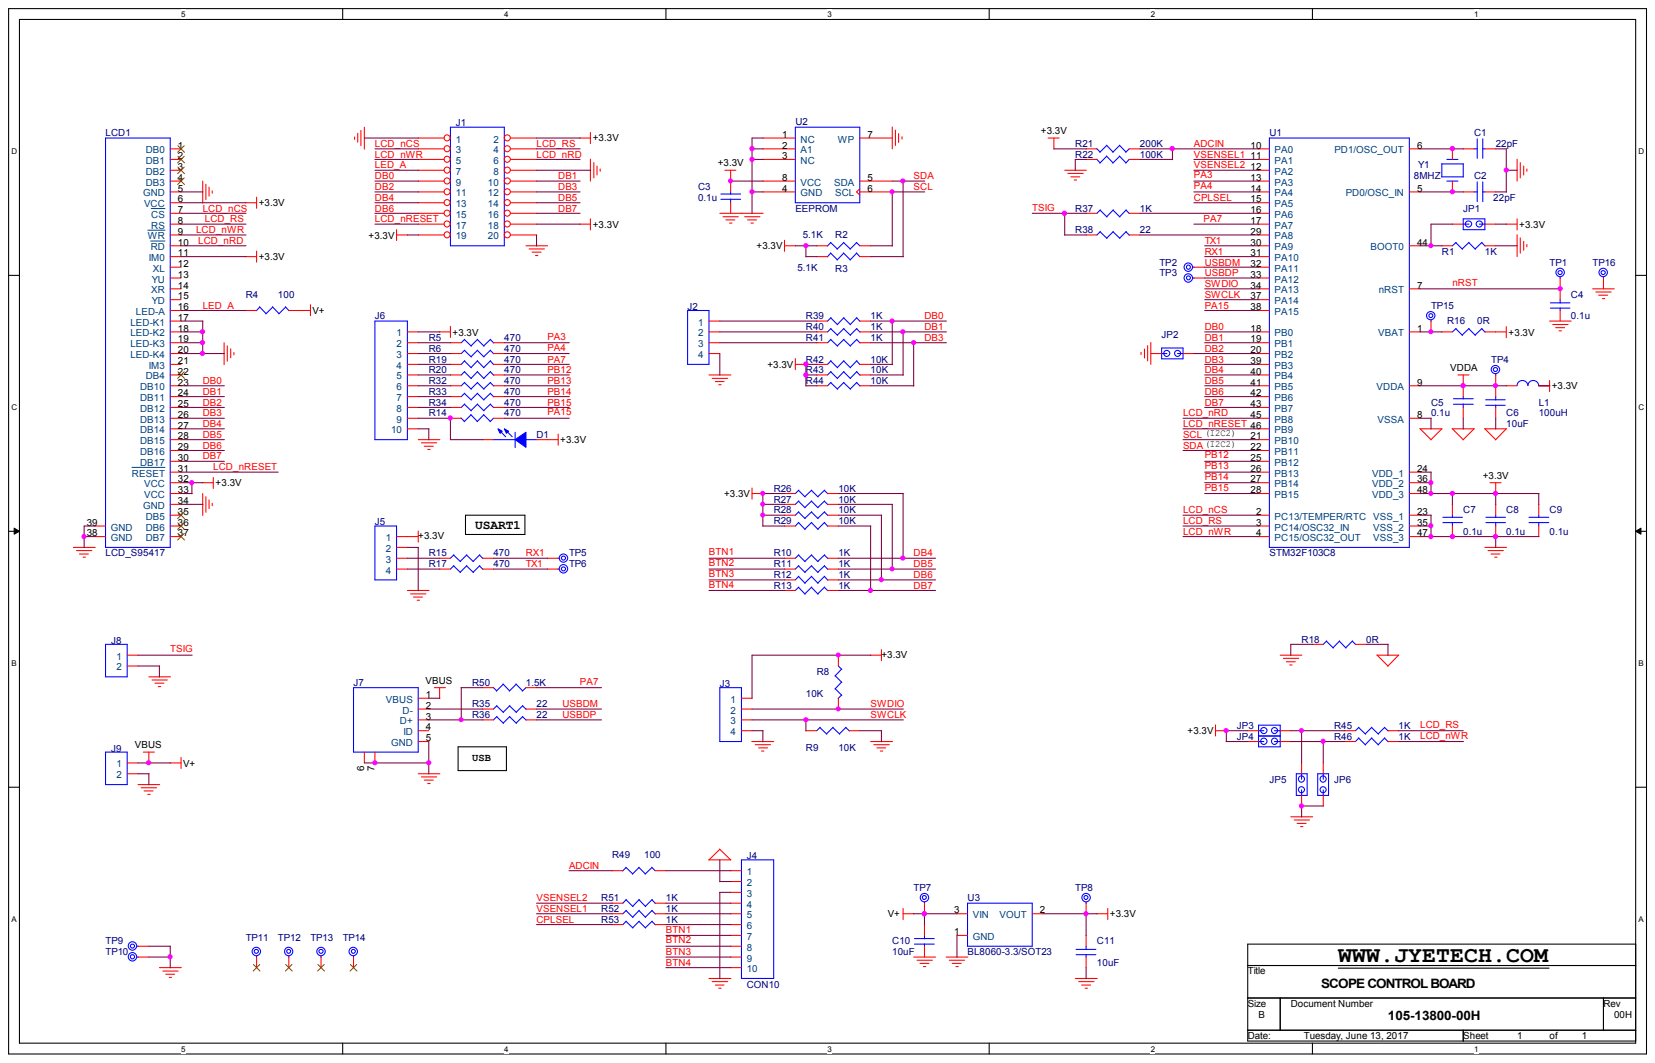
[picture p326: page 1]

Size B | Document Number 105-13800-00H | Rev 00H

Date: Tuesday, June 13, 2017 | Sheet 1 of 1
