MajorLee95/tinyelab/_02-realisation/_02-hardware/oscillo/Schematic_138mini_main_I.pdf

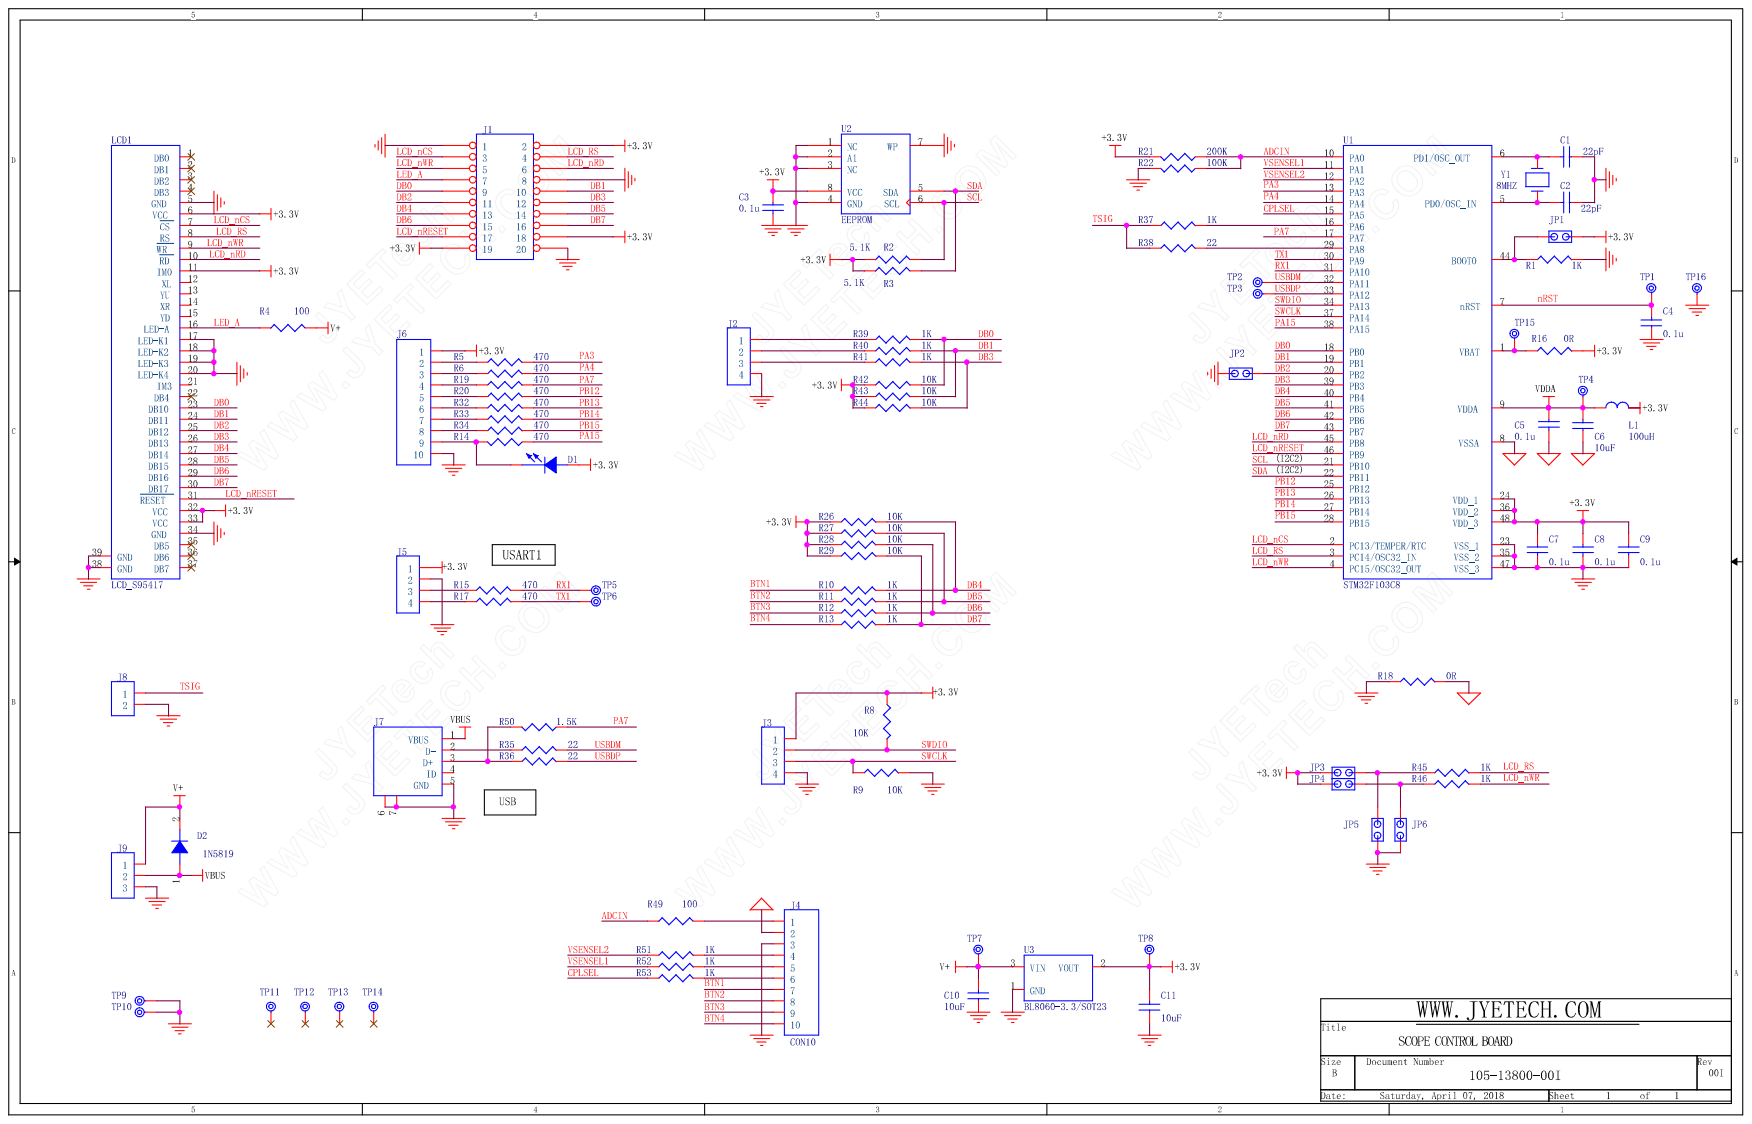
[picture p327: page 1]
