MajorLee95/tinyelab/_02-realisation/_02-hardware/oscillo/UserManual_138mini_H.pdf

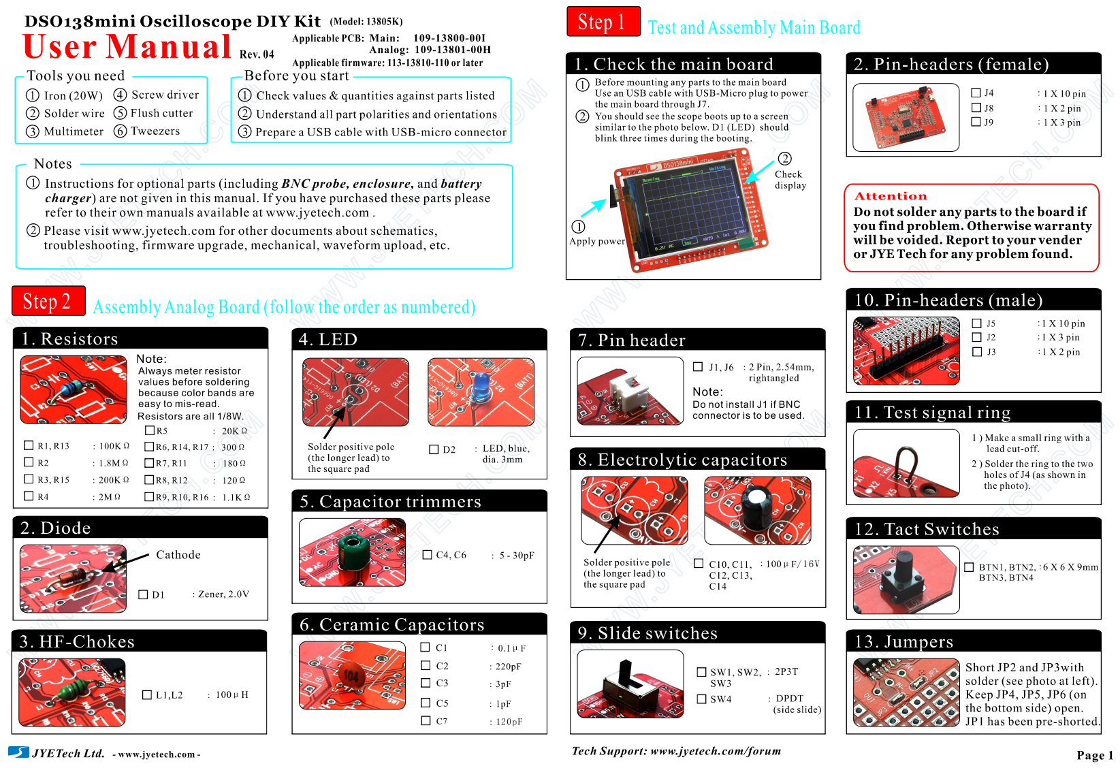
[picture p328: page 1]

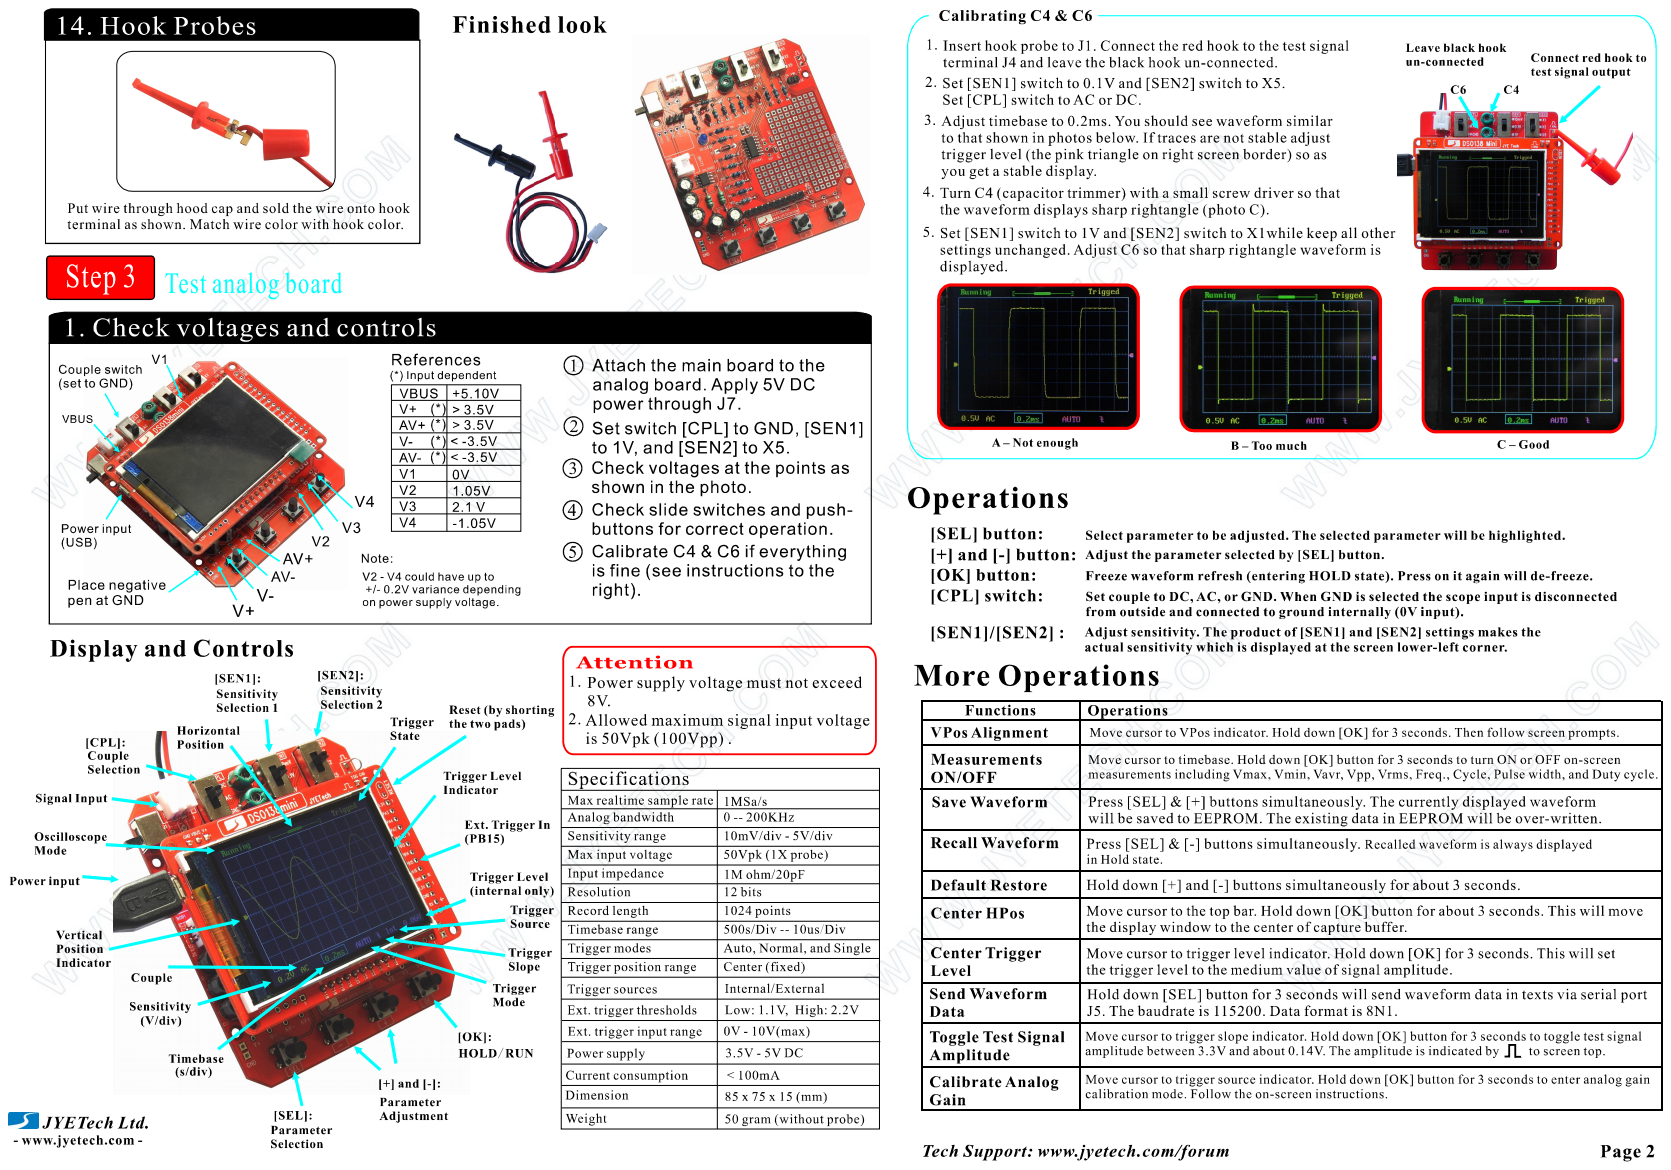
[picture p329: page 2]
