MajorLee95/tinyelab/_01-docs/source/fichiersJoints/bnc_drawing_0900766b80d9b202.pdf

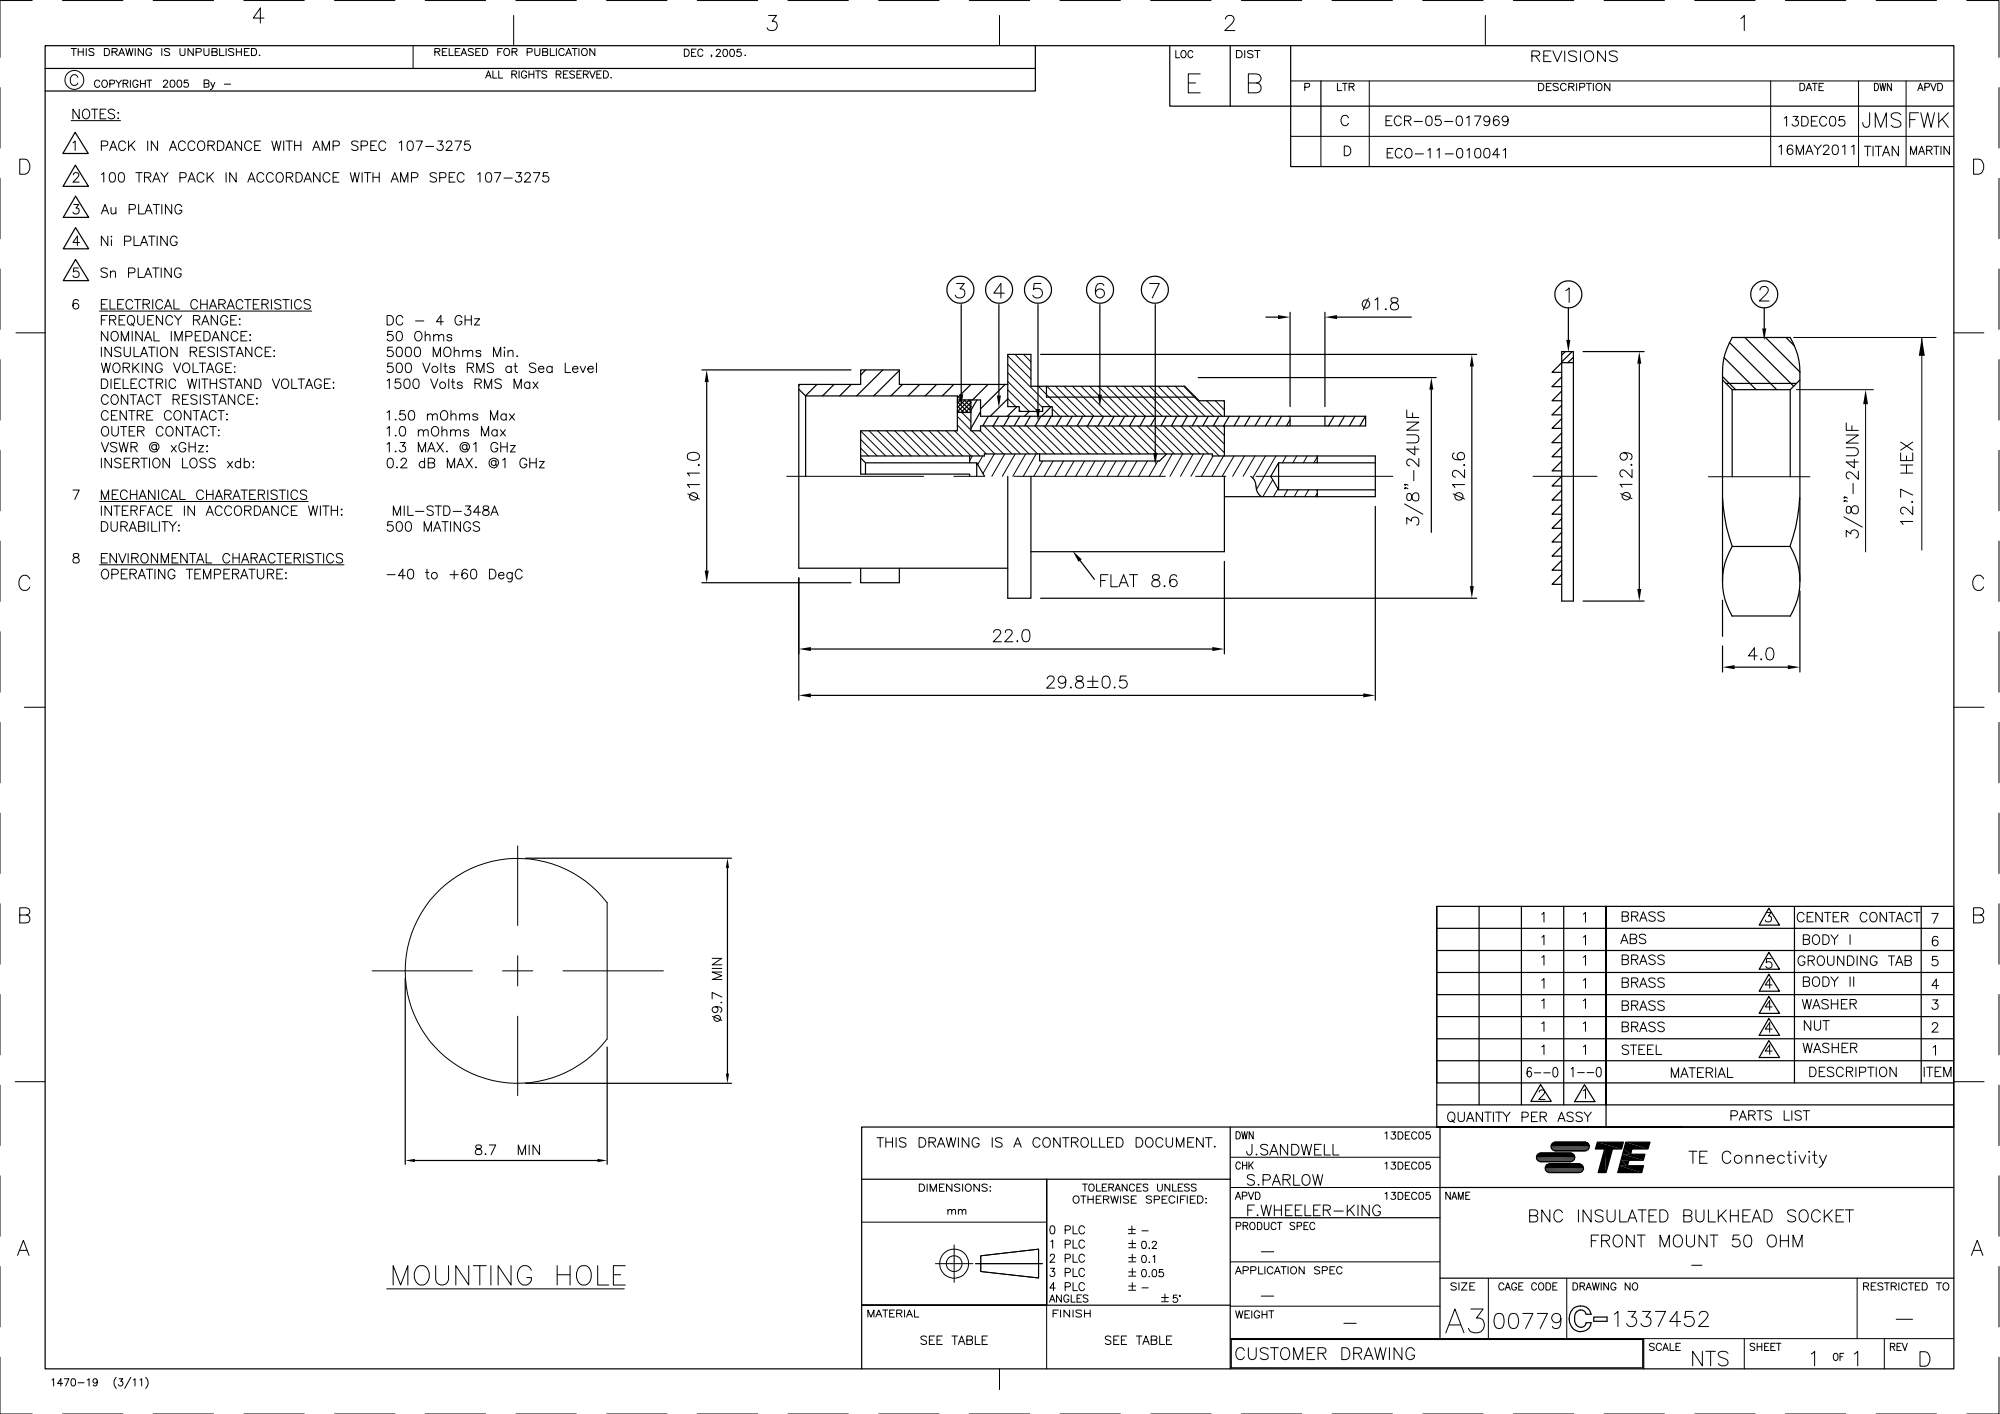
[picture p330: page 1]
