MajorLee95/tinyelab/_02-realisation/_02-hardware/usb5v3a_v2_pcb/usb5v3a_v2.kicad_pcb

## KiCad design _02-realisation/_02-hardware/usb5v3a_v2_pcb/usb5v3a_v2.kicad_pcb (2022-09-17)

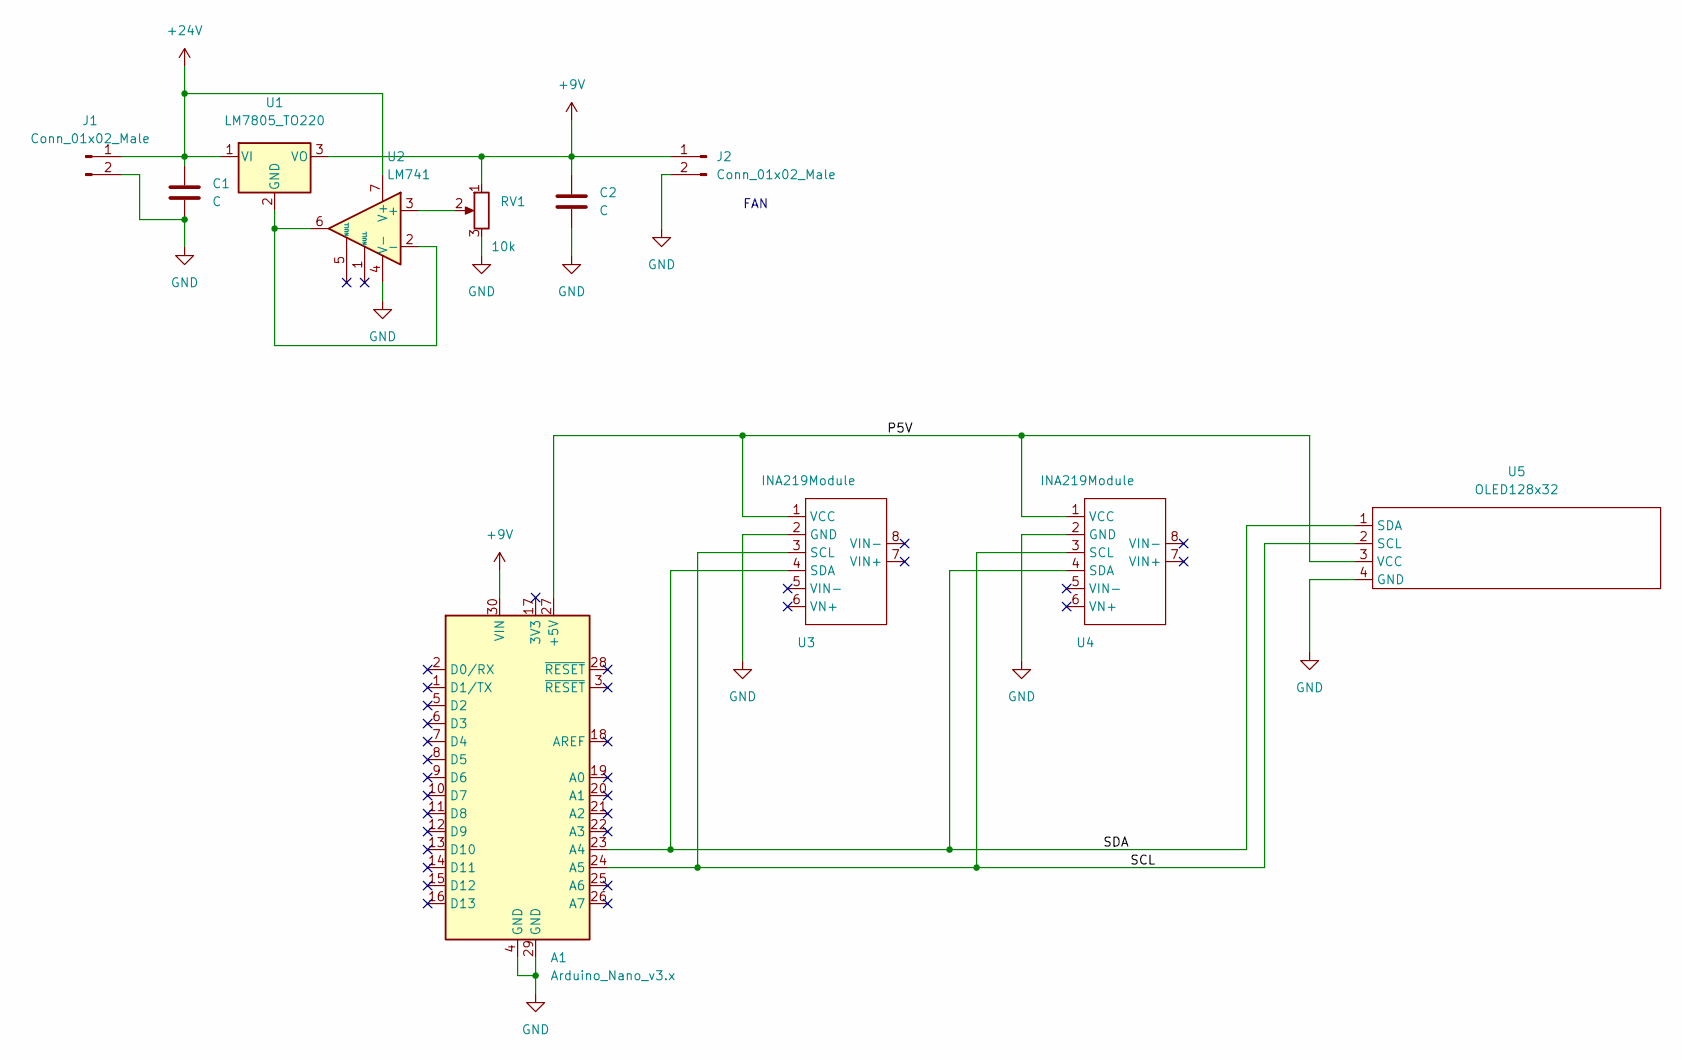
[picture p331: schematic usb5v3a_v2.kicad_sch, USB5V 3A 2 voies avec affichage du courant]

Parts:
A1: Arduino_Nano_v3.x; Arduino_Nano
C1, C2: C; C_Disc_D3.0mm_W1.6mm_P2.50mm
J1, J2: Conn_01x02_Male; PinHeader_1x02_P2.54mm_Vertical
RV1: 10k; Potentiometer_Piher_PT-10-V10_Vertical
U1: LM7805_TO220; TO-220-3_Vertical
U2: LM741; DIP-8_W7.62mm
U3, U4: INA219Module; INA219
U5: OLED128x32

Connections:
+9V: A1.30 (VIN), C2.1, J2.1, RV1.1, U1.3 (VO)
+24V: C1.1, J1.1, U1.1 (VI), U2.7 (V+)
/P5V: A1.27 (+5V), U3.1 (VCC), U4.1 (VCC), U5.3 (VCC)
/SCL: A1.24 (A5), U3.3 (SCL), U4.3 (SCL), U5.2 (SCL)
/SDA: A1.23 (A4), U3.4 (SDA), U4.4 (SDA), U5.1 (SDA)
GND: A1.4 (GND), A1.29 (GND), C1.2, C2.2, J1.2, J2.2, RV1.3, U2.4 (V-), U3.2 (GND), U4.2 (GND), U5.4 (GND)
unnamed: RV1.2, U2.3 (+)
unnamed: U1.2 (GND), U2.2 (-), U2.6

Notes on the sheet:
FAN

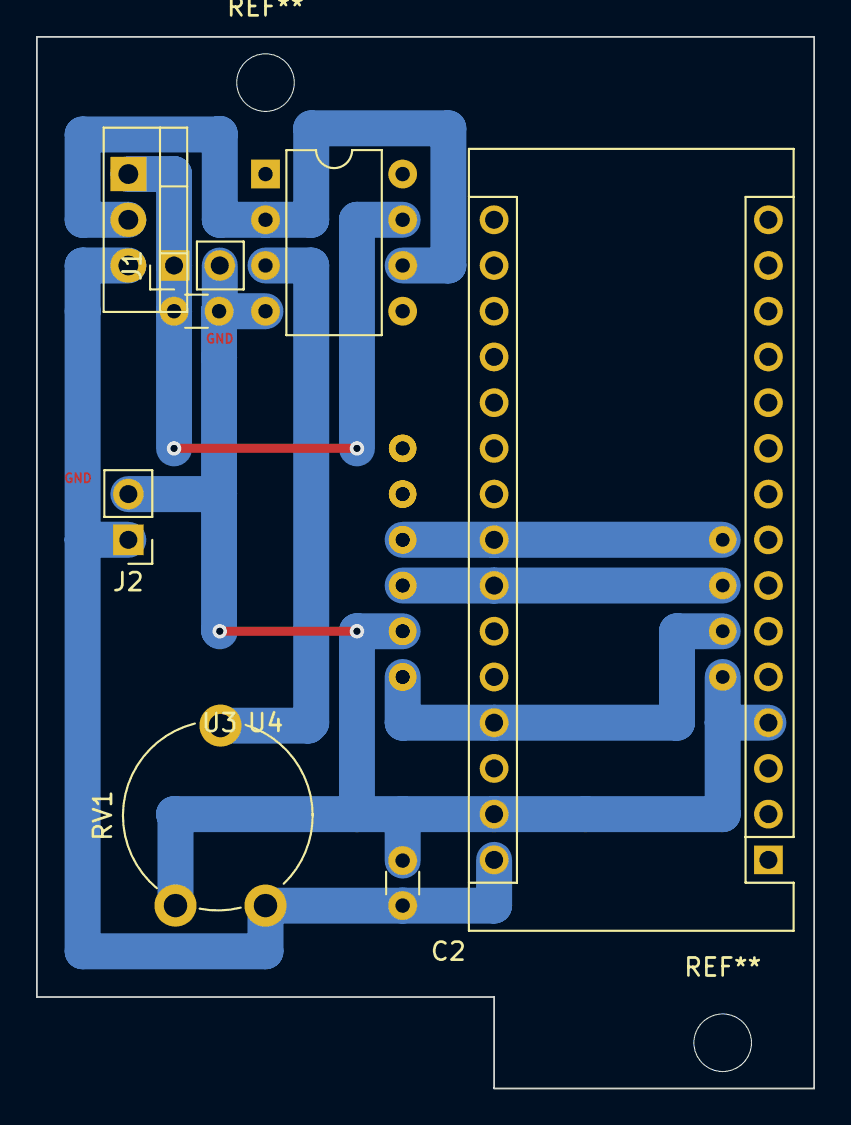
[picture p332: board usb5v3a_v2.kicad_pcb from above]

Board: 2 copper layers, 43.2 x 58.4 mm, 11 parts (1 on the bottom side), 8 nets.
