MajorLee95/tinyelab/_02-realisation/_02-hardware/ventilo/ventilo/ventilo.kicad_pcb

## KiCad design _02-realisation/_02-hardware/ventilo/ventilo/ventilo.kicad_pcb (2022-06-22)

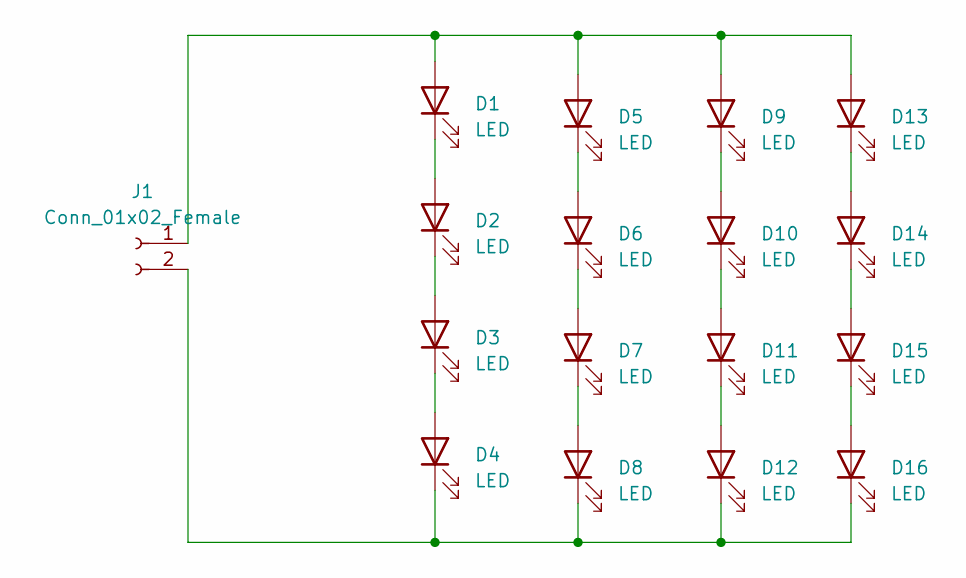
[picture p333: schematic ventilo.kicad_sch]

Parts:
D1, D2, D3, D4, D5, D6, D7, D8, D9, D10, D11, D12, D13, D14, D15, D16: LED; LED_D5.0mm
J1: Conn_01x02_Female; PinHeader_1x02_P2.54mm_Horizontal

Connections:
unnamed: D1.1 (K), D2.2 (A)
unnamed: D1.2 (A), D5.2 (A), D9.2 (A), D13.2 (A), J1.1
unnamed: D2.1 (K), D3.2 (A)
unnamed: D3.1 (K), D4.2 (A)
unnamed: D5.1 (K), D6.2 (A)
unnamed: D6.1 (K), D7.2 (A)
unnamed: D7.1 (K), D8.2 (A)
unnamed: D10.1 (K), D11.2 (A)
unnamed: D9.1 (K), D10.2 (A)
unnamed: D11.1 (K), D12.2 (A)
unnamed: D4.1 (K), D8.1 (K), D12.1 (K), D16.1 (K), J1.2
unnamed: D13.1 (K), D14.2 (A)
unnamed: D14.1 (K), D15.2 (A)
unnamed: D15.1 (K), D16.2 (A)

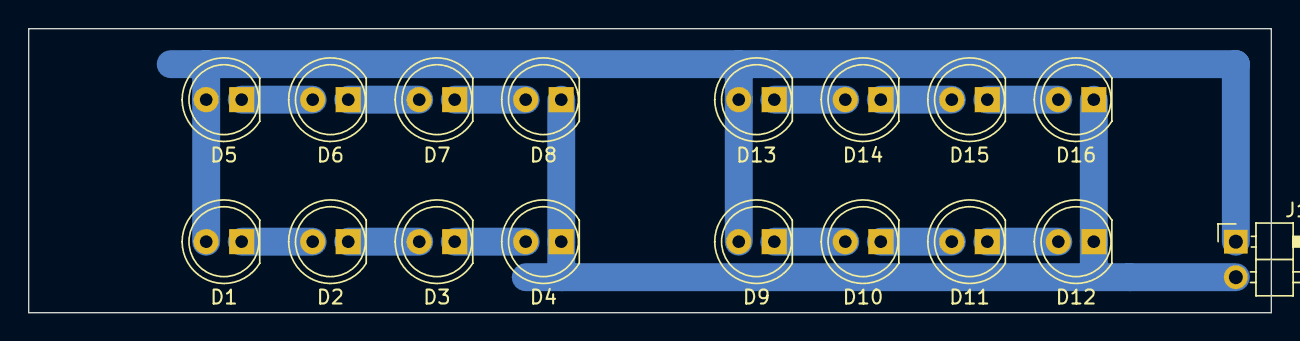
[picture p334: board ventilo.kicad_pcb from above]

Board: 2 copper layers, 88.9 x 20.3 mm, 17 parts (0 on the bottom side), 14 nets.
