MajorLee95/tinyelab/(commit log)

2022-04-17 premier commit, il était temps!
    [02_DPS3005_v4.stl, 03_LCR_v2.stl, 03_lcr-t4.skp, 03_lcr-t4_v04.stl, 04_TS100-holder_v2.stl, 04_TS100-station_v3_wLED.stl, 05_Fume_Extractor_90mm_fan_cover_v1.stl, 05_Fume_Extractor_90mm_v2.stl]
2022-04-17 doc module oscillo 9V
2022-04-20 ajout voltAmperemetre
    [0805 Chip SMD LED (2x1.2mm).step.SLDPRT, 102 RESISTOR PACK.SLDPRT, 16 pin header.SLDPRT, 189 RESISTOR PACK.SLDPRT, 1x15 Male Pin Header.SLDPRT, ASX1_voltAmperemetre_006_surBase35mm_008.1-base.3mf, ASX1_voltAmperemetre_006_surBase35mm_008.1-fav.3mf, Arduino nano.SLDASM]
2022-04-23 add gene function + retouche outillageXT + code opoulet pour exemple scoop
    [028voltm_001.FCStd, 028voltm_002.FCStd, DC 0-30V Voltmeter Panel Mount.step, LED DC Digital Voltmeter 5V Display green.ipt, LED DC Digital Voltmeter 5V Display green.stp, nVoltm_001_surBase35mm_008.1.FCStd, outillageXT_v2_004.FCStd, outillageXT_v2_005.FCStd]
2022-04-24 Alim triple et amperemtre analogique début
    [028voltm_001.FCStd, ASX1_triplesVoltm_005_surBase35mm_008.1-base.3mf, ASX1_triplesVoltm_005_surBase35mm_008.1-fav.3mf, ampAnalog_001_surBase35mm_008.1.FCStd, ampAnalog_002_surBase35mm_008.1.FCStd, ampAnalog_003_surBase35mm_008.1.FCStd, nVoltm_001_surBase35mm_008.1.FCStd, porteFuse_007.FCStd]
2022-04-29 module ventilo en cours
    [028voltm_002.FCStd, 028voltm_003.FCStd, 4mm Banana Socket.STEP, 80mm brushless fan (SUNON KDE1208PTB2).step, ASX1_favOscillo_009.3mf, ASX1_triplesVoltm_005_surBase35mm_008.1-base.3mf, ASX1_triplesVoltm_005_surBase35mm_008.1-fav.3mf, DC 0-30V Voltmeter Panel Mount.step]
2022-04-29 ventilo en cours
    [fanSupport_002.FCStd, fanSupport_003.FCStd, fanSupport_004.FCStd, fanSupport_005.FCStd, fanSupport_006.FCStd, fanSupport_007.FCStd, ventilo_006surBase35mm_008.1.FCStd, ventilo_007surBase35mm_008.1.FCStd]
2022-05-02 fan support en cours
    [ASX1_fixBdy_014_tounk.3mf, ASX1_mob014_tounk.3mf, bille001.FCStd, fan80mm_002.FCStd, fanSupport_004.FCStd, fanSupport_005.FCStd, fanSupport_006.FCStd, fanSupport_007.FCStd]
2022-05-04 quelques retouches mineurs
    [ASX1_outillageXT_v2_009-outillageFemChamfer001.3mf, ASX1_outillageXT_v2_009-outillageMaleChamfer003.3mf, ASX1_outillageXT_v2_012-outillages.3mf, fanSupport_015.FCStd, favModulUI_009.stl, fav_moduleUI_012_Sur_base35mm_007.5.3mf, fav_moduleUI_012_Sur_base35mm_007.5.stl, outSW_v004.stl]
2022-05-23 fan system en cours version aimant prête pour une première impression
    [ASX1_fixBdy_014_tounk.3mf, ASX1_fixe027.3mf, ASX1_mob014_tounk.3mf, ASX1_mobile027.3mf, aimant10x5x3-001.FCStd, fanSupport_014.FCStd, fanSupport_015.FCStd, fanSupport_027.FCStd]
2022-05-25 design casquette fan support ok
    [fanSupport_027.FCStd]
2022-05-27 version aimant testée KO
    [028voltm_002.FCStd, 028voltm_003.FCStd, ASX1_mobile027.3mf, fanSupport_027.FCStd, ventilo_007surBase35mm_008.1.FCStd, voltm_003.FCStd]
2022-05-30 juste une maj avancement module 3.3v,5 +12-12
2022-06-22 fichier 028 créé rebase
    [fanSupport_028.FCStd]
2022-06-22 poignee et languette dessinnees, raf encoche et plots
    [fanSupport_028.FCStd]
2022-06-22 reprise poignee et languette module ventilo RAF encoche
    [ASX1_fanSupport_028-poigneeEtLang.3mf, fanSupport_028-languette.stl, fanSupport_028-poignee.stl, fanSupport_028.FCStd]
2022-06-22 languette version 2 en cours de test
    [ASX1_fixeTrunc.3mf, ASX1_languettePoignee.3mf, ASX1_mobileTrunc.3mf, fanSupport_028-languette.stl, fanSupport_028-poignee.stl, fanSupport_028.FCStd, fixe.step, fixe027.step]
2022-06-22 potar en cours d'ajout sur la partie mobile
    [ASX1_fixeTrunc.3mf, Potentiometer.step, RV24AF-22-15R.step, Turn knob.STEP, fanSupport_028.FCStd, potar.FCStd, potentiometerb10k.stp, switch15x10_003_0.FCStd]
2022-06-22 retour à un potar normal + un switch
    [028voltm_003.FCStd, fanSupport_028.FCStd, fanSupport_029.FCStd, potar.FCStd, potarAvecInter_001.FCStd, switch15x10_003_0.FCStd, ventilo.kicad_pcb, ventilo.kicad_sch]
2022-06-22 les finissions du modul ventilo
    [028voltm_003.FCStd, ASX1_casquette.3mf, ASX1_mobile.3mf, DigiSpark ATtiny85.STEP, aimant10x5x3-001.FCStd, bille001.FCStd, casquette.stl, cutFixe-Cut001.stl]
2022-06-22 retour sur main pour les finisiions
    [fanSupport034.FCStd, ventilo_013surBase35mm_008.1.FCStd]
2022-06-22 odul ventilo terminé hors test
    [base.step, baseCut.stl, cutFixe-Cut001.stl, cutFixe.FCStd, cutFixe.stl, cutInserEcrou-Cut001.stl, cutInserEcrou.FCStd, fanSupMobileBdy.step]
2022-06-22 impressions en cours
    [ASX1_casquette.3mf, ASX1_fixeTrunc.3mf, ASX1_languettePoignee.3mf, ASX1_mobile.3mf, ASX1_mobileTrunc.3mf, base.step, baseCut.stl, casquette.stl]
2022-06-22 remonté d'un fichier cura pour servir de ref
    [ASX1_mobile_refProjetCura.3mf]
2022-07-02 Module ventilo imprimé
    [ASX1_fanSupport_028-poigneeEtLang.3mf, ASX1_fixe027.3mf, ASX1_mobile027.3mf, ASX1_mobile_refProjetCura.3mf, fanSupport033.FCStd, fanSupport035.FCStd, test.FCStd, ventilo_011surBase35mm_008.1.FCStd]
2022-07-06 xt60 cover + correction Muthex to Ruthex
    [nomBASE.csv, nomBASE.ods, nomDPS3005.csv, nomDPS3005.ods, nomModulVA.ods, nomOscillo.csv, nomOscillo.ods, nomUSB3A.csv]
2022-07-13 XT60 cover OK + ventilo update
    [Connector_5,5-2,5_DC00990-B.stp, DC5525.FCStd, base35mm_009.1.FCStd, fanSupport035.FCStd, moduleUSBCharge.FCStd, nomVentilo.ods, ventilo_014surBase35mm_008.1.FCStd, xt60Fem.FCStd]
2022-07-16 principalement nome ventilo en cours
    [nomVentilo.ods, xt60Fem.FCStd, xt60covert008.FCStd]
2022-08-03 module lidl e cours
    [DC5525.FCStd, DC5525_01.FCStd, DC5525_02.FCStd, LIDLBatPlug.FCStd, LIDLBatPlug_002.FCStd, LIDLBatPlug_006.FCStd, LIDL_Parkside_20v_Battery_Adapter_Front_85mm.skp, LIDL_Parkside_20v_Battery_Adapter_Front_85mm.stl]
2022-08-10 Nomenclature module VA
    [alimMultiple_001_SurBase35mm_009.1.FCStd, bornier001.FCStd, moduleLidl_001_surBase35mm_009.1.FCStd, nomModulVA.csv, nomModulVA.ods, potar.FCStd]
2022-08-14 module pakside ok
    [nomParkside.csv, nomParkside.ods]
2022-08-15 modi=ole de base en v12
    [DCDCLM2596_avecVisInsert_001.FCStd, base35mm_008.1.FCStd, base35mm_009.1.FCStd, base35mm_012.FCStd, bnc_001.FCStd, moduleLidl_002_surBase35mm_009.1.FCStd, porteFuse_008.1.FCStd, porteFuse_008.FCStd]
2022-09-10 module USB3A new
    [009_base.step, 009_base.stl, 128x32-OLED.STEP, 40mm_Fan.step, ASX1_009_base.3mf, ASX1_cale001.3mf, ASX1_epreuveUSB017-Cut003.3mf, ASX1_epreuveUSB020-Cut003.3mf]
2022-09-17 USB 2x 3A v2 en cours (encoche PCB)
    [dissip001.FCStd, moduleUSB3A_022_SurBase35mm_012.FCStd, moduleUSB3A_023_SurBase35mm_012.FCStd, theBoard001.FCStd, usb5v3a_v2.kicad_pcb]
2022-10-08 USB 2x 3A v2 presque fini
    [BOU_2301_RC.step, SOIC08 narrow.igs, SOIC08 narrow.stp, SOIC10 narrow.stp, SOIC14 narrow.stp, SOIC16 narrow.stp, base35mm_009.1.FCStd, moduleUSBCharge.FCStd]
2022-10-12 usb 2x 3A en doc en cours
    [128x32-OLED.STEP, CJMCU-219 INA219.step, PT-10.stp, Trimmer_Piher_PT-15.step, arduino nano.STEP, usb5v3a_v2.kicad_pcb, usb5v3a_v2.kicad_sch]
2022-10-22 Mise à jour documentaire usb2x3a
    [fav221015_1206.dxf, fav221015_1206_decoupe.dxf, moduleUSB3A_020_SurBase35mm_012.FCStd, moduleUSB3A_021_SurBase35mm_012.FCStd, moduleUSB3A_022_SurBase35mm_012.FCStd, nomUSB3A.csv, nomUSB3A.ods]
2022-10-22 nettoyage dossier + usb2x3a maj modèle freecad
    [KTD132.FCStd, KTD132_002.FCStd, XL4015DCDC_002.FCStd, base35mm_005.4_moduleUI_01.FCStd, base35mm_005.4_moduleUI_02.FCStd, base35mm_005.4_moduleUI_03.FCStd, base35mm_005.4_moduleUI_04.FCStd, baseUI.amf]
2022-10-29 Doc module ventilo nomenclature
    [fanSupport034.FCStd, nomVentilo.csv, nomVentilo.ods]
2022-10-29 ventilo ajout photo
    [nomVentilo.csv, nomVentilo.ods]
2022-11-09 Documentation ventilo terminée
    [nomVentilo.csv, nomVentilo.ods]
2022-11-09 Triple tiny voltmètre complément de doc
    [nomTripleTinyVoltmetre.csv, nomTripleTinyVoltmetre.ods]
2022-11-12 update doc, introduction du volabid.rst
    [nomModulVA.ods]
2022-11-23 module Oscillo introduction des entretoises + elements commun visTHCMixj full parametrique
    [capotDSO138.FCStd, ecrouM.FCStd, ecrouM3.FCStd, entretoiseM3x8.FCStd, nomOscillo.ods, oscillo_006_surBase35mm_007.5.FCStd, oscillo_007_surBase35mm_007.5.FCStd, oscillo_008_surBase35mm_007.5.FCStd]
2022-11-23 CPAOToSCILLO en cours de design
    [capotDSO138.FCStd, oscillo_010_surBase35mm_007.5.FCStd]
2024-03-09 ajout support TS-100 alternatif...
    [ts100_holder_v14_arm-old-noinsert.stl, ts100_holder_v20.f3z, ts100_holder_v21.stl, ts100_holder_v22_arm_for_insert.stl]
2024-03-12 moduleUSB2 voies simple en cours
    [ASX1_base35mm_012.3mf, IP6505_QC2.FCStd, base35mm_012-base.stl, importDansFreeCad.FCStd, moduleUSB_IP6505_QC2Sur_base35mm_012.FCStd, moduleUSB_IP6505_QC3.FCStd, switch15x10_003_0.FCStd, ts100holder_v1_exportJSO_Fusion.step]
2024-03-21 Module USB 2x3A ok
    [009_base.step, 009_base.stl, ASX1_009_base.3mf, ASX1_epreuveUSB017-Cut003.3mf, ASX1_epreuveUSB020-Cut003.3mf, ASX1_epreuvedcdc_009.3mf, ASX1_moduleUSB_IP6505_QC2Sur_base35mm_012-faceAvant.3mf, IP6505_QC2.FCStd]
